ai2cm/ace/scripts/data_process/README.md

# Data processing for full model emulation training

This directory contains scripts for generating various datasets needed for FME training, including the FV3GFS primary, baseline, and stats datasets.

It also contains scripts for generating E3SM training data.

The first step in the process to create intermediate datasets (e.g. `make fv3gfs_AMIP_dataset`) uses argo, and can be run on your Google VM.
See the vcm-workflow-control repo for instructions on how to install and run argo.

The second step, which produces monthly netCDF files locally (e.g. `make fv3gfs_AMIP_monthly_netcdfs`), can be run on cirrascale in an interactive session.
To create an interactive session, run the following command from the `scripts/data_process` directory:

```
beaker session create --budget ai2/atec-climate --image beaker://jeremym/fme-2bc0033e --gpus 0 --mount hostPath:///net/nfs/climate=/net/nfs/climate --mount hostpath://$(pwd)=/full-model --workdir /full-model/scripts/data_process --shared-memory 120GiB
```

Doing so will require that your current working directory is a mountable path (e.g. something in /data).
If you'd like to write to a different directory than /net/nfs/climate, you can mount that path instead.

Once inside the image, you will need to authorize access to GCS by running `gcloud auth application-default login` and following the instructions, including to run `gcloud config set project vcm-ml` afterwards.

You can then produce the monthly netCDFs in a target directory by modifying the `OUTPUT_DIR` or `OUTPUT_DIR_AMIP` variable in the make command below.

```
make fv3gfs_AMIP_monthly_netcdfs RESOLUTION=4deg OUTPUT_DIR_AMIP=/data/shared/2023-12-20-vertically-resolved-4deg-fme-amip-ensemble-dataset
```

The stats dataset creation step (e.g. `make fv3gfs_AMIP_stats_beaker_dataset`) must be run in the fme conda environment (created by `make create_environment` at the top level of this repo), and additionally requires the beaker client is installed ([install instructions](https://beaker-docs.apps.allenai.org/start/install.html)).

For healpix data (both `healpix_ace` and `healpix_dlwp`), you will need to use the annad/dlwp-datapipe image.

You can either run the target with gantry or use the --bare flag, passing your own beaker secrets to the usual session command.

Update `configs/healpix-1deg-8layer-1940-2022.yaml` to point at the latest era5 data on gcs and the current date, i.e., variable_sources `2024-06-20-era5-1deg-8layer-1940-2022.zarr`; data_output_directory: `/climate-default/[DATE]-healpix-era5-dataset`.

If using gantry, be sure to run `make healpix_ace_dataset_gantry` before running `make healpix_dlwp_dataset_gantry`, or update the config to point at an existing hpx-ace dataset.

The output will be written to the `/climate-default` file directory on weka.

Example bare usage: `cd full-model/scripts/data_process && make healpix_ace_dataset`. You may also want to run in the background using nohup: `nohup make healpix_ace_dataset > compute_hpx.log 2>&1 &`.

Example bare session creation (use your own ssh secrets): `beaker session create --name annad/dlwp-ace-datapipe --image beaker://annad/dlwp-datapipe --remote --cluster ai2/phobos-cirrascale --bare --mount src=weka,ref=climate-default,dst=/climate-default  --mount src=weka,ref=climate-default,subpath=annad,dst=/root --workdir=/root --mount src=secret,ref=ssh-key,dst=/secret-files/.ssh/id_ed25519     --mount src=secret,ref=git-config,dst=/secret-files/.gitconfig --budget ai2/atec-climate --shared-memory 120GiB`

## Coupled datasets

The coupled targets (e.g. `make cm4_piControl_coupled_1daily`) run
`create_coupled_datasets.py` locally in the `create_coupled_datasets` conda
environment, created by `make create_coupled_datasets_env`.

The CM4 and CM4-like-AM4 random-CO2 configs also have an `_argo` sibling (e.g.
`make cm4_piControl_coupled_1daily_argo`) that submits the same config to argo
through `create_coupled_datasets.sh`, and can be run on your Google VM. Push the
image first with `make build_coupled_processing_image push_coupled_processing_image`.
The argo flavour is offered only where the config's input and output stores are
on GCS: `E3SMv3-piControl-100yr-coupled.yaml` writes to NERSC scratch, which the
workflow does not mount, so it is local-only.

The CM4 1pctCO2 coupled configs read their sea ice mask
(`precomputed_sea_ice_mask`) from the piControl coupled ocean store, so submit
each pair as one workflow: `make cm4_coupled_1daily_argo` (or `make
cm4_coupled_argo`) runs `create_coupled_datasets.sh --config <piControl>
--dependent-config <1pctCO2>`, and the workflow starts the 1pctCO2 run once the
piControl run has written its datasets. `--dependent-config` cannot be combined
with `--debug` or `--subsample`, which leave no piControl store for 1pctCO2 to
read. A mask read from a store that is not fully written fails the run.

When the config sets `stats.beaker_dataset`, the argo workflow's upload step,
`upload_coupled_stats.py`, uploads the merged stats to that Beaker dataset in
the `ai2/ace` workspace, one subdirectory per category
(`uncoupled_atmosphere`, `coupled_atmosphere`, `ocean`); an ensemble config
uploads its `combined` stats. The step is skipped for `--debug` and
`--subsample` runs, and when the dataset already exists under the account of
the workflow's Beaker token (the `beaker-key-andrep` secret). It runs on the
atmosphere processing image, which has `beaker-py`; override with
`-p upload_image=...`.
