ai2cm/ace/docs/api.rst

.. _API Reference:

=============
API Reference
=============

fme
===

.. automodule:: fme
   :members:

fme.ace
=======

.. automodule:: fme.ace
   :members:

fme.coupled
===========

.. automodule:: fme.coupled
   :members:
