ai2cm/ace/fme/core/distributed/parallel_tests/README.md

This directory contains tests which can be run in parallel, for example with torchrun.

They should also run in serial.
