ai2cm/ace/docs/evaluator_config.rst

.. _evaluator-config:

================
Evaluator Config
================

The following is an example configuration for running inference while evaluating against target data.
While you can use absolute paths in the config yamls (we encourage it!), the example uses paths relative to the directory you run the command.
The example assumes you are running in a directory structure like:

::

   .
   ├── ckpt.tar
   └── validation
       ├── data1.nc  # files can have any name, but must sort into time-sequential order
       ├── data2.nc  # can have any number of netCDF files
       └── ...

The ``.nc`` files correspond to data files like ``training_validation_data/training_validation/1940010100.nc`` in the `ACE2-ERA5 Hugging Face page`_, while ``ckpt.tar`` corresponds to a file like ``ace2_era5_ckpt.tar`` in that repository.

.. _ACE2-ERA5 Hugging Face page: https://huggingface.co/allenai/ACE2-ERA5

.. literalinclude:: evaluator-config.yaml
   :language: yaml
   :caption: Example YAML Configuration

.. testcode::
   :hide:

   from fme.ace import InferenceEvaluatorConfig
   import yaml
   import dacite

   with open('evaluator-config.yaml', 'r') as f:
      config_dict = yaml.safe_load(f)

   config = dacite.from_dict(
      InferenceEvaluatorConfig,
      data=config_dict,
      config=dacite.Config(strict=True)
   )
   # these paths are used in the documentation on this page
   # if they change then update the docs!
   assert config.checkpoint_path == "ckpt.tar"
   assert config.loader.dataset.data_path == "validation"
   print("Loaded successfully")

.. testoutput::
   :hide:

   Loaded successfully

We use the :ref:`Builder pattern <Builder Pattern>` to load this configuration into a multi-level dataclass structure.
The configuration is divided into several sub-configurations, each with its own dataclass.
The top-level configuration is the :class:`fme.ace.InferenceEvaluatorConfig` class.

.. autoclass:: fme.ace.InferenceEvaluatorConfig
   :show-inheritance:
   :noindex:

The sub-configurations are:

.. autoclass:: fme.ace.LoggingConfig
   :show-inheritance:
   :noindex:

.. autoclass:: fme.ace.InferenceDataLoaderConfig
   :show-inheritance:
   :noindex:

.. autoclass:: fme.ace.InferenceInitialConditionIndices
   :show-inheritance:
   :noindex:

.. autoclass:: fme.ace.ExplicitIndices
   :show-inheritance:
   :noindex:

.. autoclass:: fme.ace.TimestampList
   :show-inheritance:
   :noindex:

.. autoclass:: fme.ace.XarrayDataConfig
   :show-inheritance:
   :noindex:

.. autoclass:: fme.ace.DataWriterConfig
   :show-inheritance:
   :noindex:

.. autoclass:: fme.ace.InferenceEvaluatorAggregatorConfig
   :show-inheritance:
   :noindex:

Default aggregator configuration
^^^^^^^^^^^^^^^^^^^^^^^^^^^^^^^^

The default aggregator configuration (``InferenceEvaluatorAggregatorConfig``
with no arguments) produces the following YAML. You only need to include fields
you want to override.

.. literalinclude:: default-aggregator-config.yaml
   :language: yaml
   :caption: Default Aggregator Configuration

Metric configurations
^^^^^^^^^^^^^^^^^^^^^

The named fields on
:class:`~fme.ace.InferenceEvaluatorAggregatorConfig`
accept the following typed entries.  Each entry has an ``enabled`` field
that can be set to ``true`` or ``false`` to enable or disable a metric.
Most metrics default to ``enabled: true``; however, ``video``,
``histogram``, and ``seasonal`` default to ``enabled: false`` as shown
in the default aggregator configuration above.

.. autoclass:: fme.ace.MeanMetricConfig
   :noindex:

.. autoclass:: fme.ace.StepMeanMetricConfig
   :noindex:

.. autoclass:: fme.ace.PowerSpectrumMetricConfig
   :noindex:

.. autoclass:: fme.ace.ZonalMeanMetricConfig
   :noindex:

.. autoclass:: fme.ace.TimeMeanMetricConfig
   :noindex:

.. autoclass:: fme.ace.HistogramMetricConfig
   :noindex:

.. autoclass:: fme.ace.VideoMetricConfig
   :noindex:

.. autoclass:: fme.ace.SeasonalMetricConfig
   :noindex:

.. autoclass:: fme.ace.AnnualMetricConfig
   :noindex:

.. autoclass:: fme.ace.EnsoIndexMetricConfig
   :noindex:

.. autoclass:: fme.ace.EnsoCoefficientMetricConfig
   :noindex:

.. autoclass:: fme.ace.IpoIndexMetricConfig
   :noindex:

.. autoclass:: fme.ace.TrendMetricConfig
   :noindex:

.. autoclass:: fme.ace.EnsembleMetricConfig
   :noindex:

.. autoclass:: fme.ace.NearZeroFractionMetricConfig
   :noindex:

.. autoclass:: fme.ace.StepperOverrideConfig
   :show-inheritance:
   :noindex:
