ai2cm/ace/fme/core/hpx/testdata/test_plot_isht_result_1_0.png

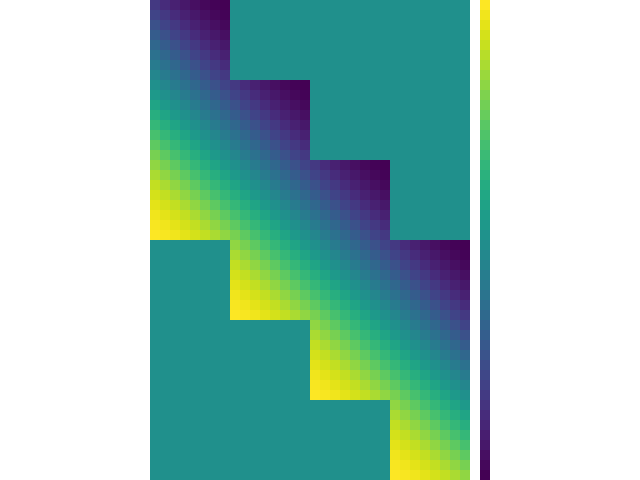
fme/core/hpx/testdata/test_plot_isht_result_1_0.png
