ai2cm/ace/(threads)

Thread 11 (2024-08-27):

Out of memory at inference time

Zappandy, 2024-08-27:
I've been trying to run ACE at inference time using a single NVIDIA Hopper H100 64GB HBM2 on an HPC, and we've even tried to run it on 4 H100s, but I keep getting PyTorch memory allocation errors. To further test this out, I dropped the number of forward steps to lower values (200, 100, 50, and even 2). Regardless of the amount, the code crashes before completing a single step. Note that we're using the initial condition from January 1st, 2021 (i.e. 2021010100.nc) and the model checkpoint provided on the Zenodo repository.

I double checked the computational complexity on the paper and saw you guys were running inference on a single A100, so I'm leaning on this being a data loading issue. We were able to isolate the problem to the ```SingleModuleStepperConfig``` class on the [stepper script](https://github.com/ai2cm/ace/blob/main/fme/fme/core/stepper.py) as the code seems to crash on line 378 (```self.module = dist.wrap_module(self.module)```).

This is the current output when we try to run inference
```
2024-08-27 10:24:46,356 - root - WARNING - Environmental variable BEAKER_EXPERIMENT_ID not found.
2024-08-27 10:24:46,358 - root - WARNING - Environmental variable SLURM_JOB_ID not found.
2024-08-27 10:24:46,358 - root - WARNING - Environmental variable SLURM_JOB_USER not found.
2024-08-27 10:24:46,358 - root - WARNING - Environmental variable FME_TRAIN_DIR not found.
2024-08-27 10:24:46,358 - root - WARNING - Environmental variable FME_VALID_DIR not found.
2024-08-27 10:24:46,358 - root - WARNING - Environmental variable FME_STATS_DIR not found.
2024-08-27 10:24:46,358 - root - WARNING - Environmental variable FME_CHECKPOINT_DIR not found.
2024-08-27 10:24:46,358 - root - WARNING - Environmental variable FME_OUTPUT_DIR not found.
2024-08-27 10:24:46,358 - root - WARNING - Environmental variable FME_IMAGE not found.
2024-08-27 10:24:46,358 - root - WARNING - Beaker Experiment ID not found.
2024-08-27 10:24:46,358 - root - INFO - --------------- Versions ---------------
2024-08-27 10:24:46,358 - root - INFO - Torch: 2.1.0a0+29c30b1
2024-08-27 10:24:46,358 - root - INFO - ----------------------------------------
2024-08-27 10:24:46,722 - root - INFO - Current device is cuda:0
2024-08-27 10:24:46,722 - root - INFO - Loading trained model checkpoint from /gpfs/projects/bsc32/bsc032010/ace-data/ace_ckpt.tar
2024-08-27 10:24:48,906 - root - INFO - Loading initial condition data
2024-08-27 10:24:50,460 - root - INFO - Initializing forcing data loaded
2024-08-27 10:24:50,479 - root - INFO - Opening data at /gpfs/projects/bsc32/bsc032010/ace-data/*.nc
2024-08-27 10:24:54,128 - root - INFO - Found 1060 samples.
2024-08-27 10:24:54,128 - root - INFO - Image shape is 180 x 360.
2024-08-27 10:24:54,128 - root - INFO - Following variables are available: ['DLWRFsfc', 'DSWRFsfc', 'DSWRFtoa', 'GRAUPELsfc', 'HGTsfc', 'ICEsfc', 'LHTFLsfc', 'PRATEsfc', 'PRESsfc', 'SHTFLsfc', 'SNOWsfc', 'ULWRFsfc', 'ULWRFtoa', 'USWRFsfc', 'USWRFtoa', 'air_temperature_0', 'air_temperature_1', 'air_temperature_2', 'air_temperature_3', 'air_temperature_4', 'air_temperature_5', 'air_temperature_6', 'air_temperature_7', 'ak_0', 'ak_1', 'ak_2', 'ak_3', 'ak_4', 'ak_5', 'ak_6', 'ak_7', 'ak_8', 'bk_0', 'bk_1', 'bk_2', 'bk_3', 'bk_4', 'bk_5', 'bk_6', 'bk_7', 'bk_8', 'eastward_wind_0', 'eastward_wind_1', 'eastward_wind_2', 'eastward_wind_3', 'eastward_wind_4', 'eastward_wind_5', 'eastward_wind_6', 'eastward_wind_7', 'grid_xt', 'grid_yt', 'land_fraction', 'northward_wind_0', 'northward_wind_1', 'northward_wind_2', 'northward_wind_3', 'northward_wind_4', 'northward_wind_5', 'northward_wind_6', 'northward_wind_7', 'ocean_fraction', 'sea_ice_fraction', 'soil_moisture', 'specific_total_water_0', 'specific_total_water_1', 'specific_total_water_2', 'specific_total_water_3', 'specific_total_water_4', 'specific_total_water_5', 'specific_total_water_6', 'specific_total_water_7', 'surface_temperature', 'tendency_of_total_water_path', 'tendency_of_total_water_path_due_to_advection', 'time', 'total_water_path'].
2024-08-27 10:24:54,378 - root - INFO - Opening data at /gpfs/projects/bsc32/bsc032010/ace-data/*.nc
2024-08-27 10:24:56,013 - root - INFO - Found 1060 samples.
2024-08-27 10:24:56,014 - root - INFO - Image shape is 180 x 360.
2024-08-27 10:24:56,014 - root - INFO - Following variables are available: ['DLWRFsfc', 'DSWRFsfc', 'DSWRFtoa', 'GRAUPELsfc', 'HGTsfc', 'ICEsfc', 'LHTFLsfc', 'PRATEsfc', 'PRESsfc', 'SHTFLsfc', 'SNOWsfc', 'ULWRFsfc', 'ULWRFtoa', 'USWRFsfc', 'USWRFtoa', 'air_temperature_0', 'air_temperature_1', 'air_temperature_2', 'air_temperature_3', 'air_temperature_4', 'air_temperature_5', 'air_temperature_6', 'air_temperature_7', 'ak_0', 'ak_1', 'ak_2', 'ak_3', 'ak_4', 'ak_5', 'ak_6', 'ak_7', 'ak_8', 'bk_0', 'bk_1', 'bk_2', 'bk_3', 'bk_4', 'bk_5', 'bk_6', 'bk_7', 'bk_8', 'eastward_wind_0', 'eastward_wind_1', 'eastward_wind_2', 'eastward_wind_3', 'eastward_wind_4', 'eastward_wind_5', 'eastward_wind_6', 'eastward_wind_7', 'grid_xt', 'grid_yt', 'land_fraction', 'northward_wind_0', 'northward_wind_1', 'northward_wind_2', 'northward_wind_3', 'northward_wind_4', 'northward_wind_5', 'northward_wind_6', 'northward_wind_7', 'ocean_fraction', 'sea_ice_fraction', 'soil_moisture', 'specific_total_water_0', 'specific_total_water_1', 'specific_total_water_2', 'specific_total_water_3', 'specific_total_water_4', 'specific_total_water_5', 'specific_total_water_6', 'specific_total_water_7', 'surface_temperature', 'tendency_of_total_water_path', 'tendency_of_total_water_path_due_to_advection', 'time', 'total_water_path'].
2024-08-27 10:24:56,080 - root - INFO - Multiprocessing inference context: fork
2024-08-27 10:24:56,080 - root - INFO - Loading trained model checkpoint from /gpfs/projects/bsc32/bsc032010/ace-data/ace_ckpt.tar
2024-08-27 10:24:58,698 - root - INFO - Starting inference
2024-08-27 10:25:37,291 - root - INFO - Inference: starting window spanning 0 to 50 steps.
Traceback (most recent call last):
  File "/usr/lib/python3.10/runpy.py", line 196, in _run_module_as_main
    return _run_code(code, main_globals, None,
  File "/usr/lib/python3.10/runpy.py", line 86, in _run_code
    exec(code, run_globals)
  File "/full-model/fme/fme/ace/inference/__main__.py", line 8, in <module>
    main(yaml_config=args.yaml_config)
  File "/full-model/fme/fme/ace/inference/inference.py", line 221, in main
    run_inference_from_config(config)
  File "/full-model/fme/fme/ace/inference/inference.py", line 275, in run_inference_from_config
    timers = run_inference(
  File "/full-model/fme/fme/ace/inference/loop.py", line 197, in run_inference
    prediction = stepper.predict(
  File "/full-model/fme/fme/core/stepper.py", line 508, in predict
    state = self.step(input_data, next_step_ocean_data)
  File "/full-model/fme/fme/core/stepper.py", line 460, in step
    output_tensor = self.module(input_tensor)
  File "/usr/local/lib/python3.10/dist-packages/torch/nn/modules/module.py", line 1505, in _wrapped_call_impl
    return self._call_impl(*args, **kwargs)
  File "/usr/local/lib/python3.10/dist-packages/torch/nn/modules/module.py", line 1514, in _call_impl
    return forward_call(*args, **kwargs)
  File "/full-model/fme/fme/core/distributed.py", line 26, in forward
    return self.module(*args, **kwargs)
  File "/usr/local/lib/python3.10/dist-packages/torch/nn/modules/module.py", line 1505, in _wrapped_call_impl
    return self._call_impl(*args, **kwargs)
  File "/usr/local/lib/python3.10/dist-packages/torch/nn/modules/module.py", line 1514, in _call_impl
    return forward_call(*args, **kwargs)
  File "/full-model/fme/fme/ace/models/modulus/sfnonet.py", line 708, in forward
    x = self._forward_features(x)
  File "/full-model/fme/fme/ace/models/modulus/sfnonet.py", line 678, in _forward_features
    x = blk(x)
  File "/usr/local/lib/python3.10/dist-packages/torch/nn/modules/module.py", line 1505, in _wrapped_call_impl
    return self._call_impl(*args, **kwargs)
  File "/usr/local/lib/python3.10/dist-packages/torch/nn/modules/module.py", line 1514, in _call_impl
    return forward_call(*args, **kwargs)
  File "/full-model/fme/fme/ace/models/modulus/sfnonet.py", line 222, in forward
    x, residual = self.filter(x_norm)
  File "/usr/local/lib/python3.10/dist-packages/torch/nn/modules/module.py", line 1505, in _wrapped_call_impl
    return self._call_impl(*args, **kwargs)
  File "/usr/local/lib/python3.10/dist-packages/torch/nn/modules/module.py", line 1514, in _call_impl
    return forward_call(*args, **kwargs)
  File "/full-model/fme/fme/ace/models/modulus/sfnonet.py", line 120, in forward
    return self.filter(x)
  File "/usr/local/lib/python3.10/dist-packages/torch/nn/modules/module.py", line 1505, in _wrapped_call_impl
    return self._call_impl(*args, **kwargs)
  File "/usr/local/lib/python3.10/dist-packages/torch/nn/modules/module.py", line 1514, in _call_impl
    return forward_call(*args, **kwargs)
  File "/full-model/fme/fme/ace/models/modulus/s2convolutions.py", line 178, in forward
    xp[..., : self.modes_lat_local, : self.modes_lon_local] = self._contract(
  File "/full-model/fme/fme/ace/models/modulus/factorizations.py", line 211, in _contract_dense_pytorch
    x = _contract_dhconv(x, weight)
RuntimeError: The following operation failed in the TorchScript interpreter.
Traceback of TorchScript (most recent call last):
  File "/full-model/fme/fme/ace/models/modulus/contractions.py", line 193, in _contract_dhconv
    ac = torch.view_as_complex(a)
    bc = torch.view_as_complex(b)
    resc = torch.einsum("bixy,iox->boxy", ac, bc)
           ~~~~~~~~~~~~ <--- HERE
    res = torch.view_as_real(resc)
    return res
RuntimeError: CUDA out of memory. Tried to allocate 7.71 GiB. GPU 0 has a total capacty of 63.43 GiB of which 2.30 GiB is free. Including non-PyTorch memory, this process has 61.12 GiB memory in use. Of the allocated memory 51.79 GiB is allocated by PyTorch, and 8.59 GiB is reserved by PyTorch but unallocated. If reserved but unallocated memory is large try setting max_split_size_mb to avoid fragmentation.  See documentation for Memory Management and PYTORCH_CUDA_ALLOC_CONF
```

oliverwm1, 2024-08-27:
Thanks for reporting. Indeed you should easily be able to do inference with a single H100. Could you provide an example of the exact config you are using?

I suspect this may be happening since by default all available time steps in the provided initial condition file are used. Try adding
```
initial_condition:
  path: ...
  start_indices:
    list:
      - 0
```
to your config. More options for specifying which time steps to use for the initial condition can be found here: https://ai2-climate-emulator.readthedocs.io/en/latest/api.html#fme.ace.InitialConditionConfig

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
Zappandy, 2024-08-28:
```
n_forward_steps: 400  # 100 days
forward_steps_in_memory: 50
checkpoint_path: /gpfs/projects/bsc32/bsc032010/ace-data/ace_ckpt.tar
logging:
  log_to_screen: true
  log_to_wandb: false
  log_to_file: true
  project: ace_test
  entity: ml-bsc
initial_condition:
  path: /gpfs/projects/bsc32/bsc032010/ace-data/2021010100.nc
forcing_loader:
  dataset:
    data_path: /gpfs/projects/bsc32/bsc032010/ace-data/
  num_data_workers: 8
data_writer:
  save_prediction_files: false
  save_monthly_files: false
```
Thank you, yeah, I was missing the start index, sorry about that. We added it and the model ran under 32 seconds!

oliverwm1, 2024-08-28:
Great, glad that worked.

Closed 2024-08-28.

Thread 15 (2024-09-10):

Installing `fme` from GH url not successful

brianhenn, 2024-09-10:
This repo's docs recommend installing `fme` via pip from this repo's GH url.

```pip install git+https://github.com/ai2cm/ace#subdirectory=fme```

However this results in failure to import `fme`:

```
(ace) brianh@brian-vm:~/dev$ python -c "import fme"
Traceback (most recent call last):
  File "<string>", line 1, in <module>
  File "/home/brianh/miniconda3/envs/my_env/lib/python3.10/site-packages/fme/__init__.py", line 5, in <module>
    from . import ace
  File "/home/brianh/miniconda3/envs/my_env/lib/python3.10/site-packages/fme/ace/__init__.py", line 3, in <module>
    from fme.ace.inference.data_writer.time_coarsen import TimeCoarsenConfig
  File "/home/brianh/miniconda3/envs/my_env/lib/python3.10/site-packages/fme/ace/inference/__init__.py", line 1, in <module>
    from .loop import run_inference_evaluator
  File "/home/brianh/miniconda3/envs/my_env/lib/python3.10/site-packages/fme/ace/inference/loop.py", line 9, in <module>
    from fme.core import SingleModuleStepper
  File "/home/brianh/miniconda3/envs/my_env/lib/python3.10/site-packages/fme/core/__init__.py", line 1, in <module>
    from .climate_data import ClimateData
  File "/home/brianh/miniconda3/envs/my_env/lib/python3.10/site-packages/fme/core/climate_data.py", line 15, in <module>
    from fme.core.data_loading.data_typing import SigmaCoordinates
ModuleNotFoundError: No module named 'fme.core.data_loading'

oliverwm1, 2024-09-10:
FYI current workaround is to clone repository and install from sources (e.g. call `make create_environment`).

oliverwm1, 2024-09-19:
This might be because of a missing `__init__.py` in `fme.core.data_loading`.

Closed 2024-09-30.

Thread 22 (2024-11-07):

`fme` missing attribute 'get_device' on clean install

ngordillo, 2024-11-07:
Doing a clean install of ACE and creating the environment, the fme module is missing elements needed to run. I've tested this out on two different machines get the same error message.
```
Traceback (most recent call last):
  File "/home/nicojg/mambaforge/envs/fme/lib/python3.10/runpy.py", line 196, in _run_module_as_main
    return _run_code(code, main_globals, None,
  File "/home/nicojg/mambaforge/envs/fme/lib/python3.10/runpy.py", line 86, in _run_code
    exec(code, run_globals)
  File "/home/nicojg/ace/fme/fme/ace/inference/__main__.py", line 8, in <module>
    main(yaml_config=args.yaml_config)
  File "/home/nicojg/ace/fme/fme/ace/inference/inference.py", line 221, in main
    run_inference_from_config(config)
  File "/home/nicojg/ace/fme/fme/ace/inference/inference.py", line 235, in run_inference_from_config
    logging.info(f"Current device is {fme.get_device()}")
AttributeError: module 'fme' has no attribute 'get_device'
```
I managed to work around this by uninstalling fme after running `make create_environment` and then reinstalling to the latest version.

oliverwm1, 2024-11-11:
Thanks for reporting. I am not able to reproduce this so far.

Do you also have the issue if installing directly from PyPI?

oliverwm1, 2024-11-22:
I was able to reproduce this. It happens specifically when in the root directory of this repo (e.g. call `python -c "import fme; fme.get_device()"` from root dir of the repo). But does not happen when running the command elsewhere.

ngordillo, 2024-12-02:
I did a clean install of ACE on a system that didn't have mamba installed and it worked following the quick start guide on the first attempt. So I am inclined to believe that this is an issue with mamba.

frodre, 2025-01-10:
Turns out this is related to our usage of a development install `-e` and there being an `fme` folder in the top level that's not the actual package source folder `fme/fme`.  Python path includes the local directory by default in `sys.path` and searches there first, so it finds the top-level `fme` assumes it's the package but then finds no submodules.

```
Python 3.10.16 (main, Dec 11 2024, 16:24:50) [GCC 11.2.0] on linux
Type "help", "copyright", "credits" or "license" for more information.
>>> import fme
>>> fme.get_device()
Traceback (most recent call last):
  File "<stdin>", line 1, in <module>
AttributeError: module 'fme' has no attribute 'get_device'
>>>
```

If I remove the current working directory from `sys.path`, the error goes away.

```
Python 3.10.16 (main, Dec 11 2024, 16:24:50) [GCC 11.2.0] on linux
Type "help", "copyright", "credits" or "license" for more information.
>>> import sys
>>> sys.path
['', '/home/andrep/miniconda3/envs/fme/lib/python310.zip', '/home/andrep/miniconda3/envs/fme/lib/python3.10', '/home/andrep/miniconda3/envs/fme/lib/python3.10/lib-dynload', '/home/andrep/miniconda3/envs/fme/lib/python3.10/site-packages', '__editable__.fme-2024.12.0.finder.__path_hook__']
>>> del sys.path[0]
>>> import fme
>>> fme.get_device()
device(type='cpu')
>>>
```

We'll just have to update the folder naming convention so this won't bite others looking to do local dev work in this repo.

oliverwm1, 2025-01-10:
@elynnwu found a nice workaround for now. Add `-I` to the python invocation, and things should work.

i.e. in the root dir of the repo, `python -c "import fme; fme.get_device()"` fails but `python -I -c "import fme; fme.get_device()"` works.

oliverwm1, 2025-09-02:
This was resolved by #31 in which we removed one "fme" layer in the directory structure of this repo. i.e. now the `fme` python package lives at the root of the repo instead of within a `fme` directory.

Closed 2025-09-02.

Thread 39 (2025-09-16):

Stepper errors when loading checkpoint

cnagda, 2025-09-16:
Hi,

I'm trying to use the ACE-climSST checkpoint on hugging face (also tried the one on Zenodo), but am encountering this error:
```
Traceback (most recent call last):
  File "<frozen runpy>", line 198, in _run_module_as_main
  File "<frozen runpy>", line 88, in _run_code
  File "/u/cnagda2/.conda/envs/ace/lib/python3.11/site-packages/fme/ace/inference/__main__.py", line 15, in <module>
    main(args.yaml_config, segments=args.segments, override_dotlist=args.override)
  File "/u/cnagda2/.conda/envs/ace/lib/python3.11/site-packages/fme/ace/inference/inference.py", line 239, in main
    return run_inference_from_config(config)
           ^^^^^^^^^^^^^^^^^^^^^^^^^^^^^^^^^
  File "/u/cnagda2/.conda/envs/ace/lib/python3.11/site-packages/fme/ace/inference/inference.py", line 263, in run_inference_from_config
    stepper_config = config.load_stepper_config()
                     ^^^^^^^^^^^^^^^^^^^^^^^^^^^^
  File "/u/cnagda2/.conda/envs/ace/lib/python3.11/site-packages/fme/ace/inference/inference.py", line 204, in load_stepper_config
    return load_stepper_config(self.checkpoint_path, self.stepper_override)
           ^^^^^^^^^^^^^^^^^^^^^^^^^^^^^^^^^^^^^^^^^^^^^^^^^^^^^^^^^^^^^^^^
  File "/u/cnagda2/.conda/envs/ace/lib/python3.11/site-packages/fme/ace/stepper/single_module.py", line 1595, in load_stepper_config
    stepper = load_stepper(checkpoint_path, override_config)
              ^^^^^^^^^^^^^^^^^^^^^^^^^^^^^^^^^^^^^^^^^^^^^^
  File "/u/cnagda2/.conda/envs/ace/lib/python3.11/site-packages/fme/ace/stepper/single_module.py", line 1619, in load_stepper
    stepper = Stepper.from_state(checkpoint["stepper"])
              ^^^^^^^^^^^^^^^^^^^^^^^^^^^^^^^^^^^^^^^^^
  File "/u/cnagda2/.conda/envs/ace/lib/python3.11/site-packages/fme/ace/stepper/single_module.py", line 1514, in from_state
    loss_normalizer = StandardNormalizer.from_state(
                      ^^^^^^^^^^^^^^^^^^^^^^^^^^^^^^
  File "/u/cnagda2/.conda/envs/ace/lib/python3.11/site-packages/fme/ace/normalizer.py", line 168, in from_state
    k: torch.tensor(v, dtype=torch.float) for k, v in state["means"].items()
        ~~~~~^^^^^^^^^
TypeError: 'NoneType' object is not subscriptable
Return code: 1
```

This is my inference config
```
experiment_dir: inference_output
n_forward_steps: 24
forward_steps_in_memory: 24
checkpoint_path: ace_ckpt.tar
logging:
  log_to_screen: true
  log_to_wandb: false
  log_to_file: true
  project: ace
initial_condition:
  path: climSST/ic_2021.zarr
  engine: zarr
  start_indices:
    n_initial_conditions: 1
    first: 0
    interval: 1
forcing_loader:
  dataset:
    data_path: climSST
    file_pattern: forcing_2021.zarr
    engine: zarr
    n_repeats: 1
  num_data_workers: 0
data_writer:
  save_prediction_files: true
  save_monthly_files: false
```

I used `pip install fme` to install

oliverwm1, 2025-09-17:
Thanks for report @cnagda. You can resolve this by pinning the fme version to before the last release, i.e. `pip install fme<2025.7.0`. Another option is to use a more recent model (e.g. [ACE2-ERA5](https://huggingface.co/allenai/ACE2-ERA5)) which will work with the latest release. We'll also look into restoring compatibility with old checkpoints.

Thread 40 (2025-09-26):

_pickle.UnpicklingError: invalid load key, 'v'.

patricia-ternes, 2025-09-26:
I am trying to run the latest release `fme=2025.7.0` with the model [`ACE2-ERA5`](https://huggingface.co/allenai/ACE2-ERA5), using the command:

```
$ python -m fme.ace.inference inference_config.yaml
```

And I am getting the error

```bash
Traceback (most recent call last):
  File "<frozen runpy>", line 198, in _run_module_as_main
  File "<frozen runpy>", line 88, in _run_code
  File "~/ace/fme/ace/inference/__main__.py", line 15, in <module>
    main(args.yaml_config, segments=args.segments, override_dotlist=args.override)
  File "~/ace/fme/ace/inference/inference.py", line 239, in main
    return run_inference_from_config(config)
           ^^^^^^^^^^^^^^^^^^^^^^^^^^^^^^^^^
  File "~/ace/fme/ace/inference/inference.py", line 263, in run_inference_from_config
    stepper_config = config.load_stepper_config()
                     ^^^^^^^^^^^^^^^^^^^^^^^^^^^^
  File "~/ace/fme/ace/inference/inference.py", line 204, in load_stepper_config
    return load_stepper_config(self.checkpoint_path, self.stepper_override)
           ^^^^^^^^^^^^^^^^^^^^^^^^^^^^^^^^^^^^^^^^^^^^^^^^^^^^^^^^^^^^^^^^
  File "~/ace/fme/ace/stepper/single_module.py", line 1595, in load_stepper_config
    stepper = load_stepper(checkpoint_path, override_config)
              ^^^^^^^^^^^^^^^^^^^^^^^^^^^^^^^^^^^^^^^^^^^^^^
  File "~/ace/fme/ace/stepper/single_module.py", line 1616, in load_stepper
    checkpoint = torch.load(
                 ^^^^^^^^^^^
  File "~/.conda/envs/fme/lib/python3.11/site-packages/torch/serialization.py", line 1549, in load
    return _legacy_load(
           ^^^^^^^^^^^^^
  File "~/.conda/envs/fme/lib/python3.11/site-packages/torch/serialization.py", line 1797, in _legacy_load
    magic_number = pickle_module.load(f, **pickle_load_args)
                   ^^^^^^^^^^^^^^^^^^^^^^^^^^^^^^^^^^^^^^^^^
_pickle.UnpicklingError: invalid load key, 'v'.
```

My initial configuration is the one suggested in the `ACE2-ERA5` model. The only change in the file was related to paths. So, `inference_config.yaml ` is:

```
experiment_dir: ~/ACE2-ERA5/output_directory
n_forward_steps: 400
forward_steps_in_memory: 50
checkpoint_path: ~/ACE2-ERA5/ace2_era5_ckpt.tar
logging:
  log_to_screen: true
  log_to_wandb: false
  log_to_file: true
  project: ace
initial_condition:
  path: ~/ACE2-ERA5/initial_conditions/ic_2020.nc
  start_indices:
    times:
      - "2020-01-01T00:00:00"
forcing_loader:
  dataset:
    data_path: ~/ACE2-ERA5/forcing_data
  num_data_workers: 4
data_writer:
  save_prediction_files: true
  save_monthly_files: false
  names: ["TMP2m", "VGRD10m", "PRATEsfc"]
```

I validated the config file using

```
$ python -m fme.ace.validate_config inference_config.yaml  --config_type inference
$
```

With no output.

I already tried different routes, including:

- Install fme using pip
- Install fme using conda
- Run on different machines (WSL2 and Linux)
- Using the CPU environment and using the GPU environment
- Using the local environment and the Slurm-based environment

All attempts led to the same error above.
Considering my last attempt, when I installed fme using the conda instructions, here is a summary of the environment (I am adding only the main packages):

```
cartopy                   0.25.0                   pypi_0    pypi
dacite                    1.9.2                    pypi_0    pypi
fme                       2025.7.0                 pypi_0    pypi
gcsfs                     2025.9.0                 pypi_0    pypi
h5netcdf                  1.6.4                    pypi_0    pypi
h5py                      3.14.0                   pypi_0    pypi
imageio                   2.27.0                   pypi_0    pypi
matplotlib                3.10.6                   pypi_0    pypi
moviepy                   2.2.1                    pypi_0    pypi
netcdf4                   1.7.2                    pypi_0    pypi
numpy                     2.3.3                    pypi_0    pypi
pandas                    2.3.2                    pypi_0    pypi
pip                       25.2               pyh8b19718_0    conda-forge
plotly                    6.3.0                    pypi_0    pypi
python                    3.11.13         h9e4cc4f_0_cpython    conda-forge
s3fs                      2025.9.0                 pypi_0    pypi
scipy                     1.16.2                   pypi_0    pypi
tensorly                  0.9.0                    pypi_0    pypi
tensorly-torch            0.5.0                    pypi_0    pypi
torch                     2.7.1                    pypi_0    pypi
wandb                     0.19.11                  pypi_0    pypi
xarray                    2025.9.0                 pypi_0    pypi
zarr                      3.1.3                    pypi_0    pypi
```

Is it an environment issue, or am I missing some configuration step?
I appreciate the help.
