ai2cm/ace/fme/coupled/stepper.py

import contextlib
import dataclasses
import datetime
import logging
import pathlib
import warnings
from collections.abc import Generator, Iterable, Sequence
from typing import Any, Literal

import dacite
import numpy as np
import pandas as pd
import torch
from torch import nn

import fme
from fme.ace.data_loading.batch_data import BatchData, PrognosticState
from fme.ace.requirements import DataRequirements
from fme.ace.stepper import (
    Stepper,
    TrainOutput,
    process_prediction_generator_list,
    stack_list_of_tensor_dicts,
)
from fme.ace.stepper.parameter_init import (
    ParameterInitializationConfig,
    ParameterInitializer,
    StepperWeightsAndHistory,
    Weights,
    WeightsAndHistoryLoader,
)
from fme.ace.stepper.single_module import (
    StepperConfig,
    process_ensemble_prediction_generator_list,
)
from fme.ace.stepper.single_module import (
    load_weights_and_history as load_uncoupled_weights_and_history,
)
from fme.ace.stepper.time_length_probabilities import TimeLengthProbabilities
from fme.core.corrector.output import CorrectorDiagnostics
from fme.core.dataset_info import DatasetInfo
from fme.core.distributed import Distributed
from fme.core.ema import load_ema_params_if_available
from fme.core.generics.inference import PredictFunction
from fme.core.generics.optimization import OptimizationABC
from fme.core.generics.train_stepper import TrainOutputABC, TrainStepperABC
from fme.core.loss import StepLoss, StepLossConfig
from fme.core.ocean import OceanConfig
from fme.core.ocean_data import OCEAN_FIELD_NAME_PREFIXES, OceanData
from fme.core.optimization import NullOptimization
from fme.core.step.output import StepOutput
from fme.core.stepper_state import StepperState
from fme.core.tensors import add_ensemble_dim, unfold_ensemble_dim
from fme.core.timing import GlobalTimer
from fme.core.training_history import TrainingHistory, TrainingJob
from fme.core.typing_ import EnsembleTensorDict, TensorDict, TensorMapping
from fme.coupled.data_loading.batch_data import (
    CoupledBatchData,
    CoupledPairedData,
    CoupledPrognosticState,
)
from fme.coupled.dataset_info import CoupledDatasetInfo
from fme.coupled.loss import ComponentLossSchedule, JointPair
from fme.coupled.requirements import (
    CoupledDataRequirements,
    CoupledPrognosticStateDataRequirements,
    CoupledTrainDataRequirements,
)
from fme.coupled.typing_ import CoupledNames, CoupledOptionalInt


@dataclasses.dataclass
class ComponentConfig:
    """
    Configuration for one of the components (ocean or atmosphere) within a
    CoupledStepper.

    Parameters:
        timedelta: An ISO 8601 Duration string specifying the size of this component's
            stepper step.
        stepper: The single module stepper configuration for this component.
    """

    timedelta: str
    stepper: StepperConfig


@dataclasses.dataclass
class CoupledOceanFractionConfig:
    """
    Configuration for computing ocean fraction from the ocean-predicted sea ice
    fraction.

    The configured land fraction name is used to read the atmosphere forcing,
    then passed to OceanData as its canonical land_fraction field. The configured
    sea ice fraction name must be registered in OCEAN_FIELD_NAME_PREFIXES as
    either sea_ice_fraction or ocean_sea_ice_fraction.

    Parameters:
        sea_ice_fraction_name: Name of the sea ice fraction field in the ocean
            data. Must be an ocean prognostic variable and must be registered in
            OCEAN_FIELD_NAME_PREFIXES as either sea_ice_fraction or
            ocean_sea_ice_fraction. If the atmosphere uses the same name as an
            ML forcing then the generated sea ice fraction is also passed as an
            input to the atmosphere.
        land_fraction_name: Name of the land fraction field in the atmosphere
            data. If needed, will be passed to the ocean stepper as a forcing.
        sea_ice_fraction_name_in_atmosphere: Name of the sea ice fraction field in
            the atmosphere data, if required and different from sea_ice_fraction_name.

    """

    sea_ice_fraction_name: str
    land_fraction_name: str
    sea_ice_fraction_name_in_atmosphere: str | None = None

    def __post_init__(self):
        self._get_canonical_sea_ice_fraction_name()

    def _get_canonical_sea_ice_fraction_name(self) -> str:
        sea_ice_frac_name = self.sea_ice_fraction_name
        if sea_ice_frac_name in OCEAN_FIELD_NAME_PREFIXES["sea_ice_fraction"]:
            return "sea_ice_fraction"
        elif sea_ice_frac_name in OCEAN_FIELD_NAME_PREFIXES["ocean_sea_ice_fraction"]:
            return "ocean_sea_ice_fraction"
        else:
            raise ValueError(
                f"CoupledOceanFractionConfig expected {sea_ice_frac_name} to be "
                "registered in OCEAN_FIELD_NAME_PREFIXES as a sea ice fraction."
            )

    def validate_ocean_prognostic_names(self, prognostic_names: Iterable[str]):
        if self.sea_ice_fraction_name not in prognostic_names:
            raise ValueError(
                f"CoupledOceanFractionConfig expected {self.sea_ice_fraction_name} "
                "to be a prognostic variable of the ocean model, but it is not."
            )

    def validate_atmosphere_forcing_names(self, forcing_names: Iterable[str]):
        if self.land_fraction_name not in forcing_names:
            raise ValueError(
                f"CoupledOceanFractionConfig expected {self.land_fraction_name} "
                "to be an ML forcing of the atmosphere model, but it is not."
            )

    def filter_atmosphere_forcing_names(
        self,
        unfiltered_names: Iterable[str],
        ocean_fraction_name: str,
    ) -> list[str]:
        """Remove ocean fraction and sea ice fraction from atmosphere forcing names.

        When ocean fraction is predicted from ocean model outputs, these
        variables should not be loaded from atmosphere data since they will be
        computed at runtime.

        Args:
            unfiltered_names: The full list of atmosphere forcing names to filter.
            ocean_fraction_name: Name of the ocean fraction field in atmosphere data.

        Returns:
            Filtered list of atmosphere forcing names.

        """
        filtered = [name for name in unfiltered_names if name != ocean_fraction_name]

        sea_ice_fraction_name = (
            self.sea_ice_fraction_name_in_atmosphere or self.sea_ice_fraction_name
        )
        filtered = [name for name in filtered if name != sea_ice_fraction_name]

        return filtered

    def build_ocean_data(
        self, forcings_from_ocean: TensorMapping, atmos_forcing_data: TensorMapping
    ) -> OceanData:
        # compute ocean frac from land frac and ocean-predicted sea ice frac
        land_frac_name = self.land_fraction_name
        sea_ice_frac_name = self.sea_ice_fraction_name
        # fill nans with 0s
        sea_ice_frac = torch.nan_to_num(forcings_from_ocean[sea_ice_frac_name])
        land_frac = atmos_forcing_data[land_frac_name]
        return OceanData(
            {
                "land_fraction": land_frac,
                self._get_canonical_sea_ice_fraction_name(): sea_ice_frac,
            }
        )


def _load_stepper_weights_and_history_factory(
    stepper: Stepper,
) -> WeightsAndHistoryLoader:
    def load_stepper_weights_and_history(*_) -> StepperWeightsAndHistory:
        return_weights: Weights = []
        for module in stepper.modules:
            return_weights.append(module.state_dict())
        return return_weights, stepper.training_history

    return load_stepper_weights_and_history


@dataclasses.dataclass
class CoupledParameterInitConfig:
    """
    Enables component parameter initialization via a coupled stepper checkpoint.

    The default behavior when checkpoint_path is None is to rely on the
    component steppers' parameter initialization config to load uncoupled
    component checkpoints, if provided. When checkpoint_path is non-None, the
    component steppers' ParameterInitializationConfig.weights_path must be None.

    Parameters:
        checkpoint_path: Path to a coupled stepper checkpoint.
    """

    checkpoint_path: str | None = None

    def build_weights_and_history_loaders(self) -> "CoupledWeightsAndHistoryLoaders":
        if self.checkpoint_path is None:
            return CoupledWeightsAndHistoryLoaders(
                ocean=load_uncoupled_weights_and_history,
                atmosphere=load_uncoupled_weights_and_history,
            )
        coupled_stepper = load_coupled_stepper(self.checkpoint_path)
        return CoupledWeightsAndHistoryLoaders(
            ocean=_load_stepper_weights_and_history_factory(coupled_stepper.ocean),
            atmosphere=_load_stepper_weights_and_history_factory(
                coupled_stepper.atmosphere
            ),
        )


@dataclasses.dataclass
class CoupledWeightsAndHistoryLoaders:
    ocean: WeightsAndHistoryLoader
    atmosphere: WeightsAndHistoryLoader
    training_history: TrainingHistory | None = None


@dataclasses.dataclass
class CoupledStepperConfig:
    """
    Configuration for a coupled atmosphere-ocean stepper. From a common initial
    condition time the atmosphere steps first and takes as many steps as fit in
    a single ocean step, while being forced by the ocean's initial condition
    SST. The ocean then steps forward once, receiving required forcings from the
    atmosphere-generated output as averages over its step window. This completes
    a single "coupled step". For subsequent coupled steps, the generated SST
    from the ocean forces the atmosphere's steps.

    For example, with an atmosphere:ocean step size ratio of 2:1, the following
    sequence results in 2 coupled steps (4 atmosphere steps and 2 ocean steps):

    1. IC -> atmos_step_1 -> atmos_step_2
    2. (IC, atmos_step_1_and_2_avg) -> ocean_step_1
    3. (atmos_step_2, ocean_step_1) -> atmos_step_3 -> atmos_step_4
    4. (ocean_step_1, atmos_step_3_and_4_avg) -> ocean_step_2

    Parameters:
        ocean: The ocean component configuration. Output variable names must be distinct
            from the atmosphere's output names. Outputs that are input names in the
            atmosphere must be prognostic variables in the ocean.
        atmosphere: The atmosphere component configuration. The stepper
            configuration must include OceanConfig so that ocean-generated SSTs
            can be written on the atmosphere's surface temperature field. Output
            variable names must be distinct from the ocean's output names.
        sst_name: Name of the liquid sea surface temperature field in the ocean data.
            Must be present in the ocean's output names.
        ocean_fraction_prediction: (Optional) Configuration for ocean-generated
            ocean fraction to replace the ocean fraction variable specified in the
            atmosphere's OceanConfig. If the atmosphere uses the ocean fraction as
            an ML forcing, the generated ocean fraction is also passed as an input.

    """

    ocean: ComponentConfig
    atmosphere: ComponentConfig
    sst_name: str = "sst"
    ocean_fraction_prediction: CoupledOceanFractionConfig | None = None

    def __post_init__(self):
        self._validate_component_configs()

        atmosphere_ocean_config = self.atmosphere.stepper.get_ocean()
        if atmosphere_ocean_config is None:
            raise RuntimeError(
                "atmosphere ocean config is None after validation; "
                "this should not happen"
            )
        self._atmosphere_ocean_config = atmosphere_ocean_config

        # set timesteps
        self._ocean_timestep = pd.Timedelta(self.ocean.timedelta).to_pytimedelta()
        self._atmosphere_timestep = pd.Timedelta(
            self.atmosphere.timedelta
        ).to_pytimedelta()

        # calculate forcing sets
        self._ocean_forcing_exogenous_names = list(
            self.ocean.stepper.input_only_names.difference(
                self.atmosphere.stepper.output_names
            )
        )
        unfiltered_atmosphere_forcing_names = list(
            self.atmosphere.stepper.input_only_names.difference(
                self.ocean.stepper.output_names
            )
        )
        if self.ocean_fraction_prediction is not None:
            self._atmosphere_forcing_exogenous_names = (
                self.ocean_fraction_prediction.filter_atmosphere_forcing_names(
                    unfiltered_atmosphere_forcing_names,
                    self._atmosphere_ocean_config.ocean_fraction_name,
                )
            )
        else:
            self._atmosphere_forcing_exogenous_names = (
                unfiltered_atmosphere_forcing_names
            )

        self._shared_forcing_exogenous_names = list(
            set(self._ocean_forcing_exogenous_names).intersection(
                self._atmosphere_forcing_exogenous_names
            )
        )
        self._atmosphere_to_ocean_forcing_names = list(
            self.ocean.stepper.input_only_names.intersection(
                self.atmosphere.stepper.output_names
            )
        )
        extra_forcings_names = [self.sst_name]
        if self.ocean_fraction_prediction is not None:
            # NOTE: this is only necessary for the special case where the
            # atmosphere doesn't use the sea ice fraction as an ML forcing
            extra_forcings_names.append(
                self.ocean_fraction_prediction.sea_ice_fraction_name
            )

        self._ocean_to_atmosphere_forcing_names = list(
            self.atmosphere.stepper.input_only_names.intersection(
                self.ocean.stepper.output_names
            ).union(extra_forcings_names)
        )

        # calculate names for each component's data requirements
        unfiltered_all_atmosphere_names = list(
            self.atmosphere.stepper.all_names.difference(
                self.ocean.stepper.output_names
            )
        )
        if self.ocean_fraction_prediction is not None:
            self._all_atmosphere_names = (
                self.ocean_fraction_prediction.filter_atmosphere_forcing_names(
                    unfiltered_all_atmosphere_names,
                    self.ocean_fraction_name,
                )
            )
        else:
            self._all_atmosphere_names = unfiltered_all_atmosphere_names
        # NOTE: this removes "shared" forcings from the ocean data requirements
        self._all_ocean_names = list(
            self.ocean.stepper.all_names.difference(self._all_atmosphere_names)
        )
        if self.ocean_fraction_prediction is not None:
            # NOTE: land_fraciton is necessary to derive sea_ice_fraction from
            # ocean_sea_ice_fraction
            self._all_ocean_names.append(
                self.ocean_fraction_prediction.land_fraction_name
            )

        self.validate_prescribed_prognostic_names()

    def _ocean_supplied_atmosphere_names(self) -> set[str]:
        """Names written onto the atmosphere forcings from the ocean component
        in ``CoupledStepper._get_atmosphere_forcings``, known statically from
        this config.
        """
        names = set(self._ocean_to_atmosphere_forcing_names)
        # the ocean SST is renamed to the atmosphere's surface temperature name
        names.discard(self.sst_name)
        names.add(self.surface_temperature_name)
        names.add(self.ocean_fraction_name)
        if self.ocean_fraction_prediction is not None:
            names.add(
                self.ocean_fraction_prediction.sea_ice_fraction_name_in_atmosphere
                or self.ocean_fraction_prediction.sea_ice_fraction_name
            )
        return names

    def validate_prescribed_prognostic_names(self) -> None:
        """Raise if a prescribed atmosphere prognostic read from the forcing
        data would be silently overwritten by an ocean-supplied field of the
        same name in ``CoupledStepper._get_atmosphere_forcings``.

        Called at construction, and again after inference-time overrides
        mutate the component step configs (of the supported coupled overrides,
        only ``prescribed_prognostic_names`` can change the result). No
        ocean-side check is needed: atmosphere-supplied ocean forcings are
        input-only names, which cannot be prognostic and therefore cannot be
        prescribed.
        """
        prescribed = self.atmosphere.stepper.get_prescribed_prognostic_names()
        clobbered = sorted(set(prescribed) & self._ocean_supplied_atmosphere_names())
        if clobbered:
            raise ValueError(
                "Atmosphere prescribed_prognostic_names overlap ocean-supplied "
                f"forcings and would be overwritten: {clobbered}."
            )

    @property
    def timestep(self) -> datetime.timedelta:
        # the "coupled timestep" is the same as the ocean's
        return self._ocean_timestep

    @property
    def ocean_timestep(self) -> datetime.timedelta:
        return self._ocean_timestep

    @property
    def atmosphere_timestep(self) -> datetime.timedelta:
        return self._atmosphere_timestep

    @property
    def n_inner_steps(self) -> int:
        return self.ocean_timestep // self.atmosphere_timestep

    @property
    def atmosphere_ocean_config(self) -> OceanConfig:
        """The OceanConfig defined in the atmosphere StepperConfig."""
        return self._atmosphere_ocean_config

    @property
    def ocean_fraction_name(self) -> str:
        """Name of the ocean fraction field in the atmosphere data."""
        return self.atmosphere_ocean_config.ocean_fraction_name

    @property
    def surface_temperature_name(self) -> str:
        """Name of the surface temperature field in the atmosphere data."""
        return self.atmosphere_ocean_config.surface_temperature_name

    @property
    def ocean_next_step_forcing_names(self) -> list[str]:
        """Ocean next-step forcings."""
        return self.ocean.stepper.next_step_forcing_names

    @property
    def ocean_forcing_exogenous_names(self) -> list[str]:
        """Ocean forcing variables that are not outputs of the atmosphere."""
        return self._ocean_forcing_exogenous_names

    @property
    def atmosphere_forcing_exogenous_names(self) -> list[str]:
        """Atmosphere forcing variables that are not outputs of the ocean."""
        return self._atmosphere_forcing_exogenous_names

    @property
    def atmosphere_forcing_window_names(self) -> list[str]:
        """Atmosphere variables required in forcing windows for predict (includes
        next-step inputs such as prescribed prognostics).

        Computed from the current atmosphere step config, so inference-time
        overrides (e.g. ``prescribed_prognostic_names``) are reflected without
        a separate refresh step. The forcing window is the exogenous forcings
        plus any prescribed prognostic variables (outputs overwritten from
        forcing). We do not union the full ``next_step_input_names``: SST, ocean
        fraction, etc. are supplied from ``ocean_ic`` inside
        ``_get_atmosphere_forcings``, not from ``atmos_window.data``.
        """
        prescribed_atmosphere = (
            self.atmosphere.stepper.get_prescribed_prognostic_names()
        )
        return list(
            set(self._atmosphere_forcing_exogenous_names).union(prescribed_atmosphere)
        )

    @property
    def ocean_forcing_window_names(self) -> list[str]:
        """Ocean variables required in forcing windows for predict (exogenous
        fields not shared with the atmosphere, plus prescribed prognostic
        overwrites such as SST or layer temperatures).

        Computed from the current ocean step config, so inference-time overrides
        are reflected automatically. Shared exogenous names are taken from the
        atmosphere branch, not from ``ocean_data``.
        """
        prescribed_ocean = self.ocean.stepper.get_prescribed_prognostic_names()
        return list(
            set(self._ocean_forcing_exogenous_names)
            .difference(set(self._shared_forcing_exogenous_names))
            .union(prescribed_ocean)
        )

    @property
    def shared_forcing_exogenous_names(self) -> list[str]:
        """Exogenous forcing variables shared by both components. Must be
        present in the atmosphere data on disk. If time-varying, the ocean
        receives the atmosphere data forcings averaged over its step window.

        """
        return self._shared_forcing_exogenous_names

    @property
    def all_names(self) -> CoupledNames:
        """All variable names to log (outputs plus input-only forcings)."""
        atmosphere_names = sorted(
            set(self.atmosphere.stepper.output_names).union(
                self._atmosphere_forcing_exogenous_names
            )
        )
        ocean_names = sorted(
            set(self.ocean.stepper.output_names).union(
                self._ocean_forcing_exogenous_names
            )
        )
        return CoupledNames(ocean=ocean_names, atmosphere=atmosphere_names)

    @property
    def atmosphere_to_ocean_forcing_names(self) -> list[str]:
        """Ocean forcing variables that are outputs of the atmosphere."""
        return self._atmosphere_to_ocean_forcing_names

    @property
    def ocean_to_atmosphere_forcing_names(self) -> list[str]:
        """Atmosphere forcing variables that are outputs of the ocean."""
        return self._ocean_to_atmosphere_forcing_names

    def _validate_component_configs(self):
        # validate atmosphere's OceanConfig
        atmosphere_ocean_config = self.atmosphere.stepper.get_ocean()
        if atmosphere_ocean_config is None:
            raise ValueError(
                "The atmosphere stepper 'ocean' config is missing but must be set for "
                "coupled emulation."
            )
        if atmosphere_ocean_config.is_slab:
            raise ValueError(
                "The atmosphere stepper 'ocean' config cannot use 'slab' for "
                "coupled emulation."
            )
        # validate compatibility of ocean and atmosphere timestep sizes
        ocean_timestep = pd.Timedelta(self.ocean.timedelta).to_pytimedelta()
        atmosphere_timestep = pd.Timedelta(self.atmosphere.timedelta).to_pytimedelta()
        if atmosphere_timestep > ocean_timestep:
            raise ValueError("Atmosphere timedelta must not be larger than ocean's.")
        n_inner_steps = ocean_timestep / atmosphere_timestep
        if n_inner_steps != int(n_inner_steps):
            raise ValueError("Ocean timedelta must be a multiple of the atmosphere's.")

        # check for overlapping output names
        duplicate_outputs = set(self.ocean.stepper.output_names).intersection(
            self.atmosphere.stepper.output_names
        )
        if len(duplicate_outputs) > 0:
            raise ValueError(
                "Output variable names of CoupledStepper components cannot "
                f"overlap. Found the following duplicated names: {duplicate_outputs}"
            )

        # ocean diagnostics cannot be used as atmosphere inputs
        ocean_diags_as_atmos_forcings = list(
            self.atmosphere.stepper.input_only_names.intersection(
                self.ocean.stepper.output_names
            ).difference(self.ocean.stepper.input_names)
        )
        if len(ocean_diags_as_atmos_forcings) > 0:
            raise ValueError(
                "CoupledStepper only supports ocean prognostic variables as atmosphere "
                "forcings, but the following ocean diagnostic variables are inputs to "
                f"the atmosphere: {ocean_diags_as_atmos_forcings}."
            )

        # all ocean inputs that are atmosphere outputs must be "next step"
        # forcings according to the ocean stepper config
        atmosphere_to_ocean_forcing_names = list(
            self.ocean.stepper.input_only_names.intersection(
                self.atmosphere.stepper.output_names
            )
        )
        missing_next_step_forcings = list(
            set(atmosphere_to_ocean_forcing_names).difference(
                self.ocean.stepper.next_step_forcing_names
            )
        )
        if len(missing_next_step_forcings) > 0:
            raise ValueError(
                "The following variables which are atmosphere component outputs "
                "and ocean component inputs were not found among the ocean's "
                f"next_step_forcing_names: {missing_next_step_forcings}."
            )

        # sst_name must be present in the ocean's output names
        if self.sst_name not in self.ocean.stepper.output_names:
            raise ValueError(
                f"The variable {self.sst_name} is not in the ocean's output "
                "names but is required for coupling with the atmosphere."
            )

        # validate ocean_fraction_prediction
        if self.ocean_fraction_prediction is not None:
            self.ocean_fraction_prediction.validate_ocean_prognostic_names(
                self.ocean.stepper.prognostic_names,
            )
            self.ocean_fraction_prediction.validate_atmosphere_forcing_names(
                self.atmosphere.stepper.input_only_names
            )

    def _get_ocean_data_requirements(self, n_forward_steps: int) -> DataRequirements:
        return DataRequirements(
            names=self._all_ocean_names, n_timesteps=n_forward_steps + 1
        )

    def _get_atmosphere_data_requirements(
        self, n_forward_steps: int
    ) -> DataRequirements:
        return DataRequirements(
            names=self._all_atmosphere_names, n_timesteps=n_forward_steps + 1
        )

    def get_evaluation_window_data_requirements(
        self, n_coupled_steps: int
    ) -> CoupledDataRequirements:
        """Get the DataRequirements for the ocean and atmosphere. For every step
        of the CoupledStepper, the atmosphere takes n_inner_steps (determined by
        the number of atmosphere timesteps that fit in a single ocean timestep)
        steps and the ocean takes a single step. Therefore, we need
        n_coupled_steps number of ocean forward steps and n_coupled_steps *
        n_inner_steps number of atmosphere forward steps.

        n_coupled_steps: The number of CoupledStepper forward steps. During
            training, these steps are included when computing gradients.

        """
        return CoupledDataRequirements(
            ocean_timestep=self.ocean_timestep,
            ocean_requirements=self._get_ocean_data_requirements(n_coupled_steps),
            atmosphere_timestep=self.atmosphere_timestep,
            atmosphere_requirements=self._get_atmosphere_data_requirements(
                n_coupled_steps * self.n_inner_steps
            ),
        )

    def get_prognostic_state_data_requirements(
        self,
    ) -> CoupledPrognosticStateDataRequirements:
        """Get the PrognosticStateDataRequirements for the ocean and atmosphere."""
        return CoupledPrognosticStateDataRequirements(
            ocean=self.ocean.stepper.get_prognostic_state_data_requirements(),
            atmosphere=self.atmosphere.stepper.get_prognostic_state_data_requirements(),
        )

    def get_forcing_window_data_requirements(
        self, n_coupled_steps: int
    ) -> CoupledDataRequirements:
        return CoupledDataRequirements(
            ocean_timestep=self.ocean_timestep,
            ocean_requirements=DataRequirements(
                names=self.ocean_forcing_window_names,
                n_timesteps=n_coupled_steps + 1,
            ),
            atmosphere_timestep=self.atmosphere_timestep,
            atmosphere_requirements=DataRequirements(
                names=self.atmosphere_forcing_window_names,
                n_timesteps=n_coupled_steps * self.n_inner_steps + 1,
            ),
        )

    def _get_ocean_stepper(
        self,
        dataset_info: DatasetInfo,
        parameter_initializer: ParameterInitializer | None = None,
    ) -> Stepper:
        if dataset_info.timestep != self.ocean_timestep:
            raise ValueError(
                "Ocean timestep must match the dataset timestep. "
                f"Got {self.ocean_timestep} and {dataset_info.timestep}, respectively."
            )
        return self.ocean.stepper.get_stepper(
            dataset_info=dataset_info,
            parameter_initializer=parameter_initializer,
        )

    def _get_atmosphere_stepper(
        self,
        dataset_info: DatasetInfo,
        parameter_initializer: ParameterInitializer | None = None,
    ) -> Stepper:
        if dataset_info.timestep != self.atmosphere_timestep:
            raise ValueError(
                "Atmosphere timestep must match the dataset timestep. "
                f"Got {self.atmosphere_timestep} and {dataset_info.timestep}, "
                "respectively."
            )
        return self.atmosphere.stepper.get_stepper(
            dataset_info=dataset_info,
            parameter_initializer=parameter_initializer,
        )

    def get_stepper(
        self,
        dataset_info: CoupledDatasetInfo,
        ocean_parameter_initializer: ParameterInitializer | None = None,
        atmosphere_parameter_initializer: ParameterInitializer | None = None,
    ):
        logging.info("Initializing coupler")
        return CoupledStepper(
            config=self,
            ocean=self._get_ocean_stepper(
                dataset_info=dataset_info.ocean,
                parameter_initializer=ocean_parameter_initializer,
            ),
            atmosphere=self._get_atmosphere_stepper(
                dataset_info=dataset_info.atmosphere,
                parameter_initializer=atmosphere_parameter_initializer,
            ),
            dataset_info=dataset_info,
        )

    def get_state(self):
        return dataclasses.asdict(self)

    @classmethod
    def from_state(cls, state) -> "CoupledStepperConfig":
        state = cls.remove_deprecated_keys(state)
        return dacite.from_dict(
            data_class=cls,
            data=state,
            config=dacite.Config(
                strict=True, type_hooks={StepperConfig: StepperConfig.from_state}
            ),
        )

    @classmethod
    def remove_deprecated_keys(cls, state: dict[str, Any]) -> dict[str, Any]:
        state_copy = state.copy()
        if "sst_mask_name" in state_copy:
            del state_copy["sst_mask_name"]
        if "parameter_init" in state_copy:
            del state_copy["parameter_init"]
        for component_key in ["ocean", "atmosphere"]:
            if "loss_contributions" in state_copy[component_key]:
                del state_copy[component_key]["loss_contributions"]
        return state_copy


class ComponentStepMetrics:
    def __init__(self):
        self._ocean: TensorDict = {}
        self._atmos: TensorDict = {}

    def add_metric(self, key, value, realm: Literal["ocean", "atmosphere"]) -> None:
        if realm == "ocean":
            self._ocean[key] = value
        elif realm == "atmosphere":
            self._atmos[key] = value

    def get_ocean_metrics(self) -> TensorDict:
        if not self._ocean:
            return {"loss/ocean": torch.tensor(0.0, device=fme.get_device())}
        loss = sum(self._ocean.values())
        return {
            "loss/ocean": loss,
            **self._ocean,
        }

    def get_atmosphere_metrics(self) -> TensorDict:
        if not self._atmos:
            return {"loss/atmosphere": torch.tensor(0.0, device=fme.get_device())}
        loss = sum(self._atmos.values())
        return {
            "loss/atmosphere": loss,
            **self._atmos,
        }


@dataclasses.dataclass
class CoupledTrainOutput(TrainOutputABC):
    total_metrics: TensorDict
    ocean: TrainOutput
    atmosphere: TrainOutput

    def remove_initial_condition(self, n_ic_timesteps: int) -> "CoupledTrainOutput":
        return CoupledTrainOutput(
            total_metrics=self.total_metrics,
            ocean=self.ocean.remove_initial_condition(n_ic_timesteps),
            atmosphere=self.atmosphere.remove_initial_condition(n_ic_timesteps),
        )

    def copy(self) -> "CoupledTrainOutput":
        return CoupledTrainOutput(
            total_metrics=self.total_metrics.copy(),
            ocean=self.ocean.copy(),
            atmosphere=self.atmosphere.copy(),
        )

    def prepend_initial_condition(
        self,
        initial_condition: CoupledPrognosticState,
    ) -> "CoupledTrainOutput":
        """
        Prepends an initial condition to the existing stepped data.
        Assumes data are on the same device.

        Args:
            initial_condition: Initial condition data.
        """
        return CoupledTrainOutput(
            total_metrics=self.total_metrics,
            ocean=self.ocean.prepend_initial_condition(
                initial_condition.ocean_data,
            ),
            atmosphere=self.atmosphere.prepend_initial_condition(
                initial_condition.atmosphere_data,
            ),
        )

    def compute_derived_variables(self) -> "CoupledTrainOutput":
        return CoupledTrainOutput(
            total_metrics=self.total_metrics,
            ocean=self.ocean.compute_derived_variables(),
            atmosphere=self.atmosphere.compute_derived_variables(),
        )

    def get_metrics(self) -> TensorDict:
        ocean_keys = set(self.ocean.metrics.keys())
        atmos_keys = set(self.atmosphere.metrics.keys())
        overlap = ocean_keys.intersection(atmos_keys)
        if len(overlap) > 0:
            raise ValueError(
                "The following metrics have the same name in the atmosphere and ocean: "
                f"{overlap}."
            )
        overlap = ocean_keys.union(atmos_keys).intersection(self.total_metrics.keys())
        if len(overlap) > 0:
            raise ValueError(
                "The following total metric names conflict with ocean or atmosphere "
                f"metric names: {overlap}."
            )
        return {
            **self.total_metrics,
            **self.ocean.metrics,
            **self.atmosphere.metrics,
        }


class ComponentStepPrediction:
    def __init__(
        self,
        realm: Literal["ocean", "atmosphere"],
        data: TensorDict,
        step: int,
        stepper_state: StepperState | None,
        corrector_diagnostics: CorrectorDiagnostics,
    ):
        # required so no construction site silently drops the step's diagnostics
        self._realm: Literal["ocean", "atmosphere"] = realm
        self._data = data
        self._step = step
        self._stepper_state = stepper_state
        self._corrector_diagnostics = corrector_diagnostics

    @property
    def realm(self) -> Literal["ocean", "atmosphere"]:
        return self._realm

    @property
    def data(self) -> TensorDict:
        return self._data

    @property
    def step(self) -> int:
        return self._step

    @property
    def stepper_state(self) -> StepperState | None:
        return self._stepper_state

    @property
    def corrector_diagnostics(self) -> CorrectorDiagnostics:
        return self._corrector_diagnostics


def _realm_step_outputs(
    output_list: list[ComponentStepPrediction],
    realm: Literal["ocean", "atmosphere"],
) -> list[StepOutput]:
    return [
        StepOutput(
            output=x.data,
            stepper_state=x.stepper_state,
            corrector_diagnostics=x.corrector_diagnostics,
        )
        for x in output_list
        if x.realm == realm
    ]


class _StepOffsetOptimization(OptimizationABC):
    """Delegates to ``optimization``, adding ``step_offset`` to the step passed
    to ``checkpoint``, so a split atmosphere window sees the same step numbers
    as an unsplit one.
    """

    def __init__(self, optimization: OptimizationABC, step_offset: int):
        self._optimization = optimization
        self._step_offset = step_offset

    def checkpoint(self, module: nn.Module, step: int) -> nn.Module:
        return self._optimization.checkpoint(module, step=step + self._step_offset)

    @contextlib.contextmanager
    def autocast(self):
        with self._optimization.autocast():
            yield

    @property
    def learning_rate(self) -> float:
        return self._optimization.learning_rate

    @property
    def learning_rates(self) -> dict[str, float]:
        return self._optimization.learning_rates

    def set_learning_rate(self, lr: float):
        self._optimization.set_learning_rate(lr)

    def set_mode(self, modules: nn.ModuleList):
        self._optimization.set_mode(modules)

    def step_scheduler(
        self, valid_loss: float | None = None, is_iteration: bool = False
    ):
        self._optimization.step_scheduler(valid_loss, is_iteration)

    def detach_if_using_gradient_accumulation(self, state: TensorMapping) -> TensorDict:
        return self._optimization.detach_if_using_gradient_accumulation(state)

    def accumulate_loss(self, loss: torch.Tensor):
        self._optimization.accumulate_loss(loss)

    def get_accumulated_loss(self) -> torch.Tensor:
        return self._optimization.get_accumulated_loss()

    def step_weights(self):
        self._optimization.step_weights()

    def get_state(self):
        return self._optimization.get_state()

    def load_state(self, state):
        self._optimization.load_state(state)


class CoupledStepper:
    TIME_DIM = 1

    def __init__(
        self,
        config: CoupledStepperConfig,
        ocean: Stepper,
        atmosphere: Stepper,
        dataset_info: CoupledDatasetInfo,
    ):
        """
        Args:
            config: The configuration.
            ocean: The ocean stepper.
            atmosphere: The atmosphere stepper.
            dataset_info: The CoupledDatasetInfo.
        """
        if ocean.n_ic_timesteps != 1 or atmosphere.n_ic_timesteps != 1:
            raise ValueError("Only n_ic_timesteps = 1 is currently supported.")

        self.ocean = ocean
        self.atmosphere = atmosphere
        self._config = config
        # Alias each component's nested StepperConfig to the loaded Stepper's
        # own config so forcing-window names (computed from CoupledStepperConfig)
        # reflect any inference-time overrides applied to the component steppers.
        config.ocean.stepper = ocean.config
        config.atmosphere.stepper = atmosphere.config
        self._dataset_info = dataset_info
        self._ocean_spatial_mask_provider = dataset_info.ocean_spatial_mask_provider

        _: PredictFunction[  # for type checking
            CoupledPrognosticState,
            CoupledBatchData,
            CoupledPairedData,
        ] = self.predict_paired

    @property
    def config(self) -> CoupledStepperConfig:
        return self._config

    @property
    def modules(self) -> nn.ModuleList:
        return nn.ModuleList([*self.atmosphere.modules, *self.ocean.modules])

    def set_train(self):
        self.atmosphere.set_train()
        self.ocean.set_train()

    def set_eval(self):
        self.atmosphere.set_eval()
        self.ocean.set_eval()

    def set_epoch(self, epoch: int) -> None:
        self.atmosphere.set_epoch(epoch)
        self.ocean.set_epoch(epoch)

    def get_state(self):
        """
        Returns:
            The state of the coupled stepper.
        """
        return {
            "config": self._config.get_state(),
            "atmosphere_state": self.atmosphere.get_state(),
            "ocean_state": self.ocean.get_state(),
            "dataset_info": self._dataset_info.get_state(),
        }

    def load_state(self, state: dict[str, Any]):
        self.atmosphere.load_state(state["atmosphere_state"])
        self.ocean.load_state(state["ocean_state"])

    @property
    def training_dataset_info(self) -> CoupledDatasetInfo:
        return self._dataset_info

    @property
    def n_ic_timesteps(self) -> int:
        return 1

    @property
    def n_inner_steps(self) -> int:
        """Number of atmosphere steps per ocean step."""
        return self._config.n_inner_steps

    @property
    def _ocean_forcing_exogenous_names(self) -> list[str]:
        return self._config.ocean_forcing_exogenous_names

    @property
    def _atmosphere_forcing_exogenous_names(self) -> list[str]:
        return self._config.atmosphere_forcing_exogenous_names

    @property
    def _atmosphere_forcing_window_names(self) -> list[str]:
        return self._config.atmosphere_forcing_window_names

    @property
    def _ocean_forcing_window_names(self) -> list[str]:
        return self._config.ocean_forcing_window_names

    @property
    def _shared_forcing_exogenous_names(self) -> list[str]:
        return self._config.shared_forcing_exogenous_names

    @property
    def _atmosphere_to_ocean_forcing_names(self) -> list[str]:
        return self._config.atmosphere_to_ocean_forcing_names

    @property
    def _ocean_to_atmosphere_forcing_names(self) -> list[str]:
        return self._config.ocean_to_atmosphere_forcing_names

    def _prescribe_ic_sst(
        self,
        atmos_ic_state: PrognosticState,
        forcing_ic_batch: BatchData,
    ) -> PrognosticState:
        """Prescribe the initial condition SST state on the surface_temperature
        initial condition field.

        atmos_ic_state: The atmosphere prognostic state to be updated.
        forcing_ic_state: The corresponding forcing state at the same time,
            which should be output from _get_atmosphere_forcings.

        """
        ts_name = self.atmosphere.surface_temperature_name
        assert np.all(atmos_ic_state.as_batch_data().time == forcing_ic_batch.time)
        atmos_ic_data = atmos_ic_state.as_batch_data().data
        forcing_ic_data = forcing_ic_batch.data
        assert ts_name in atmos_ic_data
        assert ts_name in forcing_ic_data
        assert self.atmosphere.ocean_fraction_name in forcing_ic_data
        atmos_ic_data = self.atmosphere.prescribe_sst(
            mask_data=forcing_ic_data,
            gen_data=atmos_ic_data,
            target_data=forcing_ic_data,
        )
        return PrognosticState(
            BatchData(
                data=atmos_ic_data,
                time=forcing_ic_batch.time,
                labels=forcing_ic_batch.labels,
                stepper_state=atmos_ic_state.as_batch_data().stepper_state,
            )
        )

    def _forcings_from_ocean_with_ocean_fraction(
        self,
        forcings_from_ocean: TensorMapping,
        atmos_forcing_data: TensorMapping,
    ) -> TensorDict:
        """Get the ocean fraction field and return it with the other fields in
        forcings_from_ocean.

        Returns:
            forcings_from_ocean: A copy of the forcings_from_ocean input,
            including the ocean fraction.

        """
        ocean_frac_name = self._config.ocean_fraction_name
        forcings_from_ocean = dict(forcings_from_ocean)
        if self._config.ocean_fraction_prediction is None:
            # for convenience, move the atmos's ocean fraction to the
            # forcings_from_ocean dict
            forcings_from_ocean[ocean_frac_name] = atmos_forcing_data[ocean_frac_name]
        else:
            # compute ocean frac from land frac and ocean-predicted sea ice frac
            ofrac_config = self._config.ocean_fraction_prediction
            ocean_data = ofrac_config.build_ocean_data(
                forcings_from_ocean, atmos_forcing_data
            )
            sea_ice_frac_name = (
                ofrac_config.sea_ice_fraction_name_in_atmosphere
                or ofrac_config.sea_ice_fraction_name
            )
            forcings_from_ocean[sea_ice_frac_name] = ocean_data.sea_ice_fraction
            forcings_from_ocean[ocean_frac_name] = torch.clip(
                ocean_data.ocean_fraction, min=0
            )
        for name, tensor in forcings_from_ocean.items():
            # set ocean invalid points to 0 based on the ocean masking
            mask = self._ocean_spatial_mask_provider.get_mask_tensor_for(name)
            if mask is not None:
                mask = mask.expand(tensor.shape)
                forcings_from_ocean[name] = tensor.where(mask != 0, 0)
        return forcings_from_ocean

    def _get_atmosphere_forcings(
        self,
        atmos_data: TensorMapping,
        ocean_ic: TensorMapping,
    ) -> TensorDict:
        """
        Get the forcings for the atmosphere component.

        Args:
            atmos_data: Atmosphere batch data, including initial condition and forward
                steps.
            ocean_ic: Ocean initial condition state, including SST.
        """
        time_dim = self.atmosphere.TIME_DIM
        window_shape = next(iter(atmos_data.values())).shape
        sizes = [-1] * len(window_shape)
        sizes[time_dim] = window_shape[time_dim]
        # Exogenous and next-step forcing fields (e.g. prescribed prognostics)
        forcing_data = {k: atmos_data[k] for k in self._atmosphere_forcing_window_names}
        # forcings from ocean are constant during the fast atmosphere steps
        # NOTE: only n_ic_timesteps = 1 is currently supported
        assert next(iter(ocean_ic.values())).shape[self.ocean.TIME_DIM] == 1
        forcings_from_ocean = {
            k: ocean_ic[k].expand(*sizes)
            for k in self._ocean_to_atmosphere_forcing_names
        }
        # rename the ocean surface temperature variable using the corresponding
        # name in the atmosphere
        forcings_from_ocean[self._config.surface_temperature_name] = (
            forcings_from_ocean.pop(self._config.sst_name)
        )
        # get the SST mask (0 if land, 1 if sea surface)
        forcings_from_ocean = self._forcings_from_ocean_with_ocean_fraction(
            forcings_from_ocean, forcing_data
        )
        # A prescribed atmosphere prognostic colliding with an ocean-supplied
        # field is rejected by
        # CoupledStepperConfig.validate_prescribed_prognostic_names, which runs
        # at construction and after inference-time overrides.
        # update atmosphere forcings
        forcing_data.update(forcings_from_ocean)
        return forcing_data

    def _get_ocean_forcings(
        self,
        ocean_data: TensorMapping,
        atmos_gen: TensorMapping,
        atmos_forcings: TensorMapping,
    ) -> TensorDict:
        """
        Get the forcings for the ocean component.

        Args:
            ocean_data: Ocean data, including initial condition and forward
                steps.
            atmos_gen: Generated atmosphere data covering the ocean forward steps.
            atmos_forcings: Atmosphere forcing data covering the ocean forward steps.
        """
        time_dim = self.ocean.TIME_DIM
        # NOTE: only n_ic_timesteps = 1 is currently supported
        assert (
            next(iter(ocean_data.values())).shape[time_dim] == self.n_ic_timesteps + 1
        )
        # Ocean-only exogenous forcings plus prescribed prognostic time series
        # (e.g. thetao_18) from the forcing window batch.
        forcing_data = {k: ocean_data[k] for k in self._ocean_forcing_window_names}
        # get time-averaged forcings from atmosphere
        forcings_from_atmosphere = {
            **{
                k: atmos_gen[k].mean(time_dim, keepdim=True)
                for k in self._atmosphere_to_ocean_forcing_names
            },
            **{
                k: atmos_forcings[k].mean(time_dim, keepdim=True)
                for k in self._shared_forcing_exogenous_names
            },
        }
        # append or prepend nans depending on whether or not the forcing is a
        # "next step" forcing
        forcings_from_atmosphere = {
            k: (
                torch.cat([torch.full_like(v, fill_value=np.nan), v], dim=time_dim)
                if k in self._config.ocean_next_step_forcing_names
                else torch.cat([v, torch.full_like(v, fill_value=np.nan)], dim=time_dim)
            )
            for k, v in forcings_from_atmosphere.items()
        }
        forcing_data.update(forcings_from_atmosphere)
        return forcing_data

    def _atmosphere_window_generator(
        self,
        atmos_ic_state: PrognosticState,
        atmos_window: BatchData,
        ocean_ic: TensorMapping,
        optimizer: OptimizationABC,
        attached_ocean_step: TensorMapping | None,
        attached_inner_step: int | None,
    ) -> Generator[StepOutput, None, None]:
        """Predict one window of atmosphere steps.

        Without an attached ocean step, one atmosphere generator runs the
        window with forcings from ``ocean_ic``. With one, the window is split
        into segments around ``attached_inner_step``, whose forcings (and IC
        SST, if it is the window's first step) come from
        ``attached_ocean_step``. Each segment's forcings are built while
        resuming its first step, so the attached forcing is built in the pair
        step's own grad context.
        """
        n_ic = self.atmosphere.n_ic_timesteps
        if attached_ocean_step is None or attached_inner_step is None:
            boundaries = [0, self.n_inner_steps]
        else:
            boundaries = sorted(
                {0, attached_inner_step, attached_inner_step + 1, self.n_inner_steps}
            )
        ic_state = atmos_ic_state
        for start, end in zip(boundaries[:-1], boundaries[1:]):
            segment_window = atmos_window.select_time_slice(slice(start, end + n_ic))
            segment_ocean_ic: TensorMapping
            if attached_ocean_step is not None and start == attached_inner_step:
                segment_ocean_ic = {
                    k: v.unsqueeze(self.ocean.TIME_DIM)
                    for k, v in attached_ocean_step.items()
                }
            else:
                segment_ocean_ic = ocean_ic
            segment_forcings = BatchData(
                data=self._get_atmosphere_forcings(
                    segment_window.data, segment_ocean_ic
                ),
                time=segment_window.time,
                labels=segment_window.labels,
            )
            if start == 0:
                ic_state = self._prescribe_ic_sst(
                    ic_state, segment_forcings.select_time_slice(slice(None, n_ic))
                )
            segment_generator = self.atmosphere.get_prediction_generator(
                ic_state,
                segment_forcings,
                end - start,
                optimizer if start == 0 else _StepOffsetOptimization(optimizer, start),
            )
            for _ in range(end - start):
                result = next(segment_generator)
                yield result
            # The unsplit generator detaches its state on resume; a segment that
            # is not resumed hands its last state on attached, so detach here.
            ic_state = PrognosticState(
                BatchData(
                    data={
                        k: v.unsqueeze(self.atmosphere.TIME_DIM)
                        for k, v in optimizer.detach_if_using_gradient_accumulation(
                            result.output
                        ).items()
                    },
                    time=segment_window.time.isel(time=slice(-n_ic, None)),
                    labels=segment_window.labels,
                    stepper_state=result.stepper_state,
                )
            )

    def get_prediction_generator(
        self,
        initial_condition: CoupledPrognosticState,
        forcing_data: CoupledBatchData,
        optimizer: OptimizationABC,
        joint_pair: JointPair | None = None,
    ) -> Generator[ComponentStepPrediction, None, None]:
        """Yield atmosphere and ocean steps in causal order.

        ``joint_pair`` keeps the pair's direct edge attached through the
        gradient-accumulation detaches: the pair's atmosphere step in the ocean
        forcing mean (ocean later), or the pair's ocean output in the pair
        atmosphere step's forcings (atmosphere later). Inference passes None.
        """
        if (
            initial_condition.atmosphere_data.as_batch_data().n_timesteps
            != self.atmosphere.n_ic_timesteps
        ):
            raise ValueError(
                "Atmosphere initial condition must have "
                f"{self.atmosphere.n_ic_timesteps} timesteps, got "
                f"{initial_condition.atmosphere_data.as_batch_data().n_timesteps}."
            )

        if (
            initial_condition.ocean_data.as_batch_data().n_timesteps
            != self.n_ic_timesteps
        ):
            raise ValueError(
                "Ocean initial condition must have "
                f"{self.n_ic_timesteps} timesteps, got "
                f"{initial_condition.ocean_data.as_batch_data().n_timesteps}."
            )
        atmos_ic_state = initial_condition.atmosphere_data
        ocean_ic_state = initial_condition.ocean_data

        n_outer_steps = forcing_data.ocean_data.n_timesteps - self.n_ic_timesteps
        # x_O(i_O) kept attached for the atmosphere-later pair step; derived
        # tensors are built in the pair step's grad context, not here
        attached_ocean_step: TensorMapping | None = None

        for i_outer in range(n_outer_steps):
            # get the atmosphere window for the initial coupled step
            atmos_window = forcing_data.atmosphere_data.select_time_slice(
                slice(
                    i_outer * self.n_inner_steps,
                    (i_outer + 1) * self.n_inner_steps + self.atmosphere.n_ic_timesteps,
                )
            )
            pair_inner_step: int | None = None
            if (
                joint_pair is not None
                and joint_pair.atmosphere_step // self.n_inner_steps == i_outer
            ):
                pair_inner_step = joint_pair.atmosphere_step % self.n_inner_steps
            atmos_generator = self._atmosphere_window_generator(
                atmos_ic_state,
                atmos_window,
                ocean_ic_state.as_batch_data().data,
                optimizer,
                attached_ocean_step=attached_ocean_step,
                attached_inner_step=pair_inner_step,
            )
            attached_ocean_step = None
            atmos_steps = []
            atmos_stepper_state: StepperState | None = None

            # predict and yield atmosphere steps
            for i_inner in range(self.n_inner_steps):
                atmos_step_num = i_outer * self.n_inner_steps + i_inner
                atmos_result = next(atmos_generator)
                atmos_step = atmos_result.output
                atmos_stepper_state = atmos_result.stepper_state
                yield ComponentStepPrediction(
                    realm="atmosphere",
                    data=atmos_step,
                    step=atmos_step_num,
                    stepper_state=atmos_stepper_state,
                    corrector_diagnostics=atmos_result.corrector_diagnostics,
                )
                ocean_later_pair_step = (
                    joint_pair is not None
                    and joint_pair.ocean_is_later
                    and atmos_step_num == joint_pair.atmosphere_step
                )
                if not ocean_later_pair_step:
                    atmos_step = optimizer.detach_if_using_gradient_accumulation(
                        atmos_step
                    )
                atmos_steps.append(atmos_step)

            atmos_gen = stack_list_of_tensor_dicts(
                atmos_steps, self.atmosphere.TIME_DIM
            )
            atmos_data_forcings = atmos_window.select_time_slice(
                time_slice=slice(
                    self.atmosphere.n_ic_timesteps,
                    self.n_inner_steps + self.atmosphere.n_ic_timesteps,
                )
            )
            ocean_window = forcing_data.ocean_data.select_time_slice(
                slice(i_outer, i_outer + self.n_ic_timesteps + 1)
            )
            ocean_forcings = BatchData(
                data=self._get_ocean_forcings(
                    ocean_window.data,
                    atmos_gen,
                    atmos_data_forcings.data,
                ),
                time=ocean_window.time,
                labels=ocean_window.labels,
            )
            # predict and yield a single ocean step
            ocean_result = next(
                iter(
                    self.ocean.get_prediction_generator(
                        ocean_ic_state,
                        ocean_forcings,
                        n_forward_steps=1,
                        optimizer=optimizer,
                    )
                )
            )
            ocean_step = ocean_result.output
            yield ComponentStepPrediction(
                realm="ocean",
                data=ocean_step,
                step=i_outer,
                stepper_state=ocean_result.stepper_state,
                corrector_diagnostics=ocean_result.corrector_diagnostics,
            )

            # prepare ic states for next coupled step
            atmos_ic_data = {
                k: v.unsqueeze(self.atmosphere.TIME_DIM)
                for k, v in atmos_steps[-1].items()
            }
            atmos_ic_state = PrognosticState(
                BatchData(
                    data=optimizer.detach_if_using_gradient_accumulation(atmos_ic_data),
                    time=atmos_window.time.isel(
                        time=slice(-self.atmosphere.n_ic_timesteps, None)
                    ),
                    labels=atmos_window.labels,
                    stepper_state=atmos_stepper_state,
                )
            )
            ocean_ic_data = {
                k: v.unsqueeze(self.ocean.TIME_DIM) for k, v in ocean_step.items()
            }
            if (
                joint_pair is not None
                and not joint_pair.ocean_is_later
                and i_outer == joint_pair.ocean_step
            ):
                attached_ocean_step = ocean_step
            ocean_ic_state = PrognosticState(
                BatchData(
                    data=optimizer.detach_if_using_gradient_accumulation(ocean_ic_data),
                    time=ocean_window.time.isel(time=slice(-self.n_ic_timesteps, None)),
                    labels=ocean_window.labels,
                    stepper_state=ocean_result.stepper_state,
                )
            )

    def _process_prediction_generator_list(
        self,
        output_list: list[ComponentStepPrediction],
        forcing_data: CoupledBatchData,
    ) -> CoupledBatchData:
        atmos_data = process_prediction_generator_list(
            _realm_step_outputs(output_list, "atmosphere"),
            time=forcing_data.atmosphere_data.time[:, self.atmosphere.n_ic_timesteps :],
            horizontal_dims=forcing_data.atmosphere_data.horizontal_dims,
            labels=forcing_data.atmosphere_data.labels,
            n_ensemble=forcing_data.atmosphere_data.n_ensemble,
        )
        ocean_data = process_prediction_generator_list(
            _realm_step_outputs(output_list, "ocean"),
            time=forcing_data.ocean_data.time[:, self.ocean.n_ic_timesteps :],
            horizontal_dims=forcing_data.ocean_data.horizontal_dims,
            labels=forcing_data.ocean_data.labels,
            n_ensemble=forcing_data.ocean_data.n_ensemble,
        )
        return CoupledBatchData(ocean_data=ocean_data, atmosphere_data=atmos_data)

    def _predict(
        self,
        initial_condition: CoupledPrognosticState,
        forcing: CoupledBatchData,
        compute_derived_variables: bool = False,
    ) -> tuple[CoupledBatchData, CoupledPrognosticState]:
        timer = GlobalTimer.get_instance()
        output_list = list(
            self.get_prediction_generator(
                initial_condition, forcing, NullOptimization()
            )
        )
        gen_data = self._process_prediction_generator_list(output_list, forcing)
        if compute_derived_variables:
            with timer.context("compute_derived_variables"):
                gen_data = (
                    gen_data.prepend(initial_condition)
                    .compute_derived_variables(
                        ocean_derive_func=self.ocean.derive_func,
                        atmosphere_derive_func=self.atmosphere.derive_func,
                        forcing_data=forcing,
                    )
                    .remove_initial_condition(
                        n_ic_timesteps_ocean=self.ocean.n_ic_timesteps,
                        n_ic_timesteps_atmosphere=self.atmosphere.n_ic_timesteps,
                    )
                )
        prognostic_state = CoupledPrognosticState(
            ocean_data=gen_data.ocean_data.get_end(
                self.ocean.prognostic_names,
                self.ocean.n_ic_timesteps,
            ),
            atmosphere_data=gen_data.atmosphere_data.get_end(
                self.atmosphere.prognostic_names,
                self.atmosphere.n_ic_timesteps,
            ),
        )
        # Attach the stacked per-step diagnostics last: every time-touching
        # BatchData method (including get_end above) raises on a
        # diagnostics-bearing batch, and here each realm's series is aligned
        # with that realm's prediction time axis.
        gen_data = gen_data.with_step_diagnostics(
            ocean=StepOutput.stack_diagnostics(
                _realm_step_outputs(output_list, "ocean")
            ),
            atmosphere=StepOutput.stack_diagnostics(
                _realm_step_outputs(output_list, "atmosphere")
            ),
        )
        return gen_data, prognostic_state

    def predict_paired(
        self,
        initial_condition: CoupledPrognosticState,
        forcing: CoupledBatchData,
        compute_derived_variables: bool = False,
    ) -> tuple[CoupledPairedData, CoupledPrognosticState]:
        """
        Predict multiple steps forward given initial condition and reference data.
        """
        gen_data, prognostic_state = self._predict(
            initial_condition, forcing, compute_derived_variables
        )
        atmos_forward_data = self.atmosphere.get_forward_data(
            forcing.atmosphere_data, compute_derived_variables=compute_derived_variables
        )
        ocean_forward_data = self.ocean.get_forward_data(
            forcing.ocean_data, compute_derived_variables=compute_derived_variables
        )
        return (
            CoupledPairedData.from_coupled_batch_data(
                prediction=gen_data,
                reference=CoupledBatchData(
                    ocean_data=ocean_forward_data,
                    atmosphere_data=atmos_forward_data,
                ),
            ),
            prognostic_state,
        )

    def predict(
        self,
        initial_condition: CoupledPrognosticState,
        forcing: CoupledBatchData,
        compute_derived_variables: bool = False,
    ) -> tuple[CoupledBatchData, CoupledPrognosticState]:
        return self._predict(initial_condition, forcing, compute_derived_variables)

    def update_training_history(self, training_job: TrainingJob) -> None:
        """
        Update the stepper's history of training jobs.

        Args:
            training_job: The training job to add to the history.
        """
        self.ocean.update_training_history(training_job)
        self.atmosphere.update_training_history(training_job)

    @classmethod
    def from_state(cls, state) -> "CoupledStepper":
        ocean = Stepper.from_state(state["ocean_state"])
        atmosphere = Stepper.from_state(state["atmosphere_state"])
        config = CoupledStepperConfig.from_state(state["config"])
        if "dataset_info" in state:
            dataset_info = CoupledDatasetInfo.from_state(state["dataset_info"])
        else:
            # NOTE: this is included for backwards compatibility
            dataset_info = CoupledDatasetInfo(
                ocean=ocean.training_dataset_info,
                atmosphere=atmosphere.training_dataset_info,
            )
        return cls(
            config=config,
            ocean=ocean,
            atmosphere=atmosphere,
            dataset_info=dataset_info,
        )


class ComponentEnsembleStepPrediction:
    """Like ComponentStepPrediction but with an explicit ensemble dimension."""

    def __init__(
        self,
        realm: Literal["ocean", "atmosphere"],
        data: EnsembleTensorDict,
        step: int,
    ):
        self._realm: Literal["ocean", "atmosphere"] = realm
        self._data = data
        self._step = step

    @property
    def realm(self) -> Literal["ocean", "atmosphere"]:
        return self._realm

    @property
    def data(self) -> EnsembleTensorDict:
        return self._data

    @property
    def step(self) -> int:
        return self._step

    def detach_if_using_gradient_accumulation(
        self, optimizer: OptimizationABC
    ) -> "ComponentEnsembleStepPrediction":
        """Eagerly detach the data tensor map from the computational graph
        if already consumed in backprop, i.e. when using gradient accumulation.

        """
        return ComponentEnsembleStepPrediction(
            realm=self.realm,
            data=EnsembleTensorDict(
                optimizer.detach_if_using_gradient_accumulation(self.data)
            ),
            step=self.step,
        )

    def detach(self) -> "ComponentEnsembleStepPrediction":
        """Detach the data tensor map from the computation graph. Should only be
        called after backprop has finished.

        """
        return ComponentEnsembleStepPrediction(
            realm=self.realm,
            data=EnsembleTensorDict({k: v.detach() for k, v in self.data.items()}),
            step=self.step,
        )


def _process_ensemble_output_list(
    output_list: list[ComponentEnsembleStepPrediction],
) -> tuple[EnsembleTensorDict, EnsembleTensorDict]:
    """Separate and detach generated component outputs. Should be called only
    after OptimizationABC.step_weights().

    Returns:
        A tuple of (ocean_gen_data, atmos_gen_data) with explicit
        ensemble dimension.

    """
    atmos_gen_data = process_ensemble_prediction_generator_list(
        [x.detach().data for x in output_list if x.realm == "atmosphere"],
    )
    ocean_gen_data = process_ensemble_prediction_generator_list(
        [x.detach().data for x in output_list if x.realm == "ocean"],
    )
    return ocean_gen_data, atmos_gen_data


# Offset added to the distributed/eval seed for the per-batch objective RNG.
# Chosen as 685 -- one past TimeLengthProbabilities' reserved 684, and distinct
# from the small per-schedule offsets (0, 1) used by seed_rng, so the objective
# RNG never shares a seed with an n_steps sampler.
_OBJECTIVE_RNG_OFFSET = 685

Realm = Literal["ocean", "atmosphere"]
_REALMS: tuple[Realm, ...] = ("ocean", "atmosphere")
Objective = Literal["ocean", "atmosphere", "joint"]


@dataclasses.dataclass
class ObjectivePerBatchConfig:
    """Per-batch objective draw weights for coupled training.

    Each batch optimizes one objective, drawn with probability proportional to
    its weight among the objectives with a loss that batch. An absent key has
    weight 0, so that objective is never optimized.

    Parameters:
        atmosphere: Weight of the atmosphere objective (its schedule's losses).
        ocean: Weight of the ocean objective (its schedule's losses).
        joint: Weight of the joint objective (the loss of one pair drawn from
            ``joint_pairs``); > 0 requires ``joint_pairs``.
    """

    atmosphere: float = 0.0
    ocean: float = 0.0
    joint: float = 0.0

    def __post_init__(self):
        weights = self.as_dict()
        negative = [name for name, w in weights.items() if w < 0]
        if negative:
            raise ValueError(
                f"objective_per_batch weights must be >= 0, got negative {negative}."
            )
        if sum(weights.values()) <= 0:
            raise ValueError("objective_per_batch needs at least one weight > 0.")

    def as_dict(self) -> dict[Objective, float]:
        return {"ocean": self.ocean, "atmosphere": self.atmosphere, "joint": self.joint}


class CoupledStepperTrainLoss:
    """Owns per-component loss computation *and* the rollout schedule
    (which steps are optimized, how many outer steps are required).
    """

    def __init__(
        self,
        ocean_loss: StepLoss,
        atmosphere_loss: StepLoss,
        ocean_schedule: ComponentLossSchedule,
        atmosphere_schedule: ComponentLossSchedule,
        objective_weights: ObjectivePerBatchConfig | None = None,
        joint_pairs: Sequence[JointPair] = (),
    ):
        self._loss_objs: dict[str, StepLoss] = {
            "ocean": ocean_loss,
            "atmosphere": atmosphere_loss,
        }
        self._schedules = {
            "ocean": ocean_schedule,
            "atmosphere": atmosphere_schedule,
        }
        self._weights = {
            "ocean": ocean_schedule.loss_weight,
            "atmosphere": atmosphere_schedule.loss_weight,
        }
        # Two RNGs mirror ComponentLossSchedule's train / eval sampler split, so
        # the validation loss follows the training objective mix yet replays.
        self._objective_weights = (
            None if objective_weights is None else objective_weights.as_dict()
        )
        self._objective_rng: np.random.RandomState | None = None
        self._eval_objective_rng: np.random.RandomState | None = None
        self._joint_pairs = list(joint_pairs)
        self._schedule_realms: frozenset[Realm] = frozenset(_REALMS)
        self._joint_drawn: bool = False
        self._joint_pair: JointPair | None = None
        self._is_training: bool = True

    def sample_from_rng(self) -> None:
        """Draw this batch's per-component rollout window, then its objective,
        then its joint pair.

        The single public entry point for per-batch RNG draws: the objective's
        per-batch null check must see the freshly sampled window.
        """
        self._sample_n_steps()
        self._draw_objective()
        self._draw_joint_pair()

    def _sample_n_steps(self) -> None:
        for schedule in self._schedules.values():
            schedule.sample_n_steps()

    def seed_rng(self, seed: int) -> None:
        """Reseed the eval-only RNGs deterministically.

        Reseeds the per-schedule eval n_steps samplers and the eval objective
        RNG, so each validation pass replays the same draws regardless of the
        training RNG position. Training RNGs are distributed-seeded lazily and
        are left untouched.
        """
        for i, schedule in enumerate(self._schedules.values()):
            schedule.seed_rng(seed + i)
        self._eval_objective_rng = np.random.RandomState(seed + _OBJECTIVE_RNG_OFFSET)

    def _get_objective_rng(self) -> np.random.RandomState:
        """The training RNG is seeded lazily from the distributed seed, the same
        on every rank, mirroring ``TimeLengthProbabilities.initialize_rng``. Its
        position is not checkpointed, so the training sequence does not survive
        preemption/resume, same as the random n_steps sampler.
        """
        if self._is_training:
            if self._objective_rng is None:
                self._objective_rng = np.random.RandomState(
                    Distributed.get_instance().get_seed() + _OBJECTIVE_RNG_OFFSET
                )
            return self._objective_rng
        if self._eval_objective_rng is None:
            # The validation loop calls seed_eval before each pass.
            self._eval_objective_rng = np.random.RandomState(_OBJECTIVE_RNG_OFFSET)
        return self._eval_objective_rng

    def _draw_objective(self) -> None:
        """Draw which objective this batch optimizes.

        Weights absent: every realm's schedule, plus a joint pair if
        ``joint_pairs`` is set. Present: one objective among those with
        weight > 0 and a loss this batch, drawn by normalized weight; none
        eligible means no loss this batch. Applies in train and eval.
        """
        if self._objective_weights is None:
            self._schedule_realms = frozenset(_REALMS)
            self._joint_drawn = len(self._joint_pairs) > 0
            return
        eligible = [
            objective
            for objective, weight in self._objective_weights.items()
            if weight > 0 and self._objective_has_loss(objective)
        ]
        if len(eligible) <= 1:
            drawn = eligible
        else:
            weights = np.array([self._objective_weights[o] for o in eligible])
            rng = self._get_objective_rng()
            index = int(rng.choice(len(eligible), p=weights / weights.sum()))
            drawn = [eligible[index]]
        self._schedule_realms = frozenset(r for r in _REALMS if r in drawn)
        self._joint_drawn = "joint" in drawn

    def _objective_has_loss(self, objective: Objective) -> bool:
        if objective == "joint":
            return len(self._joint_pairs) > 0
        return self._schedules[objective].n_required_forward_steps() > 0

    def _draw_joint_pair(self) -> None:
        if not self._joint_drawn:
            self._joint_pair = None
            return
        rng = self._get_objective_rng()
        self._joint_pair = self._joint_pairs[rng.randint(len(self._joint_pairs))]

    @property
    def joint_pair(self) -> JointPair | None:
        """This batch's pair; None when ``L_joint`` is not in the batch."""
        return self._joint_pair

    def joint_role(self, realm: Realm, step: int) -> Literal["earlier", "later"] | None:
        if self._joint_pair is None:
            return None
        return self._joint_pair.role(realm, step)

    def set_train(self) -> None:
        self._is_training = True
        for schedule in self._schedules.values():
            schedule.set_train()

    def set_eval(self) -> None:
        self._is_training = False
        for schedule in self._schedules.values():
            schedule.set_eval()

    def n_required_outer_steps(self, n_inner_steps: int) -> int:
        """Minimum number of outer (ocean) steps needed so that every
        component step contributing to the current batch's loss is computed.

        Callers must invoke ``sample_from_rng()`` beforehand for stochastic
        configs so the value reflects the current batch.
        """
        ocean_required = self._schedules["ocean"].n_required_forward_steps()
        atmos_required = self._schedules["atmosphere"].n_required_forward_steps()
        atmos_outer = -(-atmos_required // n_inner_steps)  # ceil division
        pair_outer = 0 if self._joint_pair is None else self._joint_pair.n_outer_steps
        return max(ocean_required, atmos_outer, pair_outer)

    def step_is_optimized(
        self,
        realm: Literal["ocean", "atmosphere"],
        step: int,
    ) -> bool:
        if self.joint_role(realm, step) is not None:
            return True
        if realm not in self._schedule_realms:
            return False
        return self._schedules[realm].step_is_optimized(step)

    def _weighted_step_loss(
        self,
        prediction: ComponentEnsembleStepPrediction,
        target_data: TensorMapping,
    ) -> torch.Tensor:
        realm = prediction.realm
        weight = self._weights[realm]
        if weight == 0.0:
            return torch.tensor(0.0, device=fme.get_device())
        loss_output = self._loss_objs[realm](
            prediction.data, target_data, prediction.step
        )
        return weight * loss_output.total()

    def compute_loss(
        self,
        prediction: ComponentEnsembleStepPrediction,
        target_data: TensorMapping,
    ) -> torch.Tensor:
        realm = prediction.realm
        # The objective does not gate this, so per-step diagnostic metrics
        # cover both realms whatever the objective; a pair step always counts.
        if self.joint_role(realm, prediction.step) is None and not self._schedules[
            realm
        ].step_is_optimized(prediction.step):
            return torch.tensor(0.0, device=fme.get_device())
        return self._weighted_step_loss(prediction, target_data)

    def __call__(
        self,
        prediction: ComponentEnsembleStepPrediction,
        target_data: TensorMapping,
    ) -> torch.Tensor | None:
        if not self.step_is_optimized(prediction.realm, prediction.step):
            return None
        return self._weighted_step_loss(prediction, target_data)


@dataclasses.dataclass
class ComponentTrainingConfig:
    """Configuration for one component's training behavior within a coupled
    stepper.

    Parameters:
        loss: The step loss function configuration (e.g. MSE, EnsembleLoss).
        n_steps: Number of consecutive component steps in the optimization
            window, starting from the component's first step after the initial
            condition. Can be an int, ``None`` (the default, meaning all
            available steps), or a ``TimeLengthProbabilities`` for stochastic
            per-batch sampling.
        optimize_last_step_only: If True, only the last step within the
            training horizon defined by ``n_steps`` is optimized (i.e.
            contributes to the loss and has gradients enabled).
        loss_weight: Weight applied to the loss for this component.
        parameter_init: Component-level parameter initialization.
    """

    loss: StepLossConfig
    n_steps: TimeLengthProbabilities | int | None = None
    optimize_last_step_only: bool = False
    loss_weight: float = 1.0
    parameter_init: ParameterInitializationConfig = dataclasses.field(
        default_factory=lambda: ParameterInitializationConfig()
    )

    @property
    def n_steps_max(self) -> int | None:
        """Upper bound on the number of consecutive steps that can contribute
        to the loss, or ``None`` if unbounded (``n_steps=None``).

        For ``TimeLengthProbabilities`` this is the largest value the sampler
        can produce.
        """
        if self.n_steps is None:
            return None
        if isinstance(self.n_steps, TimeLengthProbabilities):
            return self.n_steps.max_n_forward_steps
        return self.n_steps

    @property
    def loss_is_null(self) -> bool:
        """True when this component contributes nothing to the total loss."""
        if self.loss_weight == 0.0:
            return True
        if isinstance(self.n_steps_max, int) and self.n_steps_max == 0:
            return True
        return False


@dataclasses.dataclass
class CoupledTrainStepperConfig:
    """Configuration for training-specific aspects of a coupled stepper.

    Parameters:
        n_coupled_steps: Number of forward coupled steps in the optimization.
        ocean: The configuration for the ocean component.
        atmosphere: The configuration for the atmosphere component.
        n_ensemble: The number of ensemble members evaluated for each training
            batch member. Default is 2 if ocean or atmosphere loss type is
            EnsembleLoss, otherwise the default is 1. Must be 2 for EnsembleLoss
            to be valid.
        joint_pairs: 1-indexed ``[i_O, i_A]`` ocean/atmosphere step pairs. A
            batch optimizing the joint objective draws one pair uniformly from
            this list (a repeated pair is drawn more often) and optimizes the
            sum of the pair's two step losses with the gradient flowing across
            the pair's direct edge: the atmosphere step must lie in the ocean
            step's forcing window or the next one. Without
            ``objective_per_batch``, every batch adds one pair's loss to the
            schedules' losses.
        objective_per_batch: If set, each ``train_on_batch`` call optimizes
            one objective, drawn by these weights among the objectives with a
            loss that batch. The draw applies in validation too, from a
            separate, deterministically seeded RNG, so the validation loss
            follows the training objective mix. A positive weight on a
            statically null realm is rejected. Default None optimizes every
            realm's schedule each batch.
        optimize_single_component_per_batch: Deprecated; ``True`` is mapped to
            ``objective_per_batch={atmosphere: 1, ocean: 1}``.
        parameter_init: The coupled parameter initialization configuration for
            fine-tuning a previously-trained coupled stepper.
    """

    n_coupled_steps: int
    ocean: ComponentTrainingConfig
    atmosphere: ComponentTrainingConfig
    n_ensemble: int = -1  # sentinel value to avoid None typing of attribute
    joint_pairs: list[list[int]] | None = None
    objective_per_batch: ObjectivePerBatchConfig | None = None
    optimize_single_component_per_batch: bool = False
    parameter_init: CoupledParameterInitConfig = dataclasses.field(
        default_factory=lambda: CoupledParameterInitConfig()
    )

    def __post_init__(self):
        """Validate that parameter_init is not specified in conflicting ways.

        Raises ValueError if CoupledParameterInitConfig.checkpoint_path is set
        alongside component-level weights_path values.
        """
        if self.parameter_init.checkpoint_path is not None:
            if (
                self.atmosphere.parameter_init.weights_path is not None
                or self.ocean.parameter_init.weights_path is not None
            ):
                raise ValueError(
                    "Please specify CoupledParameterInitConfig.checkpoint_path "
                    "or the component training configs' "
                    "ParameterInitializationConfig.weights_path, but not both."
                )
        if self.ocean.loss_is_null and self.atmosphere.loss_is_null:
            raise ValueError(
                "At least one of ocean or atmosphere loss must be "
                "non-null (non-zero loss_weight and non-zero n_steps)."
            )
        if self.optimize_single_component_per_batch:
            if self.objective_per_batch is not None:
                raise ValueError(
                    "Set objective_per_batch or the deprecated "
                    "optimize_single_component_per_batch, not both."
                )
            warnings.warn(
                "optimize_single_component_per_batch is deprecated; use "
                "objective_per_batch: {atmosphere: 1, ocean: 1}.",
                DeprecationWarning,
            )
            self.objective_per_batch = ObjectivePerBatchConfig(
                atmosphere=1.0, ocean=1.0
            )
            # Reset so dataclasses.replace on this config does not raise.
            self.optimize_single_component_per_batch = False
        if self.joint_pairs is not None:
            malformed = [
                pair
                for pair in self.joint_pairs
                if len(pair) != 2 or any(index < 1 for index in pair)
            ]
            if not self.joint_pairs or malformed:
                raise ValueError(
                    "joint_pairs must be a non-empty list of [i_O, i_A] pairs of "
                    f"1-indexed steps, got {self.joint_pairs}."
                )
        if self.objective_per_batch is not None:
            if self.objective_per_batch.joint > 0 and self.joint_pairs is None:
                raise ValueError("objective_per_batch.joint > 0 requires joint_pairs.")
            component_configs: dict[Realm, ComponentTrainingConfig] = {
                "ocean": self.ocean,
                "atmosphere": self.atmosphere,
            }
            null_realms = [
                realm
                for realm, config in component_configs.items()
                if self.objective_per_batch.as_dict()[realm] > 0 and config.loss_is_null
            ]
            if null_realms:
                raise ValueError(
                    f"objective_per_batch gives a positive weight to {null_realms}, "
                    "whose loss is statically null (zero loss_weight or zero "
                    "n_steps); that objective would never be drawn."
                )
        if self.n_ensemble == -1:
            use_ensemble_loss = "EnsembleLoss" in (
                self.ocean.loss.type,
                self.atmosphere.loss.type,
            )
            if use_ensemble_loss:
                self.n_ensemble = 2
            else:
                self.n_ensemble = 1

    @property
    def component_n_steps_max(self) -> CoupledOptionalInt:
        """Per-component upper bound on optimized loss steps, or ``None`` if
        unbounded. Used by ``TrainConfig`` to validate compatibility with
        ``CoupledStepperConfig.n_inner_steps`` and ``self.n_coupled_steps``.
        """
        return CoupledOptionalInt(
            ocean=self.ocean.n_steps_max,
            atmosphere=self.atmosphere.n_steps_max,
        )

    def get_train_window_data_requirements(
        self,
        stepper_config: CoupledStepperConfig,
    ) -> CoupledTrainDataRequirements:
        """Data requirements for the coupled training loader.

        Atmosphere target variables are loaded for the loss horizon plus the
        initial condition timestep; atmosphere forcing variables are loaded
        for the full rollout. Beyond the target horizon, target variables are
        NaN-padded by the dataset wrapper. Trailing NaNs are never consumed
        by the loss (loss is skipped for non-optimized steps) or by the
        forward pass (forcings come from a disjoint variable set).

        When the atmosphere loss has unbounded ``n_steps`` (``None``), the
        target horizon collapses to the full rollout length, recovering the
        previous behavior. Otherwise it also covers the largest atmosphere
        step in ``joint_pairs``.

        Args:
            stepper_config: The coupled stepper config, used for variable
                names and timesteps.

        """
        long_atmos_n = self.n_coupled_steps * stepper_config.n_inner_steps + 1
        atmos_n_steps_max = self.component_n_steps_max.atmosphere
        if atmos_n_steps_max is None:
            short_atmos_n = long_atmos_n
        else:
            max_pair_atmos_step = max(
                (pair[1] for pair in self.joint_pairs or ()), default=0
            )
            # +1 for n_ic_timesteps (asserted to be 1 in CoupledStepper.__init__)
            short_atmos_n = max(atmos_n_steps_max, max_pair_atmos_step) + 1
        forcing_names = list(stepper_config.atmosphere_forcing_exogenous_names)
        target_names = list(
            set(stepper_config.all_names.atmosphere) - set(forcing_names)
        )
        return CoupledTrainDataRequirements(
            ocean_timestep=stepper_config.ocean_timestep,
            ocean_requirements=DataRequirements(
                names=stepper_config.all_names.ocean,
                n_timesteps=self.n_coupled_steps + 1,
            ),
            atmosphere_timestep=stepper_config.atmosphere_timestep,
            atmosphere_target_requirements=DataRequirements(
                names=target_names, n_timesteps=short_atmos_n
            ),
            atmosphere_forcing_requirements=DataRequirements(
                names=forcing_names, n_timesteps=long_atmos_n
            ),
        )

    def _build_loss(
        self, stepper: CoupledStepper, n_coupled_steps: int
    ) -> CoupledStepperTrainLoss:
        ocean_step_loss = stepper.ocean.build_loss(self.ocean.loss)
        atmos_step_loss = stepper.atmosphere.build_loss(self.atmosphere.loss)
        n_steps_limit_ocean = n_coupled_steps
        n_steps_limit_atmos = n_coupled_steps * stepper.n_inner_steps
        ocean_schedule = ComponentLossSchedule(
            n_steps=self.ocean.n_steps,
            optimize_last_step_only=self.ocean.optimize_last_step_only,
            loss_weight=self.ocean.loss_weight,
            n_steps_limit=n_steps_limit_ocean,
        )
        atmos_schedule = ComponentLossSchedule(
            n_steps=self.atmosphere.n_steps,
            optimize_last_step_only=self.atmosphere.optimize_last_step_only,
            loss_weight=self.atmosphere.loss_weight,
            n_steps_limit=n_steps_limit_atmos,
        )
        return CoupledStepperTrainLoss(
            ocean_loss=ocean_step_loss,
            atmosphere_loss=atmos_step_loss,
            ocean_schedule=ocean_schedule,
            atmosphere_schedule=atmos_schedule,
            objective_weights=self.objective_per_batch,
            joint_pairs=[
                JointPair.from_config(pair, stepper.n_inner_steps)
                for pair in self.joint_pairs or ()
            ],
        )

    def get_train_stepper(
        self,
        stepper_config: CoupledStepperConfig,
        dataset_info: CoupledDatasetInfo,
    ) -> "CoupledTrainStepper":
        """
        Build a CoupledTrainStepper from this configuration.

        Args:
            stepper_config: The CoupledStepper configuration.
            dataset_info: Information about the coupled training datasets.

        Returns:
            A CoupledTrainStepper wrapping the given or built stepper with
            training functionality.
        """
        loaders = self.parameter_init.build_weights_and_history_loaders()
        ocean_initializer = self.ocean.parameter_init.build(
            load_weights_and_history=loaders.ocean,
        )
        atmosphere_initializer = self.atmosphere.parameter_init.build(
            load_weights_and_history=loaders.atmosphere,
        )
        stepper = stepper_config.get_stepper(
            dataset_info=dataset_info,
            ocean_parameter_initializer=ocean_initializer,
            atmosphere_parameter_initializer=atmosphere_initializer,
        )
        return CoupledTrainStepper(
            stepper=stepper,
            config=self,
        )


class CoupledTrainStepper(
    TrainStepperABC[
        CoupledPrognosticState,
        CoupledBatchData,
        CoupledBatchData,
        CoupledPairedData,
        CoupledTrainOutput,
    ],
):
    """Wrapper around CoupledStepper that adds training functionality.

    This class composes a CoupledStepper (for inference) with training-specific
    loss configuration and implements the train_on_batch method.

    Stochastic training assumptions (n_ensemble > 1):
        Ensemble training broadcasts each batch member into n_ensemble copies
        along the batch dimension; the copies receive identical inputs, so
        divergent outputs depend entirely on model stochasticity (e.g., noise
        conditioning).

        We currently assume that the atmosphere component is stochastic. If it
        is not, the first n_inner_steps atmosphere steps (before the first ocean
        step) will produce identical outputs across ensemble members, doubling
        compute with no benefit.

        On the other hand, even when the ocean component itself is deterministic,
        its optimization is effectively stochastic so long as the atmosphere is
        stochastic: the ocean receives atmosphere-averaged forcings that differ
        across ensemble members.

    """

    def __init__(
        self,
        stepper: CoupledStepper,
        config: CoupledTrainStepperConfig,
    ):
        """
        Args:
            stepper: The underlying coupled stepper for inference operations.
            config: The train stepper config.
        """
        self._stepper = stepper
        self._config = config
        self._loss = self._config._build_loss(stepper, config.n_coupled_steps)

    @property
    def ocean(self) -> Stepper:
        return self._stepper.ocean

    @property
    def atmosphere(self) -> Stepper:
        return self._stepper.atmosphere

    @property
    def modules(self) -> nn.ModuleList:
        return self._stepper.modules

    @property
    def optimization_modules(self) -> dict[str, nn.ModuleList]:
        # key order matches CoupledStepper.modules, so the single-form
        # optimization flattens to the same parameter order as today
        return {
            "atmosphere": self.atmosphere.modules,
            "ocean": self.ocean.modules,
        }

    @property
    def n_ic_timesteps(self) -> int:
        return self._stepper.n_ic_timesteps

    @property
    def n_inner_steps(self) -> int:
        """Number of atmosphere steps per ocean step."""
        return self._stepper.n_inner_steps

    def predict_paired(
        self,
        initial_condition: CoupledPrognosticState,
        forcing: CoupledBatchData,
        compute_derived_variables: bool = False,
    ) -> tuple[CoupledPairedData, CoupledPrognosticState]:
        return self._stepper.predict_paired(
            initial_condition, forcing, compute_derived_variables
        )

    def seed_eval(self, seed: int) -> None:
        self._loss.seed_rng(seed)

    def set_train(self):
        self._stepper.set_train()
        self._loss.set_train()

    def set_eval(self):
        self._stepper.set_eval()
        self._loss.set_eval()

    def set_epoch(self, epoch: int) -> None:
        self._stepper.set_epoch(epoch)

    def get_state(self) -> dict[str, Any]:
        return self._stepper.get_state()

    def load_state(self, state: dict[str, Any]):
        self._stepper.load_state(state)

    def update_training_history(self, training_job: TrainingJob) -> None:
        self._stepper.update_training_history(training_job)

    def _accumulate_step_loss(
        self,
        gen_step: ComponentStepPrediction,
        forward_data: TensorMapping,
        time_dim: int,
        n_ensemble: int,
        optimization: OptimizationABC,
        metrics: ComponentStepMetrics,
        output_list: list[ComponentEnsembleStepPrediction],
        held_earlier_loss: list[torch.Tensor],
        evaluate_all_steps: bool = False,
    ) -> None:
        """Compute one step's loss and accumulate it.

        A joint pair's earlier-step loss is appended to ``held_earlier_loss``
        instead, and accumulated together with the later-step loss, so one
        backward of ``L_joint`` reaches both components under gradient
        accumulation.
        """
        target_step = {
            k: v.select(time_dim, gen_step.step) for k, v in forward_data.items()
        }
        ensemble_step = ComponentEnsembleStepPrediction(
            realm=gen_step.realm,
            data=unfold_ensemble_dim(gen_step.data, n_ensemble),
            step=gen_step.step,
        )
        target_step_ensemble = add_ensemble_dim(target_step)
        label = f"loss/{gen_step.realm}_step_{gen_step.step}"
        optimized_loss: torch.Tensor | None
        if evaluate_all_steps:
            step_loss = self._loss.compute_loss(ensemble_step, target_step_ensemble)
            metrics.add_metric(label, step_loss.detach(), gen_step.realm)
            optimized = self._loss.step_is_optimized(gen_step.realm, gen_step.step)
            optimized_loss = step_loss if optimized else None
        else:
            optimized_loss = self._loss(ensemble_step, target_step_ensemble)
            if optimized_loss is not None:
                metrics.add_metric(label, optimized_loss.detach(), gen_step.realm)
        if optimized_loss is not None:
            role = self._loss.joint_role(gen_step.realm, gen_step.step)
            if role == "earlier":
                held_earlier_loss.append(optimized_loss)
            elif role == "later" and held_earlier_loss:
                optimization.accumulate_loss(held_earlier_loss.pop() + optimized_loss)
            else:
                optimization.accumulate_loss(optimized_loss)
        output_list.append(
            ensemble_step.detach_if_using_gradient_accumulation(
                optimization
            )  # eagerly detach
        )

    def _accumulate_loss(
        self,
        data: CoupledBatchData,
        ocean_forward_data: BatchData,
        atmos_forward_data: BatchData,
        optimization: OptimizationABC,
        metrics: ComponentStepMetrics,
        evaluate_all_steps: bool = False,
    ) -> list[ComponentEnsembleStepPrediction]:
        n_ensemble = self._config.n_ensemble
        data_ensemble = CoupledBatchData(
            ocean_data=data.ocean_data.broadcast_ensemble(n_ensemble),
            atmosphere_data=data.atmosphere_data.broadcast_ensemble(n_ensemble),
        )
        # get initial condition prognostic variables
        input_data = CoupledPrognosticState(
            atmosphere_data=data_ensemble.atmosphere_data.get_start(
                self.atmosphere.prognostic_names, self.n_ic_timesteps
            ),
            ocean_data=data_ensemble.ocean_data.get_start(
                self.ocean.prognostic_names, self.n_ic_timesteps
            ),
        )
        output_generator = self._stepper.get_prediction_generator(
            input_data,
            data_ensemble,
            optimization,
            joint_pair=self._loss.joint_pair,
        )
        output_iterator = iter(output_generator)
        output_list: list[ComponentEnsembleStepPrediction] = []
        held_earlier_loss: list[torch.Tensor] = []
        n_outer_steps_data = data.ocean_data.n_timesteps - self.n_ic_timesteps
        if evaluate_all_steps:
            n_outer_steps = n_outer_steps_data
        else:
            # Clamp to at least 1 outer step so downstream gen_data is non-empty
            # in the rare case where stochastic samplers yield n_steps=0 for both
            # realms; that batch contributes zero loss but a valid TrainOutput.
            n_outer_steps = min(
                n_outer_steps_data,
                max(1, self._loss.n_required_outer_steps(self.n_inner_steps)),
            )
        for i_outer in range(n_outer_steps):
            for i_inner in range(self.n_inner_steps):
                global_atmos_step = i_outer * self.n_inner_steps + i_inner
                optimize = self._loss.step_is_optimized(
                    "atmosphere",
                    global_atmos_step,
                )
                grad_context = contextlib.nullcontext() if optimize else torch.no_grad()
                with grad_context:
                    gen_step = next(output_iterator)
                    assert (
                        gen_step.realm == "atmosphere"
                        and gen_step.step == global_atmos_step
                    )
                    self._accumulate_step_loss(
                        gen_step=gen_step,
                        forward_data=atmos_forward_data.data,
                        time_dim=self.atmosphere.TIME_DIM,
                        n_ensemble=n_ensemble,
                        optimization=optimization,
                        metrics=metrics,
                        output_list=output_list,
                        held_earlier_loss=held_earlier_loss,
                        evaluate_all_steps=evaluate_all_steps,
                    )
            optimize = self._loss.step_is_optimized("ocean", i_outer)
            grad_context = contextlib.nullcontext() if optimize else torch.no_grad()
            with grad_context:
                gen_step = next(output_iterator)
                assert gen_step.realm == "ocean" and gen_step.step == i_outer
                self._accumulate_step_loss(
                    gen_step=gen_step,
                    forward_data=ocean_forward_data.data,
                    time_dim=self.ocean.TIME_DIM,
                    n_ensemble=n_ensemble,
                    optimization=optimization,
                    metrics=metrics,
                    output_list=output_list,
                    held_earlier_loss=held_earlier_loss,
                    evaluate_all_steps=evaluate_all_steps,
                )
        # A pair whose later step lies past the data window contributes
        # L_earlier alone.
        for loss in held_earlier_loss:
            optimization.accumulate_loss(loss)

        return output_list

    def train_on_batch(
        self,
        data: CoupledBatchData,
        optimization: OptimizationABC,
        compute_derived_variables: bool = False,
        evaluate_all_steps: bool = False,
    ) -> CoupledTrainOutput:
        """
        Args:
            data: The coupled batch data, consisting of separate batches for ocean and
                atmosphere with the same initial condition time.
            optimization: The optimization class to use for updating the module.
                Use `NullOptimization` to disable training.
            compute_derived_variables: Whether to compute derived variables for the
                prediction and target atmosphere data.
            evaluate_all_steps: When True, run all available forward steps and
                compute per-step metrics for each, but only count steps within
                the stochastically-sampled range toward the accumulated loss.

        """
        atmos_forward_data = self.atmosphere.get_forward_data(
            data.atmosphere_data,
            compute_derived_variables=False,
        )
        ocean_forward_data = self.ocean.get_forward_data(
            data.ocean_data,
            compute_derived_variables=False,
        )

        metrics = ComponentStepMetrics()
        # Draws this batch's rollout window, then its objective.
        self._loss.sample_from_rng()
        optimization.set_mode(self.modules)
        with optimization.autocast():
            output_list = self._accumulate_loss(
                data,
                ocean_forward_data,
                atmos_forward_data,
                optimization,
                metrics,
                evaluate_all_steps=evaluate_all_steps,
            )

        loss = optimization.get_accumulated_loss().detach()
        optimization.step_weights()

        ocean_gen_data, atmos_gen_data = _process_ensemble_output_list(
            output_list
        )  # NOTE: must call AFTER optimization.step_weights()

        ocean_stepped = TrainOutput(
            metrics=metrics.get_ocean_metrics(),
            gen_data=ocean_gen_data,
            target_data=add_ensemble_dim(dict(ocean_forward_data.data)),
            time=ocean_forward_data.time,
            normalize=self.ocean.normalizer.normalize,
            derive_func=self.ocean.derive_func,
        )
        atmos_stepped = TrainOutput(
            metrics=metrics.get_atmosphere_metrics(),
            gen_data=atmos_gen_data,
            target_data=add_ensemble_dim(dict(atmos_forward_data.data)),
            time=atmos_forward_data.time,
            normalize=self.atmosphere.normalizer.normalize,
            derive_func=self.atmosphere.derive_func,
        )

        stepped = CoupledTrainOutput(
            total_metrics={"loss": loss},
            ocean=ocean_stepped,
            atmosphere=atmos_stepped,
        )

        # prepend initial conditions
        ocean_data = data.ocean_data
        atmos_data = data.atmosphere_data
        ocean_ic = ocean_data.get_start(
            set(ocean_data.data.keys()), self.n_ic_timesteps
        )
        # TODO: different n_ic_timesteps for atmosphere?
        atmos_ic = atmos_data.get_start(
            set(atmos_data.data.keys()), self.n_ic_timesteps
        )
        ic = CoupledPrognosticState(ocean_data=ocean_ic, atmosphere_data=atmos_ic)
        stepped = stepped.prepend_initial_condition(ic)

        if compute_derived_variables:
            stepped = stepped.compute_derived_variables()

        return stepped


def load_coupled_stepper(
    checkpoint_path: str | pathlib.Path, use_ema_if_available: bool = False
) -> CoupledStepper:
    logging.info(f"Loading trained coupled model checkpoint from {checkpoint_path}")
    checkpoint = torch.load(checkpoint_path, map_location="cpu", weights_only=False)
    stepper = CoupledStepper.from_state(checkpoint["stepper"])
    if use_ema_if_available:
        load_ema_params_if_available(checkpoint, stepper.modules, str(checkpoint_path))
    return stepper
