ai2cm/ace/configs/baselines/amip-c96-shield/train-baseline.yaml

# arg: --dataset andrep/2024-07-24-vertically-resolved-c96-1deg-shield-amip-ensemble-dataset-stats:/statsdata
# arg: --dataset brianhenn/2024-07-24-vertically-resolved-c96-1deg-shield-amip-monthly-reference:/refdata
experiment_dir: /results
save_checkpoint: true
validate_using_ema: true
max_epochs: 120
ema:
  decay: 0.999
inference:
  - n_forward_steps: 7300
    forward_steps_in_memory: 40
    loader:
      start_indices:
        times:
          - '1986-01-01T00:00:00'
          - '1987-04-01T00:00:00'
          - '1988-07-01T00:00:00'
          - '1989-10-01T00:00:00'
          - '1991-01-01T00:00:00'
          - '1992-04-01T00:00:00'
          - '1993-07-01T00:00:00'
          - '1994-10-01T00:00:00'
      dataset:
        data_path: /climate-default/2024-07-24-vertically-resolved-c96-1deg-shield-amip-ensemble-dataset/netCDFs/ic_0002
      num_data_workers: 4
    aggregator:
      histogram:
        enabled: true
      time_mean_reference_data: /statsdata/time-mean.nc
      monthly_reference_data: /refdata/monthly_mean_data.nc
logging:
  log_to_screen: true
  log_to_wandb: true
  log_to_file: true
  project: ace
  entity: ai2cm
train_loader:
  batch_size: 8
  num_data_workers: 4
  prefetch_factor: 4
  dataset:
    concat:
      - data_path: /climate-default/2024-07-24-vertically-resolved-c96-1deg-shield-amip-ensemble-dataset/netCDFs/ic_0001
      - data_path: /climate-default/2024-07-24-vertically-resolved-c96-1deg-shield-amip-ensemble-dataset/netCDFs/ic_0002
        subset:
          stop_time: '1985-12-31'
      - data_path: /climate-default/2024-07-24-vertically-resolved-c96-1deg-shield-amip-ensemble-dataset/netCDFs/ic_0002
        subset:
          start_time: '2011-01-01'
validation:
  loader:
    batch_size: 64
    num_data_workers: 4
    prefetch_factor: 4
    dataset:
      concat:
        - data_path: /climate-default/2024-07-24-vertically-resolved-c96-1deg-shield-amip-ensemble-dataset/netCDFs/ic_0002
          subset:
            start_time: '1996-01-01'
            stop_time: '2000-12-31'
optimization:
  enable_automatic_mixed_precision: false
  lr: 0.0001
  optimizer_type: AdamW
  kwargs:
    fused: true
    weight_decay: 0.01
stepper_training:
  n_forward_steps: 2
  loss:
    type: MSE
    weights:
      air_temperature_0: 0.5
      air_temperature_1: 0.5
      eastward_wind_0: 0.5
      northward_wind_0: 0.5
      specific_total_water_0: 0.5
      specific_total_water_1: 0.25
      specific_total_water_2: 0.5
      PRATEsfc: 0.5
      h500: 10
      TMP850: 5
      Q2m: 0.5
      DLWRFsfc: 2
      ULWRFsfc: 5
      USWRFsfc: 2
      DSWRFsfc: 2
      USWRFtoa: 2
      tendency_of_total_water_path_due_to_advection: 0.5
stepper:
  step:
    type: single_module
    config:
      builder:
        type: NoiseConditionedSFNO
        config:
          embed_dim: 384
          noise_embed_dim: 0
          filter_type: linear
          use_mlp: true
          num_layers: 8
          affine_norms: true
          normalize_big_skip: true
      normalization:
        network:
          global_means_path: /statsdata/centering.nc
          global_stds_path: /statsdata/scaling-full-field.nc
        residual:
          global_means_path: /statsdata/centering.nc
          global_stds_path: /statsdata/scaling-residual.nc
      ocean:
        surface_temperature_name: surface_temperature
        ocean_fraction_name: ocean_fraction
      corrector:
        conserve_dry_air: true
        moisture_budget_correction: advection_and_precipitation
        force_positive_names:
        - specific_total_water_0
        - specific_total_water_1
        - specific_total_water_2
        - specific_total_water_3
        - specific_total_water_4
        - specific_total_water_5
        - specific_total_water_6
        - specific_total_water_7
        - Q2m
        - PRATEsfc
        - ULWRFsfc
        - ULWRFtoa
        - DLWRFsfc
        - DSWRFsfc
        - USWRFsfc
        - USWRFtoa
      next_step_forcing_names:
      - DSWRFtoa
      in_names:
      - land_fraction
      - ocean_fraction
      - sea_ice_fraction
      - DSWRFtoa
      - HGTsfc
      - global_mean_co2
      - PRESsfc
      - surface_temperature
      - TMP2m
      - Q2m
      - UGRD10m
      - VGRD10m
      - air_temperature_0
      - air_temperature_1
      - air_temperature_2
      - air_temperature_3
      - air_temperature_4
      - air_temperature_5
      - air_temperature_6
      - air_temperature_7
      - specific_total_water_0
      - specific_total_water_1
      - specific_total_water_2
      - specific_total_water_3
      - specific_total_water_4
      - specific_total_water_5
      - specific_total_water_6
      - specific_total_water_7
      - eastward_wind_0
      - eastward_wind_1
      - eastward_wind_2
      - eastward_wind_3
      - eastward_wind_4
      - eastward_wind_5
      - eastward_wind_6
      - eastward_wind_7
      - northward_wind_0
      - northward_wind_1
      - northward_wind_2
      - northward_wind_3
      - northward_wind_4
      - northward_wind_5
      - northward_wind_6
      - northward_wind_7
      out_names:
      - PRESsfc
      - surface_temperature
      - TMP2m
      - Q2m
      - UGRD10m
      - VGRD10m
      - air_temperature_0
      - air_temperature_1
      - air_temperature_2
      - air_temperature_3
      - air_temperature_4
      - air_temperature_5
      - air_temperature_6
      - air_temperature_7
      - specific_total_water_0
      - specific_total_water_1
      - specific_total_water_2
      - specific_total_water_3
      - specific_total_water_4
      - specific_total_water_5
      - specific_total_water_6
      - specific_total_water_7
      - eastward_wind_0
      - eastward_wind_1
      - eastward_wind_2
      - eastward_wind_3
      - eastward_wind_4
      - eastward_wind_5
      - eastward_wind_6
      - eastward_wind_7
      - northward_wind_0
      - northward_wind_1
      - northward_wind_2
      - northward_wind_3
      - northward_wind_4
      - northward_wind_5
      - northward_wind_6
      - northward_wind_7
      - LHTFLsfc
      - SHTFLsfc
      - PRATEsfc
      - ULWRFsfc
      - ULWRFtoa
      - DLWRFsfc
      - DSWRFsfc
      - USWRFsfc
      - USWRFtoa
      - tendency_of_total_water_path_due_to_advection
      - TMP850
      - h500
