ai2cm/ace/fme/ace/inference/inference.py

import copy
import dataclasses
import datetime
import logging
import os
from collections.abc import Mapping, Sequence
from typing import Literal

import cftime
import dacite
import numpy as np
import numpy.typing as npt
import torch
import xarray as xr
from xarray.coding.times import CFDatetimeCoder

import fme
from fme.ace.aggregator.inference import InferenceAggregatorConfig
from fme.ace.data_loading.batch_data import BatchData, PrognosticState
from fme.ace.data_loading.getters import get_forcing_data
from fme.ace.data_loading.inference import (
    ExplicitIndices,
    ForcingDataLoaderConfig,
    InferenceInitialConditionIndices,
    TimestampList,
    local_ic_range,
)
from fme.ace.inference.data_writer import DataWriterConfig, PairedDataWriter
from fme.ace.inference.data_writer.dataset_metadata import DatasetMetadata
from fme.ace.requirements import InitialConditionRequirements
from fme.ace.stepper import (
    Stepper,
    StepperOverrideConfig,
    load_stepper,
    load_stepper_config_with_override,
)
from fme.ace.stepper.single_module import StepperConfig
from fme.core.cli import prepare_config, prepare_directory
from fme.core.cloud import is_local, makedirs, open_dataset_via_inter_filesystem_copy
from fme.core.dataset.data_typing import VariableMetadata
from fme.core.dataset_info import IncompatibleDatasetInfo
from fme.core.distributed import Distributed
from fme.core.generics.inference import get_record_to_wandb, run_inference, run_segments
from fme.core.labels import BatchLabels
from fme.core.logging_utils import LoggingConfig
from fme.core.timing import GlobalTimer

from .evaluator import resolve_variable_metadata

StartIndices = InferenceInitialConditionIndices | ExplicitIndices | TimestampList


@dataclasses.dataclass
class InitialConditionConfig:
    """
    Configuration for initial conditions.

    .. note::
        The data specified under path should contain a time dimension of at least
        length 1. If multiple times are present in the dataset specified by ``path``,
        the inference will start an ensemble simulation using each IC along a
        leading sample dimension. Specific times can be selected from the dataset
        by using ``start_indices``.

    Parameters:
        path: The path to the initial conditions dataset.
        engine: The engine used to open the dataset.
        start_indices: optional specification of the subset of
            initial conditions to use.
    """

    path: str
    engine: Literal["netcdf4", "zarr"] = "netcdf4"
    start_indices: StartIndices | None = None

    def get_dataset(self) -> xr.Dataset:
        open_kwargs = dict(
            engine=self.engine,
            decode_times=CFDatetimeCoder(use_cftime=True),
            decode_timedelta=False,
        )
        if self.engine == "zarr" or is_local(self.path):
            ds = xr.open_dataset(self.path, **open_kwargs)
        else:
            # netCDF can't be read directly from remote stores (e.g. gs://);
            # copy to a local temp first (covers cross-segment restart.nc ICs).
            ds = open_dataset_via_inter_filesystem_copy(self.path, **open_kwargs)
        return self._subselect_initial_conditions(ds)

    def _subselect_initial_conditions(self, ds: xr.Dataset) -> xr.Dataset:
        if self.start_indices is None:
            ic_indices = slice(None, None)
        elif isinstance(self.start_indices, TimestampList):
            time_index = xr.CFTimeIndex(ds.time.values)
            ic_indices = self.start_indices.as_indices(time_index)
        else:
            ic_indices = self.start_indices.as_indices()
        # time is a required variable but not necessarily a dimension
        sample_dim_name = ds.time.dims[0]
        return ds.isel({sample_dim_name: ic_indices})


def get_initial_condition(
    ds: xr.Dataset,
    requirements: InitialConditionRequirements,
) -> PrognosticState:
    """Build the initial-condition ``PrognosticState`` from a dataset.

    Dispatches on whether the dataset carries embedded ``BatchData`` state - a
    full-state restart written by inference, detected by its schema marker:

    - Embedded state present: the whole ``BatchData`` is rebuilt via
      ``BatchData.from_xarray_dataset`` (see ``_initial_condition_from_state``).
      It already had prognostic-name selection, labels, and ensemble broadcast
      applied before it was saved, so the requirements are *validated* for
      consistency rather than re-applied - a mismatch raises.
    - No embedded state (external ICs and legacy plain restarts): the lenient
      path (``_initial_condition_from_variables``) builds prognostic tensors from
      the named variables, sets labels from the requirements, and broadcasts the
      ensemble - unchanged behavior.

    Either way the returned state is on CPU; ``InferenceGriddedData`` moves it
    to the compute device.

    Args:
        ds: Dataset containing initial condition data. Must include the required
            prognostic names as variables, and they must each have shape
            (n_samples, [spatial dims]) - lat/lon or HEALPix face/height/width.
            Dataset must also include a 'time' variable with length n_samples.
        requirements: What the run requires of the initial condition: the
            prognostic names to extract, labels to provide to the stepper for
            every initial condition (for an embedded-state restart they are
            validated against the saved labels rather than applied), and the
            number of ensemble members per initial state.

    Returns:
        The initial condition and the time coordinate.
    """
    if BatchData.dataset_has_embedded_state(ds):
        return _initial_condition_from_state(ds, requirements)
    return _initial_condition_from_variables(ds, requirements)


def _initial_condition_from_state(
    ds: xr.Dataset,
    requirements: InitialConditionRequirements,
) -> PrognosticState:
    """Build the IC from a full-state restart (embedded ``BatchData`` state).

    Rebuilds the whole ``BatchData`` and validates - does not re-derive - that
    the requirements agree with what was saved; the prognostic names, labels,
    and ensemble broadcast were already applied before the restart was written.
    """
    batch_data = BatchData.from_xarray_dataset(ds)
    batch_data.validate_initial_condition(requirements)
    return batch_data.get_start(requirements.prognostic_names, n_ic_timesteps=1)


def _initial_condition_from_variables(
    ds: xr.Dataset,
    requirements: InitialConditionRequirements,
) -> PrognosticState:
    """Build the IC from a plain netCDF of prognostic variables + time.

    The lenient path for external ICs and legacy restarts: builds prognostic
    tensors from the named variables, sets labels from the requirements, and
    broadcasts the ensemble.
    """
    initial_condition = {}
    horizontal_dims: list[str] | None = None
    for name in requirements.prognostic_names:
        if len(ds[name].shape) < 2:
            raise ValueError(
                f"Initial condition variable {name} must have shape "
                f"(n_samples, [spatial dims]). Got shape {ds[name].shape}."
            )
        n_samples = ds[name].shape[0]
        # The horizontal dims are whatever the variable carries after the leading
        # sample dim, so lat/lon and HEALPix (face/height/width) both flow through
        # unchanged rather than being assumed to be lat/lon.
        if horizontal_dims is None:
            horizontal_dims = [str(d) for d in ds[name].dims[1:]]
        initial_condition[name] = torch.tensor(ds[name].values).unsqueeze(dim=1)
    if "time" not in ds:
        raise ValueError("Initial condition dataset must have a 'time' variable.")
    initial_times = xr.DataArray(
        data=ds.time.values[:, None],
        dims=["sample", "time"],
    )
    if initial_times.shape[0] != n_samples:
        raise ValueError(
            "Length of 'time' variable must match first dimension of variables "
            f"in initial condition dataset. Got {initial_times.shape[0]} "
            f"and {n_samples}."
        )

    if requirements.labels is not None:
        batch_labels = BatchLabels(
            torch.ones(n_samples, len(requirements.labels)),
            names=requirements.labels,
        )
    else:
        batch_labels = None

    batch_data = BatchData.new_on_cpu(
        data=initial_condition,
        time=initial_times,
        horizontal_dims=horizontal_dims,
        labels=batch_labels,
    )
    batch_data = batch_data.broadcast_ensemble(n_ensemble=requirements.n_ensemble)
    return batch_data.get_start(requirements.prognostic_names, n_ic_timesteps=1)


@dataclasses.dataclass
class InferenceConfig:
    """
    Configuration for running inference.

    Parameters:
        experiment_dir: Directory to save results to. This can be a local
            directory, like ``/results``, or a remote directory prefixed with a
            protocol recognized by ``fsspec``, like ``gs://bucket/results``.

            .. note::
                While most types of output can be written to a remote
                ``experiment_dir``, there are some limitations:

                - To write raw or time-coarsened data, the zarr writer must be
                  used. See the ``files`` parameter of the
                  :class:`fme.ace.DataWriterConfig` for more details on how this
                  can be configured. Monthly coarsened data configured through
                  ``files`` can be written to zarr. The legacy
                  ``save_monthly_files`` option remains netCDF-only.
                - Piping logging output to a file in the ``experiment_dir``
                  is not supported. To silence the warning related to this, set
                  ``log_to_file`` to ``False`` in the
                  :class:`fme.ace.LoggingConfig`.

                There are no restrictions on the types of output that can be
                written to a local ``experiment_dir``.

        n_forward_steps: Number of steps to run the model forward for.
        checkpoint_path: Path to stepper checkpoint to load.
        logging: Configuration for logging.
        initial_condition: Configuration for initial condition data.
        forcing_loader: Configuration for forcing data.
        forward_steps_in_memory: Number of forward steps to complete in memory
            at a time.
        data_writer: Configuration for data writers.
        aggregator: Configuration for inference aggregator.
        stepper_override: Configuration for overriding select stepper configuration
            options at inference time (optional).
        use_ema_if_available: If True and the checkpoint contains EMA weights
            (only checkpoints saved with their optimization state, e.g.
            ``ckpt.tar``), run inference with the EMA weights in place of the
            stepper weights.
        allow_incompatible_dataset: If True, allow the dataset used for inference
            to be incompatible with the dataset used for stepper training. This should
            be used with caution, as it may allow the stepper to make scientifically
            invalid predictions, but it can allow running inference with incorrectly
            formatted or missing grid information.
        labels: Dataset labels to use for inference. If provided, these labels will be
            provided to the stepper for every initial condition.
        n_ensemble_per_ic: Number of ensemble members per initial condition. Useful for
            stochastic model weather inference. n_ensemble_per_ic = 1 is default
            inference behavior.
        seed: If set, seeds the random state threaded through the rollout so that
            stochastic modules (e.g. NoiseConditionedSFNO) produce a reproducible
            noise sequence, independent of forward_steps_in_memory. Leave unset
            (None) for the default non-reproducible behavior.
    """

    experiment_dir: str
    n_forward_steps: int
    checkpoint_path: str
    logging: LoggingConfig
    initial_condition: InitialConditionConfig
    forcing_loader: ForcingDataLoaderConfig
    forward_steps_in_memory: int = 10
    data_writer: DataWriterConfig = dataclasses.field(
        default_factory=lambda: DataWriterConfig()
    )
    aggregator: InferenceAggregatorConfig = dataclasses.field(
        default_factory=lambda: InferenceAggregatorConfig()
    )
    stepper_override: StepperOverrideConfig | None = None
    use_ema_if_available: bool = True
    allow_incompatible_dataset: bool = False
    labels: list[str] | None = None
    n_ensemble_per_ic: int = 1
    seed: int | None = None

    def __post_init__(self):
        self.data_writer.validate_time_coarsen(
            self.forward_steps_in_memory,
            self.n_forward_steps,
        )

    def configure_logging(self, log_filename: str):
        config = dataclasses.asdict(self)
        self.logging.configure_logging(
            self.experiment_dir, log_filename, config=config, resumable=False
        )

    def load_stepper(self) -> Stepper:
        logging.info(f"Loading trained model checkpoint from {self.checkpoint_path}")
        return load_stepper(
            self.checkpoint_path,
            self.stepper_override,
            use_ema_if_available=self.use_ema_if_available,
        )

    def load_stepper_config(self) -> StepperConfig:
        logging.info(f"Loading trained model checkpoint from {self.checkpoint_path}")
        return load_stepper_config_with_override(
            self.checkpoint_path, self.stepper_override
        )

    def get_data_writer(
        self,
        initial_condition_times: npt.NDArray[cftime.datetime],
        timestep: datetime.timedelta,
        coords: Mapping[str, np.ndarray],
        variable_metadata: Mapping[str, VariableMetadata],
    ) -> PairedDataWriter:
        return self.data_writer.build_paired(
            experiment_dir=self.experiment_dir,
            # each batch contains all samples, for different times
            initial_condition_times=initial_condition_times,
            n_timesteps=self.n_forward_steps,
            timestep=timestep,
            variable_metadata=variable_metadata,
            coords=coords,
            dataset_metadata=DatasetMetadata.from_env(),
        )


def main(
    yaml_config: str,
    segments: int | None = None,
    override_dotlist: Sequence[str] | None = None,
):
    config_data = prepare_config(yaml_config, override=override_dotlist)
    config = dacite.from_dict(
        data_class=InferenceConfig,
        data=config_data,
        config=dacite.Config(strict=True),
    )
    prepare_directory(config.experiment_dir, config_data)
    with torch.no_grad():
        if segments is None:
            with GlobalTimer():
                return run_inference_from_config(config)
        else:
            run_segmented_inference(config, segments)


def run_inference_from_config(config: InferenceConfig):
    timer = GlobalTimer.get_instance()
    timer.start_outer("inference")
    with timer.context("initialization"):
        makedirs(config.experiment_dir, exist_ok=True)
        config.configure_logging(log_filename="inference_out.log")

        if fme.using_gpu():
            torch.backends.cudnn.benchmark = True

        stepper_config = config.load_stepper_config()
        data_requirements = stepper_config.get_forcing_window_data_requirements(
            n_forward_steps=config.forward_steps_in_memory
        )
        logging.info("Loading initial condition data")
        ic_ds = config.initial_condition.get_dataset()
        initial_condition = get_initial_condition(
            ic_ds,
            InitialConditionRequirements(
                prognostic_names=stepper_config.prognostic_names,
                labels=config.labels,
            ),
        )
        stepper = config.load_stepper()
        stepper.set_eval()
        dist = Distributed.get_instance()
        n_ic = initial_condition.as_batch_data().time.sizes["sample"]
        ic_already_sharded = (
            dist.total_data_parallel_ranks > 1
            and BatchData.dataset_has_gathered_state(ic_ds)
        )
        if not ic_already_sharded:
            # Validate divisibility (raises ValueError if not divisible).
            local_ic_range(
                n_ic, dist.data_parallel_rank, dist.total_data_parallel_ranks
            )

        logging.info("Initializing forcing data loader")
        data = get_forcing_data(
            config=config.forcing_loader,
            total_forward_steps=config.n_forward_steps,
            window_requirements=data_requirements,
            initial_condition=initial_condition,
            surface_temperature_name=stepper.surface_temperature_name,
            ocean_fraction_name=stepper.ocean_fraction_name,
            label_override=config.labels,
        )
        # Must happen before the ensemble broadcast.  Gathered restarts
        # are already per-rank (scattered inside from_xarray_dataset).
        if dist.total_data_parallel_ranks > 1 and not ic_already_sharded:
            ic_batch = data.initial_condition.as_batch_data()
            start, end = local_ic_range(
                n_ic, dist.data_parallel_rank, dist.total_data_parallel_ranks
            )
            data._initial_condition = PrognosticState(
                ic_batch.select_sample_slice(slice(start, end))
            )

        # Broadcast the initial condition across ensemble members only after the
        # forcing loader is built, mirroring the evaluator path. The forcing then
        # has one window per initial condition (n_ensemble=1) and predict_paired
        # broadcasts it exactly once to match the ensemble-broadcast initial
        # condition. Broadcasting before get_forcing_data would tile the forcing
        # start times too, and predict_paired would broadcast the already-tiled
        # forcing a second time (the standalone double-broadcast bug).
        if config.n_ensemble_per_ic > 1:
            ic = data.initial_condition.as_batch_data()
            data._initial_condition = PrognosticState(
                ic.broadcast_ensemble(config.n_ensemble_per_ic)
            )
        data.apply_config_seed(config.seed)

        if not config.allow_incompatible_dataset:
            try:
                stepper.training_dataset_info.assert_compatible_with(data.dataset_info)
            except IncompatibleDatasetInfo as err:
                raise IncompatibleDatasetInfo(
                    "Inference dataset is not compatible with dataset used for stepper "
                    "training. Set allow_incompatible_dataset to True to ignore this "
                    f"error. The incompatiblity found was: {str(err)}"
                ) from err

        variable_metadata = resolve_variable_metadata(
            dataset_metadata=data.variable_metadata,
            stepper_metadata=stepper.training_variable_metadata,
            stepper_all_names=stepper_config.all_names,
        )
        dataset_info = data.dataset_info.update_variable_metadata(variable_metadata)
        aggregator = config.aggregator.build(
            dataset_info=dataset_info,
            n_timesteps=config.n_forward_steps + stepper.n_ic_timesteps,
            output_dir=config.experiment_dir,
            normalize=stepper.normalizer.normalize,
        )

        writer = config.get_data_writer(
            initial_condition_times=data.initial_time.to_numpy(),
            timestep=data.timestep,
            coords=data.coords,
            variable_metadata=variable_metadata,
        )
    logging.info("Starting inference")
    logger = get_record_to_wandb(label="inference")
    run_inference(
        predict=stepper.predict_paired,
        data=data,
        writer=writer,
        aggregator=aggregator,
        record_logs=logger.log,
    )

    with timer.context("final_writer_flush"):
        logging.info("Starting final flush of data writer")
        writer.finalize()
        logging.info("Writing reduced metrics to disk in netcdf format.")
        aggregator.flush_diagnostics()

    timer.stop_outer("inference")
    total_steps = config.n_forward_steps * data.n_initial_conditions
    inference_duration = timer.get_duration("inference")
    wandb_logging_duration = timer.get_duration("inference/wandb_logging")
    total_steps_per_second = total_steps / (inference_duration - wandb_logging_duration)
    timer.log_durations()
    logging.info(
        "Total steps per second (ignoring wandb logging): "
        f"{total_steps_per_second:.2f} steps/second"
    )
    summary_logs = {
        "total_steps_per_second": total_steps_per_second,
        **aggregator.get_summary_logs(),
    }
    logger.log_to_current_step(summary_logs)
    logger.log_to_current_step(timer.get_durations(), label="")


def _get_initialization_time_and_timestep(
    config: InferenceConfig,
) -> tuple[cftime.datetime, datetime.timedelta]:
    # Loading the stepper is expensive, so this is called once per run; it gives
    # the timestep and the prognostic names.
    stepper = config.load_stepper()
    initial_condition = get_initial_condition(
        config.initial_condition.get_dataset(),
        InitialConditionRequirements(
            prognostic_names=stepper.prognostic_names,
            labels=config.labels,
        ),
    )
    initialization_time = initial_condition.as_batch_data().time.isel(sample=0).item()
    return initialization_time, stepper.training_dataset_info.timestep


def run_segmented_inference(config: InferenceConfig, segments: int):
    """Run inference in multiple segments, each resumable after preemption.

    Args:
        config: Configuration for each segment. Its initial condition is used
            only for the first segment; later segments start from the previous
            segment's restart file.
        segments: Total number of segments; only missing ones are run.
    """
    config_copy = copy.deepcopy(config)

    def _get_restart_paths(segment_dir: str) -> Sequence[str]:
        return [os.path.join(segment_dir, "restart.nc")]

    def _run_segment(segment_dir: str) -> None:
        config_copy.experiment_dir = segment_dir
        run_inference_from_config(config_copy)

    def _set_initial_condition(restart_paths: Sequence[str]) -> None:
        (restart_path,) = restart_paths
        config_copy.initial_condition = InitialConditionConfig(
            path=restart_path, engine="netcdf4"
        )

    run_segments(
        segments=segments,
        experiment_dir=config.experiment_dir,
        logging_config=config.logging,
        logging_config_dict=dataclasses.asdict(config),
        n_ensemble_per_ic=config.n_ensemble_per_ic,
        n_steps_per_segment=config.n_forward_steps,
        get_initialization=lambda: _get_initialization_time_and_timestep(config),
        get_restart_paths=_get_restart_paths,
        run_segment=_run_segment,
        set_initial_condition=_set_initial_condition,
    )
