ai2cm/ace/fme/ace/stepper/single_module.py

import contextlib
import dataclasses
import datetime
import logging
import pathlib
from collections.abc import Callable, Generator, Mapping
from typing import Any, Literal, cast

import dacite
import dacite.exceptions
import torch
import xarray as xr
from torch import nn

from fme.ace.data_loading.batch_data import BatchData, PairedData, PrognosticState
from fme.ace.requirements import DataRequirements, PrognosticStateDataRequirements
from fme.ace.stepper.derived_forcings import DerivedForcingsConfig
from fme.ace.stepper.loss_schedule import LossSchedule
from fme.ace.stepper.parameter_init import (
    ParameterInitializationConfig,
    ParameterInitializer,
    StepperWeightsAndHistory,
    Weights,
    WeightsAndHistoryLoader,
    null_weights_and_history,
)
from fme.ace.stepper.time_length_probabilities import TimeLength, TimeLengthSchedule
from fme.core.coordinates import SerializableVerticalCoordinate, VerticalCoordinate
from fme.core.corrector.atmosphere import AtmosphereCorrectorConfig
from fme.core.corrector.loss_config import CorrectorLossConfig
from fme.core.dataset.data_typing import VariableMetadata
from fme.core.dataset.schedule import IntSchedule
from fme.core.dataset.utils import encode_timestep
from fme.core.dataset_info import DatasetInfo, MissingDatasetInfo
from fme.core.ema import load_ema_params_if_available
from fme.core.generics.inference import PredictFunction
from fme.core.generics.optimization import OptimizationABC
from fme.core.generics.train_stepper import TrainOutputABC, TrainStepperABC
from fme.core.labels import BatchLabels
from fme.core.loss import (
    ChannelLossInfo,
    CorrectorLoss,
    StepLoss,
    StepLossConfig,
    StepOutputLoss,
)
from fme.core.normalizer import (
    NetworkAndLossNormalizationConfig,
    NormalizationConfig,
    StandardNormalizer,
)
from fme.core.ocean import OceanConfig
from fme.core.optimization import NullOptimization
from fme.core.rand import use_generator
from fme.core.registry import CorrectorSelector, ModuleSelector
from fme.core.spatial_masking import (
    NullSpatialMasking,
    SpatialMasking,
    StaticSpatialMaskingConfig,
)
from fme.core.step.args import StepArgs
from fme.core.step.global_mean_removal import GlobalMeanRemovalConfigUnion
from fme.core.step.multi_call import (
    MultiCallConfig,
    MultiCallStepConfig,
    replace_multi_call,
)
from fme.core.step.output import StepOutput
from fme.core.step.single_module import SingleModuleStepConfig
from fme.core.step.step import StepABC, StepSelector
from fme.core.stepper_state import StepperState
from fme.core.tensors import (
    add_ensemble_dim,
    fold_ensemble_dim,
    fold_sized_ensemble_dim,
    unfold_ensemble_dim,
)
from fme.core.timing import GlobalTimer
from fme.core.training_history import TrainingHistory, TrainingJob
from fme.core.typing_ import EnsembleTensorDict, TensorDict, TensorMapping

DEFAULT_TIMESTEP = datetime.timedelta(hours=6)
DEFAULT_ENCODED_TIMESTEP = encode_timestep(DEFAULT_TIMESTEP)


def load_weights_and_history(path: str | None) -> StepperWeightsAndHistory:
    if path is None:
        return null_weights_and_history()
    stepper = load_stepper(path)
    return_weights: Weights = []
    for module in stepper.modules:
        return_weights.append(module.state_dict())
    return return_weights, stepper.training_history


@dataclasses.dataclass
class SingleModuleStepperConfig:
    """
    Configuration for a single module stepper.

    Parameters:
        builder: The module builder.
        in_names: Names of input variables.
        out_names: Names of output variables.
        normalization: The normalization configuration.
        parameter_init: The parameter initialization configuration.
        ocean: The ocean configuration.
        loss: The loss configuration.
        corrector: The corrector configuration.
        next_step_forcing_names: Names of forcing variables for the next timestep.
        prescribed_prognostic_names: Prognostic variable names to overwrite from
            forcing data at each step during inference.
        loss_normalization: The normalization configuration for the loss.
        residual_normalization: Optional alternative to configure loss normalization.
            If provided, it will be used for all *prognostic* variables in loss scaling.
        multi_call: The configuration of multi-called diagnostics.
        include_multi_call_in_loss: Whether to include multi-call diagnostics in the
            loss. The same loss configuration as specified in 'loss' is used.
        residual_prediction: Whether to have ML module predict tendencies for
            prognostic variables.
        global_mean_removal: Optional configuration for removing global means
            from fields before normalization and restoring them after
            denormalization. Passed through to ``SingleModuleStepConfig``.
    """

    builder: ModuleSelector
    in_names: list[str]
    out_names: list[str]
    normalization: NormalizationConfig
    parameter_init: ParameterInitializationConfig = dataclasses.field(
        default_factory=lambda: ParameterInitializationConfig()
    )
    ocean: OceanConfig | None = None
    loss: StepLossConfig = dataclasses.field(default_factory=lambda: StepLossConfig())
    corrector: AtmosphereCorrectorConfig | CorrectorSelector = dataclasses.field(
        default_factory=lambda: AtmosphereCorrectorConfig()
    )
    next_step_forcing_names: list[str] = dataclasses.field(default_factory=list)
    prescribed_prognostic_names: list[str] = dataclasses.field(default_factory=list)
    loss_normalization: NormalizationConfig | None = None
    residual_normalization: NormalizationConfig | None = None
    multi_call: MultiCallConfig | None = None
    include_multi_call_in_loss: bool = False
    residual_prediction: bool = False
    global_mean_removal: GlobalMeanRemovalConfigUnion | None = None

    def __post_init__(self):
        for name in self.prescribed_prognostic_names:
            if name not in self.out_names:
                raise ValueError(
                    f"prescribed_prognostic_name '{name}' must be in out_names: "
                    f"{self.out_names}"
                )
        for name in self.next_step_forcing_names:
            if name not in self.in_names:
                raise ValueError(
                    f"next_step_forcing_name '{name}' not in in_names: {self.in_names}"
                )
            if name in self.out_names:
                raise ValueError(
                    f"next_step_forcing_name is an output variable: '{name}'"
                )
        if (
            self.residual_normalization is not None
            and self.loss_normalization is not None
        ):
            raise ValueError(
                "Only one of residual_normalization, loss_normalization can "
                "be provided."
                "If residual_normalization is provided, it will be used for all "
                "*prognostic* variables in loss scalng. "
                "If loss_normalization is provided, it will be used for all variables "
                "in loss scaling."
            )
        if self.multi_call is not None:
            self.multi_call.validate(self.in_names, self.out_names)
        if self.include_multi_call_in_loss:
            if self.multi_call is None:
                raise ValueError(
                    "include_multi_calls_in_loss is True but no multi_call config "
                    "was provided."
                )

    @classmethod
    def from_state(cls, state) -> "SingleModuleStepperConfig":
        state = cls.remove_deprecated_keys(state)
        return dacite.from_dict(
            data_class=cls, data=state, config=dacite.Config(strict=True)
        )

    @classmethod
    def remove_deprecated_keys(cls, state: dict[str, Any]) -> dict[str, Any]:
        _unsupported_key_defaults = {
            "conserve_dry_air": False,
            "optimization": None,
            "conservation_loss": {"dry_air_penalty": None},
        }
        state_copy = state.copy()
        for key, default in _unsupported_key_defaults.items():
            if key in state_copy:
                if state_copy[key] == default or state_copy[key] is None:
                    del state_copy[key]
                else:
                    raise ValueError(
                        f"The stepper config option {key} is deprecated and the setting"
                        f" provided, {state_copy[key]}, is no longer implemented. The "
                        "SingleModuleStepper being loaded from state cannot be run by "
                        "this version of the code."
                    )
        for normalization_key in [
            "normalization",
            "loss_normalization",
            "residual_normalization",
        ]:
            if state_copy.get(normalization_key) is not None:
                if "exclude_names" in state_copy[normalization_key]:
                    if state_copy[normalization_key]["exclude_names"] is not None:
                        raise ValueError(
                            "The exclude_names option in normalization config is no "
                            "longer supported, but excluded names were found in "
                            f"{normalization_key}."
                        )
                    else:
                        del state_copy[normalization_key]["exclude_names"]
        if "prescriber" in state_copy:
            # want to maintain backwards compatibility for this particular feature
            if state_copy["prescriber"] is not None:
                if state_copy.get("ocean") is not None:
                    raise ValueError("Cannot specify both prescriber and ocean.")
                state_copy["ocean"] = {
                    "surface_temperature_name": state_copy["prescriber"][
                        "prescribed_name"
                    ],
                    "ocean_fraction_name": state_copy["prescriber"]["mask_name"],
                    "interpolate": state_copy["prescriber"]["interpolate"],
                }
            del state_copy["prescriber"]
        if "activation_checkpointing" in state_copy:
            del state_copy["activation_checkpointing"]
        if "crps_training" in state_copy:
            del state_copy["crps_training"]  # training value, ok to break
        return state_copy

    def to_stepper_config(
        self,
        normalizer: StandardNormalizer,
        loss_normalizer: StandardNormalizer,
    ) -> "StepperConfig":
        """
        Convert the current config to a stepper config.

        Overwriting normalization configuration is needed to avoid
        a checkpoint trying to load normalization data from netCDF files
        which are no longer present when running inference.

        Args:
            normalizer: overwrite the normalization config
                with data from this normalizer
            loss_normalizer: overwrite the loss normalization config
                with data from this normalizer

        Returns:
            A stepper config.
        """
        return StepperConfig(
            step=self._to_step_config(normalizer, loss_normalizer),
        )

    def _to_step_config(
        self,
        normalizer: StandardNormalizer | None = None,
        loss_normalizer: StandardNormalizer | None = None,
    ) -> StepSelector:
        return StepSelector(
            type="multi_call",
            config=dataclasses.asdict(
                MultiCallStepConfig(
                    wrapped_step=StepSelector(
                        type="single_module",
                        config=dataclasses.asdict(
                            self._to_single_module_step_config(
                                normalizer=normalizer,
                                loss_normalizer=loss_normalizer,
                            )
                        ),
                    ),
                    config=self.multi_call,
                    include_multi_call_in_loss=self.include_multi_call_in_loss,
                )
            ),
        )

    def _to_single_module_step_config(
        self,
        normalizer: StandardNormalizer | None = None,
        loss_normalizer: StandardNormalizer | None = None,
    ) -> "SingleModuleStepConfig":
        if normalizer is not None:
            normalization = normalizer.get_normalization_config()
        else:
            normalization = self.normalization
        if loss_normalizer is not None:
            loss_normalization: NormalizationConfig | None = (
                loss_normalizer.get_normalization_config()
            )
            residual_normalization: NormalizationConfig | None = None
        else:
            loss_normalization = self.loss_normalization
            residual_normalization = self.residual_normalization
        return SingleModuleStepConfig(
            builder=self.builder,
            in_names=self.in_names,
            out_names=self.out_names,
            normalization=NetworkAndLossNormalizationConfig(
                network=normalization,
                loss=loss_normalization,
                residual=residual_normalization,
            ),
            ocean=self.ocean,
            corrector=self.corrector,
            next_step_forcing_names=self.next_step_forcing_names,
            prescribed_prognostic_names=self.prescribed_prognostic_names,
            residual_prediction=self.residual_prediction,
            global_mean_removal=self.global_mean_removal,
        )


def _prepend_timesteps(
    data: EnsembleTensorDict, timesteps: TensorMapping, time_dim: int = 2
) -> EnsembleTensorDict:
    for v in data.values():
        n_ensemble = v.shape[1]
        break
    else:
        return data  # data is length zero
    timesteps = add_ensemble_dim(timesteps, repeats=n_ensemble)
    return EnsembleTensorDict(
        {k: torch.cat([timesteps[k], v], dim=time_dim) for k, v in data.items()}
    )


def _get_time_dim_size(data: TensorDict) -> int:
    for v in data.values():
        return v.shape[1]
    raise ValueError("data is empty")


def _clip_time_dim(data: TensorDict, time_dim_size: int) -> TensorDict:
    return {k: v[:, :time_dim_size] for k, v in data.items()}


@dataclasses.dataclass
class TrainOutput(TrainOutputABC):
    metrics: TensorDict
    gen_data: EnsembleTensorDict
    target_data: EnsembleTensorDict
    time: xr.DataArray
    normalize: Callable[[TensorDict], TensorDict]
    derive_func: Callable[[TensorMapping, TensorMapping], TensorDict] = lambda x, _: (
        dict(x)
    )
    per_channel_losses: dict[str, ChannelLossInfo] | None = None

    def __post_init__(self):
        for v in self.target_data.values():
            if v.shape[1] != 1:
                raise ValueError(
                    f"target_data can only have one ensemble member, got {v.shape[1]}"
                )

    @property
    def n_ensemble(self) -> int:
        """The number of ensemble members in the generated data."""
        for v in self.gen_data.values():
            return v.shape[1]
        raise ValueError("gen_data is empty, ensemble member count is not defined")

    def ensemble_derive_func(
        self, data: EnsembleTensorDict, forcing_data: TensorMapping
    ) -> EnsembleTensorDict:
        """
        Compute derived variables for an ensemble of data.

        Args:
            data: The data to compute derived variables for.
            forcing_data: The forcing data to use for the derived variables.
                Time dimension must be at least as long as present in the data,
                if longer it will be clipped.

        Returns:
            The derived variables.
        """
        flattened_data, n_ensemble = fold_ensemble_dim(data)
        if n_ensemble > 1:
            ensemble_forcing_data = add_ensemble_dim(forcing_data, repeats=n_ensemble)
            flattened_forcing_data = fold_sized_ensemble_dim(
                ensemble_forcing_data, n_ensemble
            )
        else:
            flattened_forcing_data = dict(forcing_data)
        flattened_forcing_data = _clip_time_dim(
            flattened_forcing_data, _get_time_dim_size(flattened_data)
        )
        derived_data = self.derive_func(flattened_data, flattened_forcing_data)
        return unfold_ensemble_dim(derived_data, n_ensemble)

    def remove_initial_condition(self, n_ic_timesteps: int) -> "TrainOutput":
        return TrainOutput(
            metrics=self.metrics,
            gen_data=EnsembleTensorDict(
                {k: v[:, :, n_ic_timesteps:] for k, v in self.gen_data.items()}
            ),
            target_data=EnsembleTensorDict(
                {k: v[:, :, n_ic_timesteps:] for k, v in self.target_data.items()}
            ),
            time=self.time[:, n_ic_timesteps:],
            normalize=self.normalize,
            derive_func=self.derive_func,
            per_channel_losses=self.per_channel_losses,
        )

    def copy(self) -> "TrainOutput":
        """Creates new dictionaries for the data but with the same tensors."""
        return TrainOutput(
            metrics=self.metrics,
            gen_data=EnsembleTensorDict({k: v for k, v in self.gen_data.items()}),
            target_data=EnsembleTensorDict({k: v for k, v in self.target_data.items()}),
            time=self.time,
            normalize=self.normalize,
            derive_func=self.derive_func,
            per_channel_losses=self.per_channel_losses,
        )

    def prepend_initial_condition(
        self,
        initial_condition: PrognosticState,
    ) -> "TrainOutput":
        """
        Prepends an initial condition to the existing stepped data.
        Assumes data are on the same device.
        For data windows > 0, the target IC is different from the generated IC
            and may be provided for correct calculation of tendencies.

        Args:
            initial_condition: Initial condition data.
        """
        batch_data = initial_condition.as_batch_data()
        return TrainOutput(
            metrics=self.metrics,
            gen_data=_prepend_timesteps(self.gen_data, batch_data.data),
            target_data=_prepend_timesteps(
                self.target_data,
                batch_data.data,
            ),
            time=xr.concat([batch_data.time, self.time], dim="time"),
            normalize=self.normalize,
            derive_func=self.derive_func,
            per_channel_losses=self.per_channel_losses,
        )

    def compute_derived_variables(
        self,
    ) -> "TrainOutput":
        gen_data = self.ensemble_derive_func(
            self.gen_data, fold_sized_ensemble_dim(self.target_data, 1)
        )
        target_data = self.ensemble_derive_func(
            self.target_data, fold_sized_ensemble_dim(self.target_data, 1)
        )
        return TrainOutput(
            metrics=self.metrics,
            gen_data=gen_data,
            target_data=target_data,
            time=self.time,
            normalize=self.normalize,
            derive_func=self.derive_func,
            per_channel_losses=self.per_channel_losses,
        )

    def get_metrics(self) -> TensorDict:
        return self.metrics


def stack_list_of_tensor_dicts(
    dict_list: list[TensorDict],
    time_dim: int,
) -> TensorDict:
    keys = next(iter(dict_list)).keys()
    stack_dict = {}
    for k in keys:
        stack_dict[k] = torch.stack([d[k] for d in dict_list], dim=time_dim)
    return stack_dict


def process_ensemble_prediction_generator_list(
    output_list: list[EnsembleTensorDict],
) -> EnsembleTensorDict:
    output_timeseries = stack_list_of_tensor_dicts(
        cast(list[TensorDict], output_list), time_dim=2
    )
    return EnsembleTensorDict(
        {k: v for k, v in output_timeseries.items()},
    )


def process_prediction_generator_list(
    output_list: list[StepOutput],
    time: xr.DataArray,
    n_ensemble: int,
    labels: BatchLabels | None = None,
    horizontal_dims: list[str] | None = None,
) -> BatchData:
    """Stack per-step outputs into a single BatchData.

    Attaches the terminal stepper_state (from the last entry in
    ``output_list``) to the returned BatchData so it can propagate to the
    next ``Stepper.predict`` call.
    """
    output_dicts = [item.output for item in output_list]
    terminal_state = output_list[-1].stepper_state if output_list else None
    output_timeseries = stack_list_of_tensor_dicts(output_dicts, time_dim=1)
    return BatchData.new_on_device(
        data=output_timeseries,
        time=time,
        horizontal_dims=horizontal_dims,
        labels=labels,
        n_ensemble=n_ensemble,
        stepper_state=terminal_state,
    )


@dataclasses.dataclass
class StepperConfig:
    """
    Configuration for a stepper.

    Parameters:
        step: The step configuration.
        input_masking: Config for masking step inputs.
        derived_forcings: Configuration for deriving forcing variables.
    """

    step: StepSelector
    input_masking: StaticSpatialMaskingConfig | None = None
    derived_forcings: DerivedForcingsConfig = dataclasses.field(
        default_factory=lambda: DerivedForcingsConfig()
    )

    @property
    def n_ic_timesteps(self) -> int:
        return self.step.n_ic_timesteps

    def get_evaluation_window_data_requirements(
        self, n_forward_steps: int | IntSchedule
    ) -> DataRequirements:
        requirements = DataRequirements(
            names=list(self.all_names),
            n_timesteps=self._window_steps_required(n_forward_steps),
            allow_missing_variables=self.step.allow_missing_variables,
        )
        return self.derived_forcings.update_requirements(requirements)

    def get_prognostic_state_data_requirements(self) -> PrognosticStateDataRequirements:
        return PrognosticStateDataRequirements(
            names=self.prognostic_names,
            n_timesteps=self.n_ic_timesteps,
        )

    @property
    def input_only_names(self) -> set[str]:
        return set(self.input_names) - set(self.output_names)

    def get_forcing_window_data_requirements(
        self, n_forward_steps: int
    ) -> DataRequirements:
        requirements = DataRequirements(
            names=list(self.input_only_names.union(self.step.next_step_input_names)),
            n_timesteps=self._window_steps_required(n_forward_steps),
            allow_missing_variables=self.step.allow_missing_variables,
        )
        return self.derived_forcings.update_requirements(requirements)

    def _window_steps_required(
        self, n_forward_steps: int | IntSchedule
    ) -> int | IntSchedule:
        if isinstance(n_forward_steps, IntSchedule):
            return n_forward_steps.add(self.n_ic_timesteps)
        return n_forward_steps + self.n_ic_timesteps

    def as_loaded_dict(self):
        self.step.load()
        return dataclasses.asdict(self)

    def get_stepper(
        self,
        dataset_info: DatasetInfo,
        parameter_initializer: ParameterInitializer | None = None,
        training_history: TrainingHistory | None = None,
    ):
        """
        Args:
            dataset_info: Information about the training dataset.
            parameter_initializer: The parameter initializer to use for loading
                weights from an external source. If None, no parameter
                initialization is applied.
            training_history: History of the stepper's training jobs.

        """
        logging.info("Initializing stepper from provided config")
        if parameter_initializer is None:
            parameter_initializer = ParameterInitializer()
        step = self.step.get_step(
            dataset_info, init_weights=parameter_initializer.freeze_weights
        )
        try:
            derive_func = dataset_info.vertical_coordinate.build_derive_function(
                dataset_info.timestep, dataset_info.horizontal_coordinates
            )
        except MissingDatasetInfo:
            derive_func = dataset_info.vertical_coordinate.build_derive_function(
                dataset_info.timestep
            )
        if self.input_masking is None:
            input_masking = NullSpatialMasking()
        else:
            input_masking = self.input_masking.build(
                mask=dataset_info.spatial_mask_provider,
                means=step.normalizer.means,
                names=self.input_names,
            )
        try:
            output_masking: SpatialMasking = (
                dataset_info.spatial_mask_provider.build_output_spatial_masker()
            )
        except MissingDatasetInfo:
            output_masking = NullSpatialMasking()
        return Stepper(
            config=self,
            step=step,
            dataset_info=dataset_info,
            input_process_func=input_masking,
            output_masking=output_masking,
            derive_func=derive_func,
            parameter_initializer=parameter_initializer,
            training_history=training_history,
        )

    @classmethod
    def from_stepper_state(cls, state) -> "StepperConfig":
        """
        Initialize a StepperConfig from a stepper state.

        This is required for backwards compatibility with older steppers,
        whose configuration did not provide normalization constants, but rather
        pointed to files on disk. Newer stepper configurations load these
        constants into the configuration before checkpoints are saved.

        Args:
            state: The state of the stepper.

        Returns:
            The stepper config.
        """
        try:
            legacy_config = SingleModuleStepperConfig.from_state(state["config"])
            normalizer = StandardNormalizer.from_state(
                state.get("normalizer", state.get("normalization"))
            )
            if normalizer is None:
                raise KeyError(
                    "No normalization found in state, available keys: "
                    + ", ".join(state.keys())
                )
            loss_normalizer_config = state.get(
                "loss_normalizer", state.get("loss_normalization")
            )
            if loss_normalizer_config is None:
                loss_normalizer = normalizer
            else:
                loss_normalizer = StandardNormalizer.from_state(loss_normalizer_config)
            return legacy_config.to_stepper_config(
                normalizer=normalizer, loss_normalizer=loss_normalizer
            )
        except (dacite.exceptions.DaciteError, KeyError):
            state = cls.remove_deprecated_keys(state["config"])
            return dacite.from_dict(
                data_class=cls, data=state, config=dacite.Config(strict=True)
            )

    @property
    def loss_names(self):
        """Names of variables to include in loss."""
        return self.step.loss_names

    @property
    def input_names(self) -> frozenset[str]:
        """Names of variables which are required as inputs."""
        return self.step.input_names

    @property
    def all_names(self) -> frozenset[str]:
        """Names of all variables."""
        return frozenset(set(self.input_names).union(self.output_names))

    @property
    def next_step_forcing_names(self) -> list[str]:
        """
        Names of variables which are given as inputs but taken from the output timestep.

        An example might be solar insolation taken during the output window period.
        """
        return self.step.get_next_step_forcing_names()

    @property
    def prognostic_names(self) -> frozenset[str]:
        """Names of variables which both inputs and outputs."""
        return self.step.prognostic_names

    @property
    def output_names(self) -> frozenset[str]:
        """Names of variables which are outputs only."""
        return self.step.output_names

    @classmethod
    def remove_deprecated_keys(cls, state: dict[str, Any]) -> dict[str, Any]:
        state_copy = state.copy()
        for key in [
            "crps_training",
            "loss",
            "optimize_last_step_only",
            "n_ensemble",
            "parameter_init",
            "train_n_forward_steps",
        ]:
            if key in state_copy:
                del state_copy[key]
        return state_copy

    def replace_ocean(self, ocean: OceanConfig | None):
        self.step.replace_ocean(ocean)

    def get_ocean(self) -> OceanConfig | None:
        return self.step.get_ocean()

    def replace_prescribed_prognostic_names(self, names: list[str]) -> None:
        """Replace prescribed prognostic names (e.g. when loading from checkpoint).

        Used for inference / evaluation where the trained ckpt does not contain
        prescribed_prognostic_names and we need to overwrite
        prescribed_prognostic_names.
        """
        self.step.replace_prescribed_prognostic_names(names)

    def get_prescribed_prognostic_names(self) -> list[str]:
        return self.step.get_prescribed_prognostic_names()

    def replace_corrector(self, corrector: CorrectorSelector) -> None:
        self.step.replace_corrector(corrector)

    def replace_multi_call(
        self, multi_call: MultiCallConfig | None, state: dict[str, Any]
    ) -> dict[str, Any]:
        """Replace the multi-call configuration of self.step and ensure the
        associated state can be loaded as a multi-call step.

        A value of `None` for `multi_call` will remove the multi-call configuration.

        If the selected type supports it, the multi-call configuration will be
        updated in place. Otherwise, it will be wrapped in the multi_call step
        configuration with the given multi_call config or None.

        Note this updates self.step in place, but returns a new state dictionary.

        Args:
            multi_call: MultiCallConfig for the resulting self.step.
            state: state dictionary associated with the loaded step.

        Returns:
            The state dictionary updated to ensure consistency with that of a
            serialized multi-call step.
        """
        self.step, new_state = replace_multi_call(self.step, multi_call, state)
        return new_state

    def replace_derived_forcings(self, derived_forcings: DerivedForcingsConfig):
        self.derived_forcings.validate_replacement(derived_forcings)
        self.derived_forcings = derived_forcings

    @classmethod
    def from_state(cls, state) -> "StepperConfig":
        state = cls.remove_deprecated_keys(state)
        return dacite.from_dict(
            data_class=cls, data=state, config=dacite.Config(strict=True)
        )


@dataclasses.dataclass
class CheckpointStepperConfig:
    """
    Defines a stepper by loading its configuration from a saved checkpoint.

    Does not affect weight initialization, which is handled in a different
    configuration (likely parameter initialization under stepper_training).

    Parameters:
        checkpoint_path: Path to a serialized checkpoint containing a stepper.
    """

    checkpoint_path: str

    def to_stepper_config(self) -> StepperConfig:
        return load_stepper_config(self.checkpoint_path)


class Stepper:
    """
    Stepper class for selectable step configurations.
    """

    TIME_DIM = 1
    CHANNEL_DIM = -3

    def __init__(
        self,
        config: StepperConfig,
        step: StepABC,
        dataset_info: DatasetInfo,
        input_process_func: Callable[[TensorMapping], TensorDict],
        output_masking: SpatialMasking,
        derive_func: Callable[[TensorMapping, TensorMapping], TensorDict],
        parameter_initializer: ParameterInitializer,
        training_history: TrainingHistory | None = None,
    ):
        """
        Args:
            config: The configuration.
            step: The step object.
            dataset_info: Information about dataset used for training.
            output_masking: Spatial masking applied to the step output and to
                the corrector diagnostics carried alongside it.
            derive_func: Function to compute derived variables.
            input_process_func: Optional function for processing inputs and next-step
                inputs before passing them to the step object, e.g., by masking
                specific regions.
            parameter_initializer: The parameter initializer to use for loading weights
                from an external source.
            training_history: History of the stepper's training jobs.
        """
        self._config = config
        self._step_obj = step
        self._dataset_info = dataset_info
        self._derive_func = derive_func
        self._output_masking = output_masking
        self._input_process_func = input_process_func
        self._no_optimization = NullOptimization()
        self._parameter_initializer = parameter_initializer

        self._parameter_initializer.apply_weights(
            step.modules,
        )

        self._l2_sp_tuning_regularizer = (
            self._parameter_initializer.get_l2_sp_tuning_regularizer(
                step.modules,
            )
        )

        self._training_history = (
            training_history if training_history is not None else TrainingHistory()
        )
        self._append_training_history_from(
            base_training_history=self._parameter_initializer.training_history
        )

        _: PredictFunction[  # for type checking
            PrognosticState,
            BatchData,
            PairedData,
        ] = self.predict_paired

        self._dataset_info = dataset_info
        self.forcing_deriver = config.derived_forcings.build(dataset_info)

    def build_loss(self, loss_config: StepLossConfig) -> StepLoss:
        """Build a StepLoss from the given config using this stepper's normalizer
        and dataset info.

        Args:
            loss_config: The loss configuration to build from.

        Returns:
            A StepLoss built using this stepper's loss normalizer, gridded
            operations, loss variable names, and channel dimension.
        """
        loss_normalizer = self._step_obj.get_loss_normalizer()
        return loss_config.build(
            self._dataset_info.gridded_operations,
            out_names=self.loss_names,
            channel_dim=self.CHANNEL_DIM,
            normalizer=loss_normalizer,
        )

    def build_corrector_loss(
        self, corrector_loss: CorrectorLossConfig | None
    ) -> CorrectorLoss | None:
        """Validate and build the corrector-delta half of the training loss,
        if configured.

        Args:
            corrector_loss: Optional. With the null default, this method builds
                nothing.

        Returns:
            A CorrectorLoss, or None when no corrector loss is configured.
        """
        if corrector_loss is None:
            return None
        return corrector_loss.build(
            self.loss_names,
            normalizer=self._step_obj.get_loss_normalizer(),
            channel_dim=self.CHANNEL_DIM,
        )

    @property
    def config(self) -> StepperConfig:
        return self._config

    @property
    def derive_func(self) -> Callable[[TensorMapping, TensorMapping], TensorDict]:
        return self._derive_func

    @property
    def surface_temperature_name(self) -> str | None:
        return self._step_obj.surface_temperature_name

    @property
    def ocean_fraction_name(self) -> str | None:
        return self._step_obj.ocean_fraction_name

    def prescribe_sst(
        self,
        mask_data: TensorMapping,
        gen_data: TensorMapping,
        target_data: TensorMapping,
    ) -> TensorDict:
        """
        Prescribe sea surface temperature onto the generated surface temperature field.

        Args:
            mask_data: Source for the prescriber mask field.
            gen_data: Contains the generated surface temperature field.
            target_data: Contains the target surface temperature that will
                be prescribed onto the generated one according to the mask.
        """
        return self._step_obj.prescribe_sst(mask_data, gen_data, target_data)

    @property
    def training_dataset_info(self) -> DatasetInfo:
        return self._dataset_info

    @property
    def training_variable_metadata(self) -> Mapping[str, VariableMetadata]:
        return self._dataset_info.variable_metadata

    @property
    def training_history(self) -> TrainingHistory:
        return self._training_history

    def _append_training_history_from(
        self, base_training_history: TrainingHistory | None
    ):
        """
        When the stepper receives weights from a base stepper via parameter
        initialization, this helper is used to extend its training history to include
        the training history of the base stepper.

        Args:
            base_training_history: The training history from a base stepper to append.
        """
        if base_training_history is not None:
            self._training_history.extend(base_training_history)

    def replace_multi_call(self, multi_call: MultiCallConfig | None):
        """
        Replace the MultiCall object with a new one. Note this is only
        meant to be used at inference time and may result in the loss
        function being unusable.

        Args:
            multi_call: The new multi_call configuration or None.
        """
        state = self._step_obj.get_state()
        new_state = self._config.replace_multi_call(multi_call, state)
        new_stepper: Stepper = self._config.get_stepper(
            dataset_info=self._dataset_info,
        )
        new_stepper._step_obj.load_state(new_state)
        self._step_obj = new_stepper._step_obj

    def replace_ocean(self, ocean: OceanConfig | None):
        """
        Replace the ocean model with a new one.

        Args:
            ocean: The new ocean model configuration or None.
        """
        self._config.replace_ocean(ocean)
        new_stepper: Stepper = self._config.get_stepper(
            dataset_info=self._dataset_info,
        )
        new_stepper._step_obj.load_state(self._step_obj.get_state())
        self._step_obj = new_stepper._step_obj

    def replace_prescribed_prognostic_names(self, names: list[str]) -> None:
        """
        Replace prescribed prognostic names (e.g. when loading from checkpoint).

        Args:
            names: The new list of prescribed prognostic variable names.
        """
        self._config.replace_prescribed_prognostic_names(names)
        new_stepper: Stepper = self._config.get_stepper(
            dataset_info=self._dataset_info,
        )
        new_stepper._step_obj.load_state(self._step_obj.get_state())
        self._step_obj = new_stepper._step_obj

    def get_prescribed_prognostic_names(self) -> list[str]:
        return self._config.get_prescribed_prognostic_names()

    def replace_corrector(self, corrector: CorrectorSelector) -> None:
        """
        Replace the step's corrector configuration with a new one.

        Args:
            corrector: The new corrector configuration.
        """
        self._config.replace_corrector(corrector)
        new_stepper: Stepper = self._config.get_stepper(
            dataset_info=self._dataset_info,
        )
        new_stepper._step_obj.load_state(self._step_obj.get_state())
        self._step_obj = new_stepper._step_obj

    def replace_derived_forcings(self, derived_forcings: DerivedForcingsConfig):
        """
        Replace the derived forcings configuration with a new one.

        Args:
            derived_forcings: The new derived forcings configuration or None.
        """
        self._config.replace_derived_forcings(derived_forcings)
        self.forcing_deriver = derived_forcings.build(self._dataset_info)

    def get_base_weights(self) -> Weights | None:
        """
        Get the base weights of the stepper.

        Returns:
            A list of weight dictionaries for each module in the stepper.
        """
        return self._parameter_initializer.base_weights

    @property
    def prognostic_names(self) -> frozenset[str]:
        return self._step_obj.prognostic_names

    @property
    def out_names(self) -> frozenset[str]:
        return self._step_obj.output_names

    @property
    def loss_names(self) -> list[str]:
        return self._step_obj.loss_names

    @property
    def n_ic_timesteps(self) -> int:
        return self._step_obj.n_ic_timesteps

    @property
    def modules(self) -> nn.ModuleList:
        """
        Returns:
            A list of modules being trained.
        """
        return self._step_obj.modules

    @property
    def normalizer(self) -> StandardNormalizer:
        return self._step_obj.normalizer

    def step(
        self,
        args: StepArgs,
        wrapper: Callable[[nn.Module], nn.Module] = lambda x: x,
    ) -> StepOutput:
        """
        Step the model forward one timestep given input data.

        Args:
            args: The arguments to the step function.
            wrapper: Wrapper to apply over each nn.Module before calling.

        Returns:
            A ``StepOutput`` carrying the denormalized data at the next time
            step, the per-sample state to thread into the next call (or
            ``None``), and the corrector's per-variable correction diagnostics,
            spatially masked consistently with the output.
        """
        args = args.apply_input_process_func(self._input_process_func)
        random_state = (
            args.stepper_state.random_state if args.stepper_state is not None else None
        )
        with use_generator(None if random_state is None else random_state.generator):
            result = self._step_obj.step(args=args, wrapper=wrapper)
        return StepOutput(
            output=self._output_masking(result.output),
            stepper_state=result.stepper_state,
            corrector_diagnostics=result.corrector_diagnostics.apply_output_masking(
                self._output_masking
            ),
        )

    def get_prediction_generator(
        self,
        initial_condition: PrognosticState,
        forcing_data: BatchData,
        n_forward_steps: int,
        optimizer: OptimizationABC,
    ) -> Generator[StepOutput, None, None]:
        """
        Predict multiple steps forward given initial condition and forcing data.

        Uses low-level inputs and does not compute derived variables, to separate
        concerns from the `predict` method.

        Args:
            initial_condition: The initial condition, containing tensors of shape
                [n_batch, self.n_ic_timesteps, <horizontal_dims>].
            forcing_data: The forcing data, containing tensors of shape
                [n_batch, n_forward_steps + self.n_ic_timesteps, <horizontal_dims>].
            n_forward_steps: The number of forward steps to predict, corresponding
                to the data shapes of forcing_data.
            optimizer: The optimizer to use for updating the module.

        Returns:
            Generator yielding a ``StepOutput`` at each timestep.
        """
        ic_batch_data = initial_condition.as_batch_data()
        if ic_batch_data.labels != forcing_data.labels:
            raise ValueError(
                "Initial condition and forcing data must have the same labels, "
                f"got {ic_batch_data.labels} and {forcing_data.labels}."
            )
        ic_dict = ic_batch_data.data
        forcing_dict = forcing_data.data
        return self.predict_generator(
            ic_dict,
            forcing_dict,
            n_forward_steps,
            optimizer,
            forcing_data.labels,
            data_mask=forcing_data.data_mask,
            stepper_state=ic_batch_data.stepper_state,
        )

    @property
    def _input_only_names(self) -> set[str]:
        return set(self._step_obj.input_names).difference(self._step_obj.output_names)

    def predict_generator(
        self,
        ic_dict: TensorMapping,
        forcing_dict: TensorMapping,
        n_forward_steps: int,
        optimizer: OptimizationABC,
        labels: BatchLabels | None,
        data_mask: TensorMapping | None = None,
        stepper_state: StepperState | None = None,
    ) -> Generator[StepOutput, None, None]:
        state = {k: ic_dict[k].squeeze(self.TIME_DIM) for k in ic_dict}
        for step in range(n_forward_steps):
            input_forcing = {
                k: (
                    forcing_dict[k][:, step]
                    if k not in self._step_obj.next_step_forcing_names
                    else forcing_dict[k][:, step + 1]
                )
                for k in self._input_only_names
            }
            next_step_input_dict = {
                k: forcing_dict[k][:, step + 1]
                for k in self._step_obj.next_step_input_names
            }
            input_data = {**state, **input_forcing}

            def checkpoint(module):
                return optimizer.checkpoint(module, step=step)

            with optimizer.autocast():
                result = self.step(
                    StepArgs(
                        input=input_data,
                        next_step_input_data=next_step_input_dict,
                        labels=labels,
                        data_mask=data_mask,
                        stepper_state=stepper_state,
                    ),
                    wrapper=checkpoint,
                )
            state = result.output
            stepper_state = result.stepper_state
            yield result
            state = optimizer.detach_if_using_gradient_accumulation(state)

    def predict(
        self,
        initial_condition: PrognosticState,
        forcing: BatchData,
        compute_derived_variables: bool = False,
        compute_derived_forcings: bool = True,
    ) -> tuple[BatchData, PrognosticState]:
        """
        Predict multiple steps forward given initial condition and reference data.

        Args:
            initial_condition: Prognostic state data with tensors of shape
                [n_batch, self.n_ic_timesteps, <horizontal_dims>]. This data is assumed
                to contain all prognostic variables and be denormalized.
            forcing: Contains tensors of shape
                [n_batch, self.n_ic_timesteps + n_forward_steps, n_lat, n_lon]. This
                contains the forcing and ocean data for the initial condition and all
                subsequent timesteps.
            compute_derived_variables: Whether to compute derived variables for the
                prediction.
            compute_derived_forcings: Whether to compute derived forcing variables for
                the prediction. Only used to disable computing the derived forcings
                if they have been computed ahead of time.

        Returns:
            A batch data containing the prediction and the prediction's final state
            which can be used as a new initial condition.
        """
        timer = GlobalTimer.get_instance()
        forcing_names = self._input_only_names.union(
            self._step_obj.next_step_input_names
        )

        if compute_derived_forcings:
            forcing = self.forcing_deriver(forcing)

        if forcing.n_ensemble == 1 and initial_condition.as_batch_data().n_ensemble > 1:
            forcing = forcing.broadcast_ensemble(
                n_ensemble=initial_condition.as_batch_data().n_ensemble
            )

        with timer.context("forward_prediction"):
            ic_batch_data = initial_condition.as_batch_data()
            forcing_data = forcing.subset_names(forcing_names)
            if ic_batch_data.n_timesteps != self.n_ic_timesteps:
                raise ValueError(
                    f"Initial condition must have {self.n_ic_timesteps} timesteps, got "
                    f"{ic_batch_data.n_timesteps}."
                )
            n_forward_steps = forcing_data.n_timesteps - self.n_ic_timesteps
            output_list = list(
                self.get_prediction_generator(
                    initial_condition,
                    forcing_data,
                    n_forward_steps,
                    NullOptimization(),
                )
            )
        data = process_prediction_generator_list(
            output_list,
            time=forcing_data.time[:, self.n_ic_timesteps :],
            horizontal_dims=forcing_data.horizontal_dims,
            labels=forcing.labels,
            n_ensemble=forcing.n_ensemble,
        )
        if compute_derived_variables:
            with timer.context("compute_derived_variables"):
                data = (
                    data.prepend(initial_condition)
                    .compute_derived_variables(
                        derive_func=self.derive_func,
                        forcing_data=forcing_data,
                    )
                    .remove_initial_condition(self.n_ic_timesteps)
                )
        prognostic_state = data.get_end(self.prognostic_names, self.n_ic_timesteps)
        # Attach the stacked per-step diagnostics only at this final
        # reconstruction, after the derived-variables prepend/remove dance:
        # here the data and the series are both n_forward_steps long and
        # time-aligned, so the diagnostics never pass through a time-changing
        # BatchData method (which would raise).
        data = BatchData.new_on_device(
            data=data.data,
            time=data.time,
            horizontal_dims=data.horizontal_dims,
            labels=data.labels,
            n_ensemble=data.n_ensemble,
            stepper_state=data.stepper_state,
            step_diagnostics=StepOutput.stack_diagnostics(output_list),
        )
        return data, prognostic_state

    def predict_paired(
        self,
        initial_condition: PrognosticState,
        forcing: BatchData,
        compute_derived_variables: bool = False,
    ) -> tuple[PairedData, PrognosticState]:
        """
        Predict multiple steps forward given initial condition and reference data.

        Args:
            initial_condition: Prognostic state data with tensors of shape
                [n_batch, self.n_ic_timesteps, <horizontal_dims>]. This data is assumed
                to contain all prognostic variables and be denormalized.
            forcing: Contains tensors of shape
                [n_batch, self.n_ic_timesteps + n_forward_steps, n_lat, n_lon]. This
                contains the forcing and ocean data for the initial condition and all
                subsequent timesteps.
            compute_derived_variables: Whether to compute derived variables for the
                prediction.

        Returns:
            A tuple of 1) a paired data object, containing the prediction paired with
            all target/forcing data at the same timesteps, and 2) the prediction's
            final state, which can be used as a new initial condition.
        """
        forcing = self.forcing_deriver(forcing)
        if forcing.n_ensemble == 1 and initial_condition.as_batch_data().n_ensemble > 1:
            forcing = forcing.broadcast_ensemble(
                n_ensemble=initial_condition.as_batch_data().n_ensemble
            )
        prediction, new_initial_condition = self.predict(
            initial_condition,
            forcing,
            compute_derived_variables,
            compute_derived_forcings=False,
        )
        forward_data = self.get_forward_data(
            forcing, compute_derived_variables=compute_derived_variables
        )
        return (
            PairedData.from_batch_data(
                prediction=prediction,
                reference=BatchData.new_on_device(
                    data=forward_data.data,
                    time=forward_data.time,
                    horizontal_dims=forward_data.horizontal_dims,
                    labels=forward_data.labels,
                ),
            ),
            new_initial_condition,
        )

    def get_forward_data(
        self, data: BatchData, compute_derived_variables: bool = False
    ) -> BatchData:
        if compute_derived_variables:
            timer = GlobalTimer.get_instance()
            with timer.context("compute_derived_variables"):
                data = data.compute_derived_variables(
                    derive_func=self.derive_func,
                    forcing_data=data,
                )
        return data.remove_initial_condition(self.n_ic_timesteps)

    def get_regularizer_loss(self) -> torch.Tensor:
        return self._l2_sp_tuning_regularizer() + self._step_obj.get_regularizer_loss()

    def update_training_history(self, training_job: TrainingJob) -> None:
        """
        Update the stepper's history of training jobs.

        Args:
            training_job: The training job to add to the history.
        """
        self._training_history.append(training_job)

    def get_state(self):
        """
        Returns:
            The state of the stepper.
        """
        return {
            "config": self._config.as_loaded_dict(),
            "dataset_info": self._dataset_info.get_state(),
            "step": self._step_obj.get_state(),
            "training_history": self._training_history.get_state(),
        }

    def load_state(self, state: dict[str, Any]) -> None:
        """
        Load the state of the stepper.

        Args:
            state: The state to load.
        """
        self._step_obj.load_state(state["step"])

    @classmethod
    def from_state(cls, state) -> "Stepper":
        """
        Load the state of the stepper.

        Args:
            state: The state to load.

        Returns:
            The stepper.
        """
        try:
            legacy_config = SingleModuleStepperConfig.from_state(state["config"])
            dataset_state = {}
            dataset_state["timestep"] = state.get(
                "encoded_timestep", DEFAULT_ENCODED_TIMESTEP
            )
            if "sigma_coordinates" in state:
                # for backwards compatibility with old checkpoints
                dataset_state["vertical_coordinate"] = state["sigma_coordinates"]
            else:
                dataset_state["vertical_coordinate"] = state["vertical_coordinate"]

            if "area" in state:
                # backwards-compatibility, these older checkpoints are always lat-lon
                dataset_state["gridded_operations"] = {
                    "type": "LatLonOperations",
                    "state": {"area_weights": state["area"]},
                }
            else:
                dataset_state["gridded_operations"] = state["gridded_operations"]

            if "img_shape" in state:
                dataset_state["img_shape"] = state["img_shape"]
            elif "data_shapes" in state:
                for _, shape in state["data_shapes"].items():
                    if len(shape) == 4:
                        dataset_state["img_shape"] = shape[-2:]
                        break

            normalizer = StandardNormalizer.from_state(
                state.get("normalizer", state.get("normalization"))
            )
            if normalizer is None:
                raise ValueError(
                    f"No normalizer state found, keys include {state.keys()}"
                )
            if "loss_normalizer" in state or "loss_normalization" in state:
                loss_normalizer = StandardNormalizer.from_state(
                    state.get("loss_normalizer", state.get("loss_normalization"))
                )
            else:
                loss_normalizer = normalizer
            config = legacy_config.to_stepper_config(
                normalizer=normalizer, loss_normalizer=loss_normalizer
            )
            dataset_info = DatasetInfo.from_state(dataset_state)
            state["step"] = {
                # SingleModuleStep inside MultiCallStep
                "wrapped_step": {"module": state["module"]}
            }
        except dacite.exceptions.DaciteError:
            config = StepperConfig.from_stepper_state(state)
            dataset_info = DatasetInfo.from_state(state["dataset_info"])
        training_history = TrainingHistory.from_state(state.get("training_history", []))
        stepper = config.get_stepper(
            dataset_info=dataset_info,
            training_history=training_history,
            # no parameter_initializer: we're about to load_state
        )
        stepper.load_state(state)
        return stepper

    def set_eval(self) -> None:
        self._step_obj.eval()

    def set_train(self) -> None:
        self._step_obj.train()

    def set_epoch(self, epoch: int) -> None:
        self._step_obj.set_epoch(epoch)
        for module in self.modules:
            for submodule in module.modules():
                request_reset = getattr(
                    submodule, "request_latent_global_mean_envelope_reset", None
                )
                if callable(request_reset):
                    request_reset()


@dataclasses.dataclass
class TrainStepperConfig:
    """
    Configuration for training-specific aspects of a stepper.

    Parameters:
        loss: The loss configuration.
        optimize_last_step_only: Whether to optimize only the last step.
        pushforward_steps: The number of initial forward steps that are not
            optimized (the "pushforward trick"). These steps are run without
            gradients and do not contribute to the optimized loss, so the model
            is trained on inputs it produced itself without being asked to
            improve the steps that produced them. Must be less than the number
            of loss steps. Cannot be combined with optimize_last_step_only or
            with a sampled or scheduled n_forward_steps.
            The aggregate ``loss`` metric, including the validation loss used
            to select the best checkpoint, sums only the optimized steps.
        n_ensemble: The number of ensemble members evaluated for each training
            batch member. Default is 2 if the loss type is EnsembleLoss, otherwise
            the default is 1. Must be 2 for EnsembleLoss to be valid.
        n_forward_steps: The number of timesteps to train on and associated
            sampling probabilities. By default, the stepper will train on the full
            number of timesteps present in the training dataset samples. Values must
            be less than or equal to the number of timesteps present
            in the training dataset samples.
        parameter_init: The parameter initialization configuration for fine-tuning.
        corrector_loss: Optional configuration for consuming the corrector's
            correction deltas in the loss.
    """

    loss: StepLossConfig = dataclasses.field(default_factory=lambda: StepLossConfig())
    optimize_last_step_only: bool = False
    pushforward_steps: int = 0
    n_ensemble: int = -1  # sentinel value to avoid None typing of attribute
    n_forward_steps: TimeLength | TimeLengthSchedule | None = None
    parameter_init: ParameterInitializationConfig = dataclasses.field(
        default_factory=lambda: ParameterInitializationConfig()
    )
    corrector_loss: CorrectorLossConfig | None = None

    def __post_init__(self):
        if self.pushforward_steps < 0:
            raise ValueError(
                f"pushforward_steps must be non-negative, got {self.pushforward_steps}"
            )
        if self.pushforward_steps > 0 and self.optimize_last_step_only:
            raise ValueError(
                "pushforward_steps cannot be combined with optimize_last_step_only"
            )
        if self.pushforward_steps > 0 and self.n_forward_steps is not None:
            if not isinstance(self.n_forward_steps, int):
                raise ValueError(
                    "pushforward_steps cannot be combined with a sampled or "
                    "scheduled n_forward_steps"
                )
            if self.pushforward_steps >= self.n_forward_steps:
                raise ValueError(
                    f"pushforward_steps ({self.pushforward_steps}) must be less "
                    f"than n_forward_steps ({self.n_forward_steps})"
                )
        if self.n_ensemble == -1:
            if self.loss.type == "EnsembleLoss":
                self.n_ensemble = 2
            else:
                self.n_ensemble = 1

    @property
    def n_forward_steps_schedule(self) -> TimeLengthSchedule | None:
        if self.n_forward_steps is None:
            return None
        if isinstance(self.n_forward_steps, TimeLengthSchedule):
            return self.n_forward_steps
        return TimeLengthSchedule.from_constant(self.n_forward_steps)

    def _get_parameter_initializer(
        self,
        load_weights_and_history_fn: WeightsAndHistoryLoader = load_weights_and_history,
    ) -> ParameterInitializer:
        """
        Build a ParameterInitializer from this configuration.

        Args:
            load_weights_and_history_fn: Function for loading weights and history.
                Default implementation loads a Trainer checkpoint containing
                a Stepper.
        """
        return self.parameter_init.build(
            load_weights_and_history=load_weights_and_history_fn
        )

    def get_train_stepper(
        self,
        stepper_config: StepperConfig,
        dataset_info: DatasetInfo,
        load_weights_and_history_fn: WeightsAndHistoryLoader = load_weights_and_history,
    ) -> "TrainStepper":
        """
        Build a TrainStepper from this configuration and a StepperConfig.

        Builds the ParameterInitializer from this config's parameter_init,
        passes it to StepperConfig.get_stepper() for weight loading and
        freezing during model construction, then wraps the result in a
        TrainStepper.

        Args:
            stepper_config: The stepper configuration for building the model.
            dataset_info: Information about the training dataset.
            load_weights_and_history_fn: Function for loading weights and
                history. Default implementation loads a Trainer checkpoint
                containing a Stepper.

        Returns:
            A TrainStepper wrapping the built stepper with training
            functionality.
        """
        parameter_initializer = self._get_parameter_initializer(
            load_weights_and_history_fn
        )
        stepper = stepper_config.get_stepper(
            dataset_info=dataset_info,
            parameter_initializer=parameter_initializer,
        )
        return TrainStepper(
            stepper=stepper,
            config=self,
        )


def _finalize_per_channel_losses(
    weighted_sums: dict[str, torch.Tensor],
    total_counts: dict[str, int],
) -> dict[str, ChannelLossInfo] | None:
    if not weighted_sums:
        return None
    return {
        k: ChannelLossInfo(
            loss=weighted_sums[k] / max(total_counts[k], 1),
            count=total_counts[k],
        )
        for k in weighted_sums
    }


class TrainStepper(
    TrainStepperABC[
        PrognosticState,
        BatchData,
        BatchData,
        PairedData,
        TrainOutput,
    ]
):
    """
    Wrapper around Stepper that adds training functionality.

    This class composes a Stepper (for inference) with training-specific
    configuration and implements the train_on_batch method.
    """

    TIME_DIM = 1
    CHANNEL_DIM = -3

    def __init__(
        self,
        stepper: Stepper,
        config: TrainStepperConfig,
    ):
        """
        Args:
            stepper: The underlying stepper for inference operations.
            config: Training-specific configuration.
        """
        self._stepper = stepper
        self._config = config
        self._loss_schedule = LossSchedule(
            n_forward_steps_schedule=config.n_forward_steps_schedule,
        )

        self._prognostic_names = self._stepper.prognostic_names
        self._derive_func = self._stepper.derive_func
        self._loss_obj = StepOutputLoss(
            self._stepper.build_loss(config.loss),
            self._stepper.build_corrector_loss(config.corrector_loss),
        )

    def train_on_batch(
        self,
        data: BatchData,
        optimization: OptimizationABC,
        compute_derived_variables: bool = False,
        evaluate_all_steps: bool = False,
    ) -> TrainOutput:
        """
        Train the model on a batch of data with one or more forward steps.

        If gradient accumulation is used by the optimization, the computational graph is
        detached between steps to reduce memory consumption. This means the model learns
        how to deal with inputs on step N but does not try to improve the behavior at
        step N by modifying the behavior for step N-1.

        Args:
            data: The batch data where each tensor in data.data has shape
                [n_sample, n_forward_steps + self.n_ic_timesteps, <horizontal_dims>].
            optimization: The optimization class to use for updating the module.
                Use `NullOptimization` to disable training.
            compute_derived_variables: Whether to compute derived variables for the
                prediction and target data.
            evaluate_all_steps: When True, run all available forward steps and
                compute per-step metrics for each, but only count steps within
                the stochastically-sampled range toward the accumulated loss.

        Returns:
            The loss metrics, the generated data, the normalized generated data,
                and the normalized batch data.
        """
        self._loss_schedule.init_for_epoch(data.epoch)
        n_data_steps = data.time.shape[1] - self.n_ic_timesteps
        n_loss_steps = self._loss_schedule.sample(n_data_steps)
        if self._config.pushforward_steps >= n_loss_steps:
            raise ValueError(
                f"pushforward_steps ({self._config.pushforward_steps}) must be "
                f"less than the number of loss steps ({n_loss_steps})"
            )
        metrics: dict[str, float] = {}
        target_data = self._stepper.get_forward_data(
            data, compute_derived_variables=False
        )
        data = self._stepper.forcing_deriver(data)

        optimization.set_mode(self._stepper.modules)
        output_list, per_channel_losses = self._accumulate_loss(
            data,
            target_data,
            optimization,
            metrics,
            n_forward_steps=n_data_steps if evaluate_all_steps else n_loss_steps,
            n_loss_steps=n_loss_steps,
        )

        regularizer_loss = self._stepper.get_regularizer_loss()
        if torch.any(regularizer_loss > 0):
            optimization.accumulate_loss(regularizer_loss)
        metrics["loss"] = optimization.get_accumulated_loss().detach()
        optimization.step_weights()

        gen_data = process_ensemble_prediction_generator_list(output_list)

        stepped = TrainOutput(
            metrics=metrics,
            gen_data=gen_data,
            target_data=add_ensemble_dim(target_data.data),
            time=target_data.time,
            normalize=self.normalizer.normalize,
            derive_func=self._derive_func,
            per_channel_losses=per_channel_losses,
        )
        ic = data.get_start(
            set(data.data.keys()), self.n_ic_timesteps
        )  # full data and not just prognostic get prepended
        stepped = stepped.prepend_initial_condition(ic)
        if compute_derived_variables:
            stepped = stepped.compute_derived_variables()
        # apply post-processing and return
        return stepped

    def _accumulate_loss(
        self,
        data: BatchData,
        target_data: BatchData,
        optimization: OptimizationABC,
        metrics: dict[str, float],
        n_forward_steps: int,
        n_loss_steps: int,
    ) -> tuple[list[EnsembleTensorDict], dict[str, ChannelLossInfo] | None]:
        input_data = data.get_start(self._prognostic_names, self.n_ic_timesteps)
        n_ensemble = self._config.n_ensemble
        input_batch_data = input_data.as_batch_data()
        if input_batch_data.labels != data.labels:
            raise ValueError(
                "Initial condition and forcing data must have the same labels, "
                f"got {input_batch_data.labels} and {data.labels}."
            )
        input_ensemble_data = input_data.as_batch_data().broadcast_ensemble(n_ensemble)
        forcing_ensemble_data = data.broadcast_ensemble(n_ensemble)
        output_generator = self._stepper.predict_generator(
            input_ensemble_data.data,
            forcing_ensemble_data.data,
            n_forward_steps,
            optimization,
            labels=input_ensemble_data.labels,
            data_mask=forcing_ensemble_data.data_mask,
            stepper_state=input_ensemble_data.stepper_state,
        )
        output_list: list[EnsembleTensorDict] = []
        output_iterator = iter(output_generator)
        weighted_sums: dict[str, torch.Tensor] = {}
        total_counts: dict[str, int] = {}
        for step in range(n_forward_steps):
            if self._config.optimize_last_step_only:
                optimize_step = step == n_loss_steps - 1
            else:
                optimize_step = self._config.pushforward_steps <= step < n_loss_steps
            grad_context = (
                contextlib.nullcontext() if optimize_step else torch.no_grad()
            )
            with grad_context:
                step_output = next(output_iterator)
                gen_step = unfold_ensemble_dim(
                    step_output.output, n_ensemble=n_ensemble
                )
                output_list.append(gen_step)
                # Deltas come from the StepOutput, never the StepDiagnostics carriage.
                deltas = unfold_ensemble_dim(
                    dict(step_output.corrector_diagnostics.delta),
                    n_ensemble=n_ensemble,
                )
                target_step = add_ensemble_dim(
                    {
                        k: v.select(self.TIME_DIM, step)
                        for k, v in target_data.data.items()
                    }
                )
                step_total_loss = self._accumulate_step_loss(
                    gen_step=gen_step,
                    target_step=target_step,
                    step=step,
                    data_mask=data.data_mask,
                    optimize=optimize_step,
                    metrics=metrics,
                    weighted_sums=weighted_sums,
                    total_counts=total_counts,
                    deltas=deltas,
                )
            if optimize_step:
                optimization.accumulate_loss(step_total_loss)
        return output_list, _finalize_per_channel_losses(weighted_sums, total_counts)

    def _accumulate_step_loss(
        self,
        gen_step: EnsembleTensorDict,
        target_step: TensorMapping,
        step: int,
        data_mask: TensorMapping | None,
        optimize: bool,
        metrics: dict[str, float],
        weighted_sums: dict[str, torch.Tensor],
        total_counts: dict[str, int],
        deltas: TensorMapping,
    ) -> torch.Tensor:
        step_loss = self._loss_obj(
            gen_step,
            target_step,
            step=step,
            data_mask=data_mask,
            deltas=deltas,
        )
        step_total_loss = step_loss.total()
        metrics[f"loss_step_{step}"] = step_total_loss.detach()
        if optimize:
            per_ch = step_loss.get_channel_losses()
            for k, v in per_ch.items():
                if k in weighted_sums:
                    weighted_sums[k] = weighted_sums[k] + v.loss.detach() * v.count
                    total_counts[k] = total_counts[k] + v.count
                else:
                    weighted_sums[k] = v.loss.detach() * v.count
                    total_counts[k] = v.count
        return step_total_loss

    def update_training_history(self, training_job: TrainingJob) -> None:
        """
        Update the stepper's history of training jobs.

        Args:
            training_job: The training job to add to the history.
        """
        self._stepper.update_training_history(training_job)

    def get_state(self) -> dict[str, Any]:
        return self._stepper.get_state()

    def load_state(self, state: dict[str, Any]) -> None:
        self._stepper.load_state(state)

    def get_base_weights(self):
        """Get the base weights of the underlying stepper."""
        return self._stepper.get_base_weights()

    @property
    def modules(self) -> nn.ModuleList:
        return self._stepper.modules

    @property
    def n_ic_timesteps(self) -> int:
        return self._stepper.n_ic_timesteps

    @property
    def normalizer(self):
        return self._stepper.normalizer

    @property
    def loss_names(self) -> list[str]:
        return self._stepper.loss_names

    def predict_paired(
        self,
        initial_condition: PrognosticState,
        forcing: BatchData,
        compute_derived_variables: bool = False,
    ) -> tuple[PairedData, PrognosticState]:
        return self._stepper.predict_paired(
            initial_condition, forcing, compute_derived_variables
        )

    def seed_eval(self, seed: int) -> None:
        self._loss_schedule.seed_eval(seed)

    def set_eval(self) -> None:
        self._loss_schedule.set_eval()
        self._stepper.set_eval()

    def set_train(self) -> None:
        self._loss_schedule.set_train()
        self._stepper.set_train()

    def set_epoch(self, epoch: int) -> None:
        self._stepper.set_epoch(epoch)


def get_serialized_stepper_vertical_coordinate(
    state: dict[str, Any],
) -> VerticalCoordinate:
    if "vertical_coordinate" in state:
        return dacite.from_dict(
            data_class=SerializableVerticalCoordinate,
            data={"vertical_coordinate": state["vertical_coordinate"]},
            config=dacite.Config(strict=True),
        ).vertical_coordinate
    elif "sigma_coordinates" in state:
        return dacite.from_dict(
            data_class=SerializableVerticalCoordinate,
            data={"vertical_coordinate": state["sigma_coordinates"]},
            config=dacite.Config(strict=True),
        ).vertical_coordinate
    else:
        dataset_info = DatasetInfo.from_state(state["dataset_info"])
        return dataset_info.vertical_coordinate


@dataclasses.dataclass
class StepperOverrideConfig:
    """
    Configuration for overriding stepper configuration options.

    The default value for each parameter is ``"keep"``, which denotes that the
    serialized stepper's configuration will not be modified when loaded. Passing
    other values will override the configuration of the loaded stepper.

    Parameters:
        ocean: Ocean configuration to override that used in producing a serialized
            stepper.
        multi_call: MultiCall configuration to override that used in producing a
            serialized stepper.
        derived_forcings: Derived forcings configuration to override that used in
            producing a serialized stepper.
        prescribed_prognostic_names: List of prognostic variable names to overwrite
            from forcing at each step during inference.
        corrector: Corrector configuration to replace that used in producing a
            serialized stepper. Options not restated here fall back to their
            defaults, not to the checkpoint's values. For example::

                corrector:
                  type: atmosphere_corrector
                  config:
                    conserve_dry_air: true
                    total_energy_budget_correction:
                      method: constant_temperature
    """

    ocean: Literal["keep"] | OceanConfig | None = "keep"
    multi_call: Literal["keep"] | MultiCallConfig | None = "keep"
    derived_forcings: Literal["keep"] | DerivedForcingsConfig = "keep"
    prescribed_prognostic_names: Literal["keep"] | list[str] = "keep"
    corrector: Literal["keep"] | CorrectorSelector = "keep"

    def __post_init__(self):
        if self.corrector != "keep" and not self.corrector.training_is_default():
            raise ValueError(
                "StepperOverrideConfig.corrector must not set training-only "
                "options such as corrector_disabled_epochs."
            )


def load_stepper_config(
    checkpoint_path: str | pathlib.Path,
) -> StepperConfig:
    """Load a stepper configuration from a checkpoint without instantiating
    the model.

    Args:
        checkpoint_path: The path to the serialized checkpoint.

    Returns:
        The configuration of the stepper serialized in the checkpoint.
    """
    checkpoint = torch.load(checkpoint_path, map_location="cpu", weights_only=False)
    return StepperConfig.from_stepper_state(checkpoint["stepper"])


def load_stepper_config_with_override(
    checkpoint_path: str | pathlib.Path,
    override_config: StepperOverrideConfig | None = None,
) -> StepperConfig:
    """Load a stepper configuration, optionally overriding certain aspects.

    Args:
        checkpoint_path: The path to the serialized checkpoint.
        override_config: Configuration options to override (optional).

    Returns:
        The configuration of the stepper serialized in the checkpoint, with
        appropriate options overridden.
    """
    if override_config is None:
        return load_stepper_config(checkpoint_path)
    stepper = load_stepper(checkpoint_path, override_config)
    return stepper._config


def load_stepper(
    checkpoint_path: str | pathlib.Path,
    override_config: StepperOverrideConfig | None = None,
    use_ema_if_available: bool = False,
) -> Stepper:
    """Load a stepper, optionally overriding certain aspects.

    Args:
        checkpoint_path: The path to the serialized checkpoint.
        override_config: Configuration options to override (optional).
        use_ema_if_available: If True and the checkpoint contains EMA weights,
            use them in place of the stepper weights.

    Returns:
        The stepper serialized in the checkpoint, with appropriate options
        overridden.
    """
    checkpoint = torch.load(checkpoint_path, map_location="cpu", weights_only=False)
    stepper = Stepper.from_state(checkpoint["stepper"])
    if use_ema_if_available:
        load_ema_params_if_available(checkpoint, stepper.modules, str(checkpoint_path))
    apply_stepper_override(stepper, override_config)
    return stepper


def apply_stepper_override(
    stepper: Stepper, override_config: StepperOverrideConfig | None = None
) -> None:
    """Apply optional inference-time overrides to a loaded stepper.

    Used by load_stepper and by coupled inference when loading component steppers.
    """
    _apply_stepper_override(stepper, stepper.replace_multi_call, override_config)


def apply_stepper_override_to_stepper_config(
    stepper_config: StepperConfig,
    override_config: StepperOverrideConfig | None = None,
) -> None:
    """Apply optional inference-time overrides to a ``StepperConfig``.

    Mirrors :func:`apply_stepper_override` for a config that is not backed by a
    built ``Stepper`` (e.g. when computing data requirements before loading
    weights). A ``multi_call`` override is rejected because replacing it needs
    the serialized step state, which only a full ``Stepper`` carries.
    """

    def reject_multi_call(multi_call: MultiCallConfig | None) -> None:
        raise ValueError(
            "StepperOverrideConfig.multi_call cannot be applied to a StepperConfig "
            "without a built Stepper; load the full Stepper to override multi_call."
        )

    _apply_stepper_override(stepper_config, reject_multi_call, override_config)


def _apply_stepper_override(
    target: Stepper | StepperConfig,
    replace_multi_call: Callable[[MultiCallConfig | None], None],
    override_config: StepperOverrideConfig | None,
) -> None:
    if override_config is None:
        override_config = StepperOverrideConfig()
    if override_config.ocean != "keep":
        logging.info(
            "Overriding training ocean configuration with a new ocean configuration."
        )
        target.replace_ocean(override_config.ocean)
    if override_config.multi_call != "keep":
        logging.info(
            "Overriding training multi_call configuration with a new "
            "multi_call configuration."
        )
        replace_multi_call(override_config.multi_call)
    if override_config.derived_forcings != "keep":
        logging.info(
            "Overriding training derived_forcings configuration with a new "
            "derived_forcings configuration."
        )
        target.replace_derived_forcings(override_config.derived_forcings)
    if override_config.prescribed_prognostic_names != "keep":
        logging.info(
            "Overriding prescribed_prognostic_names with %s.",
            override_config.prescribed_prognostic_names,
        )
        target.replace_prescribed_prognostic_names(
            override_config.prescribed_prognostic_names
        )
    if override_config.corrector != "keep":
        logging.info(
            "Overriding training corrector configuration with %s.",
            override_config.corrector,
        )
        target.replace_corrector(override_config.corrector)
