ai2cm/ace/fme/core/optimization.py

import contextlib
import dataclasses
import itertools
import warnings
from collections.abc import Callable, Collection, Iterable, Mapping, Sequence
from typing import Any, Literal, TypeAlias

import numpy as np
import torch
from torch import nn

from fme.core.device import get_device
from fme.core.generics.optimization import OptimizationABC, OptimizationModules
from fme.core.muon import ADJUST_LR_FNS as MUON_ADJUST_LR_FNS
from fme.core.muon import Muon, check_muon_state_dict_compatible
from fme.core.scheduler import LRScheduler, SchedulerConfig, SequentialSchedulerConfig
from fme.core.typing_ import TensorDict, TensorMapping


class Checkpoint:
    def __init__(self, kwargs: Mapping[str, Any]):
        self._kwargs = kwargs

    def __call__(self, module: nn.Module):
        def wrapped(*args):
            return torch.utils.checkpoint.checkpoint(
                module,
                *args,
                use_reentrant=False,
                **self._kwargs,
            )

        return wrapped


class NoCheckpoint:
    def __call__(self, module: nn.Module):
        return module


@dataclasses.dataclass
class CheckpointConfig:
    """
    Configuration for activation checkpointing.

    Trades increased computation in exchange for lowered memory consumption during
    training by recomputing activations in the backward pass.

    Parameters:
        after_n_forward_steps: Number of forward steps to generate before activation
            checkpointing is applied. Activation checkpointing is not used unless this
            number is less than the number of forward steps in the optimization.
        kwargs: Keyword arguments to pass to torch.utils.checkpoint.checkpoint.
            Note that use_reentrant=False is always explicitly passed
            as is recommended by the docs.
    """

    after_n_forward_steps: float = np.inf
    kwargs: Mapping[str, Any] = dataclasses.field(default_factory=dict)

    def build(self, step: int) -> Checkpoint | NoCheckpoint:
        """
        Builds a checkpoint function.

        Args:
            step: The current zero-indexed step number.

        Returns:
            A checkpoint function.
        """
        if step >= self.after_n_forward_steps:
            return Checkpoint(self.kwargs)
        else:
            return NoCheckpoint()


_MUON_KWARGS = frozenset(
    {
        "momentum",
        "nesterov",
        "weight_decay",
        "ns_steps",
        "adjust_lr_fn",
        "adamw_lr",
        "adamw_betas",
        "adamw_eps",
        "adamw_weight_decay",
    }
)


def _split_muon_parameters(
    named_parameters: Iterable[tuple[str, torch.nn.Parameter]],
    adamw_names: Sequence[str],
) -> tuple[list[torch.nn.Parameter], list[torch.nn.Parameter]]:
    """Split parameters into (Muon, AdamW) lists.

    Parameters with ``ndim >= 2`` go to Muon unless their name contains one of
    ``adamw_names``; all others go to AdamW.

    Raises:
        ValueError: If an entry of ``adamw_names`` matches no parameter name.
    """
    muon_params: list[torch.nn.Parameter] = []
    adamw_params: list[torch.nn.Parameter] = []
    unmatched = set(adamw_names)
    for name, param in named_parameters:
        matches = {pattern for pattern in adamw_names if pattern in name}
        unmatched -= matches
        if param.ndim >= 2 and not matches:
            muon_params.append(param)
        else:
            adamw_params.append(param)
    if unmatched:
        raise ValueError(
            "OptimizationConfig.adamw_names entries matched no parameter "
            f"name: {sorted(unmatched)}"
        )
    return muon_params, adamw_params


def _build_optimizer(
    optimizer_type: Literal["Adam", "FusedAdam", "AdamW", "Muon"],
    named_parameters: Iterable[tuple[str, torch.nn.Parameter]],
    lr: float,
    kwargs: Mapping[str, Any],
    adamw_names: Sequence[str] = (),
) -> torch.optim.Optimizer:
    if optimizer_type == "Muon":
        muon_params, adamw_params = _split_muon_parameters(
            named_parameters, adamw_names
        )
        return Muon(muon_params, adamw_params, lr=lr, **kwargs)
    parameters = [param for _, param in named_parameters]
    if optimizer_type == "FusedAdam":
        return torch.optim.AdamW(parameters, lr=lr, fused=True, **kwargs)
    elif optimizer_type == "Adam":
        return torch.optim.Adam(parameters, lr=lr, **kwargs)
    elif optimizer_type == "AdamW":
        return torch.optim.AdamW(parameters, lr=lr, **kwargs)
    else:
        raise ValueError(f"Unknown optimizer type: {optimizer_type}")


def flatten_optimization_modules(modules: OptimizationModules) -> nn.ModuleList:
    """Concatenate per-component module lists in key order; a module list is
    returned unchanged.
    """
    if isinstance(modules, Mapping):
        return nn.ModuleList(
            [module for component in modules.values() for module in component]
        )
    return modules


def _step_scheduler(
    scheduler: LRScheduler, valid_loss: float | None, is_iteration: bool
) -> None:
    if scheduler.should_step(is_iteration):
        try:
            if valid_loss is not None:
                scheduler.step(metrics=valid_loss)
            else:
                scheduler.step()
        except TypeError:
            # Some schedulers don't accept metrics argument
            scheduler.step()


def _load_optimizer_state_for_finetuning(
    optimizer: torch.optim.Optimizer, optimizer_state_dict: dict[str, Any]
) -> None:
    """Load per-parameter running state, keeping ``optimizer``'s per-group
    hyperparameters. See ``Optimization.load_optimizer_state_for_finetuning``.
    """
    check_muon_state_dict_compatible(optimizer, optimizer_state_dict)
    fresh_hparams = [
        {k: v for k, v in g.items() if k != "params"} for g in optimizer.param_groups
    ]
    try:
        optimizer.load_state_dict(optimizer_state_dict)
    except ValueError as e:
        raise ValueError(
            "Failed to load optimizer state for fine-tuning: parameter "
            "groups in the checkpoint are incompatible with the "
            "freshly-built optimizer (e.g. group count or per-group "
            "parameter count mismatch). This typically indicates the "
            "model architecture or trainable-parameter set changed "
            "between the source checkpoint and the current run. "
            f"Underlying error: {e}"
        ) from e
    for group, hparams in zip(optimizer.param_groups, fresh_hparams):
        for k in list(group.keys()):
            if k != "params":
                del group[k]
        group.update(hparams)
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
