ai2cm/ace/(commit log)

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2023-04-18 Move train/inference code to fme package (#23)
    * Move FourCastNet training/inference code to fme package
    * Make models/FourCastNet a python package
    * Move Makefile to top level
    * Add 'fme' docker image
    * Rename FourCastNet package to fourcastnet
    * Copy code to more useful place for dev work
    * Add some dev tooling
    * Fix paths for train+inf script
    [constants.py, inference.py, logging_utils.py, train.py]
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2023-04-24 Beakerid to wandb (#38)
    Logs the beaker experiment id so that it shows up in wandb logs.
    resolves #3
    [inference.py, logging_utils.py, train.py]
2023-04-24 Do inference in integration test (#39)
    By calling the inference script as part of the integration test, we get
    some coverage of the model checkpointing/loading. This is also a better
    reflection of our standard training procedure which includes a call to
    the inference script after training completes. A downside of this PR is
    that the integration test is slower: about 30s now, counting both model
    architectures.
    Adding inference to the integration test revealed a bug in the code in
    which training was exiting before the last epoch is checkpointed. This
    bug is fixed.
    Resolves #31 and resolves #32
    [inference.py, train.py]
2023-04-25 Delete unused features in train.py and inference.py (#44)
    There are various features which we are not using. And if we want to use
    a similar feature in the future (e.g. adding new 'fixed' inputs like
    orography or something else) we would want to implement in a more
    general way. So deleting these features will make it easier to
    understand and refactor the existing code. There are also some changes
    to the formatting (mostly trying to reduce line lengths so that code is
    more easily readable).
    This PR will be easier to review commit-by-commit.
    [inference.py, train.py]
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2023-05-01 Refactor test_train to use single process, allowing debugging (#57)
    The current test_train for fcn_training uses subprocess to launch the
    code, preventing the use of `pytest --pdb`. This PR refactors that code
    to call a `main` routine we can call directly from the test, enabling
    debugger support.
    [inference.py, train.py]
2023-05-04 Fix relative imports so that unit tests pass (#64)
    I didn't merge main into my branch before merging #51, and now the unit
    tests break on main because of some import issues. This PR fixes those.
    [train.py]
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2023-05-05 Do integration test using batch job submission script (#71)
    This ensures we have coverage of how batch jobs are actually submitted.
    For convenience, a "debug" arg is added to `test_train_and_inference` so
    that users can submit via calling the main functions and use pdb.
    Resolves #72
    [train.py]
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2023-05-09 Restore stripping of 'module.' in inference load_model (#81)
    When models are saved with a training job that uses more than one GPU,
    the keys in the "model state dict" are prepended with `.module` which
    leads to this hacky code to remove this on loading. We should make a
    more robust dumping/loading code, but this restores previous behavior
    and works for now.
    Resolves #79
    ---------
    [inference.py]
2023-05-09 Remove unused params (#76)
    The training code has many configuration options we don't currently use,
    or which we plan to re-implement if we ever do use them. This PR removes
    some of them and adds TODOs for other changes.
    Removed parameters:
    - add_grid
    - crop_size_x
    - crop_size_y
    - add_noise
    - noise_std
    - add_grid
    - gridtype
    - roll
    - epsilon_factor
    - removed unused timing logic in training script
    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
    [constants.py, train.py]
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2023-05-11 activate wandb resume (#82)
    Flip on wandb's resume flag and instruct it where to resume from (e.g. set wandb_dir).
    [inference.py, train.py]
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2023-05-25 Use unit-tested FME metric code (#110)
    Moves all of the validation and inference metrics to use unit-tested
    code from fme.core.metrics.
    Also fixes some small issues with validation metrics that cropped up in
    #89
    Resolves #1
    [inference.py, metrics.py, train.py]
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2023-05-26 Fix multi gpu resume of training (#119)
    Resolves #118 and adds a test to ensure resumption of training will work
    on multiple GPUs.
    [stepper.py]
2023-05-30 Fix inference when there is an input-only variable (#121)
    This PR fixes an error in inference when an input-only variable exists,
    and modifies the training integration test to use an additional
    input-only variable.
    Resolves #120
    [inference.py]
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2023-06-09 Use resume=False when running inference (#144)
    Resolves #143.
    [Beaker
    run](https://beaker.org/ex/01H2G944VM2106JFY4VVVQSWYC/tasks/01H2G944VPT12YJK8K3TSSTY5B/job/01H2G94PPKJFZ62DGJ9335CCVA)
    testing this code.
    [inference.py, train.py, train_config.py]
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2023-06-26 Rewrite inference script using new objects (#157)
    There are several issues with the current inference script:
    - #140 netCDFs don't include input-only variables
    - #138 cannot specify a different output location for inference than the
    model weight location
    - #111 inference output doesn't contain metadata
    - #61 cannot run initial condition ensembles
    Additionally, we've made significant refactors to metrics in the
    training code by using aggregators, and have left out inference for this
    refactor so far.
    This PR refactors inference to use the new metrics aggregator pattern,
    and fixes each of these issues. In particular, we've implemented new
    aggregator features for video data and ne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
    [inference.py, stepper.py, train.py, train_config.py]
2023-07-13 Allow standalone inference on more than one sample (#178)
    This PR updates the standalone inference so it can be configured and run
    on more than one sample.
    Functionally there are no other changes, though because of
    confusing/hacky ways the APIs were previously used, it should be noted
    that aggregators are no longer used to store any netCDF data during
    inference. These were previously only used to store ensemble-mean
    values, but only on a single value so that it corresponded to raw data.
    Because of this previous (and now removed) restriction, no user
    functionality has changed. Saving ensemble-mean [time, lat, lon] metrics
    is left to a future PR.
    Instead, raw data is stored direc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
    [data_writer.py, inference.py, train.py]
2023-07-14 Handle float-valued prescriber masks (#184)
    This PR closes #180:
    - Rounds Prescriber mask data and casts to integer before comparing with
    mask value.
    - Checks for presence of variable in stats data when attempting to
    applying standardization. This is helpful in the E3SMV2 case, where
    the masking variable OCNFRAC doesn't require any scaling.
    - Fails on NormalizationConfig build when stats are missing an expected
    key.
    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
    [normalizer.py, prescriber.py]
2023-07-19 Allow stepper to be loaded without stats files existing (#189)
    Currently when a stepper is loaded, it attempts to load the stats files
    from the initial location they were located as a side-effect, even
    though the data is stored in the saved stepper. This PR fixes that bug.
    [normalizer.py, stepper.py]
2023-07-19 Fix bug in DataWriter where only one variable gets written (#187)
    Previously data writing was not contained within the for loop over
    variable name in DataWriter. This PR fixes that bug.
    [data_writer.py]
2023-07-20 add area weights as agg class property (#188)
    This PR adds spherical area weights to the relevant metric aggregators.
    We need this to handle the Gaussian grid, whereas originally it was
    hardcoded to the equiangular grid.
    - The approach is mainly to add area_weights as a class member, and
    remove the code that computed it automatically.
    - There is also a change to the core metrics.py code which replaces the
    hard coded latitude coordinate with a function argument.
    - Also included in this PR: adjustments to unit tests and function namespacing to keep everything consistent
    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
    [inference.py, metrics.py, train.py]
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2023-07-25 Stop requiring mask variable in stats data (#173)
    This PR adds a new `normalize_names` property to
    `SingleModuleStepperConfig` so that it is no longer necessary that mask
    variables (for which we only used denormalized versions) are contained
    in statistics files.
    Resolves #174
    [stepper.py]
2023-07-26 Allow infinitely long standalone inference (#179)
    This PR updates inference so that it can be run on indefinitely long
    timeseries. It does this by adding a
    `fcn_training.inference.loop.run_inference` helper function which
    iteratively calls `stepper.run_on_batch` and uses the final condition of
    a time window as the initial condition of the next time window.
    Config breaking changes:
    - inference_n_forward_steps in training configuration is replaced with
    an inference section specified by InlineInferenceConfig
    - forward_steps_in_memory is added to the inference configuration
    - inference is now run identically on all processors using identical
    data, which removes bene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
    [inference.py, loop.py, stepper.py]
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2023-07-27 Add the dry air mass metric (#208)
    First attempt at incorporating the dry air mass computation as a new
    metric. Correctness is verified in [this
    notebook](https://github.com/ai2cm/explore/blob/4ffaca70a59af3eebaabf5457e3261614bd19171/gideond/full-model-emulation/2023-07-21-dry-air-mass.ipynb).
    [metrics.py]
2023-07-27 Make datasets type safe (#209)
    This PR resolves a few issues with our dataset handling:
    - As we find more requirements of our datasets, we've been adding new
    attributes to DataLoader. This causes typing issues and `type: ignore`
    statements in other parts of the code that expect a torch DataLoader, as
    this type does not have the extra attributes. This PR moves them to a
    new statically-typed class.
    - `get_data_loader` has several return values and its call signature is
    input-dependent. This PR updates the return value to a static type that
    can be accessed by attributes instead of less clear integer indexing.
    - It is difficult to detect whether our datasets support different
    required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
    [inference.py, train.py]
2023-07-28 Fix wrong nlat/nlon in transform (#215)
    Resolves #214.
    Interfaces are refactored to use `img_shape` instead of `img_shape_x`
    and `img_shape_y`, to avoid this kind of bug recurring.
    [stepper.py]
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2023-08-01 Get the lr for logs before stepping scheduler (#225)
    This fixes an off-by-one error for the learning rate reported to wandb.
    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
    [train.py]
2023-08-01 Reduce memory req for inference when using only one time window (#223)
    This PR updates EnsembleBatch so that on the last window of rollout, it
    doesn't save the initial condition for a non-existent next window. This
    allows us to run inference with ensembles too large to fit even the
    initial condition in memory, provided the inference rollout is done as a
    single time window.
    [loop.py]
2023-08-02 Add dataset-based inference run capability (#216)
    This PR adds an optional key `prediction_data` to the `InferenceConfig`
    which, when provided, will use that data instead of model data for
    evaluation. This enables us to evaluate traditional models (such as
    lower-resolution versions of FV3GFS) through the data loaders.
    It also adds object-based infrastructure for creating mock data during
    tests, as I found the existing routines tightly coupled and hard to
    extend. We may want to refactor the existing tests to use this.
    [inference.py, loop.py, train_config.py, wandb.py]
2023-08-02 Enable saving model checkpoints periodically (#226)
    Adds configuration option `checkpoint_every_n_epochs` which, if set,
    results in a separate epoch checkpoint being saved every n epochs, in
    addition to the latest and best checkpoints.
    Resolves #224.
    [train.py, train_config.py]
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2023-08-02 Improved generality of `xarray` and `netCDF4`-backed data loaders (#221)
    This PR renames `FV3GFSDataset` (with `data_type: FV3GFS`) to
    `NetCDF4Dataset` (with `data_type: netCDF4`). In addition, `data_type:
    ensemble` is now `data_type: ensemble_netCDF4`. Both `NetCDF4Dataset`
    and `XarrayDataset` are now compatible with horizontal dimensions named
    like "lon", "longitude", or "grid_xt".
    There are also a number of bugfixes and updates to make `XarrayDataset`
    more flexible and compatible with infinitely long inference rollouts:
    - Fixes issue #229
    - Fixes a bug in `XarrayDataset` which caused `params.n_samples` to be
    ignored.
    - Prevents loading unneeded files by `XarrayDataset` when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
    [inference.py]
2023-08-03 Add lat and lon coords to inference output (#231)
    Resolves #228.
    Adds `horizontal_coordinates` information to the `GriddedDataset` as the
    interface to retrieve latitude and longitude from the input data.
    [data_writer.py, inference.py]
2023-08-09 Avoid writing generated data as target at `forward_steps_in_memory` boundaries (#234)
    Resolves #233
    [loop.py]
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2023-08-14 Fix inference loop bugs (#272)
    This PR adds additional integration tests of the inference pipeline,
    updates `run_dataset_inference` to catch up to changes in PR #234, and
    fixes an inference loop assertion bug that was possible in certain edge
    cases.
    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
    [loop.py]
2023-08-15 add isort pre-commit (#283)
    Add pre-commit hook to sort imports using `isort`. This is standard
    practice and should help reduce diff noise when making PRs.
    Closes #282
    [data_writer.py, dicts.py, logging_utils.py, metrics.py, normalizer.py, optimization.py]
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2023-08-16 Compute surface pressure due to dry air instead of dry air mass (#276)
    This PR computes dry air in units of pressure instead of mass and
    propagates that change to the one step and inference code. By doing this
    we are able to:
    1. Make the `core.metrics` computation simple (no need to complicated
    options, checking for `None` values, etc.)
    2. Avoid bugs such as computing area-weighted averaging multiple times
    3. Re-use existing code in the inference pipeline.
    In addition:
    1. Make `DerivedMetric` return a dataclass rather than a raw tuple to
    avoid confusion.
    2. Corrected errors in the one step code
    Closes #275, #277
    [loop.py, metrics.py]
2023-08-16 Better handling of missing atmospheric fields in climate data object (#285)
    This PR centralizes the handling of missing atmospheric fields into the
    climate data object. Specifically, instead of yielding an exception, it
    now returns logs a warning and returns None, thus leaving the handling
    of this case up to the caller. An additional advantage of this approach
    is that the type checker notices if the `None` case is not handled.
    Also, adds a unit test for climate data.
    Closes #266
    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
    [loop.py]
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2023-08-24 Refactor inner inference loop to common function (#308)
    Currently there are two inference functions, one for evaluating trained
    models and the other for comparing two existing datasets. This has
    repeatedly led to issues where features are implemented for one but not
    the other (e.g. #306, #272). This PR slightly improves the situation by
    calling the same function within the inner loop of both methods.
    - add private helper function which is called in inner loop of
    `run_inference` and `run_dataset_inference`
    Resolves #306
    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
    [loop.py]
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2023-08-25 use inf as the max instead of 1e6 (#311)
    This simple PR makes inf the largest possible loss for validation. This
    is marginally better than using 1e6, which has no particular meaning as
    far as I can tell.
    Resolves #87
    [train.py]
2023-08-30 Add extended ensemble video metrics (#289)
    When running ensembles for inference with multiple members, we need to
    be able to look at more than the mean prediction. This PR adds several
    (time, lat, lon) metrics in the form of both wandb videos and netCDF
    output for the inference run.
    - Added `log_extended_videos` configuration option to inference, which
    if set to True (default False) will include min error, max error, and
    RMSE videos in wandb report.
    - Added `log_extended_video_netcdfs` configuration option to inference,
    which if set to True (default False) will write a netCDF containing mean
    predictions and extended video metrics.
    - Added `extended_videos` configuration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
    [data_writer.py, inference.py, train.py]
2023-09-01 Refactor optimization config outside of stepper config (#318)
    This PR factors out optimization from the stepper. This is will be
    helpful when building the fine-tuning system which will re-use an
    existing stepper while swapping out a different optimizer (e.g. with a
    smaller learning rate).
    - The configuration for the optimization is now a top-level block within
    `TrainConfig` rather than nested within the `stepper` block. This will
    be reflected in a [PR to
    vcm-control-workflow](https://github.com/ai2cm/vcm-workflow-control/pull/177).
    - `run_on_batch` now requires an `Optimization` object as an argument.
    Rather than using a `train` flag to enable/disable training, training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
    [inference.py, loop.py, optimization.py, scheduler.py, stepper.py, train.py, train_config.py]
2023-09-05 Enable multistep autoregressive training (#317)
    This PR enables multistep autoregressive training. This is important to
    improve performance and compare to existing works.
    - Removes `NotImplementedError` raised when `n_forward_steps` is not
    one.
    - Modified tests, e.g. `n_forward_steps` is now specified in mock
    configs.
    - `sht_fix.py` is a fork of torch_harmonics's `sht.py` with
    modifications that can be applied by changing the hard-coded variable
    `USE_FIX`. This turned out to be necessary to get multistep
    autoregressive training working on multiple processes (e.g. GPUs).
    Resolves https://github.com/ai2cm/full-model/issues/291
    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
    [train.py, train_config.py]
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2023-09-07 Restore inference backwards compatibility (#326)
    We did not realize it at the time, but backwards compatibility for
    inference was broken by #318 because the SingleModuleStepperConfig is
    loaded by inference, and was changed in a backwards-incompatible way.
    We've created issue #325 to address this. This PR restores backwards
    compatibility for this specific case.
    - Added DisabledOptimizationConfig to SingleModuleStepperConfig which
    loads configuration from older models that include an
    OptimizationConfig, but does not allow that configuration to be used to
    build an optimizer.
    - [ ] Tests added (none needed)
    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
    [optimization.py, stepper.py]
2023-09-07 Fix missing attributes in DisabledOptimizerConfig (#330)
    #326 had a bug where required attributes are not present on the dummy
    configuration. This PR fixes that, and removes attributes from a
    docstring as requested in review by @oliverwm1 .
    - Added required attributes to DisabledOptimizerConfig
    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
    [optimization.py]
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2023-09-07 Enable EMA for training and inference (#314)
    @salvaRC found that using the EMA of the model resulted in more stable
    behavior than using a final model state. We'd like to be able to
    evaluate EMA versions of our full model emulator to increase model
    stability. This PR adds that functionality.
    - Copied LitEMA from
    https://github.com/ai2cm/full-model/blob/salva/src/models/modules/ema.py
    to `fme.core.ema.EMATracker`
    - SingleModuleStepper.modules is now `torch.nn.ModuleList` instead of
    `List[torch.nn.Module]`
    - `ema` is now added to `TrainConfig`, and is enabled by default,
    controlling the settings for the EMA version of the model
    - `validate_using_ema` is added to `TrainCon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
    [ema.py, stepper.py, train.py, train_config.py]
2023-09-08 Make SchedulerConfig kwargs immutable (#338)
    Currently the `kwargs` attribute of SchedulerConfig is mutable, and may
    be mutated as a side-effect of calling its `build` method. This isn't
    desirable as the config is supposed to be a static representation of the
    loaded configuration, and `build` is not supposed to mutate the
    configuration.
    - `kwargs` attribute of SchedulerConfig is now immutable, and calling
    its `build` method will not modify it
    Resolves #321
    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
    [scheduler.py]
2023-09-08 Simplify LpLoss (#340)
    The LpLoss currently has several features we don't use, making the code
    more complex. This PR removes those features and moves the loss into
    `core`.
    - Removed arguments `d`, `size_average`, and `reduction` from LpLoss
    init
    - Removed `abs` method from `LpLoss`
    - Moved LpLoss to `fme.core.loss`
    - [ ] Tests added (already tested by `fme/core/test_loss.py`)
    Resolves #309
    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
    [loss.py]
2023-09-08 Fix off-by-one error in saved checkpoint epoch (#341)
    Currently epoch gets incremented at the start of the train loop, and
    checkpoints are saved at the end of the loop. When we resume training
    from a checkpoint, the initial epoch is the saved epoch. This results in
    a bug where the epoch is not incremented when a checkpoint is resumed
    (issue #274).
    This PR fixes that bug.
    - Epoch in saved checkpoint is no longer off-by-one
    Resolves #274
    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
    [train.py]
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2023-09-11 inference: netCDF variable subset (#335)
    Allows for subsetting the variables saved to the
    `autoregressive_predictions.nc` file produced in inference, which may be useful for long runs.
    - Adds `save_raw_prediction_names` attribute to `InferenceConfig`.
    Resolves #294
    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
    [inference.py]
2023-09-14 Generalize training metrics and log the autoregressive loss at each step to WandB. (#349)
    We need to track the loss at each step of the autoregressive loss. This
    PR achieves that by generalizing `SteppedData` to contain a dictionary
    of metrics, not just a single loss.
    - Replaces `SteppedData.loss` with `SteppedData.metrics: Dict[str,
    torch.Tensor]`. Unfortunately, we need the values to be torch tensors so
    that they can be reduced when running in distributed mode.
    - At each autoregressive step, adds `loss_step_i` for `i in [0,
    n_forward_steps]` to metrics.
    Resolves #345
    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
    [loop.py, stepper.py, train.py]
2023-09-14 Add script for config validation (#350)
    When updating configuration, the feedback loop for incorrect
    configuration is long, requiring a GPU node to be available to run a
    job. This PR adds a command `python3 -m
    fme.fcn_training.validate_config` which quickly tells the user if there
    are any errors in yaml configuration files.
    - Added script module `python3 -m fme.fcn_training.validate_config` to
    validate configuration, with flag`--inference` to check inference
    configuration instead of training configuration.
    - [ ] Tests added
    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
    [validate_config.py]
2023-09-19 Fix epoch mismatch on resume (#353)
    We still have an off-by-one error when we resume training. This PR adds
    and fixes a failing test for this case.
    - Trainer now uses a separate local "epoch" variable for loop tracking,
    with `self.epoch` renamed to `self._model_epoch` to track the epoch of
    the weights. `self._model_epoch` gets updated at the end of
    `train_one_epoch`.
    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
    [train.py]
2023-09-20 Rule for building podman images; log slurm info (#351)
    Some convenience rules for building images using podman-hpc, e.g. as
    required on perlmutter. Also delete `docker/shifter/Dockerfile` which I
    believe is no longer needed given the move to podman-hpc.
    Log SLURM job id and user for provenance tracking.
    [inference.py, logging_utils.py, train.py]
2023-09-22 Output inference diagnostics as netcdf for paper-ready figures (#333)
    We need to make pretty plots for our paper and wandb isn't intended for
    this. This PR outputs much of the raw data (e.g. maps) that are sent to
    wandb in netcdf form so that it can be slurped up and piped to custom
    plotting scripts.
    - Refactors `time_mean.py` to facilitate code re-use between
    `get_dataset` and `get_logs`.
    - Passes coords to `zonal_mean.py` so that outputs have the correct
    components.
    - Adds `get_datasets` method to `InferenceAggregator` so that all the
    xarray Datasets can be passed up to the top-level for saving.
    - Writes each aggregators' dataset to disk in netcdf format.
    [x] Tests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
    [inference.py]
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2023-10-13 Generalize run_on_batch to ragged time dim. (#364)
    This is the first step in implementing inference that can run for more
    time steps than are available in the target data, e.g. arbitrarily long
    inference.
    - Refactors the main training loop in `run_on_batch` in order to more
    clearly focus on the main operations of the training loop. Helper
    functions are created to facilitate this along with simple corresponding
    unit tests.
    - Sets loss to NaN if target data is missing, e.g. in the case of the
    unresolved time-dim of a variable which is only specified at an initial
    condition during inference.
    - Creates a dummy `ReturnZerosModule` for testing. It has an unused
    parameter so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
    [optimization.py, packer.py, prescriber.py, stepper.py]
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2023-10-17 Remove in_names and out_names from DataRequirements (#378)
    `in_names` and `out_names` are no longer required for our data loading
    pipeline and are getting in the way of #327. This PR removes them and
    also uses the opportunity to do some minor cleanup of the
    `test__xarray.py` tests.
    - Removes `in_names` and `out_names` from `DataRequirements`.
    - Fixes some errors in the mock data generation in `test__xarray.py`
    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
    [requirements.py, stepper.py]
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2023-10-30 Fix github actions install failure (#390)
    A dependency changed such that it requires pytorch to be installed in
    order to install. This PR updates `install_dependencies.sh` to install
    torch before other packages, fixing the error.
    - install_dependencies.sh will now install torch (pinned to the version
    in requriements_outside_of_docker.txt) before installing other packages.
    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
    [train.py]
2023-10-30 Remove fix for CuDNN not initialized error (#393)
    In #390 we added a work-around for an error which turned out not to be
    needed. This PR removes that workaround.
    - Deleted force_cudnn_initialization in train.py
    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
    [train.py]
2023-10-31 Add config option to only run inference on some epochs (#386)
    Inline inference takes a long time to run, and doesn't provide very
    helpful information early on in training, especially if inference is
    configured to run for many years (in which case it takes especially long
    to run). It would be ideal to only start inference further on during
    training, and possibly only run it on some epochs.
    This PR adds a configuration option to allow this.
    - Added "epochs" Slice config option to InlineInferenceConfig that
    selects which epochs to run inference (default all epochs).
    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
    [train.py, train_config.py]
2023-10-31 Add conserve_dry_air option to stepper (#385)
    This PR adds an option to training to correct outputs after each
    timestep such that they conserve globally-integrated dry air mass.
    - Added option conserve_dry_air (default False) to
    SingleModuleStepperConfig
    - Added option force_conserve_dry_air (default False) to InferenceConfig
    which overrides the value of conserve_dry_air in the loaded stepper such
    that it will conserve dry air, regardless of how it was trained.
    - SingleModuleStepper now requires a SigmaCoordinates on initialization
    - SingleModuleStepperConfig.get_stepper now requires a SigmaCoordinates
    argument
    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
    [inference.py, stepper.py]
2023-11-07 Simplify typing on ClimateData (#400)
    Includes some simplifications to the typing of ClimateData which made it
    easier to implement #339.
    Instead of returning None types to handle missing variables, exceptions
    are raised. This makes it much easier to statically type equations using
    those variables, instead of checking for None everywhere.
    A special `__getattr__` method to get arbitrary data from the underlying
    values is only used in tests of that method and never in the training
    code, so it was removed. Using it would have required dynamic typing,
    which we don't allow in our code.
    - ClimateData tensor attributes are no longer Optional, instead a
    KeyError is raised if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
    [derived_variables.py, metrics.py]
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2023-11-10 Add derived quantities to validation metrics (#409)
    This PR updates the training routine to compute derived quantities
    during the validation step.
    - Derived quantities are now provided to the validation aggregator and
    show up in wandb reports
    Resolves #401
    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
    [train.py]
2023-11-10 Allow setting global mean moisture advection to zero (#407)
    This PR adds configuration options to set the global mean moisture
    advection to zero in a post-step corrective fashion.
    - conserve_dry_air in SingleModuleStepperConfig is replaced with a
    Corrector Config class that produces a Corrector which handles post-step
    state corrections.
    - Added `zero_global_mean_moisture_advection` option to CorrectorConfig
    - Removed force_conserve_dry_air option from standalone inference
    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
    [inference.py, loss.py, stepper.py]
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2023-11-28 Add moisture post-step correctors (#412)
    This PR adds configuration options to force closure of the moisture
    budget at the end of each timestep.
    - Added "moisture_budget_correction" option to CorrectorConfig
    - Updated ClimateData with new fields and setters required for moisture
    budget closure
    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
    [stepper.py]
2023-12-01 Silence data loader logs during inference (#421)
    When using 5-year inference, the logs quickly become large from data
    loader initialization log lines. In wandb logs, there is no way to
    recover the start of the log when the logs become too long. In beaker,
    you have to download a log file to recover the start of the log. The
    start of the log is particularly important to be able to trace a wandb
    run back to a beaker run, and vice-versa.
    This PR resolves the issue by setting the log level to WARNING instead
    of INFO during data loading for inference.
    - Data loader factories during inline and standalone inference now set
    log level to WARNING while inference data is being loa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
    [inference.py, logging_utils.py, train.py]
2023-12-05 Move output config writing to after directory creation (#428)
    Without this, training and inference fail if the output directory has
    not been created already.
    Resolves #427
    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
    [inference.py, train.py]
2023-12-06 Remove some unnecessary dependencies (dgl, etc.) (#430)
    We have some dependencies specified which are no longer required by the
    codebase. This PR removes them. Oddly, changing the environment in this
    way led to an ImportError in the integration tests (which was resolved
    by renaming the typing.py module):
    - Remove unneeded dependencies
    - Renamed "typing.py" to "data_typing.py" to avoid ImportError
    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
    [derived_variables.py, inference.py, loop.py, loss.py]
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2023-12-20 Compute derived targets before replacing initial condition (#440)
    Derived variables are currently calculated after replacing the window
    initial condition, leading to errors when time differencing target
    values.
    This PR updates the inference loop so target value derived variables are
    computed before the initial condition is replaced.
    - Calculate derived target values before replacing initial condition in
    target data
    Resolves #413
    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
    [derived_variables.py, loop.py, train.py]
2023-12-21 Delete afno FourCastNet code (#451)
    Delete the 2D FFT FourCastNet model code since we no longer need it, and
    because it introduces dependencies which are otherwise unnecessary.
    - delete `models/FourCastNet` directory and associated code in `fme`
    - remove `timm` and `torchvision` dependencies
    Resolves #429
    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
    [train.py]
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2024-01-16 Separate corrector into its own file (#475)
    stepper.py was getting quite large since corrector code was added. This
    PR separates that code into its own file.
    - Moved corrector code from core/stepper.py to a new core/corrector.py.
    No API changes.
    Resolves #411
    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
    [stepper.py]
2024-01-16 Replace data_shapes with img_shape (#474)
    The SingleModuleStepper previously took in shapes for each variable, but
    only used the globally-constant domain size img_shape. This PR updates
    the code so it only takes that variable.
    - Replaced `data_shapes: Mapping[str, Tuple[int, ...]]` with `img_shape:
    Tuple[int, int]` as argument to `SingleModuleStepper` init.
    Resolves #442
    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
    [stepper.py, train.py]
2024-01-17 Set inline inference to always be parallel (#473)
    Non-parallel inference will hang in weird ways per #447. This PR
    switches inline inference to always be parallel during training.
    Resolves #447
    - Remove `NotDistributed` class from `core.distributed`
    - Deprecate `parallel` option from `InlineInferenceConfig` in
    `train_config.py`
    - Remove `dist` arguments since only a single distributed mode is
    allowed: `InferenceAggregator`, `MeanAggregator`, `TimeMeanAggregator`,
    `OneStepMeanAggregator`, `VideoAggregator`, `ZonalMeanAggregator`,
    `fme.core.data_loading.get_loader.get_data_loader`
    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
    [train.py, train_config.py]
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2024-01-19 Clean up wandb dir when runs complete (#478)
    Removes wandb run "media" directories in training and inference jobs after the sync is complete to avoid uploading them to our beaker datasets.
    [inference.py, train.py, train_config.py, wandb.py]
2024-01-19 Fix backwards compatibility for parallel option (#483)
    By accident the "parallel" option got moved from `InlineInferenceConfig`
    to `TrainConfig` in #473 while deprecating the option. This PR will mean
    our current configs won't raise errors (just deprecation warnings).
    [train_config.py]
2024-01-24 Save best-inference checkpoint and use EMA if validating with EMA (#487)
    This PR adds a `best_inference_ckpt.tar` output to model training
    containing the best inference checkpoint based on normalized
    channel-mean time-mean RMSE. It also updates the "best" checkpoint files
    so they contain EMA model data if we are validating using EMA.
    - Added `best_inference_ckpt.tar` training output containing the best
    inference checkpoint based on normalized channel-mean time-mean RMSE
    - `best_ckpt.tar` will now contain EMA model data when validating using
    EMA. This is a backwards-incompatible change.
    Resolves #422
    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
    [train.py, train_config.py]
2024-01-25 Run inference only on first batch (#465)
    This PR updates inference so it only runs on one batch, removing the
    loop iterating over batch.
    This PR replaces data loader factories with an InferenceDataLoader
    wrapper layer over the XarrayDataset.
    - inference now only runs on the first batch
    - Added InferenceDataLoader and InferenceDataLoaderParams
    Resolves #463.
    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
    [inference.py, loop.py, train.py, train_config.py]
2024-01-25 Clearer and more general names in prescriber class (#495)
    While implementing slab ocean, I found some of the naming in the
    `Prescriber` class to be confusing. In particular it was too specific
    (e.g. arg names used `_norm` even though the class doesn't care about
    normalization). This PR just improves naming without changing API or
    implementation.
    [prescriber.py]
2024-01-26 Rely on config to serialize packer/prescriber (#497)
    The "packer" and "prescriber" classes do not have any state beyond their
    configuration, so we don't need to do anything to explicitly serialize
    them when getting the state of the stepper. I think this should be
    backwards compatible.
    - remove serialization functions from `Prescriber` and `Packer`
    - don't return dict items for prescriber/packer in `get_state`
    Resolves #496
    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
    [packer.py, prescriber.py, stepper.py]
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2024-02-02 Revert "Update to python 3.10 and torch 2.1.2 (#453)" (#508)
    This reverts commit 6daa79b0d69fa775fa4aeaf247816f0104204aef.
    Unfortunately the NVIDIA pytorch 23.10 base image that was introduced in
    #453 leads to very mysterious segfaults when training on perlmutter.
    Since we don't actually need any features from the more recent image
    this PR reverts that previous commit.
    We should still aim to upgrade, but should only do so once we've
    confirmed that training on both our platforms works.
    [optimization.py]
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2024-02-14 Fix off by one in the args length of the train function (#555)
    It is currently hard coded to 1 but it should be 2.
    - Changes the number expected arguments to 2.
    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
    [train.py]
2024-02-14 Add timers to inference code (#539)
    Time the total duration, "steps per second" as well as duration for data
    loading, stepping the model forward, and computing/writing diagnostics.
    - added timers to `run_inference` and `run_dataset_inference`
    - logged the relevant info to wandb
    - no longer try to log to wandb if `log_to_wandb=False`
    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
    [inference.py, loop.py, wandb.py]
2024-02-15 Use a pytorch dataloader for inference (#557)
    By using a standard torch data loader for inference, we can take
    advantage of features like parallel data loading via the "num_workers"
    option. This allows big speedups in inference.
    - use a `torch.utils.data.DataLoader` instead of our own custom data
    loader
    Resolves #431
    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
    [getters.py, inference.py, loop.py, train.py]
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2024-02-16 Refactor apply_by_wildcard (#567)
    FrozenParameterConfig has some useful logic to apply an operation based
    on wildcard include and exclude lists. I'd like to re-use this logic in
    #564, but it should be reviewed as its own change.
    - FrozenParameterConfig will no longer unfreeze parameters in its
    exclude list, and instead ignores them
    - Defined apply_by_wildcard helper which applies an operation to module
    parameters based on wildcard-matching include and exclude lists.
    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
    [parameter_init.py, wildcard.py]
2024-02-16 Simplify XarrayDataset configuration (#563)
    This PR makes the data loading configuration clearer by separating out
    what is required by `XarrayDataset` from the config required by the data
    loader or related to subsetting the dataset. Furthermore, it removes the
    `window_slice` feature from `XarrayDataset`; this is no longer needed
    now that we implemented a separate `InferenceDataset` (see #465 and
    #557).
    - only provide `XarrayDataParams` to `XarrayDataset` instead of the full
    `DataLoaderParams`
    - remove `window_slice` option from `DataLoaderParams`
    - implement the `DataLoaderParams.n_samples` by using
    `torch.utils.data.Subset` instead of within `XarrayDataset`
    - if `n_sa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
    [getters.py, inference.py]
2024-02-20 Refactor overwrite_weights to take state instead of nn.Module (#568)
    This PR refactors _overwrite_weights to take in a module state
    dictionary instead of a nn.Module, which avoids us needing to initialize
    an entire stepper to load the original model for overwriting its state
    into a new module. It also adds a get_base_weights method to
    FrozenParameterConfig, which is public so it can be re-used in #564.
    - Added get_base_weights method to FrozenParameterConfig
    - Refactored overwrite_weights to take Mapping[str, Any] instead of
    nn.Module
    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
    [parameter_init.py, weight_ops.py]
2024-02-20 Reduce wandb log frequency (#570)
    Logging all metrics at each step of training is clogging up the wandb
    page. This PR reduces logging frequency to per epoch. To track the
    training progress, batch_loss is logged at each step.
    - "train/batch_loss" is now logged to wandb at each training step.
    - `test_train_main` has been refactored to improve clarity and
    reusability
    Resolves #547
    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
    [train.py]
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2024-02-20 Allow subsetting of datasets using a slice (#573)
    This makes it possible to use a different period of a single dataset for
    training and validation. Useful for AMIP datasets, for example.
    - replace `DataLoaderParams.window_starts` with
    `DataLoaderParams.subset`, since the "window" term is a bit confusing
    and overlaps with the "window" concept in our inference code, which is
    unrelated to this option.
    - deprecate `DataLoaderParams.n_samples` because it is redundant with
    `DataLoaderParams.subset.stop`
    - for ensemble_xarray case, subset is applied to each member before
    concat. So the behavior is changing back to what it was before #563 for
    `n_samples`/`subset.stop` case.
    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
    [getters.py]
2024-02-21 Fix zonal power spectra in wandb (#576)
    Zonal power spectra are currently broken in wandb. This PR implements by
    leveraging wandb's Table object and line.plot functionality.
    - Introduces a `ZonalPowerSpectrum` aggregator that encapsulates some of
    the complexities of tracking an array of data. This object in turn makes
    use of the existing `Mean` aggregator internally.
    - Plots spectra to wandb using matplotlib
    - Adds plotly as a dependency to leverage wandb's somewhat more native
    handling of matplotlib plots.
    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
    [wandb.py]
2024-02-22 reorganize for loop (#590)
    The main train loop is a bit confusing. This PR makes a small
    reorganization to clarify it.
    Resolves #551
    [train.py]
2024-02-22 reference train loader for lats and area weights (#589)
    Small change to reference train loader for lats and area weights instead
    of switching between them.
    Resolves #550
    [train.py]
2024-02-26 use argparse (#591)
    Argparse is better than raw argument manipulation in python.
    Resolves #556
    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
    [train.py]
2024-02-26 Rename data Params to Config (#593)
    - XarrayDataParams renamed to XarrayDataConfig
    - DataLoaderParams renamed to DataLoaderConfig
    Resolves #542
    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
    [getters.py, inference.py, train_config.py]
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2024-02-29 Remove gcs_utils.authenticate as it is unused (#597)
    We had plans to write zarrs to GCS on inference, but we didn't move on
    that so we can now remove gcs_utils.
    [Original
    comment](https://github.com/ai2cm/full-model/pull/552#discussion_r1503211420)
    - Deleted gcs_utils.authenticate
    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
    [inference.py, train.py]
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2024-03-05 Save best losses with checkpoint (#619)
    Currently training does not save and restore the best inference or
    validation loss. This can result in bugs where the best checkpoints are
    overridden with worse checkpoints later. This PR fixes this bug by
    saving the best losses with the trainer checkpoint.
    - Checkpoint file now has keys "best_validation_loss" and
    "best_inference_error"
    - Trainer's _restore_checkpoint will now restore these keys. This is
    backwards incompatible, but should only affect resuming training. We
    should still be able to fine-tune previously saved models.
    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
    [train.py]
2024-03-06 Move init of 'best errors' to before checkpoint restoring (#620)
    Follow on to #619. Need to initialize the 'best errors' before possible
    restoring of the checkpoint, so that they will get overwritten by the
    saved values in the case that the checkpoint is being restored.
    [train.py]
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2024-03-15 Account for module prepend when overwriting weights after batch (#631)
    There is currently a bug in the implementation of CopyWeightsConfig,
    where it does not account for the base weights not having "module"
    prepended while the prepared stepper weights do have this prepended.
    This PR fixes the bug by handling this prepend in CopyWeightsConfig.
    It also fixes a bug where the optimizer complains about new parameters
    it doesn't know about, by assigning into existing parameters instead of
    replacing them with new ones.
    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
    [weight_ops.py]
2024-03-19 Remove inference tables from training logs (#656)
    Tables don't work when reported every epoch (#595), this is a quick
    workaround to remove them. Could refactor to avoid returning at all, but
    it's used when converting the logs to epoch-wise wandb logs in
    standalone inference.
    - "inference/mean/series" is no longer reported to wandb during
    training.
    - "inference/mean_norm/series" is no longer reported to wandb during
    training.
    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
    [train.py]
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2024-03-20 add L1 loss (#661)
    L1 loss is used in the super-resolution literature and this may be a
    useful loss for the downscaling project. The existing LpLoss module
    unfortunately only supports normalized Lp loss functions, so there is a
    need for a simple way to reference pytorch's core L1Loss.
    This doesn't resolve #652 but it does make the main change.
    - Add "L1" as a loss option.
    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
    [loss.py]
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2024-03-22 Use core.loss (#677)
    In preparation to implement model serialization, this PR removes
    downscaling losses in favor of `core.loss`.
    - removes losses.py
    - add `NaNLoss` to core.loss. This is important for downscaling
    interpolation baselines which are an edge case since they do not require
    training (or a training loss objective)
    - renames L1Loss to L1
    Resolves #549
    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
    [evaluator.py, loss.py, train.py]
2024-03-22 Add seasonal pattern bias metrics (#647)
    This PR adds pattern bias style inference metrics for seasonal time
    averages.
    - Added inference/seasonal/time-mean-rmse scalar metric
    - Added inference/seasonal/error diverging map plots
    - Added inference/seasonal/full-field comparison plots
    - Defined new helper function to plot panelled data, as is done in
    one-step map plots
    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
    [train.py]
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2024-03-25 Trim zero bin edges from ComparedDynamicHistograms (#678)
    DynamicHistogram can produce many zero-value bins at the edge of the
    distribution due to the way it dynamically resizes when aggregating the
    histogram. This can result in a large amount of whitespace in wandb
    plots. This PR updates ComparedDynamicHistograms to trim these zero
    bins.
    - ComparedDynamicHistograms no longer includes zero bins at edge of
    histogram.
    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
    [histogram.py]
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2024-04-04 elevate count_parameters to its own function (#706)
    Count parameters can be easily cast to a pure function that accepts a
    list of pytorch modules as input and computes the total parameter count.
    - removes duplicated count_parameters code in downscaling
    - promotes count_parameters to a top level function
    Resolves #572
    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
    [evaluator.py, train.py]
2024-04-05 Logging inference error (#717)
    Adds some logging of inference error values at the end of each epoch for
    easier traceability of the "best_inference" checkpoint.
    [train.py]
2024-04-05 Speed up histogram using bincount and GPU (#714)
    We recently found that histogram calculation is significantly slowing
    down inference (#694). This PR speeds up histogram aggregation by a
    factor of 2 by using np.bincount instead of np.histogram, which should
    help but not completely resolve the issue.
    Timing is based on manually placing time.time() calls before and after
    the histogram aggregation in `test_dynamic_histogram_random_values`.
    Before: `test_histogram.py Time to add 150000 values:
    0.09176778793334961`
    After: `test_histogram.py Time to add 150000 values:
    0.04734396934509277`
    In addition, the code is updated to use torch.Tensor (which can be on
    GPU) instead of np.ndar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
    [histogram.py]
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2024-04-08 Save best checkpoints with correct validation/inference metric (#721)
    Have "best_inference" and "best" checkpoints be saved to disk with the
    correct inference error and validation loss metric alongside.
    [train.py]
2024-04-10 Replace high res / low res with fine res / coarse res (#728)
    Resolves #515
    [evaluator.py, train.py, typing_.py]
2024-04-10 Use TensorMapping and TensorDict for typing (#726)
    This PR refactors core to use TensorDict and TensorMapping type aliases
    instead of directly defining Dict[str, torch.Tensor] and Mapping[str,
    torch.Tensor].
    Resolves #491
    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
    [loss.py, normalizer.py]
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2024-04-16 Improve validation errors when stepper config is incorrect (#735)
    Currently the validate config script will give a very generic error when
    stepper configuration is incorrect, indicating that no stepper was
    matched. This is because the stepper config is a union of types, so the
    logical error is that the stepper config is not any of those types.
    Ideally we would like to see exactly why a stepper config does not match
    SingleModuleStepperConfig most of the time, as this is almost always the
    configuration being used.
    This PR updates validate_config.py so that when it errors, it will check
    if SingleModuleStepperConfig is incorrect and raise an exception for its
    validation specifically,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
    [validate_config.py]
2024-04-16 Fix inline inference n_samples message raised (#739)
    The `InlineInferenceConfig` raises an error if the number of inference
    samples is not divisible by the number of parallel workers; this PR
    fixes a bug that made the error message confusing when raised.
    [train_config.py]
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2024-04-19 Don't pass aggregator as arg to run_on_batch (#745)
    We have mostly decoupled the `aggregator.record_batch` calls from
    `Stepper.run_on_batch`. This PR finishes that refactor by doing the same
    thing for the training call to `run_on_batch` which was the only
    remaining instance of passing an aggregator to `run_on_batch`.
    - remove `aggregator` as an argument from
    `SingleModuleStepper.run_on_batch`
    Resolves #724
    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
    [stepper.py, train.py]
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2024-04-23 Consolidate inference aggregator options (#760)
    Put all of the configuration of which aggregators to use for inference
    in one place.
    The same config object is used for inline and standalone inference.
    - deprecate `log_video`, `log_extended_video`,
    `log_zonal_mean_images`, `monthly_reference_data`
    - move these options into `InferenceAggregatorConfig`
    - change default of `log_video` from True to False
    - no longer hard-code settings for inline inference (but the default
    config is the same as previous hard-coded settings)
    Resolves #722
    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
    [inference.py, train.py, train_config.py]
2024-04-23 Remove torch.norm call, use MSE as default loss (#762)
    This PR fixes LpLoss to use torch.linalg.norm instead of the deprecated
    torch.norm, and sets MSE as the default loss.
    - MSE loss is now default
    Resolves #398
    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
    [loss.py]
2024-04-30 Add DataWriter which saves restart files (#775)
    This PR adds a RestartWriter and configures it to save restart data at
    the end of standalone inference.
    Its API supports configuration to save restarts at other steps, but this
    is not yet hooked in to the standalone inference config.
    - Added `prognostic_names` attribute to SingleModuleStepper
    - Pass `prognostic_names` to DataWriter on init
    - Added RestartWriter
    Resolves #754
    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
    [inference.py, stepper.py]
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2024-04-30 Update base image to pytorch-23.08 (#776)
    Updates base image to `nvcr.io/nvidia/pytorch:23.08-py3` (from 22.09),
    updates `torch` to 2.1.2 (from 1.13.1), and updates python from 3.8 to
    3.10.
    Resolves #740 , #749 .
    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
    [optimization.py]
2024-04-30 Add glob pattern specification to configuration (#774)
    Add the ability to configure the file pattern to match with glob at the
    specified path.
    - `XarrayDataConfig` now contains `file_pattern` as an argument.
    Defaults to `*.nc`
    Resolves #752
    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
    [config.py]
2024-05-02 Resolve some warnings raised by test suite (#787)
    Various user/future/deprecation warnings are raised when we run our test
    suite. This resolves most of the ones that are raised directly by our
    code.
    Resolves #786
    [normalizer.py]
2024-05-02 Use distributed sampler for validation data loader (#785)
    The current validation data loader doesn't use a distributed sampler and
    therefore misses out on multi-GPU parallelism. This PR resolves that and
    results in speedup by a factor of number of GPUs in validation.
    [getters.py, train.py]
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2024-05-13 Load ema state when resuming training (#810)
    This PR updates the trainer so that its EMA properties and weights are
    restored when training resumes.
    This change is backwards-incompatible for training (cannot resume
    earlier stored checkpoints) but is backwards-compatible for inference.
    - Now saves and restores `self._ema` when saving and restoring Trainer,
    and sets its initial values from the EMA checkpoint.
    Resolves #809
    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
    [ema.py, train.py]
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2024-05-14 Delete 'start_sample' arg from append_batch (#821)
    Since refactoring the inference to only loop over time (and not
    batch/ensemble), we no longer need the `start_sample` arg in the various
    `DataWriter.append_batch` functions. This is a follow on refactor PR to
    clean this up.
    Partially addresses #467 (resolves part related to data writer, but does
    not touch aggregators).
    [loop.py]
2024-05-14 Dont require surface temp as forcing for slab ocean (#822)
    The `OceanConfig.names` is intended to be used to determine the forcing
    variables required by the ocean model (e.g. for upcoming 'no target'
    inference). It should not include surface temperature for the slab ocean
    case.
    This bug was fixed, and the property was renamed to `forcing_names`
    (ditto for the corresponding property on `Ocean`) for clarity.
    [ocean.py, stepper.py]
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2024-05-21 Infer timestep within data loader (#830)
    This PR adds an option to infer the timestep of the provided data within
    the data loader and use it throughout ACE. In so doing it addresses
    #783, since inferring the timestep requires validating that the times
    are evenly spaced.
    - Adds an `infer_timestep` option to the `XarrayDataConfig` and a
    `timestep` property to `XarrayDataset`. If `infer_timestep` is `True`
    (the default), the timestep is inferred from the raw loaded data. If it
    is not possible to infer a timestep from the provided data, e.g. if the
    times are not evenly spaced, an error is raised. If `infer_timestep` is
    `False` then trying to use the `timestep` property of `X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
    [config.py, constants.py, derived_variables.py, getters.py, inference.py]
2024-05-21 Delete deprecated stepper config options (#846)
    Delete the fields of `SingleModuleStepperConfig` which are deprecated.
    Does so in a backwards compatible and safe way. I.e. we still use the
    `strict=True` option when converting to dataclass, but also allow
    deserializing steppers which used these deprecated options.
    Resolves #819
    [optimization.py, stepper.py]
2024-05-21 Add loss reduction argument (#850)
    Currently our loss methods are hard-coded to use "mean" reduction. In
    the upcoming diffusion loss in the downscaling project, the loss of each
    example needs to be weighted by its corresponding noise level.
    - `LossConfig.build` now takes an argument reduction which gets passed
    to the underlying torch loss modules.
    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
    [loss.py]
2024-05-21 Define top level ace namespace, config autodocs (#836)
    This PR makes several steps forward on documentation.
    - Added rst files with example configurations (for now from
    vcm-workflow-control) for training and inference, and autodoc entries
    for all parts of those configurations
    - Added modules.rst with an automatic list of available module types,
    and the configuration autodocs for the SFNO modules
    - Moved fme.ace.registry.registry to fme.core.registry to avoid
    importing ace from core
    - Imported public symbols into fme.ace
    - Small edits to doc configuration so the docs build without warnings
    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
    [config.py, inference.py, normalizer.py, ocean.py]
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2024-05-23 More flexible specification of ensemble datasets (#847)
    This PR changes the dataset configuration to be a sequence of
    XarrayDataConfigs.
    - Change the fine and coarse datasets in downscaling to also be
    XarrayDataConfigs.
    - Remove `get_ensemble` getter function since all datasets are now
    essentially ensemble. What we previous called "xarray" corresponds to an
    ensemble with a single XarrayDataConfig.
    - Modify configuration options as specified in #841.
    Resolves #841
    [config.py, getters.py]
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2024-05-24 Relax restriction on forward steps (#798)
    For inference, remove requirement that n_forward_steps is a multiple of
    n_forward_steps_in_memory. See Issue #664.
    This PR makes changes to the inference data loader as well as the
    TimeMeanAggregator (in the aggregator the change uses .sum instead of
    .mean, see some discussion of this here:
    https://github.com/ai2cm/full-model/issues/252 ) so that the total
    number of steps doesn't need to be divisible by the number of forward
    steps. In test_inference.py the test test_inference_writer_boundaries
    was modified to include a case where the total number of steps is not
    divisible by the number of forward steps. It also removes various checks
    in t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
    [inference.py, loop.py, train_config.py]
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2024-05-30 Don't pass forward step args to run_inference functions (#859)
    As shown in #798, we can determine `forward_steps_in_memory` from the
    data returned by the inference loader, and so it is not necessary to
    pass this explicitly to the `run_inference` and `run_data_inference`
    functions. This PR stops doing that, and also determines the total
    `n_forward_steps` from the provided data loaders. This reduces
    likelihood of bugs due to user providing values for these arguments that
    are inconsistent with the inference data loader also being provided.
    [inference.py, loop.py, train.py]
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2024-06-10 Fix validate config script and docs (#881)
    Missed some renames in #880
    [validate_config.py]
2024-06-13 Add 'no target' inference entrypoint (#887)
    This PR provides a new entrypoint for users to do inference using only
    an initial condition and forcing data.
    For now, it allows writing data to disk, but does not provide any
    "aggregators" for computing reduced data online or reporting to wandb.
    We can add some simple cases (like global mean or time mean) in a later
    PR.
    - new `fme.ace.inference.inference` entrypoint with corresponding new
    configs
    Resolves #756 resolves #468
    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
    [__main__.py, getters.py, inference.py, loop.py, stepper.py]
2024-06-13 Deduplicate inserting env vars into wandb config (#898)
    There is code duplicated in many places to insert environmental
    variables into the config that is used when calling `wandb.init`. This
    moves that code into `logging.configure_wandb` to reduce duplication.
    Resolves #894
    [evaluator.py, inference.py, train.py, train_config.py]
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2024-06-14 Refactor logging utils to fme.core (#899)
    These are general purpose utilities/config objects, which are used by
    both ACE and downscaling. So they should be in fme.core. This is purely
    a refactor—no change in functionality.
    Resolves #897
    [evaluator.py, inference.py, logging_utils.py, train.py, train_config.py]
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2024-06-24 Fix histogram error and log info when it happens (#825)
    This PR fixes an issue where the optimized histogram code will raise
    `RuntimeError: bincount only supports 1-d non-negative integral
    inputs.`. When this exception is hit, debugging information will be
    logged to stderr and the code will re-run after increasing any negative
    bin indices to zero.
    - Fixed RuntimeError in histogram aggregation
    Resolves #784
    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
    [histogram.py]
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2024-06-27 Do not record initial condition in inference aggregator (#937)
    During no-evaluator inference, the initial condition has different
    variables present than later steps - in particular, it does not include
    output-only variables. This results in aggregators not initializing the
    right internal data storage.
    This PR updates inference so it no longer records the initial condition
    in its aggregators.
    - No longer pass initial condition to aggregators in standalone
    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
    [loop.py]
2024-06-27 Add fme.ace.evaluator entrypoint (#938)
    This PR adds a `fme.ace.evaluator` entrypoint which does the same thing
    as the `fme.ace.inference.evaluator` entrypoint. This came up in the
    context of writing documentation, where it feels awkward to have
    entrypoints `fme.ace.inference` and `fme.ace.inference.evaluator` when
    one is not a "member" of the other, but rather they are at the same
    level.
    This is basically copy-pasted from `fme.ace.inference.evaluator`, but I
    wanted to avoid breaking backwards compatibility.
    - Added `fme.ace.evaluator` entrypoint for evaluation inference.
    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
    [evaluator.py]
2024-06-27 Add gc.collect to start of each epoch to resolve CUDA errors (#942)
    Similar to what was described
    [here](https://github.com/ai2cm/full-model/issues/740#issuecomment-2079765293),
    got an odd cuda error after adding the spherical power spectrum metric.
    I tried resolving this the same it was done in that case (add a
    `gc.collect()` after closing figure) but that didn't work. As suggested
    in [this
    issue](https://github.com/pytorch/pytorch/issues/67978#issuecomment-1661986812),
    I added a `gc.collect()` call at the start of each epoch, and this seems
    to have resolved the problem.
    [train.py]
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2024-06-28 Delete deprecated options on evaluator and train configs (#943)
    Following deprecated options are deleted so that our public release code
    doesn't contain confusing deprecated options:
    - `TrainConfig.monthly_reference_data`
    - `InferenceEvaluatorConfig.log_video` and `log_extended_video` and
    `log_zonal_mean_images`
    - `DataWriterConfig.save_raw_prediction_namese`
    [evaluator.py, train_config.py]
2024-07-02 Avoid package import of train.py (#953)
    Currently the fme package imports from `fme.ace.train`, causing a
    RuntimeWarning when `python -m fme.ace.train` is run. This PR resolves
    that issue.
    - No changes to public API
    Resolves #949
    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
    [_train.py, evaluator.py, train.py]
2024-07-02 Refactor fme.ace.train into module with init and main (#957)
    Refactors changes from #953 to avoid creating a private _train.py
    module, given this module is fairly public within the package. In
    particular, defines `fme/ace/train/` with `__init__.py` and
    `__main__.py` files.
    - No public API changes
    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
    [__main__.py, train.py, train_config.py, validate_config.py]
2024-07-02 Add env var for using MPS if available (#950)
    Add the ability to use MPS without code changes. I thought about
    defaulting to MPS (over CPU) if it is available, but a lot of our tests
    fail with that backend. The backend seems to not be mature enough to
    support training, although inference does work in my experience.
    - `fme.get_device()` will return an MPS device if `FME_USE_MPS` is set
    to 1 and MPS is available.
    - Entrypoints log the current device at init.
    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
    [device.py, evaluator.py, inference.py, train.py]
2024-07-03 Training config docs organization (#958)
    Reorganizes the training config documentation page to only include
    top-level training subconfigs, and makes sure all subconfigs (and their
    subconfigs) have links to the API reference.
    Also fixes a minor formatting issue on the docs index page ("API
    Reference" expand button was broken).
    Resolves #956
    [normalizer.py, stepper.py]
2024-07-03 Fix checkpoint restoration bug in downscaling (#962)
    Checkpoints were getting loaded but not patched into the actual
    downscaling (or diffusion for downscaling) model. This PR fixes this
    issue and adds a corresponding test.
    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
    [train.py]
2024-07-03 Validation means train but on validation set, generation means data generation in downscaling (#963)
    This PR aims to reduce the confusion around the differences between
    validation and generation metrics by creating separate wandb sections,
    analogously to how we organize FME metrics.
    - validation now uses `train_on_batch`
    - new "generation" category that uses `generate_on_batch`
    - given that `test_train_main` didn't fail when these metrics were
    added, I've removed the component of this test that checks for logged
    wandb keys as it is laborious to maintain and doesn't add much
    information if it fails.
    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
    [train.py]
2024-07-05 Relative MSE compared to bicubic interpolation for downscaling (#969)
    This PR introduces the calculation of Relative Mean Squared Error (RMSE)
    as a single metric for comparing the performance of our model to the
    bicubic interpolation baseline.
    - `RelativeMSEInterpAggregator` class which tracks the MSE of
    predictions and coarse to fine bicubic interpolations and reports their
    ratio.
    - Adds `downscale_factor` as an argument to `Aggregator`'s init
    function.
    - Adds required `coarse` argument to `record_batch`.
    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
    [evaluator.py, train.py]
2024-07-08 Use train and eval mode for underlying torch modules (#972)
    This PR fixes an issue with the default U-Net architecture by properly
    disabling dropout during validation and generation.
    - Run `.train()` at training time to enable droput and `.eval()` at
    validation time to disable it.
    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
    [train.py]
2024-07-09 Check `coarsen_factor` divides `n_forward_steps` also (#983)
    We require that `TimeCoarsenConfig.coarsen_factor` divides evenly into
    forward_steps_in_memory. We also require that it divides evenly into
    `n_forward_steps` but currently we don't check this. Previously it was
    guaranteed if the former is true, but since 71ca987e
    that is no longer the case.
    [evaluator.py, inference.py]
2024-07-16 Prevent corrupted checkpoints during preemption (#1011)
    This PR prevents corrupting checkpoints if pre-emption occurs while
    checkpoints are written by writing them first to a temporary file, then
    moving them to the final location.
    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
    [train.py]
2024-07-17 use temporary checkpoint on same filesystem as final location (#1014)
    Fixes the same issue as #1013 issue introduced by #1011, but retains the
    use of `os.replace` to ensure files are being moved within a single
    filesystem instead of copied, since a copy operation could be corrupted
    by preemption. Will use a temporary filename in the same location as the
    output checkpoint.
    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
    [train.py]
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2024-07-25 Load normalizer from state dict in tests (#1027)
    This PR updates test_sfno and test_hpx to pass a primitive state
    dictionary to `SingleModuleStepper.from_state` by converting the
    FromStateNormalizer into a primitive state dictionary using
    dataclasses.asdict.
    - Fixed an issue where FromStateNormalizer could not be initialized
    using dacite.
    Resolves #1025
    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
    [normalizer.py]
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2024-07-25 Inference IC documentation update (#1034)
    Adding some additional details about the data expectations for the
    initial conditions with inference.
    Resolves #1017
    [inference.py]
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2024-08-07 Enable ResDiff Evaluator for downscaling (#1055)
    This PR updates the evaluator to work with diffusion models as well as
    fixes bugs with the resdiff implementation.
    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
    [evaluator.py]
2024-08-09 Fix ACE fine-tuning test (#1063)
    Modify the `test_fine_tuning` test so that the fine-tuning training
    segment has its `experiment_dir` in a different directory. Otherwise,
    the training just end up resuming from the latest `ckpt.tar` in the
    original experiment dir, and so the second training segment was not
    actually doing any training (since `max_epochs` had already been
    reached). I verified this was the case by looking at logging statements.
    Now the test additionally checks to ensure that a fine-tuned checkpoint
    exists after the second segment.
    [stepper.py, train.py]
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2024-08-14 Use new wandb core backend (#1022)
    WandB has a new backend available
    ([wandb-core](https://github.com/wandb/wandb/blob/main/core/README.md))
    which [supposedly fixes the
    issue](https://github.com/wandb/wandb/issues/4929#issuecomment-2195850571)
    of hanging uploads. This PR updates our code to use that backend.
    - No public API changes.
    Resolves #1021
    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
    [wandb.py]
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2024-08-22 Fix bugs in `test_evaluator.py` (#1113)
    There are two bugs in `test_evaluator.py`. First, the
    `save_plus_one_stepper` helper function hard-codes the `in_names` and
    `out_names` of the saved stepper, even though some of the functions
    calling this helper intend to use different inputs/outputs. Fixing this
    revealed another bug in `test_derived_metrics_run_without_errors` which
    is now also fixed.
    [metrics.py]
2024-08-23 Fix docstring and default for XarrayDataConfig.engine (#1114)
    Docstring for `XarrayDataConfig.engine` incorrectly described valid
    options, and made confusing reference to `XarrayDataset`. Also it
    defaulted to `None` instead of the more explicit default to `"netcdf4"`
    (which was in turn encoded within `XarrayDataset` init).
    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
    [config.py]
2024-08-23 Add abc-based registry for GriddedOperations (#1116)
    This PR adds `to_state` and `from_state` to GriddedOperations, allowing
    it to be serialized and deserialized.
    This is done with a new ABC-based design pattern which avoids the need
    to define a registry and register subclasses.
    - Added GriddedOperations methods `to_state`, `from_state`, and
    `get_subclass_state`.
    - Added optional `keepdim` argument to
    `GriddedOperations.area_weighted_mean` (unrelated change)
    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
    [gridded_ops.py]
2024-08-23 Fix --check-untyped-defs typing issues in tests (#1123)
    This PR fixes a number of typing issues identified by mypy if run with
    `--check-untyped-defs` in test files.
    I found and applied these fixes by adding `--check-untyped-defs` to the
    mypy init in pre-commit-config and running pre-commit --all-files
    repeatedly. It can't be enabled yet because there are additional
    failures in non-test files.
    Needed for #1098.
    [histogram.py]
2024-08-27 Use GriddedOperations in stepper (#1130)
    This PR updates the stepper code to use GriddedOperations instead of
    area_weights.
    - `load_stepper` and similar routines no longer take `area_weights` as
    an argument, and will instead load them from the checkpoint.
    - New checkpoints will store gridded_operations instead of area.
    - `get_stepper` now takes gridded_operations instead of area.
    - Area weights are now computed in the HorizontalCoordinates object
    instead of in the data loading object.
    - InferenceDataset no longer has an area_weights attribute (they can be
    retrieved from its horizontal_coordinates attribute)
    - The `get_gridded_operations` helper is removed.
    - [x] Test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
    [evaluator.py, gridded_ops.py, inference.py, stepper.py, train.py]
2024-08-27 Use GriddedOperations in corrector (#1131)
    - The corrector code now uses GriddedOperations and `area_weighted_mean`
    instead of an area tensor. This fixes bugs when used on healpix data.
    Resolves #1110
    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
    [stepper.py]
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2024-09-05 Simplify merging of forcing data (#1161)
    Merge all forcing fields into the prediction dict instead of relying on
    required_inputs to compute derived variables. This was problematic
    specifically for `surface_height`.
    - Merged `forcing_data` with prediction before computing derived
    variables
    - Removed `model_name` from `ClimateData`
    Resolves #1158
    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
    [derived_variables.py]
2024-09-05 Cast to user-configured dtype in XarrayDataset (#1159)
    Currently we cast to `torch.float` in`SingleModuleStepper.run_on_batch`.
    This is a bit of an unexpected side-effect of `run_on_batch`. Also,
    because it does not happen in `SingleModuleStepper.predict`, there can
    be surprising differences between training/evaluator (which use
    run_on_batch) and inference (which uses predict). E.g. I hit this when
    running inference with an ERA5 model that has double precision CO2 in
    the dataset, which ended up failing even though training worked on the
    same dataset.
    This PR makes three changes:
    1) cast data in `XarrayDataset.__getitem__` instead of in
    `run_on_batch`. This makes it consistent w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
    [config.py, device.py, normalizer.py, stepper.py]
2024-09-05 Fix missing diagnostics variables in metrics and outputs of `run_inference` (#1155)
    This PR fixes a bug in `run_inference` that caused diagnostic variables
    and corresponding derived variables to be lost. Updates
    `test_inference_entrypoint` to check for diagnostic and derived
    variables in saved outputs.
    - [x] Tests updated
    [loop.py, stepper.py]
2024-09-06 Log to wandb within the "no target" `run_inference` loop (#1146)
    PR #1093 implemented logging of inference time series metrics within the
    `run_inference_evaluator` and `run_dataset_comparison` loops. This PR
    closes #1069 by implementing the same feature for `run_inference`.
    - Adds `log_global_mean_time_series` boolean param to
    `InferenceAggregatorConfig` which is `True` by default.
    - [x] Tests updated.
    Resolves #1069
    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
    [inference.py, loop.py]
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2024-09-06 Use serialized vertical coordinate (#1164)
    This means we don't have to read the vertical coordinate from the
    forcing data, which makes code simpler and makes generation of new
    forcing datasets more straightforward.
    It was done this previously when we didn't serialize the vertical
    coordinate. But even our publicly released checkpoint from last November
    includes the necessary info, so I don't think backwards compatibility is
    an issue here. I did include a cast to single precision, since the distributed
    ACE checkpoint serialized with double precision (not the case for
    more recent checkpoints).
    Resolves #1150
    [evaluator.py, inference.py, stepper.py, train.py]
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2024-09-06 Use coordinates from stepper for derived variables (#1165)
    Following on to #1164, now that we are using the serialized coordinates,
    this additionally makes `loop.py` use the time step and vertical
    coordinate from the stepper. This resolves the issue of the forcing data
    not having the vertical coordinate information.
    [loop.py]
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2024-09-09 Doc fixes and use move_tensordict_to_device function (#1168)
    Some minor clean ups:
    - use existing `move_tensordict_to_device` function in `loop.py`
    - add docstring for new `InferenceAggregatorConfig` attribute
    - import perturbation config classes fo `fme.ace.__init__.py` so that
    they will show up in docs API
    [loop.py]
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2024-09-23 Remove broken configure_gcs method (#1216)
    The `configure_gcs` method on LoggingConfig classes references a removed
    method and should be deleted. It is not called.
    - Removed LoggingConfig.configure_gcs in inference.py and evaluator.py
    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
    [evaluator.py, inference.py]
2024-09-23 Fix minor mypy errors for --check-untyped-defs (#1217)
    This PR resolves some errors that appear if `--check-untyped-defs` is
    enabled as a flag for mypy.
    Needed for #1098
    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
    [evaluator.py, histogram.py, train.py]
2024-09-23 Add in_names, out_names, replace_ocean to stepper (#1215)
    This PR adds in_names, out_names, and replace_ocean to stepper, making
    it so the inference code no longer needs to access nested attributes or
    directly mutate the stepper.
    This reduces the changelog with our HEALPix stepper refactor branch,
    which needs more flexibility in these properties (i.e. we need to be
    able to move the packers, and change how the ocean is mutated).
    - Added `in_names`, `out_names` properties and `replace_ocean` method to
    `SingleModuleStepper`.
    - Removed outdated docstring on `load_stepper`.
    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
    [evaluator.py, stepper.py]
2024-09-24 Enable --check-untyped-defs (#1219)
    This PR fixes the remaining issues that appear when
    `--check-untyped-defs` is enabled, and enables that option for mypy
    checks.
    - Fixed bugs in implementation of check_conservation option for healpix
    and fv3gfs data
    - Removed broken `USE_FIX=False` option in sht_fix.py
    Resolves #1098
    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
    [parameter_init.py]
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2024-09-30 Print 40 slowest test durations (#1231)
    Increase number of durations from 20 to 40 for `make test` rule.
    Fix docstring of SingleModuleStepper.run_on_batch.
    [stepper.py]
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2024-10-02 Enable overriding the ocean config in `load_stepper_config` (#1240)
    This PR fixes #1236 by overriding the ocean configuration of the stepper
    configuration returned by `fme.ave.evaluator.load_stepper_config` if a
    non-`None` `ocean_config` is provided. It was straightforward to adapt
    the existing ocean override test to confirm this, and in a more
    realistic setting, the same fix applied on top of [this
    branch](https://github.com/ai2cm/full-model/tree/hardcode-constant-co2)
    allows us to run the simulations described in #1236 (e.g. [these
    logs](https://beaker.org/api/v3/jobs/01J96Q5DZ6BN20BAG4EH258A9W/logs?tail=2)).
    - Consistent with the behavior of `fme.ace.evalulator.load_st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
    [evaluator.py, inference.py]
2024-10-02 Add entrypoint for running segmented inference (#1147)
    Update the `fme.ace.inference` entrypoint to allow repeating the
    inference over an integer number of segments.
    For example, this can be done with `python -m fme.ace.inference
    config.yaml --segments 3`
    The advantage of this is that it would allow automatic restarting of
    inference from the last complete segment and makes preemption/restarting
    much simpler. It also allows splitting of output datasets across
    segments, which is useful to avoid large netCDF files. A downside of
    using this approach is that inference runs would be split across
    multiple wandb runs. Also, the aggregator outputs would be saved for
    each segment and it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
    [__main__.py, inference.py]
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2024-10-08 Use SteppedData abstract base class (#1251)
    This PR adds a SteppedDataABC abstract base class to be used in Trainer
    in a later PR enabling generic types.
    - Added SteppedDataABC abstract base class
    - Added method SteppedData.compute_derived_quantities calling the
    previous compute_stepped_derived_quantities.
    - Added method SteppedData.get_metrics() and used it in Trainer instead
    of direct stepped.metrics access
    If this PR is merged, will add a new issue to move stepping code into
    the `ace` namespace. Another option is moving the derived metrics code
    to the `core` namespace.
    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
    [derived_variables.py, loop.py, stepper.py, train.py]
2024-10-10 Derive normalized data instead of taking it on init to SteppedData (#1258)
    This PR changes SteppedData so it derives normalized values on-demand
    using a normalize function, instead of taking normalized data when
    initialized.
    - SteppedData no longer takes `gen_data_norm` and `target_data_norm`,
    instead taking `normalize: Callable[[TensorDict], TensorDict]`.
    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
    [loop.py, stepper.py]
2024-10-11 Make Trainer subobjects generic types (#1244)
    This PR refactors Trainer to allow generic typing for its sub-objects.
    This means data loaders, steppers, and aggregators can pass custom data
    types between one another. For example, BatchData may be replaced with a
    data type containing variables on multiple time axes (e.g. a fast and
    slow axis for atmosphere-ocean coupling).
    - Added StepperABC base class
    - Added `keep_initial_condition` arg to `run_on_batch` to avoid needing
    to handle an initial condition type
    - Made GriddedData.first_time and GriddedData.last_time private
    - Added GriddedData.log_info method
    - Trainer now takes generic types for batch data and stepped data,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
    [stepper.py, train.py]
2024-10-11 Improve timing categories and fix Looper docstring (#1254)
    Currently we use `"run_on_batch"` as the name of the timer category that
    encompasses the forward prediction of the ML model during inference.
    This is a bit of a misnomer, given that we do not use the `run_on_batch`
    method in inference. This PR updates that term to be called
    `"forward_prediction"` and splits off a separate category for computing
    derived variables. It also splits the writer and aggregators timings
    into two.
    In summary, categories after this PR are:
    `inference` (which is a total duration)
    `initialization`
    `data_loading`
    `forward_prediction`
    `compute_derived_variables`
    `data_writer`
    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
    [loop.py]
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2024-10-16 Follow convention by using 'cls' in classmethod (#1272)
    We were not following the expected python convention in a couple places.
    See https://peps.python.org/pep-0008/#function-and-method-arguments. I
    did a search for "classmethod" across the code base and fixed the two
    instances I found.
    Resolves #377
    [normalizer.py]
2024-10-18 Replace isort and flake8 with ruff linter (#1275)
    Ruff is becoming the standard tool for linting and formatting python
    code because it is super fast and well thought out.
    Here I replaced "isort" and "flake8" in our pre-commit config with a
    single call to `ruff`. In the future, I think we should also replace
    "black" with `ruff format` but when I tried this it led to more code
    changes (mostly related to how long lines are split) so I left it out
    for now.
    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
    [config.py]
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2024-10-25 Add OptimizationABC abstract class (#1280)
    This PR adds an OptimizationABC abstract class which can be used instead
    of Union[Optimizer, NullOptimizer].
    This lets us avoid depending on a concrete implementation from generic
    code in a later PR.
    - Added OptimizationABC abstract base class inherited by Optimization
    and NullOptimization
    - Use OptimizationABC type hint instead of Union[Optimization,
    NullOptimization]
    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
    [optimization.py, stepper.py]
2024-10-28 Add .context method to GlobalTimer (#1281)
    This PR adds a method to GlobalTimer allowing it to time using a context
    manager. This reduces the possibility of bugs (where .stop is not put in
    correctly) and of issues if an exception causes the .stop method not to
    get called (the manager adds a try: finally context).
    It is used in later refactor PRs.
    - Added `.context(category: str)` method to GlobalTimer
    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
    [timing.py]
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2024-10-31 Filter if missing required data for normalization (#1292)
    Change implementation of normalization to filter out tensors which don't
    have corresponding means/stds. Currently the non-normalized data is just
    passed through.
    API changes:
    - remove `exclude_names` from `NormalizationConfig`
    - filter out tensors which don't have available normalization statistics
    when normalizing or denormalizing
    - add `channel_mean_names` argument to relevant aggregator builders. If
    not provided, aggregator will attempt to normalize all variables.
    Resolves #1286
    [evaluator.py, normalizer.py, train.py]
2024-10-31 Delete `FromStateNormalizer` (#1303)
    This class is not actually needed in our code, since
    `NormalizationConfig` already directly provides this functionality.
    Deleting it makes our code and the stepper configuration simpler to
    understand.
    This PR also fixes an issue introduced in #1292 where deserializing an
    old checkpoint's `SingleModuleStepperConfig` failed due to backwards
    incompatibility. Note we don't explicitly have a unit test for config
    backwards compatibility, just for the stepper itself.
    I verified that with the latest commit on this branch, I load the
    original ACE checkpoint:
    https://beaker.org/ex/01JBHZ0EWTRP8M0P36EB0SPEZ9/tasks/01JBHZ0EX02461HSS7BQ4JD3SY/job/01JBHZ0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
    [normalizer.py, stepper.py]
2024-10-31 fix mislabeled dimension in time array (#1309)
    This PR resolves an issue where the sample dimension may be named
    "time", preventing the creation of a time dimension.
    - Fixed an issue where the sample dimension may mislabeled, preventing
    the creation of a time dimension.
    Resolves #1308
    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
    [inference.py]
2024-11-05 Update predict to take in and return PrognosticStateABC (#1302)
    This PR updates `SingleModuleStepper.predict` to take in and return a
    new PrognosticStateABC class which lightly wraps BatchData, instead of a
    TensorMapping (only being taken in) for the initial condition.
    - `TrainOutput.prepend_intitial_condition` now takes in
    `PrognosticStateABC[BatchData]`
    - SingleModuleStepper.predict now takes in
    `PrognosticStateABC[BatchData] for the initial condition, and returns a
    new initial condition as an additional output.
    - SingleModuleStepper.predict no longer takes `n_forward_steps` as an
    argument, and instead uses the length of the forcing data.
    - Added PrognosticStateABC[T]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
    [aggregator.py, batch_data.py, getters.py, inference.py, loop.py]
2024-11-05 Add `Stacker` (#1287)
    Moves `ClimateData`'s handling of stacking 2D level slices into 3D
    tensors to a new class, `Stacker`, for reuse in potential future
    `ClimateData`-like objects, e.g., for ocean derived quantities, and for
    `Masking`.
    - Moves `ClimateData`'s `get_all_level_names` method to
    `Stacker`.
    - Moves the `natural_sort` util to the `stacker.py` module.
    - Adds the `unstack` util which undoes the work done by `Stacker`.
    - Adds the `replace_on_mask` util to the `masking.py` module, used by
    `Masking` and `Prescriber`.
    - Removes `number_of_vertical_levels` from `MaskingConfig` and
    `Masking`.
    - `Masking` can be applied selectively to only certain variables,
    depen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
    [masking.py, prescriber.py, stacker.py]
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2024-11-06 Make collate_fn a pickleable instance (#1310)
    Passing a locally-defined collate_fn will cause a torch DataLoader to
    hang when initialized in a multiprocessing context. This PR removes such
    calls from our code using a pickleable AtmosphericCollateFn instance and
    AtmosphericDeriveFn instance.
    Resolves #1307
    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
    [batch_data.py, getters.py]
2024-11-07 Explicit CPU vs Device typing in BatchData (#1317)
    This PR updates BatchData so that it will always contain device data
    (CPU is allowed only if no GPUs are available), and adds CPU data types
    used by the torch Datasets which can only be on CPU.
    - Added CPUBatchData and moved collate functions from BatchData onto it
    - Removed BatchData.device_data as BatchData.data is now always on the
    get_device() device
    - Similar updates to CPUCoupledBatchData, CoupledBatchData
    - Added explicit `# type: ignore` statements where we are mis-using the
    DataLoader type, to be fixed in a later PR resolving #1006.
    - GPU errors will now occur where the BatchData is originally created
    with CPU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
    [batch_data.py, getters.py, inference.py, loop.py, stepper.py]
2024-11-08 Remove use of BatchData.compute_derived_variables in looper code (#1316)
    This PR modifies the stepper and creates a new DeriverABC type (for data
    comparison) to avoid directly calling `compute_derived_variables` and
    `remove_initial_condition` on `BatchData`, allowing us to later move
    these responsibilities onto the Stepper.
    - SingleModuleStepper.predict now takes in a `compute_derived_variables:
    bool = False` argument
    - SingleModuleStepper now has a `get_forward_data(data: BatchData,
    compute_derived_variables: bool = False) -> BatchData` method.
    - Added Deriver with `get_forward_data` method and `n_ic_timesteps`
    property.
    Co-authored-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
    [aggregator.py, batch_data.py, evaluator.py, loop.py, stepper.py]
2024-11-08 Add `CorrectorSelector` (#1326)
    This PR applies the registry pattern to configure
    `SingleModuleStepper`'s corrector and adds `OceanCorrectorConfig` to the
    corrector registry, which can be configured for masking and
    `force_positive_names`. Maintains the option to use `CorrectorConfig`
    directly for backwards compatibility.
    - Adds `CorrectorABC` and `CorrectorConfigProtocol` and inherits them in
    `Corrector` and `CorrectorConfig`.
    - `SingleModuleStepperConfig`'s `corrector` attribute now has type
    `Union[CorrectorConfig, CorrectorSelector]`.
    - Moves `fme.core.corrector` to `fme.core.corrector.corrector` and
    renames `fme.core.corrector._force_positive` to
    `fme.core.corrector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
    [ocean.py, stepper.py]
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2024-11-12 Registry class (#1328)
    This PR refactors the selector class and uses a generic registry class
    to keep track of the registered options.
    Resolves #1327
    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
    [ocean.py, stepper.py]
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2024-11-15 Return timeseries logs directly when logging inference data (#1345)
    This PR updates inference logging so that timeseries logs are returned
    by the aggregator when recorded and immediately logged, incrementing the
    wandb step counter based on the length of the logs. This will simplify
    step counting when reporting to wandb.
    - Inference routines now take in a `report_logs` function which defaults
    to reporting logs to WandB
    - Inference summary logs now appear one step past the final step,
    instead of on the final step
    - Inference routines no longer return their generated logs, these can be
    retrieved from a wandb mock for testing and were not used in production.
    - [ ] Tests a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
    [aggregator.py, evaluator.py, inference.py, loop.py, train.py, wandb.py]
2024-11-18 run_inference is generic (#1325)
    This PR enables generic non-evaluative inference by making
    `run_inference` generic.
    More work is needed for evaluative inference.
    - Added WriterABC implemented by DataWriter
    - Removed start timestep argument from DataWriter.append_batch
    - Derived variables are no longer reported to wandb for the initial
    condition.
    - nan values are no longer reported to wandb in the initial condition,
    as the IC values are reported to wandb before any log is recorded which
    has a valid value for these metrics. This should not change the
    appearance of wandb logs.
    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
    [aggregator.py, batch_data.py, evaluator.py, inference.py, loop.py, train.py, wandb.py]
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2024-11-20 Remove derive_func from BatchData (#1363)
    This PR refactors BatchData to remove its `derive_func` property
    - Removed `derive_func` from BatchData
    - `BatchData.compute_derived_variables` now takes in a `derive_func`
    - Hard-coded the derive function for SingleModuleStepper to be the
    atmospheric derive func in the stepper build step (previously this
    hard-code was in the data loading step).
    Resolves #<github issues> (delete if none)
    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
    [batch_data.py, evaluator.py, getters.py, inference.py, stepper.py]
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2024-11-21 Remove n_forward_steps attribute from dataset (#1355)
    This PR removes the `n_forward_steps` attribute from dataset objects.
    This was only used for logging during the data comparison run (not
    during inference), and heavily uses dynamic typing. The attribute isn't
    transferred by `transfer_properties`, for example. It is also a source
    of confusion that this isn't referring to the `n_forward_steps` of a
    batch as specified in training config.
    - Removed `n_forward_steps` attribute from dataset objects
    - `n_forward_steps` is no longer logged during coupled data loading or
    data comparison.
    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
    [batch_data.py, getters.py, loop.py]
2024-11-21 Provide next-step forcing data to corrector call (#1373)
    Computing moist static energy in our typical ACE configuration requires
    predicted outputs and forcing data (specifically, need insolation and
    surface height from the forcing data). Currently the corrector is not
    given the forcing data, so it is not possible to implement a corrector
    for moist static energy.
    This PR updates the `CorrectorABC.__call__` method to have a third
    argument, `forcing_data` which assumed to correspond to the same time
    step as the `gen_data` argument. For consistency the signature of
    `Ocean.__call__` is updated the match the order of arguments in
    `CorrectorABC.__call__`, so these two methods now have th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
    [ocean.py, stepper.py]
2024-11-21 Fix validation aggregation device error, add coverage of derived variables in training (#1372)
    Fixes a device error that was occurring in the validation aggregator by
    adding an extra cast of the sigma coordinate. This is a patch until a
    more systematic approach is applied.
    Also adds a failing test to cover the device error; does so by adding
    variable names to the mock data in test_train.py that exercise the
    vertical integral computations in the computation of derived variables,
    which aren't run currently in the test with variable names like "foo".
    - [X] Tests added
    Resolves https://github.com/ai2cm/full-model/issues/1359
    [train.py]
2024-11-21 Move constant data properties onto DatasetProperties class (#1351)
    Short description of why the PR is needed and how it satisfies those
    requirements, in sentence form.
    Note there are significant chunks of code that can be moved out of
    XarrayDataset and into a function just for initializing the metadata
    object, but moving this code is a larger refactor I wanted to leave out
    of this PR for easier review.
    - New class DatasetProperties contains batch-invariant dataset
    - Removed `.n_forward_steps` attribute of GriddedData-like objects,
    inference no longer logs number of total steps during data comparison
    (it already did not for other forms of inference).
    - `get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
    [batch_data.py, getters.py, inference.py]
2024-11-22 Send dataset properties to device in GriddedData init (#1374)
    This PR sends coordinate data to current device when GriddedData is
    - DatasetProperties are sent to device in GriddedData init routine
    - Added HorizontalCoordinates.to(device)
    - Removed duplicated property attributes from InferenceDataset
    Resolves #1332
    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
    [batch_data.py, getters.py, inference.py, train.py]
2024-11-22 Derive dry air tendency (#1371)
    Moves the comptuation of global-mean dry air mass tendency out of the
    validation aggregator and into `compute_derived_variables` function,
    where most other computations of this sort happen.
    Also removes the "required_inputs" deprecated arg from the derived
    variable registry.
    - validation aggregator no longer reports
    `val/derived/surface_pressure_due_to_dry_air/{target, gen}`, but instead
    equivalent information is reported in
    `val/mean/weighted_bias/surface_pressure_due_to_dry_air_absolute_tendency`.
    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
    [derived_variables.py, train.py]
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2024-11-26 Use builders for optimzation and ema as Trainer args (#1386)
    Currently the Trainer receives Optimization and EMATracker as input
    arguments, allowing bugs where they may not be optimizing the passed
    stepper's modules (which Trainer intentionally has access to). This PR
    removes the possibility for this bug by passing in builders for these
    types instead, and ensuring they are given the stepper's modules on
    init.
    - Trainer now takes `get_optimization` and `get_ema` callable build
    functions instead of `Optimization` and `EMATracker` directly
    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
    [optimization.py, train.py, train_config.py]
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2024-12-02 Add linting of docstrings (#1391)
    Add linting of docstrings using ruff/pydocstyle. This will help ensure
    our docstrings are accurate.
    This is the config I used:
    [tool.ruff.lint]
    select = ["D", "E", "F", "I", "W"]
    ignore = ["D1", "D200", "D205", "D212", "E203", "W293", "F541", "E402"]
    [tool.ruff.lint.per-file-ignores]
    "*/__init__.py" = ["F401"]
    "scripts/*" = ["D"]
    "test_*.py" = ["D"]
    [tool.ruff.lint.pydocstyle]
    convention = "google"
    Resolves #1384
    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
    [batch_data.py, config.py, device.py, dicts.py]
2024-12-02 Remove AnyDevice and associated generics (#1394)
    This PR removes generic device typing, as it was inconsistently enforced
    by mypy and most of our device safety seems to come from moving
    everything to device when exposed by GriddedData (and not before).
    - Removed AnyDevice, CPU, and CurrentDevice types
    - Removed generic typing on AnyDevice for PairedData, BatchData, and
    CoupledBatchData
    Resolves #1393
    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
    [batch_data.py, getters.py, inference.py, loop.py, stepper.py]
2024-12-02 Restore n_forward_steps in training (#1396)
    Restore the correct number of forward steps in training, which had
    inadvertently been changed to the number of forward steps in memory for
    inline inference.
    Resolves https://github.com/ai2cm/full-model/issues/1381.
    [train_config.py]
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2024-12-02 Replace black with ruff-format in pre-commit (#1401)
    This PR replaces the black formatting with ruff-format and uses it on
    the repository.
    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
    [batch_data.py, data.py, ema.py, gridded_ops.py]
2024-12-03 Rename `SigmaCoordinates` to `HybridSigmaPressureCoordinate` (#1404)
    For correctness, rename `SigmaCoordinates` to
    `HybridSigmaPressureCoordinate`. In addition, rename `sigma_coordinates`
    variable and argument names to the more general `vertical_coordinate`
    with the future vision of enabling more vertical coordinate types, e.g.
    for the ocean or for other atmospheric vertical coordinates.
    Resolves #1378
    [batch_data.py, derived_variables.py, evaluator.py, getters.py]
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2024-12-04 Clearer name for training samples per second (#1406)
    Clarifies that the training samples per second reported to wandb is on
    the root rank only (not across all ranks).
    Also changes the computations of number of samples seen since last
    logging to avoid errors when epoch start does not align with the logging
    frequency.
    [train.py]
2024-12-05 Minimal generic test of Trainer (#1367)
    - StepperABC now has a distinct TypeVar for the forcing data, allowing
    it to be of a different type and ensuring training data is not used for
    - Removed unused `sigma_coordinates` and `timestep` attributes from
    StepperABC
    - `train_on_batch` now takes in `compute_derived_variables: bool`
    instead of `keep_initial_condition: bool`, allowing the removal of
    `remove_initial_condition`, `compute_derived_variables`, and `copy` from
    `TrainOutputABC`.
    - gc.collect is now only manually called at the start of each epoch if
    on a no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
    [batch_data.py, data.py, ema.py, inference.py, loop.py, stepper.py, train.py]
2024-12-05 Add script to manually test inference with ACE2-ERA5 checkpoint (#1409)
    1. added script to manually do a short inference run with ACE2-ERA5
    checkpoint
    2. fixed issues that arose when trying to use MPS.
    note: I had to manually install torch==2.5 to get it to work, since it
    seems the version of torch we constrain to (2.1) is missing some
    features necessary for SFNO on MPS.
    Resolves #1385
    [device.py, inference.py]
2024-12-05 Use GlobalTimer context for training/validation (#1410)
    Quick fix to resolve #1405. In the future, we could add some more timing
    categories specific to training and log these, but for now this just
    gets rid of the noisy warnings.
    [train.py]
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2024-12-10 Use common function for writing initial condition and restart (#1414)
    Refactors `DataWriter.save_initial_condition` function to a more general
    `.write` function so that it can be used for saving both the initial
    condition and the restart. Lets us delete a bunch of code, and also now
    restarts should work for steppers where `n_ic_timesteps` is greater than
    1.
    The only change in behavior is that `run_dataset_comparison` no longer
    saves a restart file, which seems fine. That method already does not
    save the initial condition, so this just makes it consistent with that.
    - refactor `DataWriter.save_initial_condition` to `DataWriter.write`
    - delete `RestartWriter` and `Paired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
    [evaluator.py, inference.py, loop.py, writer.py]
2024-12-10 Move BatchData to ace, generic code to core (#1417)
    This PR moves large sections of code between ace and core to define a
    new, clearer separation of concerns where `ace` is responsible for
    anything depending on BatchData, while `core` and specifically
    `core.generics` contains all data-generic code.
    Note after this `core` does not and should not import from `ace`. The
    _tests_ in `core` do still import from `ace`, which we should try to
    avoid doing in new tests but is not a priority to update.
    - Moved `Trainer` to `fme.core.generics.trainer`
    - Moved `fme.core.aggregator` to `fme.ace.aggregator`
    - Moved `TrainStepperABC` and `TrainOutputABC` from `fme.core.stepper`
    to `f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
    [batch_data.py, config.py, coordinates.py, data.py]
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2024-12-11 `SingleModuleStepper.train_on_batch` one-step aggregator bugfix (#1424)
    Fixes a bug in `SingleModuleStepper.train_on_batch` in combination with
    the one-step (validation) aggregators due to missing initial conditions.
    Also fixes `TrainOutput.prepend_initial_condition` and other methods
    which did not include `self.derive_func` in constructing their
    `TrainOutput` outputs.
    Resolves #1421
    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
    [stepper.py]
2024-12-12 Move XarrayDataset and associated code to core (#1429)
    Move `_xarray.py` module and associated code to new `fme/core/dataset`
    directory. Also renamed the file to `xarray.py` instead of `_xarray.py`.
    Some additional small changes in the downscaling dataset code so that it
    no longer depends on `fme/ace` dataset/data loading code.
    Resolves #1419
    [batch_data.py, config.py, getters.py, inference.py]
2024-12-12 Lazily compute area_weights, fixing segfault (#1431)
    This PR fixes a segmentation fault that happens during inference by
    lazily computing area_weights, preventing them from being computed on
    CPU.
    While this fixes the segmentation fault, we should try to understand why
    this is happening (I don't really understand it) and consider further
    structural changes to our code to prevent this happening again.
    - LatLonCoordinates.area_weights is now computed lazily.
    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
    [coordinates.py]
2025-01-07 For isort, don't split on trailing comma (#1435)
    Make imports more compact. This may also resolve some inconsistencies
    @brianhenn was finding when saving files with ruff extension installed
    in vscode.
    [getters.py]
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2025-01-08 Resume wandb on id instead of folder (#1440)
    Changes wandb resumption strategy from relying on the wandb `dir` being
    the experiment directory to instead resuming with a wandb run id string,
    which is now saved in the experiment directory. The wandb `dir` is set
    to a temporary location, which is the preferred approach, so the manual
    removal of the wandb files is no longer needed and the experiment directory
    is much less cluttered. Adds `wandb.init`-like behavior to `MockWandB` for testing.
    [evaluator.py, inference.py, logging_utils.py, train.py, train_config.py, trainer.py, wandb.py]
2025-01-09 Add `CoupledStepper.predict_paired` (#1439)
    This PR adds the `predict_paired` and `from_state` methods to
    `CoupledStepper` to complete its implementation of `TrainStepperABC`.
    - Inner (atmosphere) steps are no longer added to the training loss in
    `CoupledStepper.train_on_batch`, so that only the ocean outputs directly
    factor into the optimization. Handling of inner steps contributions to
    the loss will be implemented in a separate PR.
    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
    [batch_data.py, getters.py, requirements.py, stepper.py]
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2025-01-14 Total energy conservation via temperature correction (#1285)
    This PR adds an option to implement conservation of global total energy by
    applying a vertically and horizontally uniform temperature correction.
    - `CorrectorConfig` has a new parameter, `total_energy_budget_correction:
    Optional[Literal["constant_temperature"]] = None`
    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
    [constants.py, derived_variables.py, metrics.py]
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2025-01-16 Allow random subsetting of downscaling data (#1451)
    - Added configuration options `coarse_lat_extent` and
    `coarse_lon_extent` to downscaling data loading config which, if given,
    will randomly subset the downscaling data to have the requested coarse
    shape (and corresponding fine shape)
    - When `coarse_lat_extent` or `coarse_lon_extent` is given, aggregators
    which involve spatially positioned logic (area weighted mean, time-mean
    bias, and zonal power spectra) are disabled, as their logic would be
    incorrect on randomly subset data. These can be implemented in later
    PRs.
    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
    [train.py]
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2025-01-17 Small adjustments from downscaling branch (#1463)
    Adds a few more miscellaneous small fixes from my downscaling branch.
    - `ComparedDynamicHistogram` now errors if there are no overlapping keys
    in the `target`/`prediction` mappings or if different keys are provided
    on subsequent batch recording
    - Adds a `repeat` option to the downscaling data loader configuration
    - Adds a `validate_interval` to the downscaling training to reduce the
    time spent on generation during training
    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
    [histogram.py, packer.py, train.py]
2025-01-21 Use `resumable=True` by default in `LoggingConfig` (#1481)
    As of https://github.com/ai2cm/full-model/pull/1440 we wrapped
    resumption of Weights & Biases runs, controlled by the `resumable`
    argument to `LoggingConfig.configure_wandb`. This PR makes
    `resumable=True` the default argument value and raises an error when the
    old `resume` argument is passed with any value other than `None`.
    - Added `resumable` arg with default values appropriate to particular
    setting (`True` for training, `False` for inference) on
    `configure_wandb` methods wrapping `LoggingUtils.configure_wandb`.
    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
    [evaluator.py, inference.py, logging_utils.py, train.py]
2025-01-22 Fix type enforcement in Registry by validating against the generic base type (#1476)
    This PR addresses a minor bug in the Registry class where the register
    method did not enforce type constraints for registered classes. The
    previous implementation allowed any class to be registered, even if it
    was not a subclass of the base type specified by the generic parameter
    T.
    - Introduced logic to dynamically retrieve the base type (T) using the
    __orig_class__ attribute of the instance.
    - Added a check using issubclass() to ensure that any class being
    registered is a subclass of the inferred base type. Raised a TypeError
    when a class that does not inherit from the base type is reg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
    [perturbation.py]
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2025-01-22 Add config override to fme.ace.train via CLI dotlist (#1467)
    Allows overriding of individual elements of config. This can be useful
    to avoid having to copy and paste yaml configs, or having to use yq or
    other tools to update yaml. However, as far as I can tell it is not
    possible to update lists using the dotlist, so not all parts of our yaml
    configs can be updated with this method.
    - add `omegaconf` dependency. We could also implement our own "dotlist"
    parser, but it's nice to avoid this. `omegaconf` is pretty widely used
    (e.g. in hydra, and in NVIDIA's modulus) but also is not being very
    actively developed at the moment
    https://github.com/omry/omegaconf/issues/1200.
    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
    [__main__.py, config.py, train.py, validate_config.py]
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2025-01-24 Check for `requires_grad` before DDP wrap (#1482)
    If all `SingleModuleStepper` module parameters are frozen, wrapping the
    module with `DistributedDataParallel` results in an error. As a result,
    it was not possible to, for example, use a fully fixed atmosphere
    component stepper in `CoupledStepper`. With this PR, we first check for
    learnable parameters before the DDP wrap.
    - Module is wrapped in `DummyModule` when no parameter requires grad,
    regardless of the result of `Distributed.is_distributed()`.
    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
    [stepper.py]
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2025-01-28 Add `sst` to ocean emulator masking fields (#1499)
    Adds `sst` to `OCEAN_FIELD_NAME_PREFIXES` so that it is included among
    the ocean output fields that get masked by the ocean corrector. This is
    a temporary fix before https://github.com/ai2cm/full-model/issues/1456
    is closed.
    [ocean.py]
2025-01-30 Fix long name for absolute value of surface pressure tendency (#1504)
    The long name was previously incorrect. Also changed implementation
    slightly so we don't have to import a constant in various places and
    keep just one derived variable registry.
    [derived_variables.py, evaluator.py, inference.py, train.py]
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2025-01-31 Option for gradient accumulation in optimizer config (#1493)
    This PR allows step-wise gradient accumulation through an optimizer
    config setting.
    - Added `use_gradient_accumulation: bool = True` option to
    OptimizerConfig
    - Refactored optimizer to use `accumulate_loss` and take no arguments
    when stepping weights
    - Added `detach_if_using_gradient_accumulation` method to optimizer.
    - Updated SingleModuleStepper to detach gradients between steps if using
    gradient accumulation
    Resolves #1498
    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
    [ace-train-config.yaml, optimization.py, stepper.py, train.py]
2025-01-31 Fix frozen-precipitation-related bugs (#1506)
    This PR fixes two bugs related to the inclusion of frozen precipitation
    in the atmosphere energy budget:
    - Frozen precipitation was treated as an energy sink of the atmosphere,
    which is incorrect—frozen precipitation acts as a net source of energy
    to the atmosphere (e.g., [Equation 22 of Bretherton,
    2024](https://drive.google.com/file/d/1EYqXs-fIR0Xen_nB7J4Ik2u3LT4Rajre/view?usp=sharing)).
    Here we appropriately flip the sign.
    - The code attempted to use `self._get("frozen_precipitation_rate")`,
    but this would always raise a `KeyError` due to the fact that such a key
    is not present in `ATMOSPHERE_FIELD_NAME_PREFIXES`. Here we switch t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
    [atmosphere_data.py, metrics.py]
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2025-02-04 Enable adding constant residual term to energy budget (#1507)
    Sometimes our target data has a mean residual in the total energy
    budget. In this case it is useful to account for this in our energy
    budget correction.
    - added new `EnergyBudgetConfig` with a new
    `constant_unaccounted_heating` config option
    - deprecated existing method of activating the energy corrector
    - the `net_energy_flux_into_atmosphere` variable now includes this
    "unaccounted heating" term
    - the "unaccounted heating" is also added to the derived variables. In
    case of not imposing the energy corrector, or for the target data, it
    will be equal to zero.
    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
    [atmosphere_data.py, derived_variables.py]
2025-02-05 Handle disagreements between atmosphere and ocean SST masks (#1510)
    Fixes a bug where the atmosphere emulator could prescribe SST in grid
    cells where the ocean surface fields are NaN due to disagreements
    between the ocean surface mask and the atmosphere's ocean fraction. We
    now replace the 6-hourly ocean fraction field with `minimum(sst_mask,
    ocean_fraction)` when passing the ocean SST to the atmosphere for
    prescribing.
    - Adds non-optional `sst_mask_name` to `CoupledStepperConfig`.
    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
    [stepper.py]
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2025-02-06 Move corrector init out of stepper init (#1518)
    This PR removes the Corrector init out of SingleModuleStepper's init.
    This will allow using the vertical coordinate more generically within
    the SingleModuleStepper.
    - SingleModuleStepper init now takes in an additional CorrectorABC
    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
    [stepper.py]
2025-02-06 Custom implementation of subset/concat (#1513)
    This PR addresses an issue where the return types are incorrect in
    `get_xarray_dataset` and `get_datasets`, which causes downstream issues.
    See #1509. We introduce `XarrayConcat` and `XarraySubset` which are
    wrappers around torch's Concat and Subset, while exposing the
    necessarily attributes from `XarrayDataset`.
    - Added `XarraySubset` and `XarraySubset` in `fme.core.dataset.xarray`
    - Use `sample_start_times` and `n_steps` to determine if merged datasets
    use the same timestamps
    Resolves #1509 and resolves #1508
    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
    [config.py, getters.py, inference.py]
2025-02-07 Expose missing classes in API docs (#1522)
    This PR addresses #1521 by importing `RepeatedInterval`,
    `OverwriteConfig`, and `StepperOverrideConfig` in the `__init__.py` file
    at the `fme.ace` level. This allows them to be appropriately
    auto-documented as part of the `fme.ace` module. I did the same for the
    `MultiCallConfig` as I noticed that it had a similar issue.
    - Exposes `RepeatedInterval`, `OverwriteConfig`,
    `StepperOverrideConfig`, and `MultiCallConfig` at the `fme.ace` level.
    Resolves #1521
    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
    [config.py]
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2025-02-10 Move fme up one level (#1526)
    This PR moves the fme directory up one level to avoid a package name
    clash with the non-package directory name.
    Resolves #1453
    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
    [__main__.py, aggregator.py, atmosphere_data.py, augmentation.py, batch_data.py, config.py, constants.py]
2025-02-11 Bug fix for null vertical coordinate on restart (#1534)
    Only `HybridSigmaPressureCoordinate` has `ak` and `bk`, we add an
    additional check so that it doesn't error for null vertical coordinate.
    [stepper.py]
2025-02-11 Use mypy v1.15.0 in pre-commit (#1535)
    The version of `mypy` we use in our pre-commit config is almost 2 years
    old. This updates to latest release.
    I changed the type-hinting of `variable_metadata` due to this change:
    https://github.com/python/mypy/issues/16489
    [batch_data.py, gridded_data.py, multi_call.py]
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2025-02-12 Add ocean `DepthCoordinate` (#1539)
    Add a `DepthCoordinate` and `CoupledVerticalCoordinate` to enable ocean
    derived variables/aggregators/correctors which require the vertical
    coordinate to compute.
    - Add `DepthCoordinate`
    - Add more general `VerticalCoordinate` type, which is useful for stepper to indicate the type of its vertical coordinate property
    - Add `CoupledVerticalCoordinate`
    - Modify relevant `XarrayDataset` and `DatasetProperties` to use a more
    general `VerticalCoordinate` type
    Resolves #1533
    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
    [aggregator.py, batch_data.py, coordinates.py, gridded_data.py, ocean.py]
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2025-02-12 Fix diffusion stepper deserialization (#1541)
    This PR fixes diffusion stepper deserialization, which was not updated
    for changes to the vertical coordinate deserialization.
    This PR also fixes the diffusion `test_stepper.py` to test the diffusion
    stepper instead of the SingleModuleStepper.
    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
    [stepper.py]
2025-02-13 Require all `atmosphere_to_ocean_forcing_names` in ocean's `next_step_forcing_names` (#1536)
    Fixes a bug where an ocean stepper configured with
    `next_step_forcing_names` would get NaNs as input if those names
    included outputs from the atmosphere stepper. Since variables in
    `CoupledStepperConfig.atmosphere_to_ocean_forcing_names` are implicitly
    "next step" forcings for the ocean stepper, they are now required to be
    included in the ocean's
    `SingleModuleStepperConfig.next_step_forcing_names`.
    [stepper.py]
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2025-02-14 Corrector and derive func build methods on coordinate (#1546)
    This PR resolves static typing issues caused by `VerticalCoordinate` by
    replacing it with `StepperVerticalCoordinate` containing build methods
    for the corrector and derive function. This reflects the current state
    of our code, which determines which type to build based on data on disk.
    - Added ABC `StepperVerticalCoordinate` with new methods
    `build_corrector` and `build_derive_function` to be used by the stepper
    - Added `HasAtmosphereVerticalIntegral` protocol class to be used in
    metric and corrector code which is not allowed to depend on the
    coordinate module to avoid circular dependencies. This also meant usi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
    [aggregator.py, atmosphere_data.py, coordinates.py, derived_variables.py, evaluator.py, inference.py]
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2025-02-14 Add standalone coupled evaluator inference (#1512)
    Adds the standalone evaluator entrypoint to the `fme.coupled` module.
    - Adds `CoupledDataWriter` and its config.
    - The `record_batch` and `record_initial_condition` methods of coupled
    `InferenceEvaluatorAggregator` no longer return empty lists.
    - Adds the `get_datasets` method to coupled
    `InferenceEvaluatorAggregator`.
    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
    [aggregator.py, batch_data.py, data_writer.py, evaluator.py, gridded_data.py, inference.py, stepper.py]
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2025-02-18 Log Nino3.4 index (#1528)
    Adds a new wandb metric (plotly image `inference/enso_index/nino34_index`), which is a dynamically computed Nino3.4 index based on the `surface_temperature` of the predictions and target. The computation uses canonical Nino3.4 methods and reports with a monthly time coordinate; it is a 5-month lagging mean, so the first 4 months of a simulation it will be null. It is computed without a "climate-invariant" correction to avoid needing the ocean fraction forcing data variable. In addition, a netCDF of the index is saved for standalone cases ("enso_index_diagnostics.nc").
    [gridded_ops.py, inference.py]
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2025-02-19 Confine `unaccounted_heating` to `_force_conserve_total_energy` (#1568)
    In #1507 we attempted to expose the `"unaccounted_heating"` as a derived
    variable, and include it when reporting things like the
    `net_energy_flux_into_atmosphere`. This unfortunately led to errors both
    during training and inference. This PR reverts back to the approach in
    Oli's earlier experimental branch, which confines the scope of the
    `unaccounted_heating` to the `_force_conserve_total_energy` function
    alone.
    - `"unaccounted_heating"` is no longer a derived variable.
    - The dictionary returned by `_force_conserve_total_energy` no longer
    contains an `"unaccounted_heating"` tensor.
    - `AtmosphereData` will no lo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
    [atmosphere_data.py, derived_variables.py]
2025-02-20 Configure variable names to mask (#1563)
    Adds `variable_names_and_prefixes` dataclass attribute to
    `MaskingConfig` and removes the `stacker: Stacker` arg from
    `Masking.__call__`. `Masking` now instead uses a fixed `Stacker` which
    is built on init from `variable_names_and_prefixes`.
    - Removes `OCEAN_FIELD_NAME_PREFIXES` which hard-coded variable names in
    `OceanCorrector.masking`. As a result, new runs which use
    `OceanCorrectorConfig` will need to include these variables via
    `MaskingConfig`'s `variable_names_and_prefixes` attribute.
    - `OceanCorrector` now passes `forcing_data` rather than `input_data` to
    `Masking.__call__`.
    Resolves #1456
    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
    [masking.py, ocean.py]
2025-02-20 Don't use `DataRequirements` in init of `XarrayDataset` (#1569)
    This change makes `XarrayDataset` more flexible and not depend on the
    `DataRequirements` class which was intended to describe ACE's data
    requirements. This eliminates dependence of `fme.downscaling` code on
    this class.
    - move `DataRequirements` class definition to `fme.ace.requirements`
    - refactor `XarrayDataset` to take in separate `names` and `n_timesteps`
    args
    Resolves #1430
    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
    [getters.py, inference.py, requirements.py, stepper.py, train_config.py]
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2025-02-24 Refactor masking to require static mask tensor on init (#1579)
    With https://github.com/ai2cm/full-model/pull/1558 the 3D ocean mask is
    now loaded as part of the ocean `DepthCoordinate`, meaning that we have
    access to the mask when building `OceanCorrector`. This PR refactors
    `StaticMasking` (previously called `Masking`) so that we can directly
    initialize it with the `DepthCoordinate.mask`. As a result, the `mask_*`
    variables are no longer required to be ML forcing inputs in order to
    mask out the land when emulating ocean fields.
    - Renames `Masking{Config}` to `StaticMasking{Config}`
    - Removed the `mask_data` argument from `StaticMasking.__call__`.
    - `StaticMaskingConfig.build` now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
    [coordinates.py, masking.py, ocean.py, ocean_data.py]
2025-02-24 Add a climsst baseline configuration (#1573)
    Our existing ace2-era5 baseline involves training the model on
    historical CO2 and SST forcings, and then testing on an out-of-sample
    inference period. There are some signs we may be overfitting in this
    problem, such as behavior over-indexing on CO2, and in some cases seeing
    the upper atmosphere humidity and temperature validation RMSEs go up
    with training. We also see that in-sample inference loss goes down with
    more training for configurations where out-of-sample inference loss goes
    up. In other words, features which make the model more powerful tend to
    worsen our inference skill.
    A main goal we have right now is to align our training objective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
    [train-baseline.yaml]
2025-02-25 Adding derived variables for ocean data (#1594)
    This PR adds a new module for ocean derived variables, following the
    same pattern as the existing atmosphere derived variables system. The
    initial implementation includes column-integrated ocean heat content as
    the first derived variable.
    - Added `ocean_derived_variables.py` module with registry and
    computation functions
    - Added corresponding test file `test_ocean_derived_variables.py`
    - Updated `OceanDeriveFn` in `coordinates.py` to use the new derived
    variables system
    - Renamed `integral` to `depth_integral` in `DepthCoordinate` for
    clarity
    - Fixed circular dependency issues using `HasOceanDepthIntegral`
    protocol similar to how atmo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
    [coordinates.py, derived_variables.py, ocean.py, ocean_data.py, ocean_derived_variables.py]
2025-02-25 Fix corrector coordinates on wrong device bug in coupled training (#1593)
    Fixes a bug in coupled training where vertical coordinates were not sent
    to the device prior to initializing component correctors. This bug
    wasn't caught because the corrector wasn't included in the coupled
    training integration test.
    - Adds atmosphere corrector to the uncoupled and coupled training
    integration tests.
    - Refactors the coupled `GriddedData` class to take
    `CoupledDatasetProperties` on init and sends it to the device.
    Resolves #1590
    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
    [getters.py, gridded_data.py]
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2025-02-26 Samudra predicts sea ice fraction with physical constraints (#1552)
    In this PR, we add the ability to predict sea ice fraction in Samudra.
    We clamp the output to be 0-1 and `sea ice fraction + land fraction +
    ocean fraction = 1`.
    TODO: revert config yaml and do not merge
    - `OceanCorrectorConfig` has additional option:
    `sea_ice_fraction_correction`
    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
    [ocean.py]
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2025-02-27 Return TensorDict from corrector (#1606)
    For a later refactor PR (https://github.com/ai2cm/full-model/pull/1605),
    I will need corrector to return the more permissive TensorDict type.
    - Updated return value of CorrectorABC to be TensorDict instead of
    TensorMapping
    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
    [ocean.py]
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2025-02-27 Don't use torch.cuda for AMP or GradScaler (#1614)
    Resolves some deprecation warnings which are getting raised by `torch`.
    [optimization.py]
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2025-02-28 Allow varying sample / time dim shapes when removing NaNs for histograms (#1619)
    During inference, the final batch can have less than
    `n_forward_steps_in_memory` timesteps, in which case the NaN mask
    initialized on the first call to
    `ComparedDynamicHistograms.record_batch` had the wrong shape. Now the
    NaN mask calculation only uses the final two (i.e., the spatial)
    dimensions.
    Resolves #1618
    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
    [histogram.py]
2025-03-01 Save reduced diagnostics from training (#1616)
    Allows saving the full set of "reduced diagnostics" (the datasets
    returned by the aggregators that mostly correspond to the set of 2D
    images logged to wandb) during training, so in practice the diagnostics
    from validation and inline inference steps. Makes it configurable to
    save these out for every epoch, or not at all, via
    `save_per_epoch_diagnostics`.
    - Adds `save_per_epoch_diagnostics` to `TrainingConfig` in `ace`,
    `coupled`, and `diffusion`, since they share the generic trainer.
    Resolves https://github.com/ai2cm/full-model/issues/1591
    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
    [aggregator.py, diagnostics.py, evaluator.py, train.py, train_config.py, trainer.py]
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2025-03-04 Add `VerticalCoordinate.build_post_process_function` (#1615)
    This PR resolves two issues in how metrics are computed for the ocean
    emulator:
    1. It isn't currently possible to fill non-ocean points with 0s in
    denormalized space ("zero fill") for forward stepping while also filling
    NaNs for denormalized metrics / plots / histograms.
    2. When using `fill_nans_on_normalize` to fill non-ocean points with
    per-variable global means ("global mean fill"), the normalized fields do
    not have NaNs in non-ocean points, distorting important metrics like
    `time_mean_norm/rmse/channel_mean`.
    - Adds `VerticalCoordinate.build_post_process_function()`, which returns
    a `Callable[[TensorMapping], TensorDi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
    [coordinates.py, single_module.py]
2025-03-04 Add .set_eval() and .set_train() to Stepper ABC (#1621)
    Make it possible to manually set eval/train mode independent of
    optimization. This lets us ensure this mode is properly set for
    - add `set_eval()` and `set_train()` methods to `TrainStepperABC` and
    corresponding steppers
    - call these methods as appropriate in trainer and standalone inference
    Resolves #1583
    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
    [evaluator.py, inference.py, single_module.py, stepper.py, train_stepper.py, trainer.py]
2025-03-04 Introduce HEALPixCoordinates xyz logic (#1343)
    Added xyz for the correct grid we use for the healpix mesh. Before this,
    we were using a RING structured assumption.
    Adds tests in test_coordinates for the new system.
    First use case of earth2grid dependency.
    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
    [coordinates.py, winds.py]
2025-03-04 Don't usually save optimization, log best errors (#1475)
    Two changes to generic trainer:
    - only save optimization in the latest checkpoint. This is the only
    checkpoint that requires the optimization serialized in order to enable
    resumption. This change makes all other checkpoints 3x smaller.
    - log the best validation loss and inference error. This doesn't provide
    any new information to wandb, but will make it easier to track at which
    step these values are updated and therefore which epoch the "best"
    checkpoints come from.
    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
    [trainer.py]
2025-03-05 Account for frozen precip in derived sfc energy flux (#1629)
    Make the surface energy flux derived variable consistent with what is
    used in the net energy flux into atmosphere (and in the total energy
    corrector). Note that we still use the surface flux without frozen
    precipitation in the slab ocean, which was done for consistency with
    SHiELD. We could add a special derived variable for the version
    explicitly without frozen precip, but for now I'm leaving that out.
    [derived_variables.py]
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2025-03-05 Implement picklable `collate_fn` to enable training on augusta (#1625)
    This PR follows the recipe in #1310 to implement a picklable
    `collate_fn`, which is required when training ACE on remote data. There
    is not really a clean way to test this integration routinely, but
    empirically it resolves #1624 on augusta (e.g. [this training
    job](https://beaker.allen.ai/orgs/ai2/workspaces/ace/work/01JNF2D5TTND4X1D27WCQZZNBD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)).
    - Defines a picklable / callable `CollateFn` class for use in
    `fme/ace/data_loading/getters.get_data_loader.py` in place of the
    existing locally defined function.
    - Defines a picklable / callable `Collat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
    [getters.py]
2025-03-06 Include wandb in mypy environment (#1632)
    This PR resolves a long-standing local issue some people have (including
    me) where mypy gives a large number of errors on wandb:
    mypy.....................................................................Failed
    - hook id: mypy
    - exit code: 1
    fme/core/wandb.py:20: error: Name "wandb.Histogram" is not defined [name-defined]
    fme/core/wandb.py:35: error: Module has no attribute "Histogram" [attr-defined]
    fme/core/wandb.py:36: error: Module has no attribute "Histogram" [attr-defined]
    (...)
    Found 18 errors in 1 file (checked 339 source files)
    Normally I only get these errors when running with `--all-files` as the
    wandb file doesn't get checked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
    [wandb.py]
2025-03-06 Rename next_step_forcing_data to next_step_input_data (#1635)
    Currently we are using a `forcing_names` variable as as list of inputs
    needed on the next timestep when stepping. In practice, the one variable
    this needs to contain is a prognostic variable (sea surface
    temperature). This also means the `next_step_forcing_names`
    configuration option for the stepper means something different from the
    `next_step_forcing_data` argument to `.step`.
    This PR resolves this overload by renaming `next_step_forcing_data` to
    `next_step_input_data`, and using a `next_step_input_names` attribute
    for the list of variables needed as inputs from the next step.
    Configuration APIs are unchanged.
    Merging this wou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
    [single_module.py]
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2025-03-07 Decouple stepper from coordinate data (#1641)
    This PR refactors SingleModuleStepper so it no longer takes in
    coordinate variables and is decoupled from explicit coordinate data.
    Comparison with coordinates will instead happen through a Step method
    ([PR](https://github.com/ai2cm/full-model/pull/1639)).
    SingleModuleStepper does still take in area_weighted_mean in order to
    build losses - this will be refactored in another PR.
    - Added arguments `post_process_func` and `area_weighted_mean` to
    SingleModuleStepper init
    - Removed public attributes `vertical_coordinate` and
    `gridded_operations` from SingleModuleStep
    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
    [single_module.py, stepper.py]
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2025-03-11 Replace timestep attribute with validate_inference_data method (#1639)
    This PR replaces `timestep` with `validate_inference_data`, moving the
    validation method onto the Step object instead of replicating it in
    various inference entrypoints.
    - Replaced `SingleModuleStepper.timestep` with
    `SingleModuleStepper.validate_inference_data`
    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
    [evaluator.py, gridded_data.py, inference.py, single_module.py, stepper.py, train.py, train_config.py]
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2025-03-11 Refactor SingleModuleStepper to depend on StepABC (#1628)
    This PR refactors the SingleModuleStepper so it takes in a StepABC as
    input argument, instead of a SingleModuleStepper.
    In practice, no behavior is changed, and a SingleModuleStepper is still
    always passed as this argument. However this will make it much easier to
    change this behavior in another PR without having to combine it with the
    large number of refactor changes needed in this one.
    - Removed `SingleModuleStepper.timestep`, replacing it with
    `validate_inference_data`
    - Removed unused `diagnostic_names` and `in_names` attributes from
    SingleModuleStepper
    - Replaced some name attributes with manual name arithmetic inside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
    [single_module.py]
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2025-03-11 Rename `Corrector` => `AtmosphereCorrector` (#1663)
    Renames the atmosphere's `Corrector` to `AtmosphereCorrector`.
    - `CorrectorConfig` => `AtmosphereCorrectorConfig`
    - `fme/core/corrector/corrector.py` =>
    `fme/core/corrector/atmosphere.py`
    - `fme/core/corrector/test_corrector.py` =>
    `fme/core/corrector/test_atmosphere.py`
    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
    [coordinates.py, single_module.py, stepper.py]
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2025-03-13 Consolidate dataset information into provider object (#1665)
    This PR consolidates dataset information (gridded operations,
    coordinates, timestep, img_shape) into a provider object which provides
    these attributes if available, or gives an error informing the user the
    dataset is missing required information.
    The PR makes use of it within the new StepABC system. The existing
    SingleModuleStepper system is compatible with it, as it has the
    information needed to construct a DatasetInfo object.
    - Added DatasetInfo class containing training dataset information used
    by Step objects
    - Replaced img_shape, gridded_operations, vertical_coordinate and
    timestep arguments to Step-related routines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
    [dataset_info.py, gridded_ops.py, multi_call.py]
2025-03-13 Add `CoupledOceanFractionConfig` (#1636)
    Adds `CoupledOceanFractionConfig`, which computes ocean fraction from
    ocean-predicted sea ice fraction and passes it to the atmosphere for
    prescribing SST. Sea ice fraction must be an ocean prognostic variable.
    - Get `land_fraction` for sea ice correction `OceanCorrector` via the
    `input_data` arg, rather than `forcing_data`.
    - Throws an error when attempting to use ocean diagnostic variables as
    atmosphere forcings since the atmosphere steps first in
    - Ocean and atmosphere may have shared ML forcings (e.g.,
    `land_fraction`) but they have to be present in the loaded atmosphere
    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
    [ocean.py, stepper.py]
2025-03-13 Fix bug in coupled evaluator inference with uncoupled checkpoints (#1676)
    When using `StandaloneComponentCheckpointsConfig` to run coupled
    evaluator inference with two pretrained `SingleModuleStepper` training
    checkpoints, there was a bug trying to get "vertical_coordinate" as a
    first-level key in the ocean training checkpoint.
    - Updates the coupled evaluator inference test to catch this bug by
    actually using the `StandaloneComponentCheckpointsConfig.load_stepper`
    method.
    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
    [evaluator.py]
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2025-03-14 Add name attributes to config classes (#1677)
    - Expose lists of variable names from the configuration class of step
    objects, passing them through to the StepABC through a required `config`
    attribute.
    - Make MultiCallConfig Optional in its step config as it is in the
    current stepper. This is helpful for being able to "override" the
    configuration
    - Pass MultiCallStepConfig as the init argument to MultiCallStep so that
    it can expose its config class
    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
    [multi_call.py, single_module.py]
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2025-03-17 Move replace_ocean from StepABC to StepConfigABC (#1689)
    This PR moves `replace_ocean` from StepABC to StepConfigABC.
    This is necessary because during inference, replace_ocean affects lists
    of variables given by the configuration class. To avoid implementing
    `replace_ocean` in two places, we will later implement
    `Stepper.replace_ocean` using the implementation on the configuration
    class.
    - Removed StepABC.replace_ocean
    - Added StepConfigABC.replace_ocean
    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
    [multi_call.py]
2025-03-17 Move ParameterInitializationConfig from core to ace (#1695)
    ParameterInitializationConfig implicitly depends on the stepper by
    knowing details of how a stepper checkpoint is structured. In a later
    PR, this dependency will be made formal, causing core to depend on ace.
    This PR moves ParameterInitializationConfig to `fme.ace.stepper` to
    avoid this issue, and because of its relation to the stepper.
    - Moved `fme.core.parameter_init` to `fme.ace.stepper.parameter_init`.
    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
    [parameter_init.py, single_module.py, stepper.py]
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2025-03-18 Apply masking last in `OceanCorrector` (#1697)
    Masking needs to happen as the final operation in `OceanCorrector` so
    that the mask value is not overwritten by other corrections (e.g.,
    `force_positive_names` would lead to overwriting negative mask values).
    - Updates an existing test to fail if mask values are not preserved.
    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
    [ocean.py]
2025-03-18 Extend parameter initialization to multiple modules (#1694)
    The stepper is being refactored to use a more general API, meaning it
    may have more than one module. This requires updating
    ParameterInitializationConfig to work with multiple modules.
    - Replaced ParameterInitializationConfig attributes `exclude_parameters`
    and `frozen_parameters` with attribute `parameters` given a list of
    `exclude` and `frozen` values for each module returned by the stepper's
    `.modules` attribute.
    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
    [parameter_init.py, single_module.py, stepper.py, train_config.py]
2025-03-18 Add more logging to generic Trainer (#1696)
    Add more logging:
    - log metrics every N batches during training (same frequency as wandb
    logging)
    - add more logging calls before/after various steps in validation and
    inline inference so we can tell fraction of time being spent on making
    plots and actually making ML predictions (may help motivate
    https://github.com/ai2cm/full-model/issues/1007)
    - add logging before initialization of training/validation/inference
    data loaders
    [train.py, trainer.py]
2025-03-18 Implement replace_multi_call for selectors (#1684)
    This PR implements `replace_multi_call` as a helper function which can
    be applied to StepSelector instances. It will be used in later PRs to
    allow StepSelector configuration to have its multi-call values replaced.
    - Added `replace_multi_call` helper function
    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
    [multi_call.py]
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2025-03-19 Remove latitude subsetting in downscaling power spectrum code (#1707)
    This PR is a component of the downscaling rewrite that removes the
    assumption of a static spatial locations.
    The power spectrum calculation and related aggregators required latitude
    inputs for subselecting a latitude range. Since the data is already
    "subset" in the downscaling training this feature was not used.
    - `compute_zonal_power_spectrum` no longer takes latitude as an input
    - `Aggregator` no longer takes in `latitudes` as a top-level argument
    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
    [evaluator.py, train.py]
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2025-03-20 Move parameter init to stepper (#1712)
    This PR moves ParameterInitializationConfig to the Stepper, instead of
    on each Step object.
    The API of ParameterInitializationConfig is general and can be applied
    to any `.modules`. This change prevents us from having to duplicate the
    config on each step object.
    - ParameterInitializationConfig no longer returns the modules it is
    modifying in-place, making it clear that it is doing in-place operations
    - The leading `module` is no longer stripped when loading weights to
    apply or when applying weights to the destination, simplifying the logic
    - `init_weights` is now an argument on the Stepper init instead of the
    Step init, as it determines wheth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
    [parameter_init.py, single_module.py, stepper.py, weight_ops.py]
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2025-03-20 Make loss initialization lazy in stepper (#1714)
    A later PR will ensure that the stepper cannot go out-of-sync from its
    config by using reinitialization from config as the main way of
    modifying or reloading the object. Because of
    https://github.com/ai2cm/full-model/issues/1698, this would cause the
    stepper to crash whenever using multi-call due to statistics being
    missing, even though we don't actually need to use the loss.
    This PR updates loss initialization to be lazy, so that when replacing a
    stepper's multi-call config we will not get an error unless the loss is
    actually used.
    - Updated loss initialization in Stepper to be lazy
    - Moved loss initialization logic to SingleModule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
    [single_module.py]
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2025-03-20 Allow atmosphere gradients in `CoupledStepper` (#1719)
    Fixes an issue in `CoupledStepper.get_prediction_generator` that
    prevents atmosphere steps from retaining gradients when yielded.
    - Adds `detach` convenience method to `ComponentStepPrediction`.
    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
    [stepper.py]
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2025-03-24 Include multi call names in loss normalizer (#1717)
    This PR fixes an issue in the new multi-call step object where it does
    not add its names to the loss normalizer.
    It also makes some changes to the names of lists of names used by the
    step objects:
    - "input_names" is specified by the config instead of "forcing_names".
    Instead, input_only_names is derived only where it is needed
    - The loss normalizer takes extra_names and extra_residual_scaled_names
    instead of extra diagnostic and prognostic names, better matching the
    purpose (residual scaled names may or may not be prognostic)
    - The stepper's public "forcing_names" is renamed to "input_only_names",
    and "out_names" is accessed via "output_na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
    [multi_call.py, single_module.py, stepper.py]
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2025-03-24 Avoid loading training stats during beaker inference (#1727)
    This PR fixes an issue introduced by
    https://github.com/ai2cm/full-model/pull/1716 where inference was
    attempting to re-load stats configured during training, and where
    normalization stats were not saved with the checkpoint.
    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
    [single_module.py]
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2025-03-24 Errors if ocean corrector has invalid mask value (#1731)
    Since depth coordinate assumes mask value to be 0, we also enforce ocean
    corrector mask to have mask value 0.
    Resolves #1723
    [ocean.py]
2025-03-25 Use MultiCallStep wrapper (#1726)
    This PR updates the Stepper to use MultiCallStep instead of managing
    multi-call itself.
    This changes the behavior of multi-call losses. Previously, multi-call
    outputs were given as much importance as all other outputs combined,
    meaning the multi-call radiation outputs were 4-5x as important as the
    base CO2 radiation outputs. With this change, multi-call outputs are
    treated as being just as important as any other output channel.
    - multi-call loss metrics are removed from wandb
    - multi-call outputs are now given the same weighting in the loss as any
    other output
    Resolves #1698, #1658
    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
    [multi_call.py, single_module.py]
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2025-03-26 Small fixes for using new StepperConfig (#1734)
    This PR is a bunch of small fixes taken out of
    https://github.com/ai2cm/full-model/pull/1673 to make it easier to
    review.
    - _combine_normalizers is removed from fme.ace.stepper, with its tests
    moved to the version in use in fme.core.normalization
    - Several docstring fixes
    - Removed unused SerializableStep, and `get_state` and `from_state`
    methods of StepSelector. This functionality is instead directly
    implemented in the way Stepper is saved and loaded.
    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
    [loss.py, multi_call.py, single_module.py, stepper.py]
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2025-03-27 Use new StepperConfig with StepperSelector (#1673)
    - Stepper uses more minimal StepperConfig instead of
    - Added StepperConfig as an option for TrainConfig
    - Updated Stepper checkpoint format
    - StepConfigABC now implements `.load()` which is called before the
    Stepper is serialized
    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
    [evaluator.py, inference.py, multi_call.py, normalizer.py, single_module.py, stepper.py]
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2025-03-28 Add normalization back to CRPS loss (#1742)
    This PR fixes a regression where CRPS loss no longer used normalized
    data, because normalization was moved into the loss object but not for
    CRPS loss.
    Regression target data is generated from
    bd534bfe1f57966a7e37ca17039e51fbbac08735, the commit where CRPS was
    originally added.
    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
    [single_module.py]
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2025-03-31 Fix non-multi-call state handling in `Stepper.replace_multi_call` (#1745)
    This PR fixes a minor bug associated with the step refactors. If we
    train a model with a non-multi-call configuration, e.g. with `step.type`
    equal to `"single_module"` or `"separate_radiation"`, its state will not
    contain a `"wrapped_step"` key. However, `Stepper.replace_multi_call`
    currently implicitly assumes that it will, since it automatically
    converts any configuration into a multi-call configuration:
    https://github.com/ai2cm/full-model/blob/7676d5e346e9b9a3937d123d4d3c5db47b673937/fme/ace/stepper/single_module.py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
    and then attempts to load its state:
    https://github.com/ai2cm/full-model/blob/7676d5e346e9b9a393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
    [multi_call.py, single_module.py]
2025-04-01 New downscaling dataset with spatial batch information (#1737)
    This PR is a component of the downscaling rewrite adds in the new
    dataset handling that includes spatial information with every batch.
    I've put the new changes under `datasets_new.py` and
    `test_datasets_new.py` for ease of review since they are near complete
    rewrites, while also keeping the previous versions for reference
    comparison. Once the review is finished, I will move these over to their
    original files.
    - `fme.core.metrics.spherical_area_weights` now accepts lat/lon with
    leading dimensions
    - downscaling `Aggregator` now includes some pre-recording checks on
    shape consistency to ferret out shape issues with the da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
    [evaluator.py, metrics.py, train.py]
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2025-04-07 Add CRPS and SSR metrics during validation (#1751)
    This PR adds spread-skill ratio and CRPS metrics for validation.
    - Renamed existing OneStepAggregator to OneStepDeterministicAggregator,
    providing a new top-level OneStepAggregator to replace it, and updating
    OneStepDeterministicAggregator to take explicitly non-ensemble data
    - Added `ssr_bias` and `crps` metrics to validation if using crps-based
    - Moved crps calculation to `fme/core/ensemble.py` with a unit test
    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
    [ensemble.py, gridded_ops.py, single_module.py]
2025-04-07 Fix typo and logging statement (#1704)
    Fix minor typo and misleading logging statement.
    [evaluator.py, inference.py]
2025-04-07 Add 10m windspeed derived variable (#1765)
    This is a useful diagnostic for interpreting changes in surface latent
    and sensible heat fluxes. It is also a potentially challenging output
    variable since it is a nonlinear function of two other outputs.
    - add `windspeed_at_10m` to `AtmosphereData` and corresponding derived
    variable
    Resolves #452
    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
    [atmosphere_data.py, derived_variables.py]
2025-04-08 Use ConditionedTarget container for conditioned latents with sigma/loss scales (#1755)
    This PR updates the downscaling code to use a helper function that
    returns a data container with noise-conditioned latents, their noise
    level, and the loss weights corresponding to that noise level. This
    makes that code more re-usable in autoregressive diffusion, and
    hopefully easier to understand.
    - Added condition_with_noise_for_training helper which returns
    ConditionedTarget data container
    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
    [loss.py, stepper.py]
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2025-04-09 Handle NaNs in target data when computing loss (#1773)
    Ensure that targets don't have NaNs when computing the loss and that the
    filled value in prediction and target are the same so that target NaN
    regions contribute 0 to the loss.
    *
    [`fme/core/loss.py`](diffhunk://#diff-ff4c6872eaf21aa3e7cc5fe360e89ba28ebc0be717ca859c6ca8623370c65c2fR67-R70):
    Added logic to mask NaN values in the target tensors and replace them
    with zeros in both the prediction and target tensors before computing
    the loss.
    *
    [`fme/core/test_loss.py`](diffhunk://#diff-08de741eaaf5fa2a54d16dd45dd56d4c8076ee9fef58366af15711745b2e7c61R288-R322):
    Added a new test `test_WeightedMappingLoss_with_target_nans` to verify
    th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
    [loss.py]
2025-04-10 Correct sea ice thickness (#1788)
    Adds `sea_ice_thickness_name` attribute `SeaIceFractionConfig` to
    enforce consistency between the sea ice fraction and thickness.
    - Moved the sea ice fraction correction method to the config class.
    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
    [ocean.py]
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2025-04-10 Refactor ML input masking (#1768)
    Adds optional `input_masking` config attribute to
    `SingleModuleStepConfig`. When provided, builds a `StaticMasking` object
    which is applied to the denormalized inputs in `SingleModuleStep.step`.
    `SingleModuleStepConfig.input_masking` should be used in place of
    `OceanCorrectorConfig.masking` for all new ocean training runs.
    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
    [dataset_info.py, masking.py, ocean.py, single_module.py]
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2025-04-14 Validate stepper DatasetInfo from training against inference data (#1789)
    This PR adds the ability to compare DatasetInfo for compatibility from
    training to inference.
    - Added `DatasetInfo.assert_compatible_with`
    - Added `dataset_info` property to inference dataset
    - Check compatibility of inference dataset info against training data
    from stepper
    Step towards https://github.com/ai2cm/full-model/issues/1433, but we
    must also compare the horizontal grid. I think it would already catch
    legendre-gauss vs equiangular grids, because the area_weights in
    GriddedOperations is determined from the latitude values.
    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
    [coordinates.py, dataset_info.py, evaluator.py, gridded_data.py, gridded_ops.py, inference.py, multi_call.py]
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2025-04-17 Revert `UNMASKED_OCEAN_DERIVED_NAMES` (#1812)
    Reverts the addition of `UNMASKED_OCEAN_DERIVED_NAMES` introduced by
    cdd56d92 which was used to leave `ocean_heat_content` unmasked. So long
    as the surface mask invalid points are a subset of deeper layer invalid
    points (as is currently the case and likely will be for the ocean), this
    is unnecessary.
    [coordinates.py, ocean_derived_variables.py]
2025-04-17 Allow proper correction of `ocean_sea_ice_fraction` (#1815)
    The newly added `ocean_sea_ice_fraction` variable is defined as
    `sea_ice_fraction / (1 - land_fraction)`, so it is acceptable to have
    `land_fraction + ocean_sea_ice_fraction > 1`. The new
    `SeaIceFractionConfig.remove_negative_ocean_fraction` boolean arg allows
    for turning off the "negative ocean fraction" correction when predicting
    `ocean_sea_ice_fraction`.
    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
    [ocean.py]
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2025-04-18 Add gantry script for downscaling baseline (#1683)
    - Adds a baseline training configuration and gantry run script for
    downscaling. The run is configured for using the Augusta cluster and GCS
    datasets since it's easier to find available GPUs there.
    - Updated the configuration tests for separate handling of the
    downscaling files
    - Updated `CheckpointConfig` to lazily load the checkpoint dictionary
    (so validation configuration checks don't fail)
    The training is configured to divide the CONUS into patches with a
    random offset. The evaluation scripts evaluate over previous regions (FL
    and CA) for comparison to previous results, and the entire CONUS (w/o
    patching).
    Co-author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
    [eval-ca-25km-to-3km-augusta.yaml, eval-conus-25km-to-3km-augusta.yaml, eval-fl-25km-to-3km-augusta.yaml, evaluator.py, train-conus-100km-to-25km-augusta.yaml, train-conus-25km-to-3km-augusta.yaml]
2025-04-21 Implement diffusion training (#1489)
    This PR correctly implements diffusion training.
    The existing code in `fme.diffusion` is a placeholder copied from
    `fme.ace`. This PR updates it to implement real diffusion.
    - embedding_scalar and embedding_2d for the conditional sfno Context are
    now Optional, allowing diffusion to ignore the 2D argument it does not
    currently support.
    - Added helper functions in `fme.core.rand` to allow random values to be
    generated consistently on CPU for regression tests
    - Added module registry for diffusion models in `fme.diffusion.registry`
    - Added builder function for conditional SFNO for diffusion
    - Added diffusion implementation in `fme.diffusion.stepper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
    [rand.py, stepper.py, train.py, train_config.py]
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2025-04-23 Return `MaskProvider` from `DatasetInfo.mask_provider` (#1818)
    `MaskProvider` will replace the vertical coordinate as the object which
    is returned from `DatasetInfo`'s `mask_provider` property. During data
    loading, any time-independent fields starting with `"mask_"` will be
    used to instantiate a `MaskProvider` and passed along to `DatasetInfo`
    for downstream applications (e.g., to build `StaticMasking` when
    `StepperConfig` has `input_masking` configured). As a result, any
    stepper with any vertical coordinate can use `input_masking` so long as
    masks are provided in the dataset.
    In addition to allowing level-based masking via masks named like
    `"mask_0"`, `"mask_1"`, `MaskProvider` can also re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
    [dataset_info.py, gridded_data.py, mask_provider.py, single_module.py]
2025-04-23 Avoid xarray warnings related to cftime decoding (#1824)
    This PR updates our code to avoid deprecated features in xarray,
    drastically reducing the number of warnings we encounter during tests.
    - Call `xarray.date_range` with `use_cftime=True` instead of deprecated
    `xarray.cftime_range`
    - Pass explicit `decode_timedelta=False` argument to `xr.open_dataset`,
    which will be the new default
    - Pass `decode_times=CFDatetimeCoder(use_cftime=True)` argument instead
    of `use_cftime=True` when calling `xarray.open_dataset`
    Resolves #1823
    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
    [aggregator.py, getters.py, inference.py]
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2025-04-25 Enable multi-call predictions with 3D variables (#1803)
    This PR enables making multi-call predictions with 3D variables. 3D
    fields differ from 2D fields in the sense that our vertical coarsening /
    splitting appends the vertical layer number, so the appropriate
    multi-call name for a field is no longer trivially the field name with
    the multi-call suffix appended. We instead need to insert the multi-call
    suffix in between the field name and vertical layer suffix.
    For example we want to ensure we predict
    `tendency_of_air_temperature_due_to_longwave_heating_with_quartered_co2_0`
    instead of
    `tendency_of_air_temperature_due_to_longwave_heating_0_with_quartered_co2`.
    - Refactors code for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
    [multi_call.py]
2025-04-25 Allow `torch.export` of step objects (#1807)
    This PR adds the ability to export traced versions of our step objects.
    This is needed to run them in C++.
    - StepABC now inherits from `torch.nn.Module`, and supplies methods
    `forward` and `export`
    - Subclasses of StepABC must now call `super().__init__()` when
    initialized (this is covered by tests, and an informative exception will
    be raised by pytorch if a user tries to set a module attribute without
    doing this)
    - Some minor code changes needed to avoid Python patterns not supported
    by `torch.export`
    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
    [atmosphere_data.py, multi_call.py, single_module.py, stacker.py]
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2025-04-29 Fix bug when coupled component has 0 loss contribution (#1845)
    Fixes a bug caused by summing the values of an empty dictionary when
    either the atmosphere or ocean has zero loss contribution, resulting in
    "loss/ocean" and "loss/atmosphere" metrics with value 0 and type `int`.
    This resulted in an exception when attempting a distributed allreduce on
    those metrics.
    * Zero loss contributions for a component will be logged to wandb as 0.0 for the component-specific `batch_loss` and `val/mean/loss` metrics.
    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
    [aggregator.py, stepper.py]
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2025-04-29 Don't use a 0-based epoch counter in wandb logs (#1849)
    Currently when we log the "epoch" number to wandb, it is logged as 0
    after the first epoch, 1 after the second, etc. This doesn't make sense,
    since this number should represent the # of epochs of training
    completed. Furthermore, this behavior makes it more difficult to add a
    validation step before any training (see #359) which *actually* should
    log with epoch=0.
    - use a single `self._epoch` counter within generic `Trainer` which gets
    incremented at start of epoch loop
    - the epoch logged to wandb will be 1-based instead of 0-based as it is
    currently
    - the "end of epoch callback" will also get this 1-based epoch instead
    of the c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
    [train_config.py, trainer.py]
2025-04-30 Add evaluate_before_training flag to TrainConfigs (#1853)
    It is useful to be able to run validation and inline inference before
    doing any training. Especially for fine-tuning runs, this makes
    interpretation much easier, since it removes the need to compare across
    two (possibly differently configured) training runs to see impact of
    first epoch of fine-tuning.
    - Add `evaluate_before_training` flag (default=False, maintaining
    current behavior) to `fme.core.generics.trainer.TrainConfigProtocol` and
    corresponding implementations
    - If this flag is set to True, validation and inline inference will be
    run and logged to wandb before any training happens
    Resolves #359
    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
    [train_config.py, trainer.py]
2025-05-01 Add dataset output to downscaling evaluation (#1858)
    Previously, there were some aggregator outputs saved to file that were
    removed in recent reworks of the aggregator. This PR adds back saving of
    select metrics that are more difficult to generate to be used for
    plotting.
    - Reduces the batch size on the augusta baseline eval script due to OOM
    - Add `get_dataset` methods to `GenerationAggregator`, `Aggregator`,
    `ComparedDynamicHistogramsAdapter`, `ZonalPowerSpectrumAggregator`, and
    `MeanMapAggregator` to facilitate saving a netcdf of metric outputs.
    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
    [eval-conus-25km-to-3km-augusta.yaml, evaluator.py]
2025-05-01 Refactor step shared logic (#1857)
    This PR refactors shared logic between SingleModuleStep and
    SeparateRadiationStep into a shared helper function.
    - Fixed a bug where any prognostic variables that might be predicted by
    the radiation code would be ignored by the `residual_prediction` flag
    (does not affect our runs)
    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
    [single_module.py]
2025-05-01 Ensure doctest examples are actually running (#1860)
    Currently doctest is not actually running on some of our examples
    because they are invalid (see #1525 ).
    In this PR we add a custom `IGNORE_OUTPUT` flag to `conf.py` so that
    these examples run as expected. They still do not require any output to
    be included in the example (as desired) but they will fail if the class
    definitions change such that the examples are invalid.
    I did this based on a suggestion in
    https://stackoverflow.com/questions/3862274/doctests-how-to-suppress-ignore-output,
    but we could also add `doctest_plus` dependency as suggested in #1525 .
    Also made another minor change to `DataLoaderConfig` to remove some
    warnings.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
    [config.py]
2025-05-05 Add pyupgrade to ruff linter rules (#1869)
    This will help us stick to modern python functionality. Add "pyupgrade"
    ruleset to ruff linter: https://docs.astral.sh/ruff/rules/#pyupgrade-up
    - add `UP` to `tool.ruff.lint.select`
    - ignore `UP` for files in `scripts/*`
    - fix corresponding issues
    Note:
    We have some classes which have an attr named `type` which can conflict
    with the builtin `type` that is now supposed to be used instead of
    `Type`. So I put in some `ignore` statements to allow us to still use
    this deprecated `Type` for now. This could be resolved other ways, but
    this seemed the simplest.
    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
    [aggregator.py, atmosphere_data.py, augmentation.py, batch_data.py, benchmark.py, cli.py]
2025-05-06 Fix nccl hang downscaling (#1872)
    The issue in #1866 was caused by a mis-placement of the `get_dataset`
    operation under the evaluation script. Moving it out of the "root-only"
    conditional block, fixed the timeout.
    Successful job using 8 GPU:
    [beaker](https://beaker.allen.ai/orgs/ai2/workspaces/downscaling/work/01JTKF4H67KBVJ39664E8CDK62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)
    Resolves #1866
    [evaluator.py]
2025-05-07 Variable metadata from stepper in inference (#1873)
    Allows the inference and evaluator routines to access variable metadata
    that was used by the stepper in training. This is useful particularly
    for inference where the forcing dataset doesn't contain output
    variables, and so previously their metadata was missing.
    - Stepper serialization now includes training dataset variable metadata
    in `DatasetInfo`. This metadata is used preferentially over inference
    dataset metadata. If there are conflicts in metadata between stepper and
    dataset a warning is logged.
    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
    [dataset_info.py, evaluator.py, gridded_data.py, inference.py, single_module.py]
2025-05-08 Use instances for config in test_train (#1884)
    This PR updates the yaml generation in `fme/ace/test_train.py` to make
    use of explicit instances for configuration classes which then get
    converted into yaml, rather than directly using string surgery to
    construct a yaml file. This will make it easier to refactor this
    configuration, and make it clearer when the test needs to be updated (as
    mypy can check it).
    - `XarrayDataConfig.torch_dtype` is now a property method instead of a
    dataclass attribute, to avoid issues with serializing its type
    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
    [config.py]
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2025-05-13 Refactor concat and merge dataset config (#1877)
    Introduce `ConcatDatasetConfig` and `MergedDatasetConfig` to explicitly
    specify whether a dataset should be concatenated or merged. We maintain
    backwards compatibility only for concat datasets, where the current way
    of specifying concat dataset is allowed.
    - `ConcatDatasetConfig` and `MergedDatasetConfig`
    - With this PR, it is also possible to directly specify a
    XarrayDataConfig in data loader instead of starting with a list
    Resolves #1828
    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
    [ace-train-config.yaml, config.py, getters.py, inference.py, train-baseline.yaml, train-config.yaml]
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2025-05-15 Bugfix: Mask derived variables during validation (#1891)
    This PR fixes a bug in `Stepper` where derived variables were not
    properly masked when `Stepper.train_on_batch` was called with
    `compute_derived_variables=True` (i.e., during validation).
    - Adds a training and inline inference integration test for ocean data,
    with a vertical depth coordinate and NaN regions in the synthetic
    targets.
    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
    [single_module.py]
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2025-05-15 Masked weighted `LatLonOperations` (#1835)
    Initialize `LatLonOperations` with an object implementing the
    `HasGetMaskTensorFor` protocol (usually a `MaskProvider`) in order to
    ignore masked regions in global mean calculations.
    - `fme.core.metrics.weighted_mean` no longer uses `torch.nanmean` and
    instead fills 0s on the input tensor where ever spatial weights are 0.
    - Adds `fme.metrics.weighted_nanmean` which is used by
    `fme.core.metrics.weighted_mean_gradient_magnitude` and preserves the
    current behavior of the gradient magnitude metric when inputs have NaNs.
    - All single-tensor methods on `GriddedOperations` now accept an
    optional `name: str | None` argument. `LatLonOperations` use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
    [coordinates.py, gridded_ops.py, mask_provider.py, masking.py, metrics.py, ocean_data.py]
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2025-05-20 Fix bug in implementation of SSR bias (#1911)
    SSR bias has bugs which currently lead it to be 0.5 for an unbiased
    model, and to decrease instead of increase when spread is increased
    (it's the spread skill ratio). This PR fixes these issues and adds unit
    tests.
    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
    [ensemble.py]
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2025-05-21 Fix NaN handling in annual and seasonal aggregators (#1913)
    Fixes NaN-handling bugs which were introduced by
    https://github.com/ai2cm/full-model/pull/1835 in the `inference/annual`,
    `inference/seasonal`, `inference/enso/enso_coefficient` and
    `one_step/ensemble` aggregators.
    Also fixes an existing issue in `SeasonalAggregator` where NaNs are ignored in the seasonal mean computation.
    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
    [ensemble.py]
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2025-05-29 Add energy score and spectral CRPS losses (#1920)
    This PR adds configurable CRPS losses on the complex plane.
    - Replaced `crps_training` with a `n_ensemble: int` attribute and an
    `EnsembleLoss` loss type
    - Added the ability to weight the ensemble loss as a sum of CRPS, and
    energy score losses.
    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
    [ensemble.py, loss.py, single_module.py, tensors.py]
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2025-06-09 Refactor parameter initialization methods (#1945)
    Refactor the `ParameterInitializationConfig.apply` method into two
    methods: one to apply base model weights, and one to return the
    normalizer, while caching the weights to avoid multiple calls of the
    weight loading function. These methods are also refactored onto a
    runtime `ParameterInitializer` that caches the weights to avoid
    modifying the config. Allows easier addition of other methods to
    `ParameterInitializer` that depend on the base model attributes without
    adding more model loading calls.
    [parameter_init.py, single_module.py, stepper.py, train.py, train_config.py]
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2025-06-11 Fix bug in legacy parameter init handling (#1927)
    Fixes a bug where a `Stepper` can be successfully initialized from a
    legacy `SingleModuleStepper` state dict which includes legacy
    `ParameterInitializationConfig` state but the resulting
    `Stepper.get_state()` dict is invalid for `Stepper.from_state()`.
    - Updates `ParameterInitializationConfig.__post_init__` to ignore empty
    `exclude_parameters` lists and to always reset `exclude_parameter` and
    `frozen_parameters` to `None`.
    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
    [parameter_init.py]
2025-06-11 Add `CoupledDatasetInfo` (#1895)
    Adds `fme.coupled.dataset_info.CoupledDatasetInfo` which contains
    separate `fme.core.dataset_info.DatasetInfo` objects for the coupled
    ocean and atmosphere.
    - The coupled `GriddedData` class now has a `dataset_info:
    CoupledDatasetInfo` property.
    - Removed the `sst_mask` init arg to `CoupledStepper` and added the
    `dataset_info` init arg. The ocean surface mask is now accessed via the
    `CoupledDatasetInfo.ocean_mask_provider` attribute.
    - Replace existing `CoupledStepperConfig.get_stepper` args with a single
    `dataset_info` arg.
    - Adds "dataset_info" entry to the returned dict from
    `CoupledStepper.get_state`.
    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
    [dataset_info.py, evaluator.py, gridded_data.py, stepper.py, train.py, train_config.py]
2025-06-11 Move `strict` option to `ConcatDatasetConfig` (#1959)
    Renamed `strict_ensemble` to `strict` and moved it to concat config.
    Resolves #1958
    [config.py, getters.py]
2025-06-11 Compatibility with dataset missing vertical coordinate (#1946)
    Makes `NullVerticalCoordinate` compatible with real vertical
    coordinates, such that a dataset with only 2D variables is considered
    compatible with a dataset with a real vertical coordinate. For example,
    this happens when we run inference with 2D forcing variables for a
    stepper trained on a vertical variable dataset. Also makes the inference
    integration test check this specific case.
    [dataset_info.py]
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2025-06-13 Add option to sample dataset with replacement (#1954)
    This PR adds an option in DataLoaderConfig to sample the dataset with
    replacement.
    - Added new `sample_with_replacement_dataset_size: int` option to
    DataLoaderConfig which, if given, will cause the dataset to be sampled
    with replacement to the given size, instead of performing epoch-based
    sampling.
    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
    [config.py, getters.py]
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2025-06-18 Add ocean heat corrector (#1902)
    This PR implements ocean heat content conservation in the model by
    adding a correction mechanism that ensures the total ocean heat content
    changes according to surface heat fluxes and geothermal heat input. More
    on this [here](https://www.overleaf.com/read/fnqqnqphfyxq#278184)
    - fme.core.corrector.ocean: Added ocean heat content correction
    functionality to the OceanCorrector
    - New ocean_heat_content_correction flag in OceanCorrectorConfig
    - Implementation of _force_conserve_ocean_heat_content function
    - Added net_downward_surface_heat_flux, geothermal_heat_flux,
    sea_surface_fraction properties and set_sea_water_potential_temperature
    method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
    [ace-train-config.yaml, ocean.py, ocean_data.py]
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2025-06-23 Revert "Use mask provider when comparing horizontal coordinates (#1977)" (#1983)
    This reverts commit 0e062d0972c95a84124d6307ee5b0ac11768b0fa.
    I am proposing that we remove `mask_provider` from `LatLonCoordinates`,
    so actually it is not necessary to include `mask_provider` when
    comparing two `LatLonCoordinates`. See #1982.
    [coordinates.py]
2025-06-23 More helpful err msg with incompatible dataset (#1985)
    I ran into this error in an integration test
    (https://github.com/ai2cm/full-model/actions/runs/15836703707/job/44641680389)
    and this made me realize a more helpful hint of how to potentially get
    around it would be useful.
    Also our docs had a bunch of non-discoverable classes. Now make sure
    these get imported in fme.ace.__init__.py so that they will be listed in
    our API docs.
    [evaluator.py, inference.py]
2025-06-25 Make default parameter_init behavior be from config (#1975)
    Makes `StepperConfig.get_stepper` build the parameter initializer from
    config instead of requiring that it be passed as an argument. In cases
    where no parameter initialization is desired (e.g., on inference), the
    option of passing `apply_paramater_init=False` is added. This avoids the
    need to have a separate build call of the parameter initializer in
    training routines, which was introduced in #1945 and was bug-prone.
    Resolves https://github.com/ai2cm/full-model/issues/1973
    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
    [parameter_init.py, single_module.py, stepper.py, train_config.py]
2025-06-25 Deprecate SingleModuleStepperConfig (#1988)
    This PR adds a warning if SingleModuleStepperConfig is used in
    TrainConfig, and updates the docs to use the new config.
    - TrainConfig will warn if SingleModuleStepperConfig is used
    Resolves #1962
    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
    [train-config.yaml, train_config.py]
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2025-07-02 Fix weight freezing when using StepABC (#1994)
    This PR fixes an issue where using frozen weights will result in an
    exception if running in parallel, because DDP is applied before the
    weights are frozen and expects them to have gradients.
    - Added `init_weights` callable argument to `StepABC.get_step` which
    initializes (is used to freeze) model weights after model definition but
    before DDP is wrapped over the module.
    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
    [multi_call.py, parameter_init.py, single_module.py]
2025-07-03 Account for world size when defining sample with replacement dataset (#2006)
    Sample with replacement dataset size is currently used to specify the
    size of the dataset on each rank, instead of the size across all
    parallel workers. This was unintended and creates a dependence on number
    of ranks used. This PR fixes that issue.
    - sample with replacement dataset size is now used as the global dataset
    size across ranks.
    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
    [getters.py]
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2025-07-07 Use GriddedOperations for zonal mean (#2008)
    This PR adds a `zonal_mean` property to GriddedOperations containing an
    optional helper function to compute the zonal mean. This is not
    implemented for HEALPix but definitely could be. It also avoids
    hard-coding the longitude dimension in the aggregator code.
    - Added `zonal_mean: Callable[[torch.Tensor], torch.Tensor] | None` to
    GriddedOperations
    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
    [gridded_ops.py]
2025-07-07 Allow `ocean_sea_ice_fraction` when coupling ocean to atmosphere (#1964)
    Allow distinct names for sea ice fraction in the atmosphere and ocean by
    adding the optional `sea_ice_fraction_name_in_atmosphere` attribute to
    `CoupledOceanFractionConfig`.
    - The `sea_ice_fraction` property on `OceanData` can now be derived from
    the `ocean_sea_ice_property` if the data is missing `sea_ice_fraction`.
    This logic used to be in the `sea_ice_fraction` derived variable.
    - Adds an `ocean_fraction` property to `OceanData` which is derived from
    the `land_fraction` and `sea_ice_fraction` properties.
    - Adds the `build_ocean_data` method to `CoupledOceanFractionConfig`
    which returns an instance of `Ocean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
    [ocean_data.py, ocean_derived_variables.py, stepper.py]
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2025-07-08 Fix missing `sea_ice_fraction` derived output in coupled mode (#2018)
    When predicting `ocean_sea_ice_fraction`, we want to also report/output
    derived `sea_ice_fraction`. It was missing because coupled ocean data
    does not have land fraction, this PR addresses the issue.
    Resolves #1974
    [stepper.py, train.py]
2025-07-10 Fix type ignore for DataLoader using DataLoaderABC (#2016)
    This PR adds strong typing for our two DataLoader implementations. This
    will make it easier to add new methods for our data loaders, such as
    being able to subset them (needed for during-epoch checkpointing).
    - Added DataLoaderABC with Torch implementation and also inherited by
    SlidingWindowDataLoader.
    - `get_data_loader` now returns the abstract DataLoaderABC
    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
    [dataloader.py, getters.py, gridded_data.py]
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2025-07-18 Add `CoupledParameterInitConfig` (#2014)
    Adds `parameter_init: CoupledParameterInitConfig` to
    `CoupledStepperConfig` which allows fine-tuning of a pretrained
    `CoupledStepper` checkpoint.
    - Adds a `load_weights_and_history` argument to
    `StepperConfig.get_stepper` and renames. This allows use of custom
    weights and history loader functions that can handle non-`Stepper`
    checkpoints such as those from `CoupledStepper`.
    - `ParameterInitializer` no longer depends on the value of
    `ParameterInitializationConfig.weights_path` being non-null to determine
    whether or not weights were loaded, but rather checks for non-null
    `self._base_weights` after calling its `self.load_weights_and_history`
    fu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
    [evaluator.py, parameter_init.py, single_module.py, stepper.py]
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2025-07-22 Disable checkpointing before training has started (#2037)
    This PR prevents checkpoints from being saved before the model weights
    and training/inference loss have been properly initialized.
    - Prevent interrupted training from saving a checkpoint if no batches
    have been trained.
    Attempts to resolve #2036
    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
    [trainer.py]
2025-07-24 Run inference timers in context (#2039)
    This PR updates `run_inference_from_config` to use `timer.context`
    instead of `timer.start` and `timer.stop`, ensuring timers get stopped
    if an exception occurs. This is helpful during notebook use.
    - Fixed an issue where `run_inference_from_config` may leave the
    GlobalTimer running if an exception occurs.
    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
    [inference.py]
2025-07-25 Fix missing f-string prefixes in `trainer.py` (#2044)
    This PR fixes missing f-string prefixes in `trainer.py` that manifest in
    logs that look like this (e.g., from [this
    job](https://beaker.allen.ai/orgs/ai2/workspaces/climate-titan/work/01K0ZJ2Y2ZR81CG01C14K66RCS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)):
    2025-07-25T12:31:47.030Z 2025-07-25 12:31:47,027 - root - INFO - Starting validation step for model trained for {self._epochs_trained} epochs
    2025-07-25T12:31:47.289Z 2025-07-25 12:31:47,287 - root - INFO - Starting loop over validation data
    2025-07-25T12:33:20.885Z 2025-07-25 12:33:20,883 - root - INFO - Starting flush of reduced diagnostics to disk
    2025-07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
    [trainer.py]
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2025-07-30 Avoid stopiteration exception on iter call (#2054)
    There is a bug where if our model gets restarted at the end of an epoch,
    during validation or inference, the data loader will have no batches
    when restarted. This would normally be OK, but our
    SlidingWindowDataLoader tries to get the next batch during an `__iter__`
    call, where StopIteration is a normal exception (it only gets treated as
    the end of an iteration during `__next__`. This PR resolves that issue
    by returning an empty tensor iterator instead.
    - Fixed an exception which occurs if the model is restarted at the end
    of an epoch, during validation or inference, if buffer timesteps are
    used.
    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
    [dataloader.py]
2025-07-30 Add log of best val and inference loss log during checkpointing (#2056)
    Adds information about the best validation loss and inference error to
    the log when saving a checkpoint.
    [trainer.py]
2025-07-30 Save checkpoint only from root (#2058)
    This PR fixes an issue where non-root ranks would save the checkpoint at
    the end of training, before validation.
    - Fixed an issue where non-root ranks would save the checkpoint at the
    end of training, before validation.
    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
    [trainer.py]
2025-07-31 Avoid extra restart checkpoint saves (#2057)
    - Updated the trainer so it only saves a restart checkpoint at the end
    of an epoch if one has not already been saved with the same batches
    seen.
    - Only save restart checkpoint before validation from root rank
    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
    [trainer.py]
2025-08-01 Add `wandb_dir_in_experiment_dir` option to `LoggingConfig` (#2063)
    This PR allows toggling whether the `wandb` directory will be stored in
    the `experiment_dir` or in `/tmp`. By default it retains the behavior of
    #1440, where it is stored in `/tmp`. Storing it in the `experiment_dir`
    is useful when running bare-metal, since it ensures that the directory
    is unique and can be accessed from nodes that have internet
    connectivity.
    Resolves #2062
    [logging_utils.py]
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2025-08-15 Deprecate FusedAdam optimizer, enable AdamW option (#2091)
    We've discovered that FusedAdam uses AdamW, which has a different
    treatment of weight decay. This PR deprecates the FusedAdam option in
    favor of one which more clearly uses AdamW.
    - Deprecated FusedAdam optimizer type.
    - Added AdamW optimizer, which is identical to the previous FusedAdam if
    `fused: true` is given in the kwargs section.
    - Updated configurations using FusedAdam to use AdamW with `fused: true`
    instead.
    Resolves #2089
    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
    [ace-train-config.yaml, optimization.py, train-baseline.yaml, train-config.yaml]
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2025-08-19 Remove usage of legacy config except to load legacy data (#2094)
    This PR removes methods on SingleModuleStepperConfig which aren't needed
    to load it or convert it to StepperConfig, and updates our code to use
    StepperConfig throughout (including in many tests).
    - SingleModuleStepperConfig is no longer in `fme.ace` namespace
    - Removed SingleModuleStepperConfig from supported types in coupled
    components
    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
    [single_module.py, stepper.py, train_config.py, validate_config.py]
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2025-08-27 Prescribe prognostic SST onto prognostic TS for initial coupled atmosphere step (#2099)
    Before this PR, the step of the atmosphere used the target TS snapshot
    as prognostic input, which lead to inconsistent behavior between the
    first coupled step and subsequent ones. This PR fixes this inconsistency
    by prescribing the SST prognostic state onto the corresponding surface
    temperature state before (re)initializing atmosphere forward stepping.
    - Add new abstract method `prescribe_sst` to `StepABC`.
    - Add new method `prescribe_sst` to `Stepper`.
    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
    [multi_call.py, single_module.py, stepper.py]
2025-08-27 Add SHT and necessary reordering to HEALPixCoordinates. (#2104)
    - Power spectrum aggregator is now operational for HEALPix data
    - Added optional `ax` argument to `plot_imshow`
    - HEALPixCoordinates will now ensure its values are valid when
    initialized, and usages in tests have been updated to be valid
    - HEALPixOperations now takes `nside` as initialization argument
    - Added cuhpx pytorch-only code for SHT and iSHT
    - Removed `grid` argument to `get_real_sht`
    - Added `get_real_isht` to GriddedOperations
    - Implemented SHT methods for HEALPixOperations
    - Added `fme.core.hpx.reorder.get_re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
    [coordinates.py, gridded_ops.py, tensors.py]
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2025-09-09 Remove `ExistingStepperConfig` (#2125)
    `ExistingStepperConfig` was intended to start a new training job with an
    existing stepper on disk (e.g. fine-tuning), but we typically use the
    parameter initializer for fine-tuning instead. Also the recently added
    `resume_results.existing_dir` option provides the same functionality but
    with more flexibility, i.e., resuming the wandb job and working with
    coupled fine-tuning.
    - `ExistingStepperConfig` no longer a valid option under
    `TrainingConfig.stepper` (only `StepperConfig` now).
    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
    [single_module.py, train_config.py]
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2025-09-12 Init distributed with shared file for srun (#2102)
    The strategy we've been using for multinode training on [Perlmutter or
    Ursa](https://github.com/ai2cm/vcm-workflow-control/blob/2f0de35bb73d22294a6da928a56fd6869490cd31/examples/ace/ursa-conda/sbatch-scripts/requeueable-train.sh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)
    does not work on Frontier. They also discourage the use of
    [torchrun](https://docs.olcf.ornl.gov/software/analytics/pytorch_frontier.html#torchrun)
    and strongly suggest using `srun` for task mapping. This PR adds an
    additional option for initializing the distributed object with a shared
    file instead of through environment variables. An example workflow for
    training on Frontier is
    [here](https://github.com/ai2cm/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
    [device.py]
2025-09-15 Revert "Move definition of VariableMetadata to fme.core.typing (#2150)" (#2152)
    This reverts commit 5de69e370d4439a32628b9780126ac0da994f54f, which
    caused issues for loading old checkpoints.
    Resolves #2151
    [aggregator.py, data_writer.py, dataset_info.py, default_metadata.py, derived_variables.py]
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2025-09-20 Fix `ace-climSST` checkpoint backwards compatibility (#2165)
    Added a script that makes it easy to test compatibility with published
    `ace-climSST` checkpoint. Just need internet connection—no manual data
    munging required.
    Also fixed a couple minor issues in the generation of new stepper state
    from old checkpoint state.
    This will resolve https://github.com/ai2cm/ace/issues/39
    [single_module.py]
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2025-09-26 Handle NaNs when computing zonal means (#2178)
    Use `nanmean` when computing zonal means in `LatLonOperations`.
    Resolves #2177
    [gridded_ops.py]
2025-09-30 Add a `finalize` method to data writers to close files (#2190)
    This PR adds a `finalize` method to each of the data writers to ensure
    written files are appropriately flushed and closed at the end of
    inference and evaluation. In some circumstances we need to make sure we
    call this within tests of the writers to ensure we can open their
    resulting files with xarray later.
    - Adds a `finalize` method to the data writers, which flushes the
    dataset buffer and then closes the dataset.
    - Removes upper bound on xarray version temporarily introduced in #2191.
    Resolves #2188.
    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
    [data_writer.py, evaluator.py, inference.py, writer.py]
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2025-10-01 Only `_save_restart_checkpoints` on root rank when preempted (#2193)
    Fixes a bug calling `_save_restart_checkpoints` on all ranks on
    preemption. Now we first check that `dist.is_root()`.
    - Adds a call to `dist.barrier()` so that all ranks print to the logs to
    confirm there was sufficient time to synchronize.
    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
    [trainer.py]
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2025-10-06 Fix bug in passing `channel_mean_names` to `TimeMeanEvaluatorAggregator` (#2203)
    Fixes a minor bug where `InferenceEvaluatorAggregator`'s
    `channel_mean_names` init argument wasn't passed on to
    `TimeMeanEvaluatorAggregator`.
    Note that there is effectively no change in the channel-mean computation as a result
    of this bugfix since the default behavior of
    `TimeMeanEvaluatorAggregator` with `channel_mean_names=None` is to
    compute the channel-mean RMSE of all the generated outputs.
    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
    [train_config.py]
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2025-10-07 Ensure ACE zarr writer can overwrite (#2215)
    Resolves bug in which the ACE zarr writer would not overwrite existing
    outputs.
    - fix bug in `ZarrWriterAdapter`
    - make `ZarrWriter.create_zarr_store` private, since it is no longer
    used in `ZarrWriterAdapter`
    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
    [writer.py]
2025-10-08 Fix inability to resume in certain cases (#2216)
    Currently jobs cannot be resumed if they are interrupted during
    validation or inference on the first epoch if they are configured to
    evaluate before training. This PR resolves that issue.
    Resolves #2206
    Resolves #2070
    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
    [trainer.py]
2025-10-08 Destroy distributed process group when training ends (#2208)
    Addresses a warning that can appear at the end of training: `WARNING:
    destroy_process_group() was not called before program exit, which can
    leak resources`.
    Resolves #2205
    [train.py, trainer.py]
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2025-10-09 Bugfix: Avoid copying `ResumeResultsConfig.existing_dir` on all ranks (#2225)
    Fixes a bug where all ranks were copying
    `ResumeResultsConfig.existing_dir` to `experiment_dir`, which could lead
    to a failure to resume the existing WandB job when
    `ResumeResultsConfig.resume_wandb=True`.
    - Adds `ResumeResultsConfig` methods `prepare_directory` and
    `verify_wandb_resumption`.
    Resolves #2219
    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
    [cli.py, train.py]
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2025-10-10 Coupled inference accepts empty ocean forcing (#2163)
    During coupled no target inference, we make it possible to not specify
    ocean forcing data since it's not strictly necessary in our baseline
    config (there're no ocean only forcing variable). The following steps
    are taken
    - [x] make mask provider from serialized stepper (split into a separate
    PR)
    - make dummy forcing dataset which returns a placeholder dummy data in
    the expected shape (not used) and the expected time stamps
    Resolves #2001 (partially)
    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
    [config.py, getters.py, gridded_data.py, inference.py, stepper.py]
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2025-10-15 Fix bugs in calculating coupled data requirements (#2242)
    Fixes two bugs in calculation of atmosphere data requirements in
    `CoupledStepperConfig`:
    1. Removes `ocean_fraction` from the atmosphere data requirements when
    `CoupledOceanFractionConfig` is non-null.
    2. Fixes a string `is` comparison bug that in some cases lead to
    `sea_ice_fraction` not being removed from atmosphere data requirements
    as expected when `CoupledOceanFractionConfig` is non-null.
    - Added `filter_atmosphere_forcing_names` method to
    `CoupledOceanFractionConfig`, and removed
    `CoupledStepperConfig._remove_sea_ice_fraction_when_ocean_fraction_is_predicted`.
    - Consolidated relevant tests in the coupled `test_stepper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
    [stepper.py]
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2025-10-21 Data writer time_selection fixes (#2241)
    Makes the data writer able to do time subsetting on `BatchData`
    (previously blocked by https://github.com/ai2cm/full-model/issues/2240).
    Multi-sample (multi-IC) inference time subsetting using explicit
    `TimeSlice` or `MonthSelector` is not easily possible given that these
    selections can result in varying data shapes across samples depdening on
    sample time, so this PR explicitly prevents those cases; multi-sample
    integer index selection is possible and this PR enables it.
    - `FileWriterConfig.time_selection` will raise `NotImplementedError` if
    `TimeSlice` or `MonthSelector` are configured with multi-sample
    Resolv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
    [batch_data.py]
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2025-10-27 Fix minor issue in `TimeLengthProbabilities` rng creation (#2267)
    Adds a test confirming that `set_seed` leads to identical training
    outcomes for two distinct `Trainer` objects with identical
    configurations. Also fixes a minor issue in `TimeLengthProbabilities`
    where rng was always created with the default distributed seed, which
    was discovered while developing the test.
    - `TimeLengthProbabilities` rng is initialized just-in-time in the
    `sample` method.
    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
    [time_length_probabilities.py]
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2025-10-30 Add BatchLabels type (#2266)
    This PR adds a type shortcut for batch labels, `BatchLabels =
    list[set[str]]`
    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
    [batch_data.py, labels.py, single_module.py]
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2025-10-31 Add `BatchData.pin_memory` method (#2275)
    Add `pin_memory` methods to `BatchData` and `CoupledBatchData`. Results
    in ~5 - 10% speedup in ACE training throughput, depending on
    architecture.
    Resolves https://github.com/ai2cm/full-model/issues/1943
    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
    [batch_data.py]
2025-11-03 Enable multiple instances of same value in TimestampList (#2284)
    Fixes a bug where a user could not provide multiple instances of the
    same value in `TimestampList.times`. Allowing this makes it easy to do
    ensemble simulations with a stochastic model by just providing a given
    timestamp N times.
    [inference.py]
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2025-11-04 Add public API .initialize() to ZarrWriter (#2291)
    The ZarrWriter previously required a call to `.record_batch()` in order
    to initialize the store, which was causing issues in a distributed use
    case where I did not want to call `.record_batch()` from each process at
    all times. This would result in a timeout during the initialize phase of
    a test because not calling the record also meant the worker would not
    call `dist.barrier()`. By adding a public `.initialize_store()` method, I can
    now initialize manually on all ranks and then call writes without
    worrying about the initialize synchronization check.
    - Adds `ZarrWriter.initialize_store()` to the public API
    - helper functions switche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
    [writer.py]
2025-11-05 Send full time buffer to device (#2293)
    Send full time buffer to GPU all at once, rather than separately sending
    each of the "small" batches in the buffer. Results in ~2-5% boost in
    training throughput with NoiseConditionedSFNO.
    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
    [dataloader.py]
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2025-11-06 More helpful empty `get_raw_paths` error messages (#2304)
    Checks that return from `get_raw_paths` is non-empty and raises an error
    with a more helpful message if so.
    Resolves #2297
    [config.py]
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2025-11-07 Rename 2d to noise in conditioning (#2292)
    The model conditioning currently uses a generic "2d" conditioning tensor
    for noise conditioning. If an additional type of 2d conditioning were
    added to this, it would only be possible to modify the size of the last
    type in the tensor, which is confusing API-wise. This PR renames "2d" to
    "noise" conditioning so that if any new conditioning types are added,
    they are to be put into their own names.
    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
    [stepper.py]
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2025-11-12 Fix Skill-Spread Ratio bug (#2315)
    The calculation of SSR was incorrect (unbiased MSE was not calculated
    correctly and MSE of individual ensemble members was used instead of ensemble
    mean). This PR fixes these issues and modifies SSR tests to make sure
    this works with arbitrary ensemble size.
    - Updated SSR calculation
    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
    [ensemble.py]
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2025-11-17 Remove hardcoded alpha in almost fair CRPS (#2323)
    Small PR to remove a hardcoded value of alpha=0.95 in the almost fair
    CRPS calculation. This also updates the associated test as alpha=0.1
    should fail and it previously was not due to this bug.
    - remove `alpha=0.95` in `fme/core/ensemble.py`
    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
    [ensemble.py]
2025-11-17 Fix bug when resuming epoch 0 with `evaluate_before_training=True` (#2328)
    When training was interrupted in the middle of the first epoch with
    `evaluate_before_training=True`, on resuming this bug resulted in
    `RuntimeError: Validation should only be called after a full epoch has
    been trained`.
    [trainer.py]
2025-11-18 Call dist.barrier() at the end of wandb.log (#2327)
    This PR adds a call to dist.barrier() at the end of wandb.log, which may
    help with root falling behind other ranks in case this is contributing
    to our NCCL timeout issues.
    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
    [wandb.py]
2025-11-18 Align coupled inference ic and forcing time stamp (#2296)
    We currently have a limitation in coupled inference where the first IC
    time stamp from file needs to match the first time stamp in forcing
    file. We also don't allow subsetting forcing data. This PR adds
    automatic alignment of atmosphere's forcing data to start at the first
    IC time.
    - add `update_subset` to `XarrayDataConfig` and
    `MergeNoConcatDatasetConfig`
    Resolves #2243
    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
    [inference.py]
2025-11-18 Datasets conform to DatasetABC (#2325)
    This PR adds a DatasetABC which our datasets conform to, so that it is
    easier to extend their interface.
    Note some methods are not implemented and raise exceptions, due to a
    long-standing issue where we use the same classes for training and
    inference datasets.
    This is necessary for adding a `set_epoch` method in a later PR.
    - Added DatasetABC
    - Implemented missing DatasetABC features on datasets
    - Replaced `total_timesteps` count on XarrayDataset with
    `validate_n_forward_steps` method on DatasetABC
    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
    [dataset.py, inference.py]
2025-11-20 Validate coupled inference length (#2333)
    Validate that the ocean and atmosphere datasets have enough timepoints
    to support the requested inference configuration.
    - `CoupledDataset` component datasets now typed as `DatasetABC` and
    added a `validate_inference_length` method.
    - Slightly more helpful / easier-to-test error message when inference
    configured with invalid timestamps.
    - `XarraySubset.validate_inference_length` no longer always raises a
    `ValueError`, so long as subsetting preserves the time orderedness of
    the data.
    Resolves #2331
    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
    [inference.py]
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2025-12-02 Condition stochastic SFNO on labels (#2338)
    This PR adds the ability to condition models on labels. This is
    implemented for the Conditional SFNO.
    - Updated BatchData.broadcast_ensemble to require the ensemble being
    broadcast has only 1 member
    - Added `n_labels` argument to the ModuleConfig ABC build method and all
    implementations
    - Added `labels` argument to StepABC.step
    - Added `Module` wrapper class which handles label encoding.
    - Updated BatchLabels from `list[set[str]]` to a custom type
    - None is now provided when labels are not being used, allowing
    disambiguation from the case that is using labels but has none.
    - LabelEncoder is replaced with LabelEncoding, and describes the w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
    [batch_data.py, config.py, dataset.py]
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2025-12-10 Fix how and when train aggregator is called (#2366)
    - Removed extra call to train aggregator during training
    - When calling train aggregator at the end of the epoch, use eval mode
    and validation context
    https://github.com/ai2cm/full-model/pull/2282#pullrequestreview-3553504034
    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
    [trainer.py]
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2025-12-12 Consistently use DatasetItem for typing (#2373)
    Currently we use a mixture of `DatasetItem` and `tuple[TensorMapping,
    xr.DataArray, set[str] | None]` to type what gets yielded by our Dataset
    objects. This PR updates the repo to consistently use DatasetItem,
    avoiding the need for many line changes when this type gets updated (as
    in #2369).
    [batch_data.py, getters.py]
2025-12-12 Allow forward steps to be scheduled by epoch (#2369)
    - StepperConfig.train_n_forward_steps now accepts a TimeLengthSchedule
    configuration, allowing the number of forward steps (including a
    probabilistic distribution) to be scheduled as a function of epoch
    - BatchData now has an `epoch` attribute (default None) used during
    training, required if a schedule is used
    - `XarrayDataset.set_epoch` now makes use of the epoch to modify the
    number of window forward steps when epoch is updated, and passes along
    the epoch when yielding data
    - DataRequirements may now specify the forward steps as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
    [batch_data.py, config.py, dataloader.py, dataset.py, getters.py]
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2025-12-16 Remove deprecated crps_training config value (#2378)
    This PR removes the deprecated crps_training configuration value, which
    is replaced with n_ensemble=2 and a the EnsembleLoss loss type.
    - Remove crps_training configuration value in stepper and
    SingleModuleStep
    Resolves #2270
    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
    [single_module.py]
2025-12-17 Sea ice corrector (#2367)
    This is a corrector for the `FloeNet` sea ice emulator architecture. The
    corrector ensures that the sea ice concentration, sea ice mass, and snow
    mass are equal to the sum of the predicted source, sink, and export
    budget terms for each variable (mass conserving). Closing this budget
    also ensures that sea ice concentration is bounded between [0,1] and
    that sea ice mass and snow mass are greater than or equal to 0. The
    budget also includes a masking strategy, which sets the derived sea ice
    concentration and snow mass to 0, wherever the derived sea ice mass is
    0.
    Because the sea ice training data do not have a vertical coordinate, the
    corrector is implemented into the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
    [coordinates.py]
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2026-01-13 Call optimizer autocast in stepper predict generator (#733)
    Our stepper currently has a bug where the optimizer autocast
    configuration is ignored. This only affects runs with automatic mixed
    precision enabled, which is disabled by default and we don't use in our
    runs presently.
    - Call optimizer autocast when training with ace Stepper
    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
    [single_module.py]
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2026-01-13 Coupled stepper config removes deprecated `crps_training` key (#734)
    In #2378, we remove deprecated `crps_training` config value, but that
    breaks coupled evaluation/inference because it has its own checkpoint
    loading. This PR fixes the bug using a type hook for `StepperConfig`.
    Resolves #732
    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
    [single_module.py, stepper.py]
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2026-01-16 Prevent backpropagation anomalies in energy corrector (#724)
    ### Issue
    Our current energy corrector code is vulnerable to introduce anomalies
    in backpropagation through computing the `log` of the pressure at model
    layer interfaces in the `compute_layer_thickness` function. Here by
    "anomalies" we mean places where undefined values (e.g. `-inf`, `inf`,
    `NaN`) come up within the chain of computation. We have observed these
    anomalies to arise in two circumstances:
    - Early in training with all datasets, the surface pressure at some grid
    cells can be less than zero. `log` of a value less than zero in PyTorch
    results in `NaN`. Previously to work around this we would skip computing
    and applying th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
    [atmosphere_data.py]
2026-01-16 Fix bug causing step sampler to be ignored (#742)
    A bug in our code was causing `train_n_forward_steps` on the
    StepperConfig to be ignored. This PR fixes that bug.
    - Fixed a bug causing StepperConfig.train_n_forward_steps to be ignored
    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
    [single_module.py]
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
